LSchoenbauer/unseen-obstacles/writing/sections/communication_vr_hardware.tex

Die Kopplung des physischen Hardware-Simulators mit der virtuellen Simulationsumgebung konstituiert einen zentralen Bestandteil des Projekts. Insbesondere im Kontext von Virtual-Reality-Anwendungen ermöglicht die Integration realer Eingabegeräte mit virtuellen Systemmodellen eine realitätsnahe Interaktion sowie die Untersuchung von Systemverhalten unter kontrollierten Bedingungen \cite{Jason2015}, \cite{Bowman2004}, \cite{Perez2025}.

Eine zentrale Herausforderung bei der Implementierung solcher hybrider Systeme besteht in der zuverlässigen und latenzarmen Kommunikation zwischen der Hardwarekomponente und der VR-Anwendung. Um eine konsistente Abbildung des physischen System innerhalb der virtuellen Umgebung zu gewährleisten, ist ein kontinuierlicher Austausch von Zustands- und Steuerdaten erforderlich. Dabei spielen Aspekte wie die Datenformatierung, die Synchronisation der Systemzustände sowie die Minimierung von Übertragungs- und Verarbeitungszeiten eine entscheidende Rolle für die Gesamtperformance des Systems \cite{Coppik}, \cite{Cleland2022}, \cite{Alam2025}.

In diesem Abschnitt wird die Implementierung Kommunikationsarchitektur zwischen dem Hardware-Simulator und der VR-Simulation beschrieben. Zunächst erfolgt eine Erläuterung der grundlegenden Systemstruktur sowie der Rolle der einzelnen Komponenten. Im Anschluss erfolgt die Darstellung des verwendeten Kommunikationsmechanismus sowie des zugrunde liegenden Datenprotokolls. Abschließend werden die Implementierungsdetails der Schnittstelle sowie Maßnahmen zur Gewährleistung einer stabilen und konsistenten Datenübertragung erörtert. 

\section{Systemarchitektur des Gesamtsystems}
\setauthor{Linnea Schönbauer}
Die Architektur des entwickelten Systems besteht aus mehreren Teilsystemen, die in Wechselwirkung miteinander stehen und somit die Synchronisation zwischen virtueller Simulation und physischer Plattform ermöglichen.

Die Architektur lässt sich in drei Hauptkomponenten unterteilen:
\begin{itemize}
        \item die virtuelle Simulation innerhalb der Unity-Engine
        \item die Netzwerkkommunikation zwischen Simulation und Hardware
        \item die Steuerungseinheit des Hardware-Simulators
\end{itemize}
Im Rahmen der Simulation erfolgt eine kontinuierliche Berechnung der Bewegungsparameter des virtuellen Rollstuhls. Die vorliegenden Parameter umfassen sowohl die räumliche Position als auch die Orientierung des Objekts innerhalb der virtuellen Umgebung.

Im Anschluss werden die gewonnenen Bewegungsdaten über eine Netzwerkverbindung an den Hardware-Simulator übertragen, wo sie von einem Mikrocontroller verarbeitet werden. Der Mikrocontroller übernimmt dabei die Aufgabe, die empfangenen Simulationsdaten in konkrete Steuerbefehle für die mechanischen Aktuatoren zu übersetzen. 

Die vorliegende Architektur ermöglicht die Realisierung einer direkten Kopplung zwischen virtueller Bewegung und physischer Plattform.

\section{Systemarchitektur des VR-Projekts}
\setauthor{Linnea Schönbauer}
Die virtuelle Simulation wurde unter Verwendung der Game Engine Unity realisiert. Unity ist eine weit verbreitete Entwicklungsumgebung zur Erstellung interaktiver 3D-Anwendungen und Virtual-Reality-Systeme \cite{Jangra2023}, \cite{Unity}. Die Engine stellt eine integrierte Entwicklungsumgebung bereit, welche Werkzeuge zur Szenengestaltung, Physiksimulation, Skriptprogrammierung sowie zur Verwaltung komplexer Objektstrukturen umfasst \cite{Unity}.

Ein zentrales Merkmal der Architektur von Unity ist die objektorientierte Organisation der virtuellen Welt. In der vorliegenden Arbeit wird dargelegt, dass sämtliche Elemente einer Simulation als Objekte innerhalb einer Szene modelliert werden. Zudem wird erörtert, dass die Steuerung dieser Objekte über ein komponentenbasiertes System erfolgt \cite{Unity}, \cite{Unity2}.

Unity organisiert alle Inhalte einer Simulation in sogenannten Szenen, die jeweils eine hierarchische Baumstruktur aus GameObjects bilden. Eine Szene konstituiert eine abgeschlossene virtuelle Umgebung, welche sämtliche geometrischen Objekte, Lichtquellen, Kameras sowie Interaktionskomponenten enthält \cite{Unity}, \cite{Unity3}, \cite{Unity4}, \cite{Unity5}.

Die Struktur innerhalt einer Szene folgt einer hierarchischen Organisation, in der einzelne GameObjects in Parent-Child-Beziehungen zueinander stehen können, siehe Abbildung \ref{fig:parent-child-unity}. Diese Struktur ermöglicht eine effiziente Verwaltung komplexer Objektsysteme, da Transformationen eines übergeordneten Objekts automatisch auf seine untergeordneten Elemente übertragen werden \cite{Unity}, \cite{Unity4}, \cite{Unity6}.

\begin{figure}[htbp]
    \centering
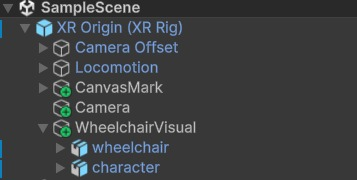
[picture p1: writing/pics/parent-child-object-unity.jpg]
    
    \caption{Parent-Child-Bezihung aus dem Unity Projekt}
    \label{fig:parent-child-unity}
\end{figure}

In dem Computerspiel-Entwicklungsprogramm Unity wird jedes Element der virtuellen Welt als sogenanntes GameObject bezeichnet. GameObjects dienen als Container für verschiedene Komponenten, welche das Verhalten und die Eigenschaften des jeweiligen Objekts definieren. Ein GameObject verfügt anfänglich über keine Funktionalität sondern diese wird erst durch die hinzugefügten Komponenten erworben \cite{Unity}, \cite{Unity7}.

Als illustrierende Beispiele für GameObjects innerhalt der Simulation seien etwa Gebäude der virtuellen Stadtumgebung, Straßenelemente, Kollisionsobjekte oder der virtuelle Rollstuhl genannt, der als zentrales Interaktionselement der Anwendung dient, siehe Kapitel \ref{chapter:vr-world}, \cite{Unity}.

\subsection{Physikalisches Bewegungsmodell}
\setauthor{Linnea Schönbauer}
Die Bewegung des virtuellen Rollstuhls innerhalb der Simulation basiert auf der Physik-Engine der Game Engine Unity. Anstatt die Positionsänderungen direkt zu manipulieren, wird ein physikalisches Bewegungsmodell verwendet, das auf der sogenannten Rigidbody-Komponente basiert \cite{Unity}, \cite{NVIDIA}, \cite{Bourg2013}, \cite{Unity8}

Diese Komponente gestattet die Simulation physikalischer Eigenschaften wie Masse, Gravitation sowie Kollisionen mit anderen Objekten der virtuellen Umgebung. Dies resultiert in einem realistischeren Bewegungsverhalten, insbesondere beim Befahren von Steigungen oder beim Kontakt mit Hindernissen innerhalb der simulierten Stadtumgebung \cite{Unity}, \cite{Unity9}, \cite{Unity8}.

Im Rahmen des vorliegenden Systems wird der virtuelle Rollstuhl daher als physikalisches Objekt modelliert, dessen Position und Orientierung über die Bewegungsfunktionen der Rigidbody-Komponente gesteuert werden, siehe Abbildung \ref{fig:rigidbody_unity}.
\begin{figure}[htbp]
    \centering
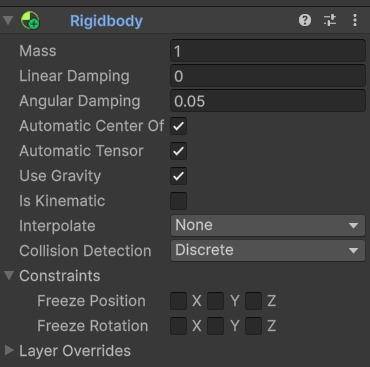
[picture p2: writing/pics/rigidbody.jpg]
    
    \caption{Rigidbody Komponente aus dem Unity Projekt}
    \label{fig:rigidbody_unity}
\end{figure}

\subsection{Positions- und Orientierungsparameter des virtuellen Rollstuhls}
\setauthor{Linnea Schönbauer}
Die Simulation des virtuellen Rollstuhls erfolgt unter Verwendung von Positions- und Orientierungsdaten zur adäquaten Beschreibung der Bewegung innerhalb der Simulation. Diese Werte beschreiben den aktuellen Zustand des Objekts im dreidimensionalen Raum und bilden gleichzeitig die Grundlage für die spätere Übertragung an den Hardware-Simulator.

\subsubsection{Positionskoordinaten}
\setauthor{Linnea Schönbauer}
Die Position eines Objekts in der Simulation wird durch ein kartesisches Koordinatensystem beschrieben. Die Position eines Objekts wird durch drei Koordinaten entlang der räumlichen Achse definiert \cite{Unity}, \cite{Foley1997}.

Die Koordinate PosX beschreibt die Position entlang der horizontalen X-Achse, während PosZ die Bewegung entlang der Tiefenachse der virtuellen Umgebung angibt. Die vertikale Position wird durch PosY beschrieben und repräsentiert die Höhe des Objekts innerhalb der Szene \cite{Unity}, \cite{Foley1997}, \cite{Vries}, \cite{Unity10}.

\subsubsection{Orientierung im Raum}\label{sec:orientation-in-3d}
\setauthor{Linnea Schönbauer}
Abgesehen von der Position ist auch die Orientierung des Rollstuhls im Raum von signifikanter Relevanz. Die vorliegende Beschreibung gibt Aufschluss über die Ausrichtung des Objekts relativ zu den drei Raumachsen \cite{Vries}, \cite{Craig2020}.

In einer Vielzahl von 3D-Systemen wird diese Orientierung durch sogenannte Euler-Angles repräsentiert, welche drei Rotationswinkel entlang der Raumachsen definieren \cite{Diebel2006}.

\begin{figure}[htbp]
    \centering
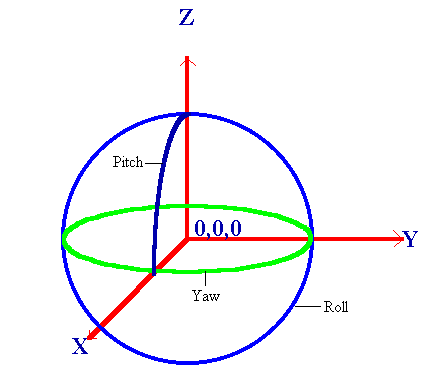
[picture p3: writing/pics/yz-and-pitch-roll-and-yaw-systems.png]
    
    \caption{Euler-Winkel-System, \\Quelle: https://www.researchgate.net/figure/yz-and-pitch-roll-and-yaw-systems\_fig4\_253569466 abgerufen 17.03.2026}
    \label{fig:yz-and-pitch-roll-and-yaw-systems}
\end{figure}

\subsubsection{Pitch, Yaw und Roll}
\setauthor{Linnea Schönbauer}
Die Orientierung wird durch drei Rotationswinkel beschrieben, die jeweils eine Drehung um eine der Raumachsen repräsentieren \cite{Diebel2006}.

Pitch beschreibt die Rotation um die seitliche Achse des Objekts und entspricht einer Vorwärts- oder Rückwärtsneigung. Das Befahren einer steilen Rampe führt beispielsweise zu einer signifikanten Änderung des Pitches \cite{Diebel2006}, \cite{Huck}.

Yaw beschreibt die Rotation um die vertikale Achse und determiniert damit die Blickrichtung des Rollstuhls innerhalb der Umgebung \cite{Diebel2006}, \cite{Huck}.

Roll beschreibt die seitliche Neigung des Objekts um die Vorwärtsachse. Ein Beispiel für eine derartige Situation wäre das Befahren eines hohen Bordsteins, wobei sich das Fahrzeug mit einem Reifen auf dem Gehweg und mit dem anderen auf der Straße befindet \cite{Diebel2006}, \cite{Huck}.

\subsubsection{Freiheitsgrade des Systems}
\setauthor{Linnea Schönbauer}
Die Bewegung des Rollstuhls lässt sich somit durch sechs Freiheitsgrade beschreiben. Drei dieser Freiheitsgrade betreffen die Position des Objekts im Raum (Translation entlang der X-, Y- und Z-Achse), während die übrigen drei Freiheitsgrade die Orientierung des Objekts beschreiben (Rotation um die drei Raumachsen).

\subsection{Verarbeitung der Usereingaben}
\setauthor{Linnea Schönbauer}
Die Steuerung des virtuellen Rollstuhls erfolgt durch Eingaben des Benutzers bzw. der Benutzerin, welche durch das Input-System von Unity erfasst werden. Diese Eingaben werden als zweidimensionaler Eingabevektor interpretiert, der sowohl Vorwärtsbewegung als auch Rotationsbewegung repräsentiert \cite{Unity11}.

Der vertikale Anteil des Eingabevektors determiniert die Vorwärts, beziehungsweise Rückwärtsbewegung des Rollstuhls innerhalb der Szene, während der horizontale Anteil zur Steuerung der Drehbewegung um die vertikale Achse verwendet wird \cite{Bowman2004}, \cite{Diebel2006}.

Die vorliegende Aufteilung ermöglicht die unabhängige Kontrolle von Translation und Rotation, wodurch eine intuitive Navigation innerhalb der virtuellen Umgebung ermöglicht wird \cite{Bowman2004}.

\subsection{Berechnung der Translation und Rotation}
\setauthor{Linnea Schönbauer}
Die Bewegung des Rollstuhls lässt sich also in zwei grundlegende Bewegungsarten unterteilen: Die translatorische Bewegung entlang der Blickrichtung sowie die Rotationsbewegung um die vertikale Achse.

Die Berechnung der Vorwärtsbewegung erfolgt entlang der lokalen Vorwärtsrichtung des Rollstuhls. Diese Richtung entspricht der aktuellen Orientierung des Rollstuhls innerhalb der Szene und wird über die Transformationsdaten des Objekts bestimmt. Die tatsächliche Verschiebung pro Simulationsschritt ergibt sich demnach aus der definierten Bewegungsgeschwindigkeit sowie der Zeitdauer des jeweiligen Physik-Updates.

Darüber hinaus besteht die Möglichkeit, den Rollstuhl um die vertikale Achse zu rotieren, wodurch Richtungsänderungen innerhalb der virtuellen Umgebung ermöglicht werden. Die Rotationsgeschwindigkeit wird über einen separaten Parameter gesteuert und ebenfalls innerhalb des Physik-Update-Zyklus der Simulation berechnet.

\section{Systemarchitektur des Hardware-Simulators}
\setauthor{Linnea Schönbauer}
Neben der mechanischen Konstruktion der Plattform, die in Kapitel \ref{chapter:hardware-prototyp} beschrieben wurde, ist für den Betrieb des Systems eine elektronische Steuerung erforderlich, welche die Bewegungen der Plattform koordiniert und ansteuert. Diese Steuerung bildet die zentrale Schnittstelle zwischen der virtuellen Simulation und den mechanischen Aktuatoren des Hardware-Simulators \cite{Bishop2006}.

Die Steuerungsarchitektur basiert auf einem Mikrocontroller des Typ ESP32, der als zentrale Recheneinheit innerhalb des Systems fungiert. Der Mikrocontroller übernimmt mehrere Aufgaben: Einerseits empfängt er Bewegungsdaten aus der Simulation über eine Netzwerkverbindung, andererseits berechnet er daraus die notwendigen Steuerbefehle für die einzelnen Schrittmotoren der Plattform \cite{ESPIDF}, \cite{Embedded}

Die eigentliche mechanische Bewegung wird durch mehrere Schrittmotoren erzeugt, welche die Wagenheber sowie die Rotationsbewegung der Plattform antreiben. Schrittmotoren eignen sich für diese Anwendung besonders gut, da sie eine präzise, schrittweise Bewegung ermöglichen und somit eine exakte Positionierung der Plattform erlauben. Die Steuerung dieser Motoren erfolgt über spezielle Motortreiber, welche die Signale des Mikrocontrollers in die erforderlichen elektrischen Impulse für die Motoren umsetzt \cite{Baral2026}.

\subsection{Verarbeitung der Simulationsdaten}
\setauthor{Linnea Schönbauer}
Die Steuerung der Plattform basiert auf Bewegungsdaten, die aus der virtuellen Simulation generiert werden. Diese Daten beschreiben die aktuelle Position und Orientierung des virtuellen Rollstuhls in der simulierten Umgebung. Insbesondere werden Rotationsparameter verwendet, die die Neigung und Ausrichtung des Rollstuhls im Raum beschreiben. Die Orientierung wird dabei über drei Rotationswinkel, sogenannte Pitch-, Roll- und Yaw-Winkel, dargestellt. Diese Parameter beschreiben die Rotation des Objekts um die drei Raumachsen und bilden somit eine vollständige Beschreibung der räumlichen Orientierung, siehe Abschnitt \ref{sec:orientation-in-3d}.
Während der Simulation werden diese Werte kontinuierlich aktualisiert und and die Steuerung des Hardware-Simulators übertragen.

\subsection{Umrechnung von Simulationsdaten in Motorbewegungen}
\setauthor{Linnea Schönbauer}
Die in der virtuellen Simulation berechneten Bewegungsdaten müssen in konkrete Bewegungsbefehle für die physische Plattform übersetzt werden. Das Ziel dieses Prozesses besteht darin, die Bewegungen des virtuellen Rollstuhls möglichst realitätsnah auf die mechanische Struktur des Hardware-Simulators zu übertragen. Hierzu werden die in der Simulation ermittelten Lage- und Positionsänderungen in entsprechende Bewegungen der einzelnen Aktoren des Systems umgerechnet \cite{Astrom2021}.

Die Simulation stellt dabei in regelmäßigen Zeitabständen die aktuellen Zustandsgrößen des virtuellen Systems bereit. Zu diesen gehören insbesondere die Rotationswinkel um die drei Raumachsen (Yaw, Pitch und Roll) sowie die Position im dreidimensionalen Raum. Für die Steuerung der Plattform werden jedoch nicht die absoluten Werte dieser Größen verwendet, sondern deren zeitliche Änderungen zwischen zwei aufeinanderfolgenden Simulationsschritten \cite{Astrom2021}.

Die Berechnung der Bewegungsbefehle erfolgt daher auf Basis der Differenzen zwischen den aktuellen und den zuvor empfangenen Simulationsdaten \cite{Astrom2021}.

\subsubsection{Differenzberechnung - Delta Werte}
\setauthor{Linnea Schönbauer}
Zur Bestimmung der erforderlichen Plattformbewegung werden zunächst die Differenzen der Orientierungswinkel zwischen zwei aufeinanderfolgenden Simulationszuständen berechnet. Diese Differenzen repräsentieren die tatsächlich während eines Simulationsintervalls erfolgte Bewegung des virtuellen Rollstuhls \cite{Astrom2021}.
\begin{lstlisting}[language=C++, caption={Differenzberechnung der Orientierungswinkel}, label={lst:delta_values}]
        int32_t deltaYaw = simData.mYaw - mLastSimData.mYaw;
        int32_t deltaPitch = simData.mPitch - mLastSimData.mPitch;
        int32_t deltaRoll = simData.mRoll - mLastSimData.mRoll;

\end{lstlisting}
Diese Differenzwerte bilden die Grundlage für die nachfolgende Berechnung der erforderlichen Hub- und Senkgröße.

\subsubsection{Berechnung der Rotationsbewegung (Yaw)}
\setauthor{Linnea Schönbauer}
Die Rotationsbewegung des Rollstuhls wird durch einen separaten Schrittmotor realisiert, der die obere Plattform relativ zur festen Basis verdreht. Das Ziel dieser Übertragung besteht darin, die in der Simulation ermittelte Drehbewegung mit möglichst hoher Präzision auf die physische Plattform zu übertragen.

Die Simulation übermittelt die Orientierung des virtuellen Objekts in Form von Euler-Winkeln, siehe Abschnitt \ref{sec:orientation-in-3d}. Für die Rotationsbewegung ist dabei insbesondere der Yaw-Winkel von Relevanz, welcher die Drehung um die vertikale Achse beschreibt. Anstatt absolute Winkelwerte direkt zu verwenden, basiert die Steuerung auf der Berechnung von Differenzwerten zwischen zwei aufeinanderfolgenden Simulationszuständen.

Die Berechnung erfolgt anhand des folgenden Ausdrucks:
\begin{lstlisting}[language=C++, caption={Differenzberechnung der Rotation}, label={lst:yaw_calculation}]
        deltaYaw = simData.mYaw - mLastSimData.mYaw
\end{lstlisting}
Die vorliegende Differenzbildung dient der Ermittlung der Anzahl der Winkelgrade, um die sich die virtuelle Plattform seit der letzten Aktualisierung gedreht hat. Dieses Verfahren gestattet eine kontinuierliche Bewegungssteuerung, bei der lediglich tatsächliche Änderungen in der Simulation zu Motorbewegungen führen \cite{Astrom2021}.

Zusätzlich wird die Zeit Differenz zwischen zwei Simulationsupdates bestimmt:
\begin{lstlisting}[language=C++, caption={Differenzberechnung der Zeit zwischen Simulationsupdates}, label={lst:time_difference_calculation}]
        deltaTimestamp = simData.mTimestampMs - mLastSimData.mTimestampMs
\end{lstlisting}
Die Erfassung dieser Zeit Information ist essenziell, um die erforderliche Geschwindigkeit der Motorbewegung zu bestimmen um somit eine zeitliche konsistente Abbildung der Simulation auf die reale Hardware zu gewährleisten \cite{Astrom2021}, \cite{Harashima1996}.

\subsubsection{Umrechnung des Rotationswinkels in eine lineare Bewegung}
\setauthor{Linnea Schönbauer}
Da die Drehbewegung der Plattform nicht direkt durch den Motor erzeugt wird, sondern über ein Antriebsrad, muss der Winkelunterschied zunächst in eine lineare Wegstrecke umgerechnet werden. Die vorliegende Strecke beschreibt die Bewegung, welche das Antriebsrad entlang des Umfangs der Plattform durchläuft, um die angestrebte Rotation zu generieren. Siehe Skizze \ref{fig:rotation-sketch}

Die Berechnung basiert auf der geometrischen Beziehung zwischen Kreisumfang und Winkelanteil. Der zurückgelegte Weg entlang eines Kreisbogens kann gemäß der folgenden Gleichung beschrieben werden: \cite{Bohme1967}
\begin{align}
        s = r \cdot \theta
\end{align}

Dabei beschreibt
\begin{itemize}
        \item $s$ die Bogenlänge
        \item $r$ den Radius
        \item $\theta$ den Winkel im Bogenmaß
\end{itemize}

\begin{figure}[htbp]
    \centering
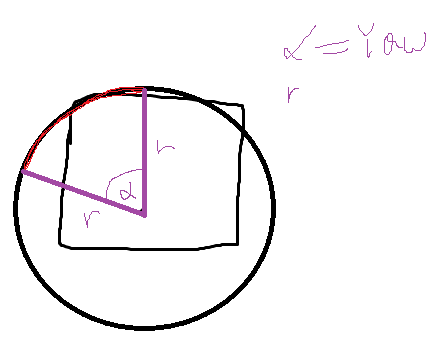
[picture p4: writing/pics/rotation-sketch.png]
    
    \caption{Rotation Berechnung - Sketch 09.01.2026}
    \label{fig:rotation-sketch}
\end{figure}

In dem vorliegenden System wird dies Beziehung genutzt, um aus dem Rotationswinkel die lineare Bewegung des Antriebsrads zu bestimmen. Die Implementierung erfolgt im Code über folgende Berechnung:
\begin{lstlisting}[language=C++, caption={Umrechnung des Rotationswinkels in eine lineare Bewegung}, label={lst:linear_rotation_calculation}]
        rotationLength = abs(pi * CIRCUMFERENCE_ROTATOR_WHEEL
                                 * deltaYaw / (180 * 100))
\end{lstlisting}
Der Faktor 100 ist das Resultat einer Skalierung der Winkelwerte im übertragenen Datenpaket, die zur Erhöhung der Genauigkeit durchgeführt wurde. Dadurch ist es möglich, selbst geringfügige Winkeländerungen als Ganzzahlen zu übertragen \cite{Goldberg1991}.

\subsubsection{Umrechnung der Wegstrecke in Motorumdrehungen}
\setauthor{Linnea Schönbauer}
Nach der Bestimmung der erforderlichen Wegstrecke erfolgt die Umrechnung in Motorumdrehungen. Der Motor treibt ein Rad mit bekanntem Umfang an, wodurch sich die Anzahl der notwendigen Umdrehungen berechnen lässt \cite{Siciliano1959}.

Die Beziehung zwischen Wegstrecke und Umdrehung lässt sich wie folgt formulieren: \cite{Bohme1967}
\begin{align}
        Umdrehungen = \frac{Weg}{Radumfang}
\end{align}

Im Code wird diese Berechnung wie folgt umgesetzt:
\begin{lstlisting}[language=C++, caption={Umrechnung der Wegstrecke in Motorumdrehungen (Rotationsbewegung)}, label={lst:motorsteps_rotation_calculation}]
        stepperTurns = rotationLength / CIRCUMFERENCE_ROTATOR_WHEEL
\end{lstlisting}
Das Ergebnis beschreibt die Anzahl der vollständigen Motorumdrehungen, die erforderlich sind, um die gewünschte Rotation des Gerüsts zu erzeugen.

\subsubsection{Berechnung der Motordrehzahl}\label{sec:calculate-mover-steps}
\setauthor{Linnea Schönbauer}
Die kontinuierliche Lieferung neuer Positionsdaten durch die Simulation bedingt die Durchführung der Bewegung innerhalb eines bestimmten Zeit Intervalls. Aus diesem Grund wird die erforderliche Drehzahl des Motors berechnet \cite{Siciliano1959}.

Die Drehzahl ist definiert als die Anzahl der Umdrehungen pro Zeiteinheit:
\begin{align}
        RPM = \frac{Umdrehungen}{Zeit}
\end{align}

Da der Zeitstempel in Millisekunden vorliegt, erfolgt die Umrechnung auf Minuten über den Faktor 60000:
\begin{lstlisting}[language=C++, caption={Umrechnung von Millisekunden auf Minuten}, label={lst:milliseconds_to_minutes_calculation}]
        rotationRpm = stepperTurns * 60000 / deltaTimestamp
\end{lstlisting}
Diese Berechnung ermöglicht eine dynamische Anpassung der Motorbewegung an die Geschwindigkeit der Simulation. Demzufolge resultieren schnelle Rotationen in höheren Drehzahlen des Motors, während langsame Bewegungen entsprechend langsamer ausgeführt werden \cite{Astrom2021}.

\subsubsection{Berechnung der Neigungsbewegung des vorderen Aktuators (Pitch)}
Neben der Rotationsbewegung ist die Neigung des Rollstuhls um die Querachse von zentraler Bedeutung für die Übertragung der Bewegung. In der Simulation wird diese Bewegung durch eine Änderung des Pitch-Winkel repräsentiert, was das Vor- bzw. Zurückkippen des virtuellen Rollstuhls beschreibt, siehe Abschnitt \ref{sec:orientation-in-3d}. Die Übertragung der Bewegung auf den physischen Hardware-Simulator erfolgt mittels eines Aktuators vorne, welcher eine Anpassung der Höhe der Plattform im Frontbereich ermöglicht.

Die Realisierung dieser Bewegung bedingt eine Konvertierung des übermittelten Rotationswinkels in eine lineare Hubbewegung des vorderen Wagenhebers. Aufgrund der Montage des Wagenhebers in einem festen Abstand zum Drehzentrum des Systems ergibt sich die notwendige Hubbewegung aus der geometrischen Beziehung zwischen Rotationswinkel und vertikaler Verschiebung eines Punktes auf einem Kreis. Siehe Skizze \ref{fig:front-mover-sketch} \cite{Bohme1967}
\begin{figure}[htbp]
    \centering
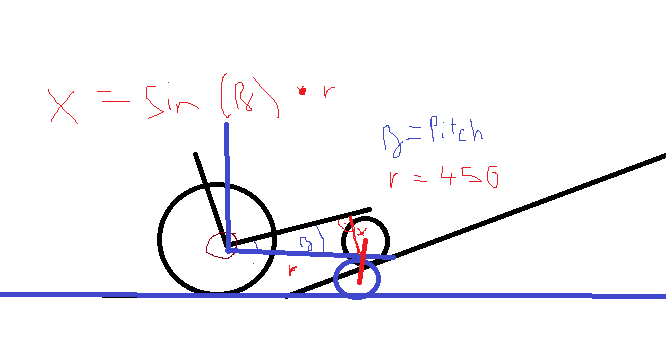
[picture p5: writing/pics/front-mover-sketch.png]
    
    \caption{Mover vorne Berechnung - Sketch 09.01.2026}
    \label{fig:front-mover-sketch}
\end{figure}

Die grundlegende Berechnung erfolgt im System über die Sinusfunktion \cite{Bohme1967}:
\begin{lstlisting}[language=C++, caption={Grundlegende Berechnung Neigung vorne}, label={lst:neigungswinkel_vorne_calculation}]
        stroke = sin(DegToRad(deltaPitch / 100.0)) * DISTANCE_FRONT
\end{lstlisting}

\emph{DISTANCE\_FRONT} beschreibt den horizontalen Abstand zwischen dem Drehzentrum der Plattform und der Position des vorderen Aktuators. Dieser Abstand entspricht dem Hebelarm, über den eine Rotationsbewegung in eine vertikale Verschiebung umgesetzt wird. Die Höhe des entsprechenden Punktes relativ zur Ausgangsposition wird durch Anwendung der Sinusfunktion bestimmt.

Die Sinusfunktion findet Anwendung in der geometrischen Betrachtung eines rechtwinkeligen Dreiecks, das durch die Plattformneigung entsteht. Es sei darauf hingewiesen, dass sich die vertikale Verschiebung eines Punktes im Abstand r zum Rotationszentrum bei einer Rotation um einen Winkel $\theta$ aus
\begin{align}
        h = r \cdot sin(\theta)
\end{align}
ergibt \cite{Bohme1967}.
Die vorliegende Beziehung gestattet die unmittelbare Transformation des übermittelten Rotationswinkels in eine physikalische Hubbewegung \cite{Bohme1967}.

Neben der reinen Rotationsbewegung wird in der Implementierung zusätzlich die translatorische Bewegung des Rollstuhls berücksichtigt. Diese ergibt sich aus der Bewegung des virtuellen Rollstuhls entlang der Fahrtrichtung und wird durch Positionsänderungen entlang der Z-Achse beschrieben.

Im vorliegenden Kontext wird zunächst die Geschwindigkeit der Bewegung ermittelt:
\begin{lstlisting}[language=C++, caption={Berechnung Geschwindigkeit}, label={lst:speed_calculation}]
        speedZ = simData.mPosZ - mLastSimData.mPosZ
\end{lstlisting}
Anschließend wird daraus die Beschleunigung bestimmt:
\begin{lstlisting}[language=C++, caption={Berechnung Beschleunigung}, label={lst:accelaration_calculation}]
        accZ = speedZ - mLastSpeedZ
\end{lstlisting}
Diese Beschleunigungskomponente wird als zusätzlicher Hubanteil interpretiert und zum berechneten Pitch-Hub addiert:
\begin{lstlisting}[language=C++, caption={Berechnung finale Neigung vorne}, label={lst:pitch_calculation_final}]
        stroke = (sin(DegToRad(deltaPitch / 100.0)) * DISTANCE_FRONT)
        + (deltaStroke / 100.0)
\end{lstlisting}
Die vorliegende Erweiterung der Plattform hat zur Folge, dass diese nicht nur auf Neigungsbewegungen, sondern auch auf dynamische Veränderungen der Bewegung reagiert. Als Beispiel für derartige Veränderungen können das Beschleunigen oder Abbremsen des virtuellen Rollstuhls angeführt werden. Dies resultiert in einer realistischeren Bewegungswahrnehmung für den/die Benutzer*in, da neben der geometrischen Ausrichtung auch dynamische Kräfte simuliert werden können \cite{Slater2016}, \cite{Steuer1992}.

\subsubsection{Umrechnung der Hubbewegung in Motorrotation}
\setauthor{Linnea Schönbauer}
Nach erfolgter Berechnung der erforderlichen Hubbewegung des Aktuators ist eine Transformation dieser in eine entsprechende Drehbewegung des Schrittmotors erforderlich. Die Funktionsweise der Wagenheber Mechanik beruht auf einer Gewindespindel, bei der eine Umdrehung des Motors eine definierte lineare Verschiebung erzeugt \cite{Siciliano1959}, \cite{Bauhaus}.

In dem vorliegenden System wird diese Verschiebung durch den Parameter \emph{STROKE\_PER\_TURN} beschrieben. Dieser gib an, wie viele Millimeter Hub pro Motorumdrehung erzeugt werden.

Die Anzahl der erforderlichen Motorumdrehungen ergibt sich demnach aus:
\begin{lstlisting}[language=C++, caption={Umrechnung der Hubbewegung in Motorumdrehungen}, label={lst:stepper_turns_calculation}]
        stepperTurns = stroke / STROKE_PER_TURN
\end{lstlisting}
Da ausschließlich die Bewegungsgröße von Relevanz ist, wird in diesem Kontext der Betrag der Verschiebung analysiert. Im Anschluss erfolgt die separate Bestimmung der Bewegungsrichtung. Außerdem wird noch die erforderliche Motordrehzahl bestimmt, siehe Abschnitt \ref{sec:calculate-mover-steps}.

\subsubsection{Berechnung der seitlichen Neigung über die hinteren Aktuatoren (Roll)}
\setauthor{Linnea Schönbauer}
Während der vordere Aktuator primär für die Simulation von Pitch-Bewegungen zuständig ist, wird die seitliche Neigung des Rollstuhls durch zwei hintere Aktuatoren realisiert. Die genannten Elemente sind neben den beiden großen Rädern des Rollstuhls unter der Querachse positioniert und können unabhängig voneinander bewegt werden. Siehe Skizze \ref{fig:back-mover-sketch}

Die seitliche Neigung der Plattform entspricht in der Simulation dem Roll-Winkel, der eine Rotation um die Längsachse des Rollstuhls beschreibt, siehe \ref{sec:orientation-in-3d}. Um diese Bewegung zu simulieren, ist eine entgegengesetzte Bewegung der beiden hinteren Aktuatoren erforderlich. In der Folge manifestiert sich die Kippbewegung der Plattform, die eine Elevation einer Seite und eine Absenkung der anderen zur Folge hat \cite{Siciliano1959}.

In Analogie zur Ermittlung der Pitch-Bewegung erfolgt zunächst die Berechnung der vertikalen Verschiebung, welche sich aus der geometrischen Relation zwischen Winkel und Hebelarm ergibt. Siehe Skizze \ref{fig:back-mover-sketch}
\begin{figure}[htbp]
    \centering
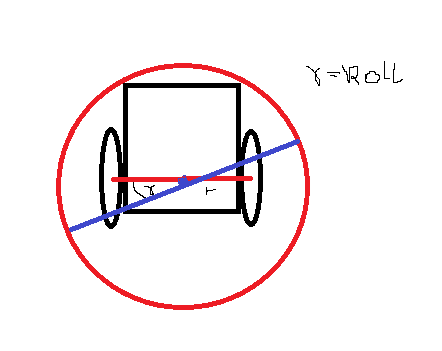
[picture p6: writing/pics/back-mover-sketch.png]
    
    \caption{Mover hinten Berechnung - Sketch 09.01.2026}
    \label{fig:back-mover-sketch}
\end{figure}

Die Berechnung erfolgt mittels der Sinusfunktion \cite{Bohme1967}:
\begin{lstlisting}[language=C++, caption={Berechnung der vertikalen Verschiebung}, label={lst:vertical_calculation}]
        stroke = sin(DegToRad(deltaRoll / 100.0)) * DISTANCE_SIDE_BACK
\end{lstlisting}
Der Parameter \emph{DISTANCE\_SIDE\_BACK} beschreibt den Abstand zwischen dem Drehzentrum der Plattform und der Position der hinteren Aktuatoren. Der vorliegende Abstand fungiert als Indikator für die Amplitude einer spezifischen Rotationsbewegung, die in eine vertikale Verschiebung der Plattform transformiert wird.

\subsubsection{Integration dynamischer Bewegungsanteile}
\setauthor{Linnea Schönbauer}
Des Weiteren findet bei der Rollbewegung auch der translatorische Bewegungsanteil Berücksichtigung. In Analogie zur Berechnung des Pitch-Wertes wird die beschleunigende Bewegung in Fahrtrichtung als zusätzlicher Hubanteil interpretiert \cite{Slater2016}, \cite{Steuer1992}

Die vollständige Berechnung der Hubbewegung ergibt sich demnach aus:
\begin{lstlisting}[language=C++, caption={Berechnung Hubbewegung hinten}, label={lst:full_calculation_side}]
        stroke = (sin(DegToRad(deltaRoll / 100.0)) * DISTANCE_SIDE_BACK)
                + (deltaStroke / 100.0)
\end{lstlisting}
Die vorliegende Erweiterung des Systems hat zur Folge, dass dieses nicht nur auf seitliche Neigung, sondern auch auf dynamische Veränderungen der Fahrzeugbewegung reagiert. Dadurch wird eine realitätsnahe Simulation des Überfahrens von Hindernissen des Rollstuhls ermöglicht \cite{Slater2016}.

\subsubsection{Gegensinnige Ansteuerung der hinteren Aktuatoren}
\setauthor{Linnea Schönbauer}
Ein wesentlicher Unterschied zur Pitch-Steuerung besteht darin, dass für die Rollbewegung zwei Aktuatoren gleichzeitig angesteuert werden. Im Zuge der Anhebung einer Seite ist eine Absenkung der gegenüberliegenden Seite erforderlich \cite{Siciliano1959}.

Die gegensinnige Bewegung wird im System durch unterschiedliche Richtungsbefehle für die beiden Motoren realisiert:
\begin{lstlisting}[language=C++, caption={Gegensinnige Ansteuerung hinten}, label={lst:gegenseitige_ansteuerung_hinten}]
        rearLeftMover->SetDirection(stroke < 0 ? BACKWARD : FORWARD);
        rearRightMover->SetDirection(stroke < 0 ? FORWARD : BACKWARD);
\end{lstlisting}
Die gegenläufige Ansteuerung resultiert in einer stabilen Kippbewegung der Plattform, ohne dass zusätzliche mechanische Komponenten erforderlich wären \cite{Siciliano1959}.

\subsubsection{Synchronisation der Motorbewegungen}
\setauthor{Linnea Schönbauer}
Da beide hinteren Aktuatoren an derselben Bewegung beteiligt sind, ist eine exakte Synchronisierung ihrer Geschwindigkeiten erforderlich. Aus diesem Grund wird für beide Motoren dieselbe Drehzahl (rotationRpm) berechnet und anschließend an beide Aktuatoren übertragen:
\begin{lstlisting}[language=C++, caption={Synchronisierte Motorbewegung hinten}, label={lst:synchronisation_motorbewegeung}]
        rearLeftMover->SetSpeedRpm(rotationRpm);
        rearRightMover->SetSpeedRpm(rotationRpm);
\end{lstlisting}

\subsection{Netzwerkarchitektur des Systems}
\setauthor{Linnea Schönbauer}
Für den Datenaustausch zwischen der virtuellen Simulation und dem Hardware-Simulator wird eine drahtlose Netzwerkverbindung verwendet. Die Netzwerkarchitektur basiert auf einem Mikrocontroller des Typs ESP32. Dieser fungiert sowohl als Steuerungseinheit der Plattform als auch als drahtloser Zugangspunkt \cite{EspressifArduino}, \cite{Wikipedia}.

Der Mikrocontroller stellt ein eigenes WLAN-Netzwerk bereit mit dem sich das System auf dem die VR-Simulation ausgeführt wird verbinden kann. Der Vorteil dieser Architektur ist, dass keine zusätzliche Netzwerkinfrastruktur erforderlich ist und die Kommunikation direkt zwischen Simulation und Hardware erfolgen kann \cite{EspressifArduino}, \cite{ESP32WifiAccessPoint}.

Der Mikrocontroller wird dabei im sogenannten Access-Point-Modus betrieben. In diesem Modus erzeugt das Gerät ein eigenständiges WLAN-Netzwerk mit einer definierten SSID und einem festgelegten Zugangspasswort. Die IP-Adresse des Zugangspunkts ist statisch konfiguriert, sodass der Kommunikationspartner innerhalb der Simulation stets eine bekannte Zieladresse verwenden kann \cite{EspressifArduino}, \cite{ESP32WifiAccessPoint}.

Im vorliegenden System wird die Adresse \emph{192.168.7.3} als feste IP-Adresse für den Mikrocontroller verwendet. Somit kann die VR-Simulation die Bewegungsdaten direkt an diese Adresse senden.

\subsection{Auswahl des Kommunikationsprotokolls} \label{sec:communication-protocol}
\setauthor{Linnea Schönbauer}
Für die Übertragung der Simulationsdaten zwischen der VR-Anwendung und dem Hardware-Simulator wurde das Netzwerkprotokoll User Datagram Protocol (UDP) ausgewählt. UDP ist ein verbindungsloses Transportprotokoll, das im Gegensatz zum Transmission Control Protocol (TCP) keine garantierte Zustellung der Datenpakete sicherstellt \cite{Postel1980}, \cite{Peterson2007}.

Die Wahl von UDP ist insbesondere bei Echtzeitanwendungen üblich, da das Protokoll eine sehr geringe Kommunikationslatenz aufweist. Während TCP zusätzliche Mechanismen zur Fehlerkorrektur, Paketbestätigung und Wiederholung verlorener Daten implementiert, verzichtet UDP auf diese Funktionen. Dadurch kann die Übertragung deutlich schneller erfolgen \cite{Postel1980}, \cite{Peterson2007}.

Für das vorliegende System ist diese Eigenschaft vorteilhaft, da die übertragenen Daten kontinuierlich aktualisiert werden. Sollte ein Datenpaket verloren gehen, kann es durch das unmittelbar folgende Paket ersetzt werden, ohne dass dies einen signifikanten Einfluss auf die Bewegungssteuerung hat.

Durch die Verwendung von UDP kann somit eine effiziente und latenzarme Kommunikation zwischen Simulation und Hardware realisiert werden \cite{Postel1980}, \cite{Peterson2007}.

\subsection{Implementierung des UDP-Senders in Unity}
\setauthor{Linnea Schönbauer}
Innerhalb der VR-Simulation realisiert eine speziell implementierte Unity-Komponente den Datentransfer. Diese ist als Skript implementiert und wird dem virtuellen Rollstuhlobjekt innerhalb der Simulation zugewiesen.

Die Implementierung basiert auf der .NET-Netzwerkbibliothek, die über die Klasse UdpClient eine einfache Möglichkeit zur Übertragung von UDP-Paketen bereitstellt \cite{Microsoft}.

Während der Initialisierung der Anwendung wird zunächst ein UDP-Client erstellt und mit der Zieladresse des Mikrocontrollers konfiguriert. IP-Adresse und Netzwerk Port können im Unity-Editor konfiguriert werden, wodurch eine flexible Anpassung an unterschiedliche Testumgebungen möglich ist.

Die eigentliche Datenübertragung erfolgt innerhalb der Update-Schleife der Unity-Engin. Dabei wird in regelmäßigen Zeitabständen die aktuelle Position und Orientierung des virtuellen Rollstuhls ausgelesen und anschließend als Netzwerkpaket an den Mikrocontroller übertragen.

Durch diese Implementierung wird sichergestellt, dass die Bewegungsdaten der Simulation kontinuierlich an den Hardware-Simulator weitergeleitet werden \cite{Microsoft}.

\subsection{Aufbau des Datenpakets}
\setauthor{Linnea Schönbauer}
Die Bewegungsdaten werden in Form eines binären Datenpakets übertragen. Dieses besteht aus mehreren Ganzzahlwerten mit einer Größe von jeweils 32 Bit \cite{Microsoft}.

\begin{center}
\begin{tabular}{ c c }
 \textbf{Feld} & \textbf{Beschreibung} \\ 
 timestamp & Zeitstempel \\  
 mode & Untergrundmodus (Gehsteig, Kopfsteinpflaster, Straße) \\
 pitch & Rotation um X-Achse \\
 yaw & Rotation um Y-Achse \\
 roll & Rotation um Z-Achse \\
 posX & Position entlang X \\
 posZ & Position entlang Z \\
 posY & Position entlang Y
\end{tabular}
\end{center}
Die Verwendung eines binären Datenformats ermöglicht eine Reduktion des Overheads gegenüber textbasierten Formaten wie JSON oder XML. Dadurch lassen sich kleinere Datenpakete und geringere Übertragungszeiten erreicht, was insbesondere für Echtzeitanwendungen vorteilhaft ist \cite{Microsoft}.

Die Rotationswerte werden zunächst aus der Quaternion-Rotation des Unity-Objekts berechnet und dann in Euler-Winkel umgewandelt. Diese werden dann mit einem Skalierungsfaktor multipliziert, um eine höhere numerische Auflösung zu erreichen. Mithilfe dieser Skalierung können Gleitkommazahlen effizient als Ganzzahlen übertragen werden, ohne dass zusätzliche Rechenoperationen auf dem Mikrocontroller erforderlich sind \cite{Unity12}, \cite{Goldberg1991}.

Die Position des Objekts wird auf ähnliche Weise codiert: Die Positionswerte werden mit dem gleichen Skalierungsfaktor multipliziert \cite{Unity12}, \cite{Goldberg1991}.

\subsection{Implementierung des UDP-Servers}
\setauthor{Linnea Schönbauer}
Die Simulationsdaten werden auf dem Mikrocontroller über einen speziell implementierten UDP-Server empfangen. Dieser wird als eigenständige Aufgabe innerhalb des Echtzeitbetriebssystems des Mikrocontroller ausgeführt.

Nach dem Start der Anwendung wird ein Server-Task erstellt. Dieser wartet dauerhaft auf eingehende Netzwerkpakete. Sobald ein neues Paket empfangen wird, wird dieses in einem internen Puffer gespeichert und anschließend an eine definierte Paketverarbeitungsfunktion übergeben:

\begin{lstlisting}[language=C++, caption={Empfang- und Übergabe-Methode des UDP-Servers}, label={lst:udp_serve_functionality}]
void UdpServer::Listen() {
    uint8_t buffer[mPacketBufferSize];

    if (StartListening(mPort)) {
        while (mServerTask != nullptr) {
            size_t dataSize = RetrieveNextPacket(buffer, mPacketBufferSize);
            if (dataSize > 0) {
                OnDataReceived(buffer, dataSize);
            } else {
                vTaskDelay(pdMS_TO_TICKS(5));
            }
        }
        vTaskDelay(pdMS_TO_TICKS(100));
        vTaskDelete(NULL);
    } else  {
        LogErrorT(LTAG_CFG, "UDP Server: Failed to start server on port %d", mPort);
    }
}

void UdpServer::OnDataReceived(const uint8_t* data, size_t dataLength) {
    if (mPacketHandler != nullptr) {
        mPacketHandler(data, dataLength);
    }
}
\end{lstlisting}

Die Implementierung basiert auf einer kontinuierlichen Empfangsschliefe, die wiederholt überprüft, ob neue Netzwerkpakete eingetroffen sind. Wenn das System ein gültiges Datenpaket erkennt, leitet es dessen Inhalt an einen registrierten Paket-Handler weiter.

Durch diese Architektur sind Netzwerkkommunikation und Bewegungssteuerung klar voneinander getrennt, da die empfangenen Daten zunächst isoliert verarbeitet werden können, bevor sie in Steuerbefehle für die Aktuatoren umgewandelt werden.

\subsection{Übertragungsfrequenz der Simulationsdaten} \label{sec:transfer-frequence}
\setauthor{Linnea Schönbauer}
Die Aktualisierung der Bewegungsdaten erfolgt mit einer festen Übertragungsfrequenz von etwa 60 Hz. Diese Frequenz entspricht der typischen Bildwiederholrate vieler VR-Anwendungen und gewährleistet eine ausreichende zeitliche Auflösung der Bewegungsinformationen \cite{LaValle2023}.

Die Datenübertragung wird durch einen Timer innerhalb der Unity-Anwendung gesteuert. In jedem Aktualisierungsintervall wird überprüft, ob die definierte Zeitspanne seit dem letzten Sendevorgang überschritten wurde. Ist dies der Fall, wird ein neues Datenpaket erzeugt und übertragen.

\section{Latenz und Echtzeitverhalten des Systems}
\setauthor{Linnea Schönbauer}
In interaktiven Simulationssystemen ist das zeitliche Verhalten der einzelnen Systemkomponenten von entscheidender Relevanz. Insbesondere im Kontext von Anwendungen im Bereich der virtuellen Realität ist eine möglichst synchrone visuelle Darstellung der Bewegung mit den physischen Bewegungen des Hardware-Simulators erforderlich \cite{Dorner2019}.

Im Falle einer zeitlichen Diskrepanz zwischen der Bewegung innerhalb der virtuellen Umgebung und der Bewegung des realen Hardware-Simulators kann es zu einer inkonsistenten Wahrnehmung kommen. In diesem Fall nimmt der Benutzer eine Bewegung visuell wahr, während die physische Bewegung des Systems zeitlich versetzt erfolgt \cite{Slater2016}, \cite{LaValle2023}.

Derlei Diskrepanzen können die Immersion der Simulation beeinträchtigen und zudem physiologische Effekte wie Desorientierung oder Motion Sickness verursachen, siehe Abschnitt \ref{sec:motionsickness}. Aus diesem Grund stellt die Minimierung der Systemlatenz ein zentrales Ziel bei der Entwicklung bewegungsbasierter VR-Simulationssysteme dar \cite{Slater2016}, \cite{LaValle2023}.

\subsection{Definition von Systemlatenz bezogen auf das Projekt}
\setauthor{Linnea Schönbauer}
Der Terminus \emph{Systemlatenz} bezeichnet die zeitliche Verzögerung zwischen dem Auftreten eines Ereignisses in der Simulation und der entsprechenden Reaktion der physischen Hardware \cite{LaValle2023}.

Im vorliegenden System beschreibt die Latenz demnach die Zeitspanne zwischen der Berechnung der Bewegung innerhalb der virtuellen Umgebung und der tatsächlichen mechanischen Bewegung der Plattform. 

Diese Zeitspanne manifestiert sich in Form mehrere Teilverzögerungen, die in diversen Systemkomponenten entstehen. Zu den relevanten Aspekten zählen insbesondere:
\begin{itemize}
        \item die Berechnungszeit innerhalb der Simulationssoftware (Unity)
        \item die Übertragungszeit der Netzwerkkommunikation
        \item die Verarbeitungszeit des Mikrocontrollers (ESP32)
        \item die mechanische Reaktionszeit der Aktuatoren
\end{itemize}

\subsection{Latenz in der Simulation}
Die initiale Verzögerung manifestiert sich bereits während des Berechnungsprozesses der Bewegungsparameter innerhalb der Simulationssoftware. Die vorliegende VR-Anwendung basiert auf der Game Engine Unity, welche eine framebasierte Aktualisierungsstruktur verwendet \cite{Unity13}.

Innerhalb dieses Systems werden sämtliche Bewegungen der virtuellen Objekte in diskreten Aktualisierungsschritten berechnet. Diese Schritte werden als Frames bezeichnet und bestimmen die Aktualisierungsfrequenz der Simulation \cite{Unity12}.

In der vorliegenden Implementierung erfolgt die Übertragung der Bewegungsdaten mit einer Frequenz von etwas 60 Hz. Dies entspricht einem Aktualisierungsintervall von etwa 16.7 Millisekunden.

Innerhalb der Simulationssoftware kann demnach eine Verzögerung von bis zu einem Frame auftreten, bevor neue Bewegungsdaten an den Hardware-Simulator übertragen werden.

\subsection{Netzwerkbedingte Latenz}
\setauthor{Linnea Schönbauer}
Nach der Berechnung der Bewegungsdaten innerhalb der Simulation erfolgt die Übertragung dieser Daten an den Hardware-Simulator über eine Netzwerkverbindung. Die für die Datenübertragung erforderliche Zeit wird als Netzwerk- oder Kommunikationslatenz bezeichnet \cite{Hou2024}.

Im vorliegenden System erfolgt die Datenübertragung über ein drahtloses Netzwerk, das vom Mikrocontroller selbst bereitgestellt wird. Die Kommunikation findet unter Einsatz des Netzwerkprotokoll User Datagram Protocol statt, siehe Abschnitt \ref{sec:communication-protocol}

Die geringe Komplexität des UDP-Protokolls bedingt eine deutlich geringere Verzögerung im Vergleich zu verbindungsorientierten Protokollen wie dem Transmission Control Protocol, siehe Abschnitt \ref{sec:communication-protocol}

Da UDP keine Paketbestätigung oder Wiederholungsmechanismen implementiert, können Datenpakete ohne zusätzliche Wartezeiten übertragen werden. Die vorliegende Untersuchung kommt zu dem Schluss, dass sich durch diese Maßnahme die Kommunikationslatenz erheblich reduziert und sie sich daher insbesondere für Echtzeitanwendungen eignet, siehe Abschnitt \ref{sec:communication-protocol}

\subsection{Verarbeitungslatenz im Mikrocontroller}
\setauthor{Linnea Schönbauer}
Nach dem Empfang eines Datenpakets erfolgt die Verarbeitung der Simulationsdaten innerhalb des Mikrocontrollers. In diesem Schritt werden die empfangenen Positions- und Rotationswerte aus dem Datenpaket extrahiert und in interne Steuerparameter umgewandelt.

Im Anschluss werden die erforderlichen Bewegungsparameter für die einzelnen Aktuatoren berechnet. Zu den relevanten Variablen zählen dabei unter anderem die erforderlichen Motorumdrehungen, die Bewegungsrichtung sowie die Drehgeschwindigkeit der Schrittmotoren.

Da die Berechnung auf einem eingebetteten System mit begrenzter Rechenleistung durchgeführt werden, ist auch hier eine gewisse Verzögerung festzustellen. Durch die effiziente Implementierung der Berechnungsalgorithmen kann dieses Verarbeitungszeit jedoch auf wenige Millisekunden reduziert werden, siehe Abschnitt \ref{sec:reduction-latency}

\subsection{Mechanische Reaktionszeit}
\setauthor{Linnea Schönbauer}
Abgesehen von den softwarebedingten Verzögerungen ist auch die mechanische Reaktionszeit der Plattform zu berücksichtigen. Mechanische Systeme sind in ihrer Positionierung eingeschränkt, da eine unmittelbare Veränderung der Position unmöglich ist. Stattdessen ist ein zeitlicher Verzug bei der Erreichung einer neuen Position zu verzeichnen \cite{Feynman2016}.

Die Bewegung der Plattform wird durch Schrittmotoren realisiert, welche wiederum die mechanischen Wagenheber antreiben. Die Geschwindigkeit dieser Bewegung ist dabei abhängig von verschiedenen Faktoren, darunter die maximale Drehzahl der Motoren, die Übersetzung des mechanischen Systems sowie die Trägheit der bewegten Masse.

Insbesondere bei größeren Bewegungen kann die mechanische Reaktionszeit einen signifikanten Anteil an der Gesamtlatenz des Systems ausmachen \cite{Feynman2016}.

\subsection{Maßnahmen zur Reduktion der Latenz} \label{sec:reduction-latency}
\setauthor{Linnea Schönbauer}
Zur Minimierung der Gesamtlatenz des Systems wurden mehrere technische Maßnahmen implementiert. 

Zunächst findet das verbindungslose UDP-Protokoll Anwendung, welches eine besonders hohe Übertragungsgeschwindigkeit der Daten ermöglicht, siehe Abschnitt \ref{sec:communication-protocol} Darüber hinaus erfolgt die Datenübertragung mit einer festen Aktualisierungsfrequenz von etwa 60 Hz, wodurch kontinuierlich neue Bewegungsdaten zur Verfügung stehen, siehe Abschnitt \ref{sec:transfer-frequence}

Zusätzlich wurde die Verarbeitung der empfangenen Daten innerhalb des Mikrocontrollers so implementiert, dass lediglich ein minimaler Rechenaufwand erforderlich ist. Die Bewegungsparameter werden unmittelbar nach Empfang des Datenpakets berechnet und direkt an die Motorsteuerung weitergeleitet. Zu diesem Zweck wird die Dual-Core-Fähigkeit des Mikrocontrollers genutzt. Die Netzwerkkommunikation (UDP-Empfang) wird auf Core 1 ausgeführt, während die zeitkritische Motorsteuerung auf Core 0 ausgeführt wird. Durch die Parallelisierung ist es möglich, Daten zu empfangen und Motorbefehle zu berechnen, ohne dass die Ausführung eines Tasks die Reaktionszeit des anderen blockiert. Ein Beispiel für eine solche Konfiguration ist die Pinning-Konfiguration des UDP-Servers:
\begin{lstlisting}[language=C++, caption={Pinning-Konfiguration des UDP-Servers}, label={lst:pinning_function_udp_server}]
void UdpServer::Start() {
    TaskMgmt::TaskConfig cfg = { 
        4242,
        "UdpServer",
        TaskMgmt::CoreId::CORE_1, 
        4096, 
        configMAX_PRIORITIES - 13 
    };    
    Start(cfg);
}
\end{lstlisting}

\section{Koordination mehrerer Aktuatoren zur Plattformbewegung}
\setauthor{Linnea Schönbauer}
Die Plattformbewegung wird nicht durch einen einzelnen Elektromotor erzeugt, sondern durch das koordinierte Zusammenspiel mehrerer mechanischer Komponenten. Die Rotationsbewegung des Systems wird durch einen einzelnen Schrittmotor realisiert, während die Neigungsbewegungen der Plattform durch drei unabhängig gesteuerte Wagenheber erzeugt werden.

In der Folge manifestiert sich ein mehrdimensionales Bewegungssystem, dessen Realisierung eine simultane Ansteuerung mehrerer Aktuatoren erfordert, um eine prädefinierte Plattformorientierung zu erreichen. \cite{Merlet2008}

Die Neigung der Plattform ergibt sich aus der Disparität der Höhen der einzelnen Wagenheber. Wird beispielsweise der links hintere Wagenheber stärker angehoben als der rechte, entsteht eine seitliche Neigung der Plattform, die einer Rollenbewegung entspricht.

In Analogie dazu besteht die Möglichkeit, eine Vorwärts- oder Rückwärtsneigung durch eine Modifikation der Höhe des vorderen Wagenhebers zu erzeugen.

\subsection{Gleichzeitige Motorsteuerung}
\setauthor{Linnea Schönbauer}
Um eine kontinuierliche Plattformbewegung zu gewährleisten, ist eine simultane Steuerung mehrere Aktuatoren erforderlich. Innerhalb des Steuerungsalgorithmus erfolgt daher eine synchrone Berechnung der Bewegungsparameter der einzelnen Motoren. \cite{Merlet2008}

\begin{lstlisting}[language=C++, caption={Gleichzeitige Motorsteuerung (hinten)}, label={lst:synchrone_application_back_mover}]
ApplyRotation(deltaTimestamp, deltaYaw);

if (simData.mMode == SimulationData::Mode::BUMPING) {
    ApplyShakeMode(deltaTimestamp, INTENSITY_SHAKING, wheelchairSpeed);
} else {
    ApplyFrontMover(deltaTimestamp, deltaPitch, accZ);
    ApplyBackMover(deltaTimestamp, deltaRoll, accZ);
}
\end{lstlisting}

Die Zielposition aller Schrittmotoren wird innerhalb eines vergleichbaren Zeit Intervalls erreicht, wodurch ungewollte Zwischenbewegungen vermieden werden.

\subsection{Bewegungsgrenzen}
\setauthor{Linnea Schönbauer}
Da die mechanischen Komponenten der Plattform nur innerhalb bestimmter Bewegungsbereiche betrieben werden können, müssen auch die berechneten Bewegungsparameter entsprechend begrenzt werden.

Die maximale Hubhöhe der Wagenheber definiert dabei den maximal erreichbaren Neigungswinkel links und rechts, beziehungsweise vor und zurück der Plattform. 
Die Realisierung erfolgte mittels mehrerer Mikroschalter, welche auf den Wagenhebern montiert sind. Siehe Abbildung  \ref{fig:microschalter}

Darüber hinaus wurden Sicherheitsmechanismen implementiert, um extreme oder unkontrollierte Bewegungen zu verhindern. Zu den relevanten Komponenten zählt ein Not-Aus-Schalter, welcher dazu dient, den Stromfluss in einem definierten Schritt abzubrechen und folglich einen sofortigen Stillstand der Stepper Motoren zu bewirken, sofern die Hubrichtung nicht den Anforderungen entspricht.
