LSchoenbauer/unseen-obstacles/writing/oath.tex

\thispagestyle{empty}
\vspace{3cm}
~ \\ \\
\IfStrEq{\thesislang}{de}
{
Ich erkläre an Eides statt, dass ich die vorliegende Diplomarbeit selbstständig und ohne fremde Hilfe verfasst, andere als die angegebenen Quellen und Hilfsmittel nicht benutzt bzw. die wörtlich oder sinngemäß entnommenen Stellen als solche kenntlich gemacht habe.

Die Arbeit wurde bisher in gleicher oder ähnlicher Weise keiner anderen Prüfungsbehörde vorgelegt und auch noch nicht veröffentlicht.

Die vorliegende Diplomarbeit ist mit dem elektronisch übermittelten Textdokument identisch.
}
{
I hereby declare that I have composed the presented paper independently and on my own, without any other resources than the ones indicated. 
All thoughts taken directly or indirectly from external sources are properly denoted as such.

This paper has neither been previously submitted to another authority nor has it been published yet.

The presented paper is identical to the electronically transmitted document.
}
\vspace{3cm}
% Hier kommt die Unterschrift drüber
\begin{tabbing}
Leonding, \IfStrEq{\thesislang}{de}{\duedatede}{\duedateen} \hspace{5cm}{\firstauthor} %, \thirdauthor \& \fourthauthor % replace & with , for all but the last author
\end{tabbing}
\vspace{3cm}
\begin{tabbing}
Leonding, \IfStrEq{\thesislang}{de}{\duedatede}{\duedateen} \hspace{5cm} {\secondauthor} %, \thirdauthor \& \fourthauthor % replace & with , for all but the last author
\end{tabbing}
\vspace{10cm}
\newpage
\setcounter{page}{1}
