LSchoenbauer/unseen-obstacles/writing/titlepage/coversheet.tex

%% erstellt von Andreas Neubauer, Juli 2009
%% aktualisiert von Markus Haslinger, Mai 2021
\documentclass[12pt,a4paper]{article}
\usepackage{graphicx,color}
\textwidth 16cm
\textheight 25cm
\topmargin 3.2cm
\oddsidemargin 0mm
\parindent 0pt
\usepackage[utf8]{inputenc}
\usepackage[a-1b]{pdfx}
\usepackage{xstring}
\pagestyle{empty}
\include{../global-const}
\begin{document}
% -------- only change entries beginning here ----------------------------
%
% enter the title of the thesis
\def\title{\thesistitle}
%
\IfStrEq{\thesislang}{de}{
    \def\type{DIPLOMARBEIT}
}
{
    \def\type{DIPLOMA THESIS}
}
\def\degree{Reife- und Diplomprüfung}
%
% enter the department
%
\IfStrEq{\thesislang}{de}{
    \def\dep{Höheren Abteilung für \department}
}
{
    \def\dep{Department of \department}
}
%
% enter the student names
%
\def\nameone{\firstauthor}
\def\nametwo{\secondauthor}
%\def\namethree{\thirdauthor}
%\def\namefour{\fourthauthor}
%
% enter the name of the supervisor 
%
\def\firstreferee{\supervisor}
%
% enter information about external partners or comment the line
%
\def\assist{\projectpartner}
%
% enter month and year
\IfStrEq{\thesislang}{de}{
    \def\date{\duedatede}
}
{
    \def\date{\duedateen}
}
%
% the vertical alignment heavily depends on the length of the title and number of students 
% below you might add additional space via (several) \medskip or \bigskip.
% do not change anything else
% -------------------------------------------------------------------------------
%
\def\ifundefined#1{\expandafter\ifx\csname#1\endcsname\relax}
%
\unitlength 1cm
\definecolor{mygray}{gray}{.85}
\sffamily
\begin{picture}(0,0)
\put(-2.6,5){\color{mygray}\rule{25cm}{2.6cm}}
\put(12.8,5.15){\small LEONDING}
\put(12.8,5.5){\small BUNDESLEHRANSTALT}
\put(12.8,5.85){\small HÖHERE}
\put(14.58,5.85){\small TECHNISCHE}
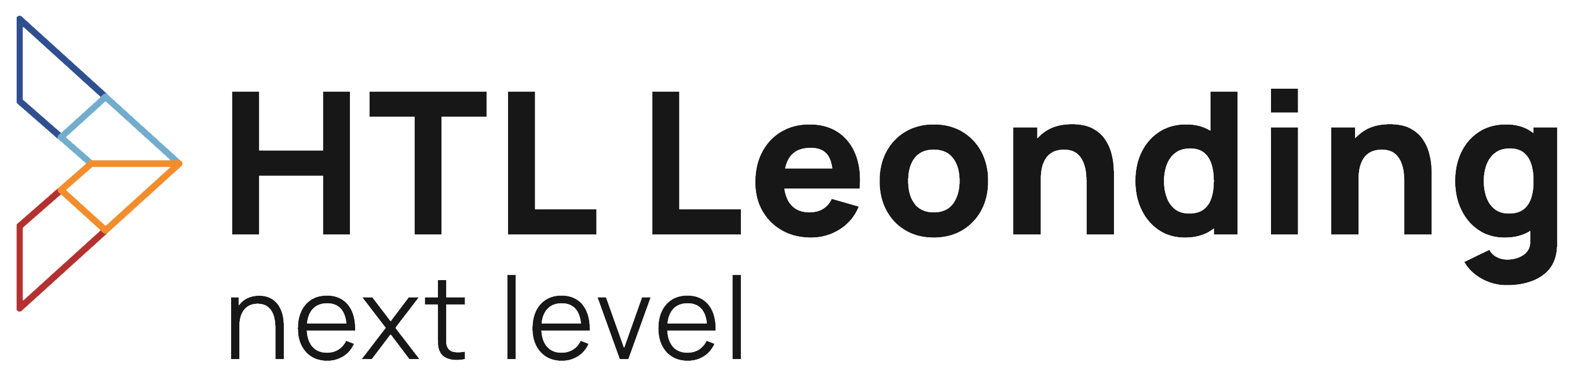
[picture p19: writing/titlepage/htlleondinglogo.png]
\put(0.35,5.25){}
\end{picture}
%
\begin{center}
    \vspace{-2cm}
{\LARGE\bfseries\title}
\bigskip\bigskip\bigskip\par
{\Large\type}
\bigskip\par
\IfStrEq{\thesislang}{de}
{
verfasst im Rahmen der
}
{
submitted for the
}
\bigskip\smallskip\par
{\Large\degree}
\bigskip\par
\IfStrEq{\thesislang}{de}
{
an der
}
{
at the
}
\bigskip\smallskip\par
{\Large\dep}
\end{center}

\vspace*{4cm}
\IfStrEq{\thesislang}{de}
{
Eingereicht von:
}
{
Submitted by:
}
\smallskip\par
{\large\nameone}\par
{\large\nametwo}
\ifundefined{namethree}\else
\par{\large\namethree}
\fi
\ifundefined{namefour}\else
\par{\large\namefour}
\fi
\medskip\bigskip\par
\IfStrEq{\thesislang}{de}
{
Betreuer:
}
{
Supervisor:
}
\smallskip\par
{\large\firstsupervisor},
{\large\secondsupervisor},
{\large\thirdsupervisor}
\ifundefined{assist}\else
\medskip\bigskip\par
\IfStrEq{\thesislang}{de}

\fi

\vspace*{4cm}
{\large Leonding, \date}
\end{document}
