LSchoenbauer/unseen-obstacles/simulator/docs/3pty/Stepper_NEMA17_60Ncm_17HE24-2104S_Torque_Curve.pdf

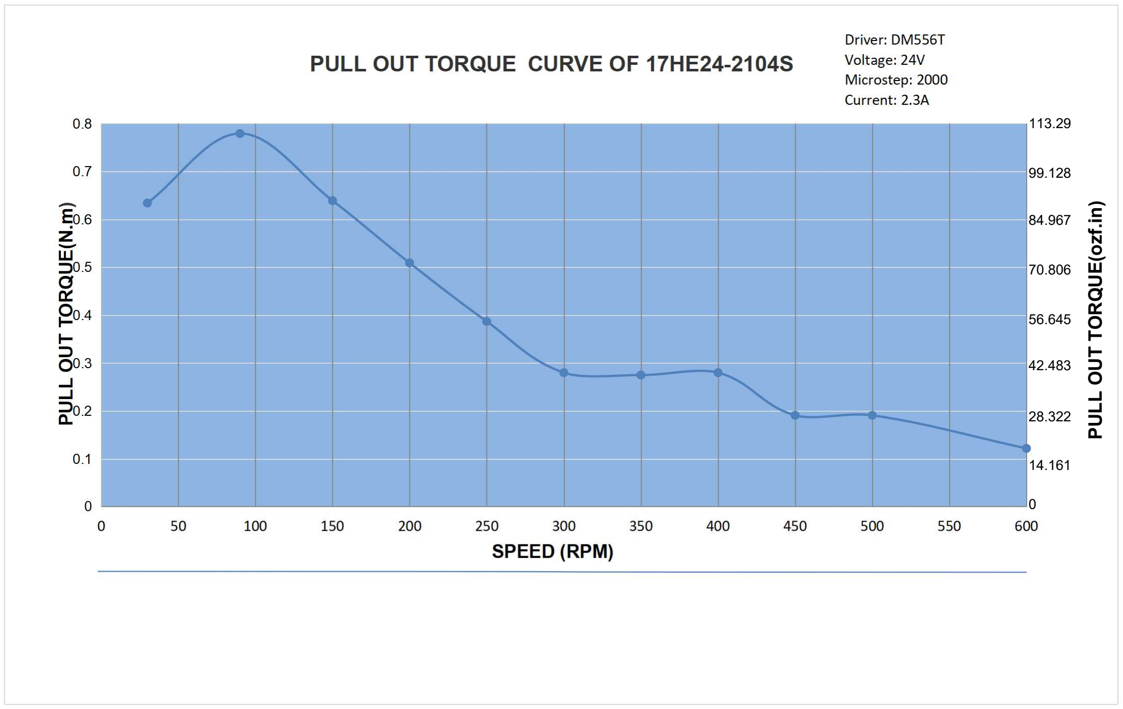
[picture p20: page 1]

113.29

99.128

84.967

70.806

56.645

42.483

28.322

14.161

# 0 PULL OUT TORQUE⁽ozf.in⁾
