LSchoenbauer/unseen-obstacles/simulator/docs/3pty/Stepper_NEMA17_55Ncm_17HE19-2004S_Torque_Curve.pdf

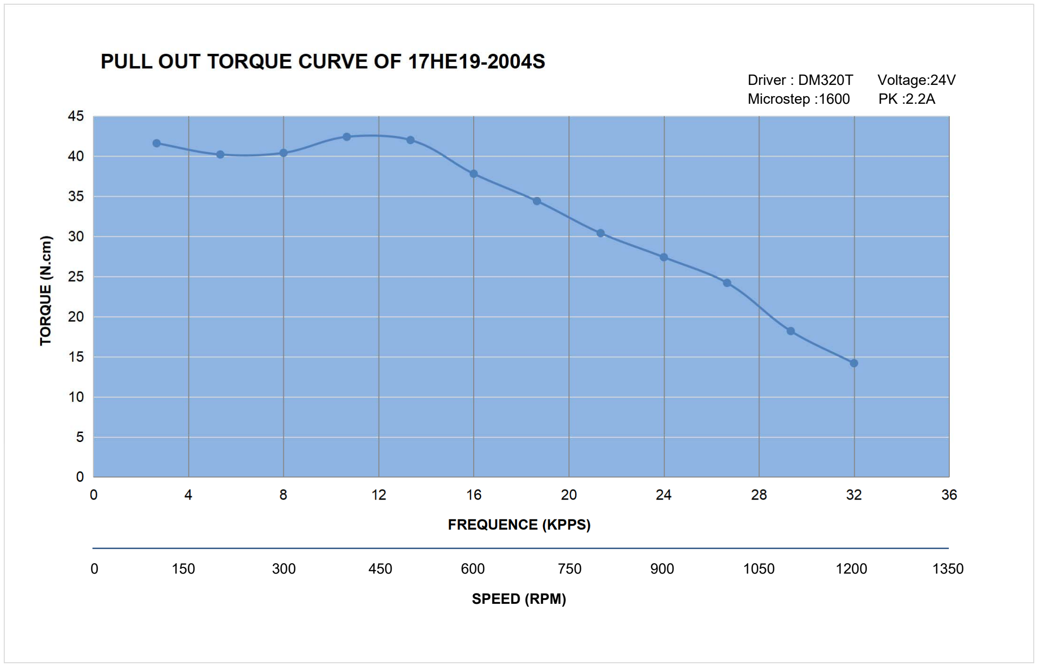
[picture p21: page 1]

Driver : DM320T | Voltage:24V
Microstep :1600 | PK :2.2A
0 | 150 | 300 | 450 | 600 | 750 | 900 | 1050 | 1200 | 1350

SPEED (RPM)
