LSchoenbauer/unseen-obstacles/simulator/docs/3pty/Stepper_NEMA23_240Ncm_23HS41-1804S_Torque_Curve.pdf

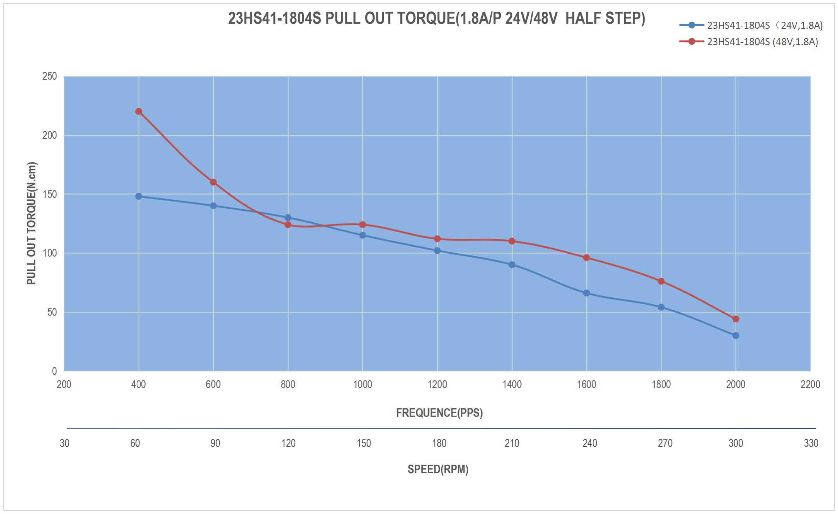
[picture p22: page 1]

23HS41-1804S PULL OUT TORQUE(1.8A/P 24V/48V HALF STEP)

30 | 60 | 90 | 120 | 150 | 180 | 210 | 240 | 270 | 300 | 330
SPEED(RPM)
