LSchoenbauer/unseen-obstacles/writing/sections/immersion.tex

Die vorliegende Simulation zielt darauf ab, die Herausforderungen, mit denen Rollstuhlnutzer*innen im urbanen Raum konfrontiert sind, so realitätsnah und nachvollziehbar wie möglich darzustellen. Neben der technischen Realisierung der Bewegungsplattform ist auch die Gestaltung der virtuellen Umgebung von entscheidender Bedeutung. Virtuelle Realitäten entfalten ihre Wirkung insbesondere dann, wenn Nutzende das Gefühl entwickeln, sich tatsächlich innerhalb der dargestellten Umgebung zu befinden. Dieses Empfinden wird in der Forschung häufig als Immersion bezeichnet \cite{Mutterlein2021}, 

Um eine solche immersive Erfahrung zu ermöglichen, müssen verschiedene gestalterische und konzeptionelle Aspekte berücksichtigt werden. Zu den relevanten Faktoren zählen demnach eine klare Nutzerführung, eine verständliche Informationsvermittlung, eine realitätsnahe audiovisuelle Gestaltung sowie eine strukturierte Präsentation der Inhalte innerhalb der Simulation. Im Rahmen des Projekts wurde daher mehrere Gestaltungselemente entwickelt, die darauf abzielen, die Orientierung der User*innen zu erleichtern und gleichzeitig ein möglichst realistisches Erlebnis der simulierten Umgebung zu ermöglichen \cite{Jason2015}, \cite{Wilbur1997}, \cite{Bowman2004}.

\section{Nutzerführung und Einführung in die Simulation}
\setauthor{Linnea Schönbauer}
Zu Beginn der Simulation erfolgt die Einführung der User*innen in die Anwendung über einen Startbildschirm. Der Startscreen ist ein elementarer Bestandteil der Simulation, dessen Funktionalität sich aus der Interaktion mit weiteren Elementen der Simulation ergibt. Einerseits dient er der kurzen inhaltlichen Einordnung des Projekts, indem er den Zweck der Simulation erläutert und den User*innen eine grundlegende Orientierung über den Ablauf vermittelt. Andererseits markiert der den Ausgangspunkt der eigentlichen Simulation \cite{Bowman2004}, \cite{Nielsen1993}.

Die Integration eines solchen Einstiegsbildschirms ist insbesondere in interaktiven Anwendungen von Relevanz, da User*innen ohne vorausgegangene Erklärung häufig Schwierigkeiten haben können, den Kontext der Simulation oder ihre eigene Roll innerhalb der virtuellen Umgebung zu verstehen. Die kurze textliche Einführung zu Beginn der Simulation dient dazu, den User*innen bereits vor dem Beginn der Anwendung einen Überblick über die zu erwartenden Erfahrungen zu verschaffen \cite{Bowman2004}.

\section{Visuelle Zusammenfassung der Hindernisse}
\setauthor{Linnea Schönbauer}
Nach Abschluss der eigentlichen Simulation erfolgt der Übergang in einen separaten virtuellen Raum, in dem die zuvor erlebten Hindernisse nochmals zusammengefasst dargestellt werden. In diesem Raum werden die einzelnen Hindernisse durch Bilder sowie kurze erläuternde Texte präsentiert.

Dieses Gestaltungselement erfüllt eine Vielzahl von Funktionen. Einerseits dient es der Reflexion der zuvor gemachten Erfahrung. Während der Simulation fokussieren sich die User*innen primär auf die Fortbewegung innerhalb der Umgebung, sodass einzelne Aspekte möglicherweise nicht bewusst wahrgenommen werden. Die anschließende visuelle Zusammenfassung erlaubt es den User*innen, die verschiedenen Hindernisse noch einmal gezielt zu betrachten \cite{Kolb2015}.

Die vorliegende Darstellung trägt zur Erleichterung des Verständnisses der divergierenden Herausforderungen bei, indem die einzelnen Hindernisse explizit benannt und erläutert werden. Die zuvor erlebte Simulation wird demnach in einen verständlichen Kontext eingebettet \cite{Kolb2015}, \cite{Dede2009}.

\section{Akustische Gestaltung der Simulation}
\setauthor{Linnea Schönbauer}
Neben der visuellen Darstellung spielt auch die akustische Gestaltung eine signifikante Rolle für die Immersion innerhalb virtueller Umgebungen. Geräusche sind ein wesentlicher Faktor für die Glaubwürdigkeit und Lebendigkeit, mit der User*innen eine virtuelle Umgebung wahrnehmen \cite{Begault2000},
\cite{Kleiner2007}.

Aus diesem Grund wurde innerhalb der Simulation verschiedene Umgebungsgeräusche integriert, die typische akustische Eindrücke einer urbanen Umgebung widerspiegeln. Zu den relevanten Faktoren zählen insbesondere Hintergrundgeräusche, wie etwa Vogelstimmen, Windgeräusche sowie allgemeine Straßengeräusche \cite{Frieder}.

Diese kontinuierlichen Umgebungsgeräusche erzeugen eine akustische Atmosphäre, die die Wahrnehmung der virtuellen Umgebung unterstütz und verhindert, dass die Simulation als statisch oder künstlich empfunden wird \cite{Begault2000},
\cite{Kleiner2007}.

\section{Situationsabhängige Soundeffekte}
\setauthor{Linnea Schönbauer}
Zusätzlich zu den allgemeinen Umgebungsgeräuschen wurden auch situationsabhängige Soundeffekte implementiert. Diese verändern sich in Abhängigkeit von der Oberfläche, über die sich der virtuelle Rollstuhl bewegt. Rollt der/die User*in beispielsweise von einem Gehsteig auf ein Kopfsteinpflaster, wird nicht nur das Rütteln des Hardware-Simulators als physisches Feedback wahrgenommen, sondern auch eine akustische Veränderung, da sich die Fahrgeräusche von Gehsteig auf Kopfsteinpflaster ändern.
