LSchoenbauer/unseen-obstacles/writing/sections/cyber_sickness.tex

Der Begriff \emph{Virtual Reality}, im Folgenden als VR bezeichnet, beschreibt die Darstellung und simultane Wahrnehmung einer echt erscheinenden Realität und ihren physikalischen Eigenschaften in einer in Echtzeit computergenerierten, interaktiven virtuellen Umgebung \cite{ParkS.-Y.;Koo2025}.

Die Beliebtheit von VR-Technologie hat in jüngerer Vergangenheit einen deutlichen Aufschwung erlebt, der insbesondere auf die Markteinführung einer Reihe kostengünstiger VR-Headsets zurückzuführen ist. Hierzu zählen Oculus, HTC Vive, PlayStation VR und Google Cardboard. Das bereits seit geraumer Zeit bestehende Problem der Cyberkrankheit konnte bislang nicht vollständig gelöst werden und wird aller Voraussicht nach ein signifikantes Hindernis für die flächendeckende Einführung von VR darstellen \cite{ParkS.-Y.;Koo2025}.

\section{Definition Motion Sickness, Cybersickness, VRISE}\label{sec:motionsickness}
\setauthor{Linnea Schönbauer}
Bei zahlreichen Menschen, sind bei der Nutzung eines Fahrzeugs der Stärke nach
variierende Krankheitssymptome zu beobachten. Zu den möglichen Nebenwirkungen zählen, beispielsweise, Übelkeit, Kopfschmerzen, Schwindel und weitere Beschwerden, die umgangssprachlich als Reise- oder Bewegungskrankheit bzw. vor allem im internationalen Raum als Motion Sickness bezeichnet werden \cite{Gavgani2018}.

Cybersickness, auch Virtual Reality Induced Sickness Effects (VRISE), genannt, weist laut Studien \cite{Gavgani2018} starke Ähnlichkeiten zu Motion Sickness auf. Obwohl die Situationen, die sie verursachen, leicht differieren, können die zugrunde liegenden Mechanismen auf die gleiche Weise erklärt werden. Cybersickness ist ein Phänomen, das mit physischen und psychischen Beeinträchtigungen einhergeht. Es manifestiert sich nach dem Experimentieren mit VR-Anwendungen und kann stundenlang anhalten. Die Diskrepanzen zwischen den wahrgenommenen Bewegungen in der realen und der virtuellen Welt sind dabei von zentraler Bedeutung \cite{Gavgani2018}.

\section{Biologische Ursachen von Cybersickness}
\setauthor{Linnea Schönbauer}
Im vorherigen Abschnitt wird bereits geklärt, dass die Symptome der Cybersickness das Befinden der Nutzer*innen einer VR-Software immens beeinflussen. Deshalb muss ein Weg gefunden werden, um diese Beschwerden möglichst zu reduzieren.

Um die Faktoren zu bestimmen, die das Auftreten von Symptomen der VR-Krankheit bedingen, ist zunächst eine klare Definition des Konzepts der Eigenbewegung und dessen zwei Hauptkomponenten erforderlich.

\subsection{Das Gleichgewichtssystem}\label{sec:vestibular_system}
\begin{figure}[htbp]
    \centering
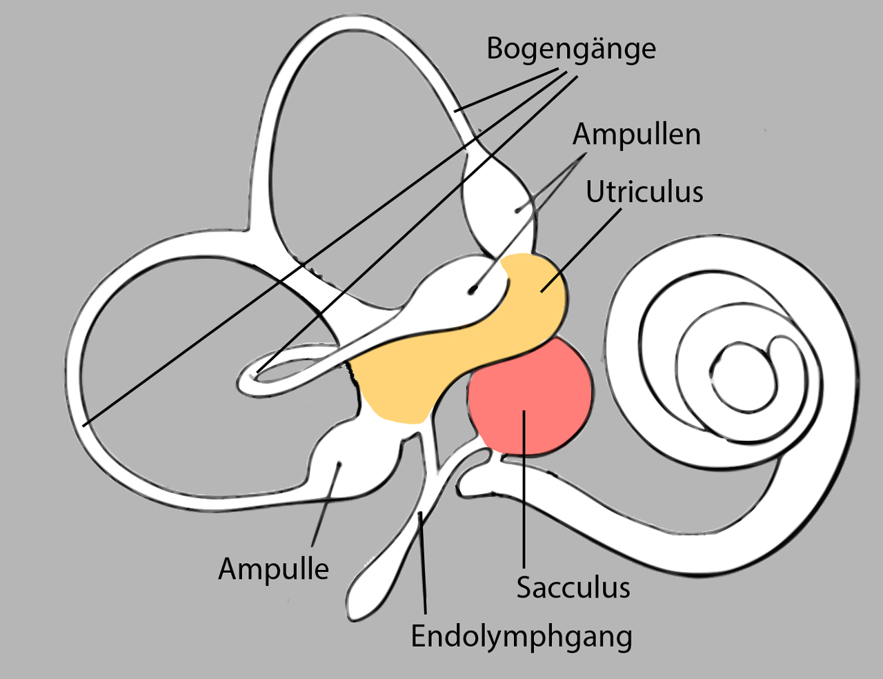
[picture p23: writing/pics/vestibular-system.jpg]
    
    \caption{Vestibuläres System, \\Quelle: \mbox{https://u-helmich.de/bio/neu/2/21/Gleichgewichtssinn.html}}
    \label{fig:cybersickness:vestibular-system}
\end{figure}

Das Gleichgewichtssystem, auch vestibuläres System genannte, befindet sich im Innenohr und ist für die Wahrnehmung von Bewegung  und Orientierung im Raum verantwortlich. Es besteht aus drei Bogengängen, die Drehbewegungen des Kopfes erfassen, sowie dem Utriculus und dem Sacculus, die lineare Beschleunigungen und die Lage zur Schwerkraft registrieren. Gemeinsam liefern sie dem Gehirn Informationen darüber, wie sich der Kopf, und damit der Körper, im Raum bewegt \cite{Casale2023}, siehe Abbildung \ref{fig:cybersickness:vestibular-system}.

\subsection{Das Visuelle System}
Dieses eben erwähnte Gleichgewichtssystem arbeitet eng mit dem visuellen System zusammen. Während die Augen visuelle Eindrücke von Bewegungen liefern, sorgt das vestibuläre System dafür dass die tatsächlichen Bewegungen des Kopfes erkannt und ausgeglichen werden. Dies geschieht unter anderem durch den sogenannten vestibulo-okulären Reflex, der die Augen stabilisiert, wenn sich der Kopf bewegt \cite{Josephj.LaViolaJr.2000}.

Stimmen die Signale von Auge und Gleichgewichtssystem jedoch nicht überein, kann eine Sinnestäuschung entstehen. So kann man sich beispielsweise auch ohne tatsächliche Bewegung bewegt fühlen, wenn sich das Sichtfeld verändert. Dieser Effekt wird als Vektion bezeichnet. Solche Wahrnehmungskonflikte zwischen Augen und Gleichgewichtssinn sind eine zentrale Ursache für Cybersickness, also die Übelkeit oder Desorientierung, die in virtuellen Umgebungen auftreten kann \cite{Keshavarz2015}.

\section{Ursachen für Cybersickness in der virtuellen Realität}
Nachdem geklärt wurde, auf welche zwei wichtigen biologischen Faktoren die Motionsickness in der echten Welt zurückzuführen ist, muss nun untersucht werden, warum die Symptome beim Verwenden einer VR-Software auftreten.
Die Ursachen für Cybersickness werden unter anderem durch die \emph{Sensory Conflict Theory} (Theorie des sensorischen Konflikts), die \emph{Poison Theory} (Vergiftungshypothese) und die \emph{Postural Instability Theory} (Theorie der posturalen Instabilität) beschrieben \cite{Josephj.LaViolaJr.2000}.

\subsection{Sensory Conflict Theory}\label{sec:sensory_conflict_theory}
Die Sensory-Conflict-Theorie gilt als die älteste und am weitesten akzeptierte Erklärung für Cybersickness \cite{Josephj.LaViolaJr.2000}, \cite{Gavgani2018}. Demnach wird Cybersickness durch Diskrepanzen zwischen den für die Wahrnehmung von Bewegung und Orientierung zuständigen Sinnen ausgelöst. Besonders relevant ist dabei der Konflikt zwischen dem visuellen und dem vestibulären System, siehe Abschnitt \ref{sec:vestibular_system}. Tritt eine Situation auf, in der das visuelle System signalisiert, das vestibuläre System jedoch keine entsprechende physische Bewegung registriert, entsteht ein wahrnehmungsbasierter Konflikt, den der Körper nicht korrekt verarbeiten kann.

Ein typisches Beispiel hierfür ist ein virtueller Fahrsimulator: Während ein/eine Nutzer*in visuell die Bewegung auf der Straße und das Vorbeiziehen von Gebäuden wahrnimmt, bleibt der Körper statisch. Da das vestibuläre System keine Informationen über Beschleunigung oder Drehungen liefert, entsteht ein Missverhältnis der Sinneseindrücke, das Cybersickness hervorrufen kann. Diese Theorie wird durch zahlreiche Studien unterstützt \cite{L.A.Warwick-Evans*N.Symons1999}, \cite{ParkS.-Y.;Koo2025}. Sie betont die zentrale Rolle des visuell-vestibulären Konflikts, weist jedoch auch Einschränkungen auf: So kann sie beispielsweise nicht zuverlässig vorhersagen, wer unter Cybersickness leidet oder wie stark die Symptome ausfallen. Auch erklärt sie nicht vollständig, warum manche Personen empfindlicher reagieren als andere. 

\subsection{Poison Theory} \label{sec:poison_theory}
Die Poison-Theorie versucht, die Entstehung von Cybersickness aus evolutionärer Sicht zu erklären \cite{Treisman}. Demnach dienen Übelkeit und Erbrechen ursprünglich als Schutzmechanismus, um den Körper vor aufgenommenen Giften zu warnen und diese aus dem Magen zu entfernen. Bei Cybersickness kann die inadäquate Stimulation der visuellen und vestibulären Systeme dazu führen, dass der Körper die Sinneseindrücke falsch interpretiert und glaubt, eine giftige Substanz aufgenommen zu haben. Dadurch treten Symptome wie Übelkeit auf \cite{Josephj.LaViolaJr.2000}, \cite{Gavgani2018}.

Einige Studien \cite{Crampton2000}, \cite{Oman2012} unterstützen diese Hypothese und zeigen, dass die Symptome in sehr spezifischen Situationen reduziert werden können. Dennoch ist die Theorie umstritten, da sie kaum Vorhersagekraft hat und nicht erklärt, warum manche Personen bei identischen Reizen in virtuellen Umgebungen Cybersickness entwickeln, andere jedoch nicht. Zudem erscheint der zeitliche Ablauf evolutionär problematisch, da Toxine zu lange brauchen würden, um die vestibulären Mechanismen auszulösen, sodass Erbrechen nicht effektiv wäre. Daher ist die Validität der Theorie bislang schwer nachzuweise. Sie wird eher als interessante Hypothese betrachtet, die bei der Gestaltung von VR-Erfahrungen vorsichtig berücksichtigt werden sollte.

\subsection{Postural Instability Theory}
Die von Ricco und Stoffregen \cite{Riccio1991} entwickelte Postural-Instability-Theorie besagt, dass Cybersickness durch anhaltende Haltungsinstabilität entstehen. Der Mensch strebt danach, seine posturale Stabilität aufrechtzuerhalten, das heißt, einen Zustand zu erreichen, in dem unkontrollierte Bewegungen des Wahrnehmungs- und Handlungssystems minimiert sind. Verändern sich die Umweltbedingungen abrupt oder fehlen geeignete Strategien zur Haltungsanpassung, kann die Kontrolle über die Körperhaltung vorübergehend verloren gehen \cite{Josephj.LaViolaJr.2000}, \cite{Riccio1991}, \cite{Gavgani2018}.

Laut dieser Theorie tritt Cybersickness auf, wenn über längere Zeiträume posturale Instabilität besteht. Die Schwere der Symptome hängt dabei direkt von der Dauer dieser Instabilität ab. In virtuellen Umgebungen entsteht diese Instabilität häufig, weil die visuell dargestellten Bewegungen oder Beschleunigungen nicht mit den tatsächlichen körperlichen Bewegungen übereinstimmen. Dadurch werden herkömmliche Strategien zur Stabilisierung der Körperhaltung unwirksam \cite{Riccio1991}.

Ricco und Stoffregen ordnen Cybersickness der Kategorie \emph{altered specificity} zu, also Situationen, in denen optische Reize nicht mehr eindeutig mit realen Umweltbedingungen verknüpft sind. Die Theorie wurde als Alternative zur Sensory-Conflict-Theorie entwickelt. Sie argumentiert, dass nicht sensorische Konflikte, sondern der Verlust posturaler Kontrolle die eigentliche Ursache von Cybersickness sei \cite{Josephj.LaViolaJr.2000}, \cite{Riccio1991}.

\subsection{Festlegung der Theorie zur Reduzierung der Cybersickness für die Hardware-Komponente}

Es wurden diverse Studien \cite{Riccio1991} zur Glaubhaftigkeit dieser Theorie durchgeführt. Die Ergebnisse dieser Studien deuten darauf hin, dass nur ein schwacher Zusammenhang zwischen Haltungsinstabilität und Cybersickness festgestellt werden konnte.

Da Cybersickness durch diese drei Theorien definiert wird, von denen zwei, die Poison-Theorie und die Postural-Instability-Theorie, teilweise widerlegt beziehungsweise durch Experimente angezweifelt wurden \cite{Riccio1991}, siehe Abschnitt \ref{sec:poison_theory}, wurde im Rahmen dieses Projekts der Fokus bei der Hardware-Komponente der Simulation, deren wichtige Aufgabe es unter anderem ist, die Cybersickness zu reduzieren, auf die Sensory-Conflict-Theorie gelegt.

\section{Einordnung und Zielsetzung der Steuerung im virtuellen Raum}
\setauthor{Linnea Schönbauer}
Die Art der Steuerung nimmt eine zentrale Stellung für das Nutzer*innen Erlebnis in Virtual-Reality-Anwendungen ein. Insbesondere im Kontext von barrierefreien Simulationen kann eine ungeeignete Steuerung nicht nur die Immersion beeinträchtigen, sondern auch zu einer erhöhten kognitiven Belastung und verstärkter Cybersickness führen. Das Ziel der im Projekt entwickelten Steuerung bestand daher darin, eine möglichst intuitive, leicht erlernbare und barrierearme Interkation während der Simulation zu ermöglichen \cite{Chen2024}.

\subsection{Intuitivität in VR}
\setauthor{Linnea Schönbauer}
In Virtual-Reality-Anwendungen kommt der Intuitivität der Interaktion eine besondere Bedeutung zu, da Nutzer*innen geleichzeitig einer Vielzahl visueller und sensorischer Reize ausgesetzt sind. Eine nicht intuitiv gestaltete Steuerung kann die kognitive Belastung erhöhen und die immersive Erfahrung beeinträchtigen \cite{Jason2015}.
Eine geringe Lernkurve gilt als zentrales Merkmal intuitiver Interaktionen. Systeme mit einer flachen Lernkurve ermöglichen es den Nutzer*innen, grundlegende Funktionen zeitnah zu erfassen, ohne sich intensiv mit der Bedienlogik auseinandersetzen zu müssen \cite{Jason2015}, \cite{Weibelzahl2025}.
Nutzer*innen interagieren mit digitalen Systemen auf Grundlage bestehender mentaler Modelle, die durch Erfahrungen aus der realen Welt geprägt sind. Intuitive Systeme berücksichtigen diese Modelle, indem sie bekannte Interaktionsmuster aufgreifen und in den digitalen Kontext übertragen \cite{Jason2015}, \cite{Norman2002}.

\subsection{Barrierefreiheit im Interaktionsdesign}
\setauthor{Linnea Schönbauer}
Gemäß \cite{Clarkson2003} bezeichnet Barrierefreiheit im Interaktionsdesign die Gestaltung von Systemen und Steuerung, die von allen Nutzer*innen unabhängig von körperlichen Einschränkungen problemlos bedient werden können. In VR-Anwendungen spielt Barrierefreiheit eine besondere Rolle, da die Steuerung in immersive Erlebnisse eingebunden ist und Nutzer*innen gleichzeitig mehreren sensorischen Reizen ausgesetzt sind \cite{Jason2015}.

Ein zentrales Prinzip barrierefreier Interaktionsgestaltung ist die Berücksichtigung motorischer Einschränkungen. Einige Nutzer*innen weisen eingeschränkte Beweglichkeit oder reduzierte Feinmotorik auf, was präzise oder schnelle Eingaben erschwert \cite{Clarkson2003}, \cite{ISO2025}. Steuerungselemente sollten daher robust gestaltet sein, sodass bereits grobe Bewegungen ausreichen, um die gewünschte Funktion auszulösen. Dies führt zu einer Reduktion der kognitiven und motorischen Belastung und ermöglicht eine gleichberechtigte Nutzung der Anwendung \cite{Clarkson2003}, \cite{ISO2025}.

Ein weiterer Aspekt barrierefreier Gestaltung ist die Möglichkeit, sämtliche Grundfunktionen einhändig bedienen zu können \cite{Clarkson2003}, \cite{Molly1998}. In Bezug auf VR-Anwendungen ist es essenziell, dass die Steuerung so konzipiert ist, dass auch Nutzer*innen mit eingeschränkter Hand- oder Armfunktion alle notwendigen Aktionen ausführen können. Diese Maßnahme trägt zur Steigerung der Inklusivität bei und gewährleistet, dass kein*e Nutzer*in aufgrund physischer Einschränkungen von der Interaktion ausgeschlossen wird.

Die Reduktion der erforderlichen Eingaben konstituiert ein weiteres Gestaltungsprinzip barrierefreier Interaktion \cite{Jason2015}, \cite{Clarkson2003}. Eine geringe Anzahl von Steuerungselementen erleichtert den Zugang für Personen mit eingeschränkter Motorik und sorgt gleichzeitig dafür, dass die Interaktion für alle Nutzer*innen leichter erlernbar ist. Konsistente und einfache Eingabemuster fördern demnach eine inklusivere Nutzung.

Dieses Prinzip, der vereinfachten und barrierearmen Bedienung, lässt sich in den breiteren Kontext des Universal Design einordnen: Das Ziel besteht darin, Produkte und Interfaces von vornherein so zu gestalten, dass sie für einen möglichst großen Nutzkreis nutzbar sind \cite{Molly1998}. Inclusive Design erweitert diesen Ansatz, indem gezielt auf unterschiedliche Nutzerbedürfnisse eingegangen wird, um Barrieren aktiv zu reduzieren \cite{Clarkson2003}.
Im Bereich von Virtual- und Augmented-Reality-Anwendungen wird der Begriff Accessibility in XR verwendet, der Richtlinien für Eingabegeräte, Bewegungsabläufe und die Erreichbarkeit von Interaktionsmöglichkeiten umfasst \cite{Jason2015}, \cite{ISO2025}. Diese Prinzipien bilden die Grundlage für die Gestaltung von Steuerungen, die auch von Personen mit eingeschränkter Mobilität oder beschränkt möglichem Kraftaufwand genutzt werden können, ohne dass die immersive Erfahrung beeinträchtigt wird.

\subsection{Zusammenhang zwischen Steuerung und Cybersickness}
\setauthor{Linnea Schönbauer}
Die Steuerung in Virtual-Reality-Anwendungen hat einen direkten Einfluss auf das Auftreten von Cybersickness. Gemäß der Sensory-Conflict-Theorie wird die Entstehung von Übelkeit durch das Zusammenwirken visueller und vestibulärer Wahrnehmungen begründet \cite{Reason1975}, \cite{LaViola2000}, siehe Abschnitt \ref{sec:sensory_conflict_theory}. Steuerungselemente nehmen hierbei eine zentrale Rolle ein, da sie die Bewegung der virtuellen Umgebung direkt beeinflussen.

Eine unvorhersehbare Steuerung kann den durch die Sensory-Conflict-Theorie beschriebenen Konflikt verstärken, da unerwartete Bewegungen der virtuellen Umgebung nicht mit der vestibulären und propriozeptiven Wahrnehmung der Nutzer*innen übereinstimmten \cite{Reason1975}, \cite{LaViola2000}. Die Reduzierung dieses Konflikts kann durch konsistente und vorhersagbare Steuerungsmechanismen erreicht werden.

Abrupte Bewegungen innerhalb der virtuellen Umgebung können das subjektive Gefühl von Übelkeit verstärken, da die Diskrepanz zwischen visueller Wahrnehmung und körperlichem Empfinden zunimmt. Eine sorgfältige Steuerung, die Bewegungen glättet und Beschleunigungswerte begrenzt, kann diesen Effekt deutlich reduzieren \cite{Dennison2016}, \cite{Wisti2016}, \cite{Keshavarz2011}.

Kontrollverlust während der Interaktion mit einer VR-Anwendung erhöht nicht nur die subjektive Belastung, sondern wirkt sich auch direkt auf das Auftreten von Cybersickness aus. Nutzer*innen, die das Gefühl haben, ihre Bewegungen nicht steuern zu können, zeigen häufiger Stressreaktionen und Übelkeit \cite{LaViola2000}.

Die Gestaltung der Steuerung in VR-Anwendungen ist somit ein entscheidender Faktor für die Reduktion von Cybersickness. Intuitive, konsistente und vorhersehbare Eingabemöglichkeiten, die abruptes Verhalten vermeiden und den Nutzer*innen Kontrolle ermöglichen, tragen signifikant zur Minimierung sensorischer Konflikte bei \cite{Keshavarz2011}, \cite{LaViola2000}, \cite{Reason1975}.

\section{Analyse möglicher Steuerungskonzepte}
\setauthor{Linnea Schönbauer}

\subsection{Controller-basierte Steuerung}
\setauthor{Linnea Schönbauer}
Die controllerbasierte Steuerung stellt eine der am weitesten verbreiteten Interaktionsformen in Virtual-Reality-Anwendungen dar. Die Mehrheit der gegenwärtig verfügbaren VR-Systeme wird standardmäßig mit Handcontrollern ausgeliefert die mit analogen Joysticks, Triggern und Tasten ausgestattet sind und eine genaue Eingabe ermöglichen \cite{Bowman2012}, \cite{Jason2015}. Aufgrund ihrer weiten Verbreitung gelten controllerbasierte Eingabemethoden als etablierter Standard in der VR-Interaktion.

Ein wesentlicher Vorteil controller-basierter Steuerung liegt in der hohen Präzision der Eingabe. Analoge Joysticks und Tasten ermöglichen eine exakte Steuerung von Bewegungen und Interaktionen innerhalb virtueller Umgebungen \cite{Bowman2012}. Insbesondere bei Navigationsaufgaben erlaubt diese Genauigkeit eine gezielte Steuerung von Geschwindigkeit und Richtung was in vielen VR-Anwendungen vorteilhaft ist \cite{Bowman2012}.

Ein weiterer Vorteil controller-basierter Steuerung ist ihre breite Etablierung. Da nahezu alle gängigen VR-Headsets mit Controllern ausgeliefert werden, sind Nutzer*innen häufig bereits mit deren grundlegender Bedienung vertraut. Dies führt zu einer Reduktion der Einstiegshürde in zahlreiche VR-Anwendungen, da keine zusätzlichen Eingabegeräte benötigt werden \cite{Jason2015}.

Obwohl aber controllerbasierte Steuerungskonzepte durch ihre Genauigkeiten gekennzeichnet sind, setzen sie in vielen Fällen eine adäquate Feinmotorik voraus. Das gleichzeitige Bedienen mehrerer Tasten, Trigger oder Joysticks kann für Personen mit motorischen Einschränkungen oder reduzierter Handkraft problematisch sein. Dies kann zu Barrieren führen, die eine inklusive Nutzung erschweren \cite{Clarkson2003}, \cite{ISO2025}.

Zudem kann der Umgang mit mehreren Eingabeelementen einen erhöhten Lernaufwand bedingen. Insbesondere komplexe Steuerungsschemata mit unterschiedlichen Tastenbelegungen können zu einer erhöhten kognitiven Belastung führen, was sich negativ auf die intuitive Nutzung und das immersive Erleben auswirkt \cite{Jason2015}, \cite{Norman2002}.

\subsection{Bewegungsbasierte Steuerung (Head-/Body-Tracking)}
\setauthor{Linnea Schönbauer}
Bewegungsbasierte Steuerungskonzepte nutzen die natürliche Bewegung des Körpers oder des Kopfes, um Interaktionen innerhalb virtueller Umgebungen zu steuern. Zu den relevanten Aspekten zählen in diesem Zusammenhang unter anderem Head-Tracking zur Fortbewegung, Leaning (Körperneigung) oder körperbasierte Gesten \cite{Jason2015}. Diese Interaktionsformen werden häufig als besonders immersiv wahrgenommen, da sie eine direkte Kopplung zwischen realer Bewegung und virtueller Reaktion herstellen \cite{Bowman2012}.

Ein zentraler Vorteil der bewegungsbasierten Steuerung liegt in der hohen wahrgenommenen Immersion. Die Nutzung von Kopf- oder Körperbewegungen zur Navigation entspricht den intuitiven Erwartungen an physische Fortbewegung und kann die Präsenz in der virtuellen Umgebung erhöhen \cite{Wilbur1997}, \cite{Bowman2012}.

Die Realisierung einer Bewegungssteuerung erfordert in vielen Fällen keine oder nur eine geringe Anzahl zusätzlicher Eingabegeräte, da die vorhandenen Tracking-Systeme des VR-Headsets genutzt werden können. Dies kann zu einer Reduktion der technischen Komplexität und einer Erleichterung des Einstiegs in die Anwendung führen \cite{Jason2015}.

Obwohl die bewegungsbasierte Steuerung aber eine intuitive Wirkung aufweist, besteht die Möglichkeit, dass sie das Auftreten von Cybersickness verstärkt. Insbesondere Head-Tracking-basierte Navigation führt häufig zu sensorischen Konflikten, da visuelle Bewegungen ausgelöst werden, ohne dass entsprechende vestibuläre Reize vorhanden sind \cite{Keshavarz2011}, \cite{LaViola2000}. Bewegungsbasierte Steuerung kann auch zu körperlicher Ermüdung führen, insbesondere bei längerer Nutzung oder bei Nutzer*innen mit eingeschränkter Mobilität. Dauerhafte Kopf- oder Körperbewegungen können die physische Belastung erhöhen und das Nutzungserlebnis negativ beeinflussen \cite{Jason2015}, \cite{Stanney2020}.

Ein wesentlicher Nachteil der bewegungsbasierten Steuerung liegt außerdem in ihrer eingeschränkten Barrierefreiheit. Personen mit motorischen Einschränkungen, eingeschränkter Körperkontrolle oder Nutzung von Hilfsmitteln wie Rollstühlen können diese Interaktionsform häufig nicht oder nur eingeschränkt nutzen \cite{Clarkson2003}. Dies resultiert in Exklusionseffekten, die den Grundsätzen von Universal und Inclusive Design zuwiderlaufen.

Im Rahmen einer VR-Simulation, die eine realitätsnahe Rollstuhlfahrt darstellt und gleichzeitig die Reduktion von Cybersickness anstrebt, manifestieren sich Schwierigkeiten bei der Verwendung einer bewegungsbasierten Steuerung. Die Notwendigkeit körperlicher Aktivitäten sowie das erhöhte Risiko sensorischer Konflikte stehe in einem Widerspruch zu den Zielen von Barrierefreiheit und Übelkeitsreduktion.

\subsection{Sitzbasierte-Steuerung}
\setauthor{Linnea Schönbauer}
Sitzbasierte und mechanische Steuerungskonzepte stellen eine alternative Form der Interaktion in Virtual-Reality-Anwendungen dar. Im Unterschied zu virtuellen Steuerungskonzepten werden bei diesen Konzepten Bewegungen nicht ausschließlich virtuell, sondern durch physische Rückmeldung unterstützt. Gemäß \cite{Jason2015} werden bei diesem Prozess reale Bewegungen des Sitzes oder mechanische Komponenten genutzt, um virtuelle Bewegungen zu begleiten oder zu simulieren. Der Einsatz solcher Konzepte erfolgt insbesondere in Simulatoren, wie etwa Fahr-, Flug- oder Trainingssimulationen \cite{Jason2015}.

Ein zentraler Vorteil der sitzbasierten Steuerung liegt in der Reduktion des sensorischen Konflikts, wie er in der Sensory-Conflict-Theory beschrieben wird \cite{Reason1975}. Die physische Bewegung des Sitzes erzeugt vestibuläre und propriozeptive Reize, die in besserer Korrelation mit den visuellen Bewegungen der VR-Simulation stehen \cite{LaViola2000}, \cite{Stanney2020}.

Mechanische Steuerungssysteme zeichnen sich in der Regel durch eine klare und vorhersehbare Bewegungslogik aus. Die physische Rückmeldung des Sitzes ermöglicht es den Nutzer*innen, unmittelbares Feedback über Beschleunigung, Richtungswechsel oder Stillstand zu erhalten \cite{Jason2015}. Diese Rückmeldung trägt zur Wahrnehmung von Kontrolle bei, was nachweislich zur Reduktion von Stress und Cybersickness beiträgt \cite{Jason2015}.

Sitzbasierte Steuerungskonzepte sind insbesondere für Nutzer*innen mit eingeschränkter Mobilität geeignet, da sie keine komplexen Ganzkörperbewegungen erfordern. Die Interaktion erfolgt in einer stabilen, sitzenden Position, wodurch physische Belastung reduziert und Barrierefreiheit gefördert wird \cite{Clarkson2003}.

Ein Nachteil mechanischer Steuerungssysteme liegt in der erhöhten technischen Komplexität. Der Einsatz von Aktuatoren, Sensoren und mechanischen Bauteilen bedingt einen erhöhten Entwicklungs- und Wartungsaufwand. Dies kann den prototypischen Entwicklungsprozess verlängern und höhere Kosten verursachen \cite{Jason2015}. Im Vergleich zu rein softwarebasierten Steuerungskonzepten weisen sitzbasierte Systeme auch eine geringere Skalierbarkeit auf, da sie an physische Hardware gebunden sind. Dies erschwert eine breite Verbreitung oder den Einsatz außerhalb speziell ausgestatteter Umgebung \cite{Stanney2020}.

Obwohl sitzbasierte und mechanische Steuerungskonzepte gewisse Nachteile aufweisen, bieten sie im Rahmen dieser Arbeit entscheidende Vorteile. Das Ziel der Simulation besteht in der Reduktion von Cybersickness bei gleichzeitiger realistischen Fortbewegung. Aus diesem Grund erscheint die Kombination aus visueller Bewegung und physischer Rückmeldung als besonders geeignet. Die mechanische Bewegung des Sitzes adressiert und reduziert den durch die Sensory-Conflict-Theorie beschriebenen Konflikt \cite{Reason1975}, \cite{LaViola2000}.

\section{Gewähltes Steuerungskonzept}
\setauthor{Linnea Schönbauer}
Auf Grundlage der zuvor präsentierten Analyse wurde ein sitzbasiertes Steuerungskonzept implementiert, das eine Kopplung mit einer Controllersteuerung aufweist. Dieses Konzept unterstützt die realistische Simulation der Rollstuhlfahrt, in der virtuellen Umgebung, durch physische Sitzbewegungen und wird über eine einhändige Eingabe gesteuert. Für die Entscheidung waren zwei Faktoren ausschlaggebend: die enge Orientierung an realen Nutzungssituationen eines Rollstuhls und die daraus resultierende Reduktion von Wahrnehmungsdiskrepanzen während der VR-Nutzung.

Die Steuerung folgt einem bekannten und klar verständlichen Nutzungsmuster: Die Fortbewegung erfolgt über eine einzelne, gerichtete Eingabe, während sich der*die Nutzer*in in einer stabilen, sitzenden Position befindet. Dies resultiert in einer hohen Vorhersehbarkeit der Bewegung, was wiederum die Kontrolle über die virtuelle Fortbewegung erhöht und unerwartete Bewegungen vermeidet. Dieses Maß an Kontrolle ist insbesondere im Hinblick auf das Nutzungserlebnis und die Vermeidung von Unwohlsein von zentraler Bedeutung \cite{Jason2015}.

Ein weiterer entscheidender Faktor für die Wahl dieses Konzepts ist die Barrierefreiheit. Die Steuerung wurde bewusst auf eine einhändige Nutzung mit einer geringen Anzahl an Eingaben ausgelegt. In der Folge wird die Interaktion auch für Personen mit eingeschränkter Mobilität oder reduzierter Feinmotorik ermöglicht. Die sitzbasierte Nutzung hat den Vorteil, dass sie die körperliche Belastung reduziert und zusätzliche Ganzkörperbewegungen überflüssig macht.

Darüber hinaus begünstigt das gewählte Steuerungskonzept eine intuitive Bedienbarkeit, da es an bestehende Alltagserfahrungen anknüpft. Die Nutzer*innen müssen kein neues oder abstraktes Steuerungsmodell erlernen, sondern können ihre bestehenden Erwartungen an die Fortbewegung im Rollstuhl auf die virtuelle Umgebung übertragen. Dies resultiert in einer geringen Lernkurve und erleichtert den Einstieg in die Simulation \cite{Jason2015}, \cite{Weibelzahl2025}.

Zusammenfassend wurde das sitzbasierte Steuerungskonzept gewählt, da es eine kontrollierbare, barrierefreie und intuitive Navigation innerhalb der VR-Simulation ermöglicht und gleichzeitig die Anforderungen an ein angenehmes und stabiles Nutzungserlebnis erfüllt.

\section{Umsetzung innerhalb der Simulation}
\setauthor{Linnea Schönbauer}
Nach der konzeptionellen Festlegung des Steuerungskonzepts erfolgte dessen praktische Umsetzung innerhalb der VR-Simulation. Das Ziel der Implementierung bestand darin, die zuvor definierten Anforderungen an Intuitivität, Barrierefreiheit und ein stabiles Nutzungserlebnis konsequent in der Interaktion abzubilden. Der Fokus der Untersuchung lag auf der kontrollierten Fortbewegung, der Vermeidung plötzlicher Bewegungen sowie einer eindeutigen Kopplung zwischen Eingabe, visueller Bewegung und Sitzbewegung.

\subsection{Mapping von Eingabe zu Bewegung}
\setauthor{Linnea Schönbauer}
Die Steuerung der Fortbewegung erfolgt über einen Joystick auf dem Handheld VR-Controller, siehe Abbildung \ref{fig:cybersickness:metaquest-controller}, der direkt die Vorwärtsbewegung, Rückwärtsbewegung sowie seitliche Rotation innerhalb der Simulation abbildet.
\begin{figure}[htbp] 
    \centering
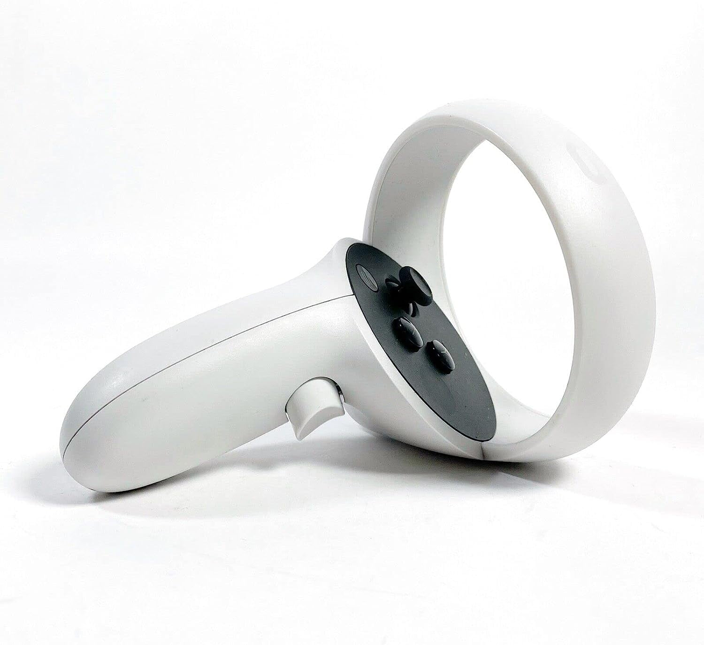
[picture p24: writing/pics/metaquest-controller-placeholder.jpeg]
    
    \caption{Meta Quest 2 Controller, \\Quelle: https://www.meta.com/de/quest/accessories/quest-2-controllers-refurbished/}
    \label{fig:cybersickness:metaquest-controller}
\end{figure}

\subsection{Verknüpfung von Steuerung, Sitzbewegung und visueller Bewegung}
\setauthor{Linnea Schönbauer}
Ein zentrales Element der Umsetzung ist die enge Kopplung zwischen der Steuerung, der visuellen Bewegung innerhalb der Simulation und der physischen Bewegung des Sitzes. Jede durch eine Eingabe ausgelöste Bewegung in der virtuellen Umgebung wird durch eine entsprechende Sitzbewegung begleitet.

Befährt die Person beispielsweise eine steile Rampe in der Simulation, neigt sich der tatsächliche Sitz in entsprechender Weise nach hinten. Gleiches passiert, wenn die Person einen hohen Bordstein befahren möchte. 

Diese Verknüpfung gewährleistet, dass visuelle Veränderungen nicht isoliert auftreten, sondern durch eine physische Rückmeldung unterstützt werden. Demnach werden Bewegungen nicht nur visuell erfasst, sondern auch physisch wahrgenommen. Diese Vorgehensweise trägt zur Konsistenz zwischen Handlung und Reaktion innerhalb der Simulation bei.

\subsection{Sicherheitsmechanismen und Bewegungsbegrenzungen}
\setauthor{Linnea Schönbauer}
Zusätzlich wurden Sicherheitsmechanismen implementiert, um extreme oder unkontrollierte Bewegungen zu verhindern. Dazu zählen unter anderem Begrenzungen der maximalen Neig-Höhe durch Mikrocontroller, siehe Abschnitt \ref{sec:microschalter}. Dies stellt sicher, dass die Simulation auch bei längerer Nutzung stabil und angenehm wahrgenommen wird. Darüber hinaus wurde ein Not-Aus-Taster installiert, welcher es ermöglicht, den Stromfluss zum Simulator unmittelbar zu unterbrechen, um unerwünschte Bewegungen zu verhindern, siehe Abbildung \ref{fig:not_aus_taster}.
\begin{figure}[htbp] 
    \centering
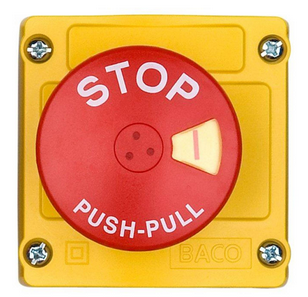
[picture p25: writing/pics/not-aus-taster.png]
    
    \caption{Not-Aus-Taster, \\Quelle: https://www.conrad.de/de/p/baco-lbx130113-not-aus-taster-im-gehaeuse-240-v-ac-2-5-a-3-oeffner-ip66-1-st-409538.html}
    \label{fig:not_aus_taster}
\end{figure}
