LSchoenbauer/unseen-obstacles/writing/sections/handbuch.tex

Dieses Handbuch beschreibt die Installation, den Aufbau sowie die Bedienung der im Rahmen der Diplomarbeit 
entwickelten VR-Simulation. Die Anwendung wurde mit Unity entwickelt und ermöglicht die 
Perspektive von Rollstuhlfahrenden in einer virtuellen Stadtumgebung einzunehmen.

\section{VR-Welt}
\setauthor{Elisa Kaltenberger}
Zuerst wird Unity installiert und das Projekt heruntergeladen. Anschließend wird die entsprechende Szene geöffnet. Falls gewünscht, kann eine VR-Brille angeschlossen und die Szene gestartet werden. Weitere Einstellungen müssen nicht vorgenommen werden.

\subsection{Voraussetzungen}
\setauthor{Elisa Kaltenberger}
Für die Nutzung der Simulation werden folgende Komponenten benötigt:
\begin{itemize}
    \item Laptop oder PC mit installierter Unity-Version (6000.0.53f1)
    \item VR-Headset (z. B. Meta Quest 2 oder vergleichbares Gerät)
    \item Installierte Meta Quest bei Verwendung einer Meta-Brille 
    (https://www.meta.com/de-de/help/quest/1517439565442928/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)
    \item USB-C-Kabel zur Verbindung zwischen Headset und Computer
\end{itemize}

\subsection{Installation}
\setauthor{Elisa Kaltenberger}
\begin{itemize}
    \item Unity installieren (falls noch nicht vorhanden)
    \item Projektdatei herunterladen
    \item Projekt über den Unity Hub öffnen
    \item Die Hauptszene im Projektordner auswählen und öffnen
    \item VR-Brille anschließen
    \item Auf „Play-Button“ klicken => die Simulation startet
\end{itemize}

\subsection{Mit VR-Brille}
\setauthor{Elisa Kaltenberger}
Für das vollständige immersive Erlebnis wird die Nutzung mit VR-Headset empfohlen.

\begin{itemize}
    \item Meta Quest Link starten
    \item VR-Brille per Kabel mit dem Laptop verbinden
    \item Warten, bis das Headset vom System erkannt wurde (dies kann einige Minuten dauern)
    \item Szene in Unity starten
\end{itemize}

Steuerung in VR:
\begin{itemize}
    \item Bewegung durch Neigen und Ausrichten der Controller in die gewünschte Richtung
    \item Kopfbewegungen steuern die Blickrichtung
\end{itemize}

\section{Hardware Simulator}
\setauthor{Linnea Schönbauer}
Zum Betrieb des Hardware-Simulators, muss er an das Stromnetz angeschlossen werden. Vor dem Einstecken müssen aber folgende Dinge beachtet werden:

\begin{itemize}
    \item Vor dem Einstecken ist der Not-Aus-Taster zu drücken, um unbeabsichtigte Bewegungen zu verhindern.
    \item Dann muss der Controller mit dem VR-Headset bzw. der VR-Simulation verbunden werden.
    \item Erst danach darf der Not-Aus-Taster gelöst werden.
\end{itemize}

Während des Betriebs kann der Hardware-Simulator jederzeit über den Not-Aus-Taster gestoppt werden.

\subsection{Weitere Schritte}
Um den Simulator vor dem Start der Simulation zu kalibrieren, muss die zugehörige Website aufgerufen werden, mit der der Hardware-Simulator manuell gesteuert werden kann. Hierfür muss sich mit dem privatem Netzwerk verbunden werden:
\begin{itemize}
    \item Mit Netzwerk verbinden \\(\emph{SSID: "`Unseen-Obstacles"', Passwort: "`unseenobstaclesEKLS"'})
    \item Webbrowser öffnen
    \item Die Website \emph{192.168.7.1} aufgerufen
    \item Auf der Website die Kalibrierungsfahrt durchführen
    \item Über Button-Klick die Kontrolle von der WebApp an die VR-Welt übergeben.
\end{itemize}

\subsection{Montage / Demontage}
Um den Hardware-Simulator einfach transportieren zu können, gibt es die Möglichkeit den Rollstuhl zu entfernen um die Plattform separat zu transportieren.

\emph{Vor der Montage:}
\begin{itemize}
    \item Die zwei losen Microschalter gedrückt halten
    \item System in Montageposition anheben
\end{itemize}

\emph{Montage:}
\begin{itemize}
    \item Rollstuhl aufsetzen
    \item Muttern an VOrder-und Hinterachse befestigen
    \item Sitz der Microschalter  kontrollieren
\end{itemize}

\emph{Demontage:}
\begin{itemize}
    \item Muttern an Vorder- und Hinterachse lösen
    \item Rollstuhl abnehmen
    \item Anschließend über die WebApp die Heber vollständig einfahren
\end{itemize}
