LSchoenbauer/unseen-obstacles/writing/sections/introduction.tex

\setauthor{Elisa Kaltenberger}

Ein großer Teil der Bevölkerung nimmt alltägliche körperliche Aktivitäten als selbstverständlich wahr. Diese Selbstverständlichkeit erweist sich für einen geringen Anteil der Einwohner als nicht oder nur bedingt realisierbar. Menschen mit körperlichen Einschränkungen sehen sich im Alltag mit signifikanten Herausforderungen konfrontiert. Barrieren, die für andere kaum auffallen, können sich als unüberwindbare Hindernisse erweisen. Eine eingeschränkte Zugänglichkeit zu Infrastruktur und Dienstleistungen, wie beispielsweise ein nicht erreichbarer Geldautomat aufgrund eines zu hohen Sichtschutzes oder das Fehlen eines Aufzugs oder einer Rampe, kann die Mobilität enrom einschränken und den Alltag erheblich erschweren. Der Fokus liegt dabei nicht ausschließlich auf Mobilität, sondern auch auf der gleichberechtigten Teilhabe am gesellschaftlichen Leben.

\section{Statistik}
\setauthor{Elisa Kaltenberger}
In Österreich leben rund 1.9 Millionen Menschen im Alter zwischen 15 und 89 Jahren mit gesundheitlichen oder altersbedingten Einschränkungen. Dies entspricht etwa einem Viertel der Bevölkerung in dieser Altersgruppe. Die vorliegende Untersuchung - zu sehen Abb. \ref{fig:statistik-1} -, befasst sich mit der Frage, inwiefern die genannte Personengruppe im Alltag von den Auswirkungen betroffen ist. Etwa 7,6 \% der Interviewten gaben an, dass sie sich bei typischen Aktivitäten wie Ankleiden, Einkaufen oder Haushaltsarbeiten durch starke gesundheitliche Beeinträchtigungen erheblich eingeschränkt fühlen. Rund 17,5 \% der Befragten berichteten zumindest eine leichte Einschränkung.
\cite{SchullerVictoriaMlinareviNikolinaKlimont2024}, \cite{IUFEAT-Wien2023}, \cite{KletzmayrKerstin2022}, \cite{IsabellaSkiba2020}, \cite{JuliaSofieWieder2025}

Dies veranschaulicht, dass Einschränkungen im Alltag ein breites Spektrum umfassen - von leichten Beeinträchtigungen bis hin zu Situationen, in denen selbst grundlegende Tätigkeiten ohne Hilfe kaum möglich sind. Eine Analyse der Gruppenzusammensetzung macht diese Tatsache besonders deutlich. Etwa 30,3 \% der österreichischen Bevölkerung mit Behinderungen können ihren Alltag nicht ohne Hürden bewältigen.
\cite{SchullerVictoriaMlinareviNikolinaKlimont2024}, \cite{IUFEAT-Wien2023}, \cite{KletzmayrKerstin2022}, \cite{IsabellaSkiba2020}, \cite{JuliaSofieWieder2025}

Die präsentierten Zahlen verdeutlichen, dass Barrierefreiheit und Unterstützungsangebote nicht als Randthema betrachtet werden können, sondern für einen signifikanten Anteil der Einwohnerschaft von großer Bedeutung sind. Dabei geht es nicht nur um Mobilität oder medizinische Versorgung, sondern um die Möglichkeit, das eigene Leben selbstbestimmt zu gestalten und gleichberechtigt an der Gesellschaft teilzuhaben. In Anbetracht des demografischen Wandels wird die Relevanz barrierefreier Strukturen und inklusiver Maßnahmen in den kommenden Jahren deutlich ansteigen. Die Lebensqualität von Menschen mit Behinderungen sind niedrieger - siehen an der Grafik Abb. \ref{fig:lebensqualiteat} - als die von Menschen ohne Behinderungen, was sich in verschiedenen Lebensbereichen manifestiert, darunter Gesundheit, soziale Teilhabe und psychisches Wohlbefinden.
\cite{SchullerVictoriaMlinareviNikolinaKlimont2024}

\begin{figure}
    \centering
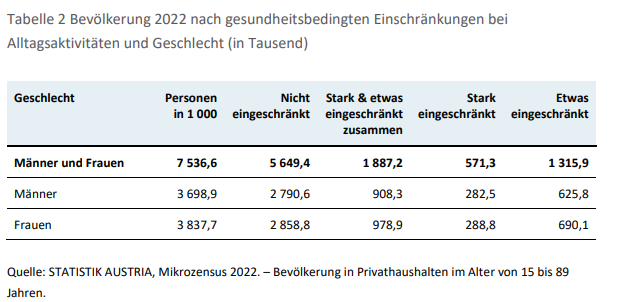
[picture p26: writing/pics/Statistik-Einschraekungen.png]
    
    \caption{Statistik Einschraekungen}
    \label{fig:statistik-1}
\end{figure}

\begin{figure}
    \centering
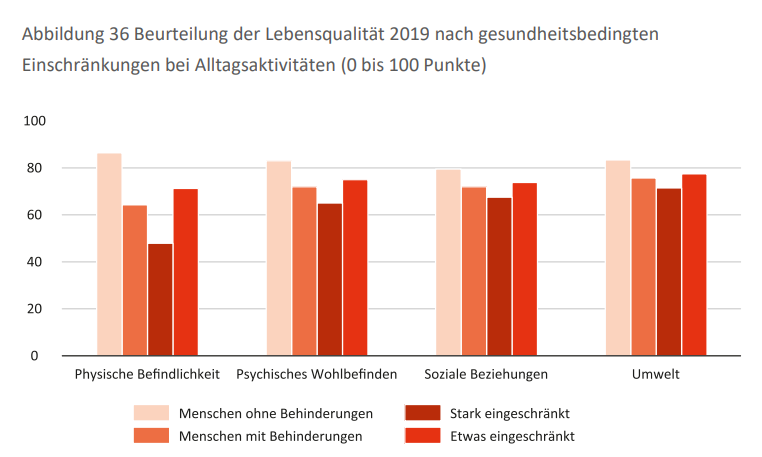
[picture p27: writing/pics/lebensqualiteat.png]
    
    \caption{Lebensqualität}
    \label{fig:lebensqualiteat}
\end{figure}

Die folgende Tabelle Abb. \ref{fig:statistik-2} präsentiert zur Veranschaulichung die Verteilung gesundheitlicher Einschränkungen bei Alltagsaktivitäten in Österreich im Jahr 2022, differenziert nach der Hauptaktivität. Insgesamt geben rund 75 \% der Menschen zwischen 15 und 89 Jahren an, keine Beeinträchtigungen zu haben, während etwa ein Viertel zumindest leichte oder starke Einschränkungen erlebt. Diese Korrelation verdeutlicht, dass physische Herausforderungen für einen signifikanten Anteil der Bevölkerung von Relevanz sind.
\cite{SchullerVictoriaMlinareviNikolinaKlimont2024}

Bei den Erwerbstätigen und Lehrlingen, die mit rund 55 \% die größte Gruppe bilden, sind ungefähr 63 \% ohne Einschränkung. Etwa 31 \% der Teilnehmenden geben an, von leichten oder stärkeren Beeinträchtigungen betroffen zu sein, wobei circa 13 \% von ihnen starke Beeinträchtigungen verspüren. Dies veranschaulicht, dass trotz körperlicher Herausforderungen ein signifikanter Prozentsatz der Gesellschaft einer Erwerbstätigkeit nachgeht.
\cite{SchullerVictoriaMlinareviNikolinaKlimont2024}

Arbeitssuchende und Arbeitslose repräsentieren rund 4,4 \% der Gesamtbevölkerung in Österreich. Der Anteil der Befragten mit starken Einschränkungen liegt hier bei knapp 6 \%. Eine ähnliche Entwicklung ist bei dauerhaft arbeitsunfähigen Individuen zu beobachten, von denen etwa 16,5 \% starke Einschränkungen angeben.
\cite{SchullerVictoriaMlinareviNikolinaKlimont2024}

Die Gruppe der Pensionisten, die beinahe ein Viertel der Allgemeinheit ausmacht, weist mit ungefähr 95 \% die höchste Anzahl an Personen mit starken Einschränkungen auf. Zusätzlich gaben rund 45 \% der Befragten in Österreich leichte Einschränkungen an, während nur knapp 18 \% keine medizinischen Beeinträchtigungen erlebten. Diese Werte demonstrieren signifikat den Einfluss des Alters auf die Gesundheit.
\cite{SchullerVictoriaMlinareviNikolinaKlimont2024}

Die Gruppe der Auszubildenden umfasst etwa 11 \% der untersuchten Population. In dieser Gruppe ist der Anteil derjenigen, die keine Einschränkungen melden, vergleichsweise hoch, während nur wenige starke Beeinträchtigungen angeben.
\cite{SchullerVictoriaMlinareviNikolinaKlimont2024}

Auch in der Gruppe der Haushaltsführenden zeigt sich ein ähnliches Bild: Hier berichten ebenfalls viele Personen von keinen oder nur geringen Einschränkungen, während starke Beeinträchtigungen nur selten genannt werden. Dieser Befund deutet darauf hin, dass jüngere und aktive Bevölkerungsgruppen tendenziell eine höhere Lebensqualität aufweisen.
\cite{SchullerVictoriaMlinareviNikolinaKlimont2024}, \cite{IUFEAT-Wien2023}, \cite{KletzmayrKerstin2022}, \cite{IsabellaSkiba2020}, \cite{JuliaSofieWieder2025}

Die vorliegenden Zahlen belegen, dass gesundheitliche Einschränkungen in sämtlichen Hauptaktivitätsgruppe auftreten, wobei sie insbesondere bei älteren und dauerhaften Betroffenen zu beobachten sind.
\cite{SchullerVictoriaMlinareviNikolinaKlimont2024}, \cite{IUFEAT-Wien2023}, \cite{KletzmayrKerstin2022}, \cite{IsabellaSkiba2020}, \cite{JuliaSofieWieder2025}

\begin{figure}
    \centering
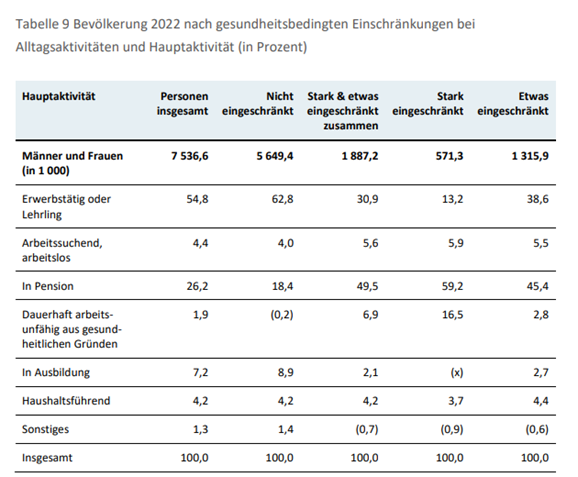
[picture p28: writing/pics/Statistik-Hauptaktivitaet.png]
    
    \caption{Statistik Hauptaktivitaet}
    \label{fig:statistik-2}
\end{figure}

\subsection{Barrierefreiheit im Berufsleben}
\setauthor{Elisa Kaltenberger}
Barrierefreiheit im Berufsleben spielt eine entscheidende Rolle für die soziale Inklusion und die Lebensqualität von Menschen mit gesundheitlichen Einschränkungen. Die vorliegenden Daten aus Österreich zeigen deutlich, siehe Abb. \ref{fig:statistik-3}, dass ein Mangel an barrierefreien Strukturen direkte Auswirkungen auf die Teilhabe am Arbeitsmarkt hat.
\cite{SchullerVictoriaMlinareviNikolinaKlimont2024}

Im Jahr 2022 lag die Erwerbstätigenquote von Menschen mit gesundheitlichen Einschränkungen im Alter von 15 bis 64 Jahren bei 55,6 \%, während sie bei Menschen ohne Behinderungen 78,3 \% betrug. Besonders deutlich wird die Problematik bei Personen mit starken Einschränkungen: Hier waren lediglich 27,9 \% erwerbstätig, wohingegen Personen mit leichten Einschränkungen eine deutlich höhere Quote von 65,1 \% aufwiesen. Diese Unterschiede verdeutlichen, dass der Grad der Einschränkung und damit auch die Notwendigkeit von Barrierefreiheit einen erheblichen Einfluss auf die Beschäftigungschancen hat.
\cite{SchullerVictoriaMlinareviNikolinaKlimont2024}

Auch bei der Arbeitslosigkeit zeigen sich klare Unterschiede. Die Arbeitslosenquote von Menschen mit Behinderungen lag 2022 bei 8,2 \%, während sie bei Menschen ohne Behinderungen lediglich 4,2 \% betrug. Besonders betroffen sind wiederum Personen mit starken Einschränkungen, bei denen die Arbeitslosenquote mit 16,0 \% mehr als doppelt so hoch ist wie bei Personen mit leichten Einschränkungen (7,6 \%). Zudem benötigen arbeitssuchende Personen mit gesundheitlichen Einschränkungen im Durchschnitt 21,4 Monate, um eine neue Beschäftigung zu finden. Dies weist auf strukturelle Barrieren im Zugang zum Arbeitsmarkt hin.
\cite{SchullerVictoriaMlinareviNikolinaKlimont2024}

\begin{figure}
    \centering
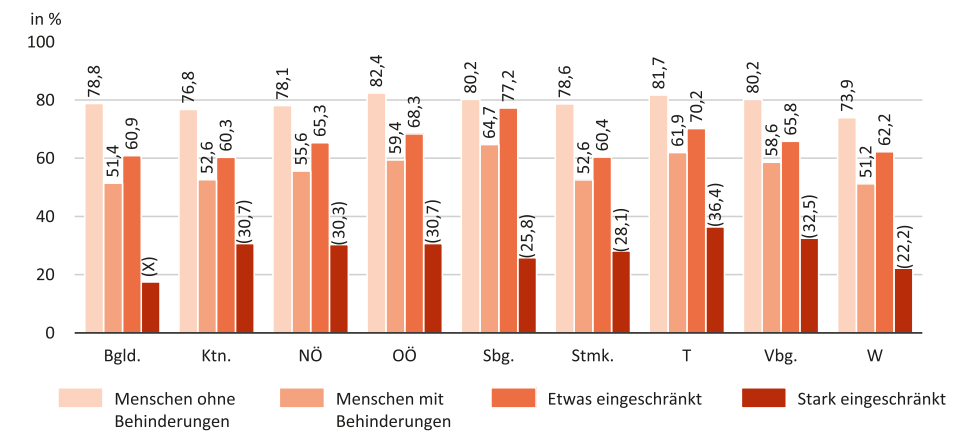
[picture p29: writing/pics/Statistik-Berufsleben.png]
    
    \caption{Statistik Berufsleben}
    \label{fig:statistik-3}
\end{figure}

\subsection{Assistenzsysteme und Alltagshürden von Rollstuhlfahrenden}
\setauthor{Elisa Kaltenberger}
Persönliche Assistenzsysteme und technologische Hilfsmittel spielen eine zentrale Rolle bei der Bewältigung alltäglicher Barrieren von Rollstuhlfahrenden. Sie ermöglichen zunächst die grundlegende Mobilität, indem elektrische Rollstühle die fehlende körperliche Kraft ersetzen und selbstständige Fortbewegung sowohl im Innen- als auch im Außenbereich erlauben. Laut der HAW Hamburg Arbeit \cite{JuntangDarboe2022} sind technische Eigenschaften wie Fahrstabilität, Schwerpunktlage, Sicherheitsmechanismen und individuelle Anpassbarkeit entscheidend dafür, dass Rollstühle zuverlässig und sicher genutzt werden können. Diese technische Ausgestaltung ist die Grundlage dafür, dass Nutzer*innen alltägliche Barrieren wie Treppen, unebene Wege oder enge Räume überhaupt überwinden können.

Darüber hinaus fördern Assistenzsysteme die Selbstständigkeit und Autonomie der Betroffenen. Elektrische Rollstühle und ergänzende Assistenztechnologien ermöglichen es den Nutzer*innen, alltägliche Aufgaben wie Haushaltstätigkeiten, Mobilität innerhalb der Wohnung oder das Aufsuchen öffentlicher Orte ohne fremde Hilfe zu bewältigen. Dies reduziert die Abhängigkeit von Pflegepersonen und stärkt das Gefühl der Kontrolle über das eigene Leben.
\cite{StephanieSackl2021}

Durch die gewonnene Mobilität können Rollstuhlfahrende aktiv am gesellschaftlichen Leben teilnehmen, soziale Kontakte pflegen und Freizeitaktivitäten nachgehen. Technische Assistenzsysteme wirken damit nicht nur funktional, sondern auch psychosozial, indem sie Isolation verhindern und die Lebensqualität deutlich erhöhen.
\cite{StephanieSackl2021}, \cite{JuntangDarboe2022}

\section{Interviews}
\setauthor{Elisa Kaltenberger}
Es wurde auf Menschen im Rollstuhl zugegangen, sie wurden kennengelernt und zu ihren Erfahrungen befragt. Die Interviews zeigen, dass die zu bewältigende physische Herausforderung von emotionaler Stärke, dem Umgang mit der Umwelt sowie einem persönlichen Lebenswillen begleitet wurde, die sich auf unterschiedliche Weise äußerten. Die Gründe für die Pflegebedürftigkeit der Testpersonen waren heterogen. So waren die Betroffenen entweder dauerhaft oder vorübergehend auf einen Rollstuhl angewiesen. Ihre Geschichten demonstrieren die Diversität des Lebens mit einer Mobilitätseinschränkung und die Implikationen, die sich aus der Notwendigkeit ergeben, plötzlich oder von Geburt an auf Hilfe oder Hilfsmittel angewiesen zu sein.

\subsection{Zusammenfassung Interview 1}
\setauthor{Elisa Kaltenberger}
Anna, 18 Jahre alt, erlitt vor vier Jahren einen schweren Unfall, in dessen Folge sie eine 
körperliche Beeinträchtigung erlitt, die für eine kurze Phase der Pflegebedürftigkeit in einem Rollstuhl erforderlich machte. Diese Wandelung vollzog sich in einem zeitlichen begrenzten, abrupten Ausmaß.

Nach dem Unfall wurde sie für die Dauer von einer Woche in ein Krankhaus gebracht. Sie sah sich 
mit der Herausforderung konfrontiert, sämtliche Alltagsaktivitäten neu zu erlenen. Hierzu zählten 
die eigenständige An- und Auskleidung sowie die Nutzung von Hilfsmitteln zur Körperpflege und die 
selbstständige Bedienung des Rollstuhls. Zunächst überwog eine ausgeprägte Verzweiflung. Allmählich manifestierte sich eine Veränderung. Es gelang ihr, sowohl eine physische als auch eine psychische Regeneration zu erfahren. Dennoch gestaltete sich der Übergang zurück in den 
Alltag als eine Abfolge kleiner, unerwarteter Schwierigkeiten. 

Nach dem Bruch ihrer Hüfte war Anna für die Dauer einer Woche auf einen Rollstuhl angewiesen für
eine kurze Zeit, jedoch stellte sie für sie eine völlig neue Erfahrung dar. Es wurde eine 
deutliche Verschlechterung der täglichen Routinen beobachtet, die sich in einfachen Verrichtungen wie dem Aufstehen am Morgen, dem Anziehen oder dem Duschen äußerte. Es oblag ihr, eine Vielzahl alltäglicher Abläufe neu zu erlernen oder dieses unter Zuhilfenahme von Hilfsmitteln zu bewältigen.

Der Schulbesuch stellte eine besondere Herausforderung dar. Das Gebäude entsprach nicht den Anforderungen der Barrierefreiheit, da es über keinen Aufzug verfügte, obwohl sich zahlreiche 
Unterrichtsräume in den oberen Stockwerken befanden. Die Bewältigung von Treppen stellt ein
Hindernis dar, die durch die physische und mentale Barriere der Überwindung charakterisiert ist. In viele Fällen war Improvisation unumgänglich. Die Schülerin wurde in andere Räumlichkeiten umgeleitet oder mit der Bearbeitung der Aufgaben zu Hause beauftragt. In der Folge verspürte sie eine Abkehr von der Klassengemeinschaft.

Die Zeit nach dem Unfall stellte sich zudem als eine physisch sowie psychisch belastenden Zeit 
heraus. Die plötzliche Notwendigkeit, auf die Unterstützung anderer angewiesen zu sein, 
beispielsweise beim Tragen der Schultasche, beim Öffnen von Türen oder beim Fortbewegen, wurde 
als ungewohnt und schmerzhaft empfunden. Die zuvor als selbstständig beschriebene Person sah sich plötzlich gezwungen, fortwährend um Hilfe zu ersuchen.

Besonders schwer wog dabei das Gefühl der Hilflosigkeit. Es ging einher mit der Angst, nie wieder vollständig zu genesen, und der Sorge, von anderen nur noch über die Verletzung definiert zu werden.

Obwohl sie den Rollstuhl nur temporär benötigte, führte diese Phase zu einer signifikanten 
Veränderung ihrer Perspektive auf zahlreiche Aspekte. Sie erlangte die Einsicht, dass sich das 
Leben mitunter rapide wandeln kann und dass es von großer Wichtigkeit ist, Geduld mit sich 
selbst zu bewahren.

Aus Annas Geschichte konnten einige Hindernisse, wie zum Beispiel hohe Bordsteine oder Pflastersteine, in unser Projekt inkludiert werden.

\cite{ElisaKaltenberger12026}

\subsection{Zusammenfassung Interview 2}
\setauthor{Elisa Kaltenberger}
Lukas, Alter 15, ist seit Mitte des Jahres 2024 auf einen Rollstuhl angewiesen, nachdem er 
infolge eines Unfalls für mehrere Monate immobil war. Die vorliegende Untersuchung widmet sich der
Thematik der Anpassung an eine neue körperliche Realität sowie den damit einhergehenden Veränderungen im alltäglichen Leben. Die Transition vom selbstständigen Gehen zur Nutzung eines Rollstuhls stellte eine einschneidende Erfahrung dar, die mit physischen und psychischen Herausforderungen einherging.

Der initiale Zustand des Alltags war durch eine signifikant ausgeprägte Fremdheit gekennzeichnet. 
Tätigkeiten, die zuvor als selbstverständlich erachtet wurden, wie das Überwinden von Stufen oder das selbstständige Bewegen über unebene Flächen, erforderten plötzlich fremde Hilfe. Die Abhängigkeit von anderen Personen wurde insbesondere in Bezug auf das Überwinden von Barrieren oder das Erreichen höhergelegener Orte als belastend empfunden. Im Zeitverlauf manifestierte sich eine zunehmende Routine. Lukas beschreibt, dass er sich in kurzer Zeit mit der Funktionsweise des Rollstuhls vertraut machte und die anfängliche Unsicherheit allmählich einer gewissen Selbstverständlichkeit wich.

Die Mobilität stellt die größte Herausforderung dar. Er betont, dass Situationen ohne helfende Personen oft mit Anstrengung und Frustration verbunden waren. Wurde er von jemand anderem geschoben, so empfand er dies als ungewohnt und teilweise beunruhigend, da sich der Rollstuhl indiesen Momenten instabiler und schneller anfühlte. Das Empfinden der Fremdbestimmung konstituierte eine mentale Hürde, die über die rein körperliche Einschränkung hinausging.

Besonders problematisch gestaltete sich die Situation im öffentlichen Verkehr. Obwohl Lukas in der Regel von einer Begleitperson unterstützt wurde, wiesen alltägliche Wege, etwa das Einsteigen in Bus oder Zug, ein potenzielles Gefahrenpotential auf. Bereits geringfügige Unebenheiten, wie der Übergang von der Straße auf den Gehsteig, können als problematisch erachtet werden. Glücklicherweise blieb er von Stürzen verschont, war sich jedoch der ständigen Möglichkeit bewusst, dass solche Situationen leicht außer Kontrolle geraten können. Es liegen keine Erfahrungen mit elektrischen oder 
sportlichen Spezialrollstühlen vor. 

Die schulische Umgebung wurde von Lukas als barrierefrei beschrieben. Im Vergleich zu seiner früheren Schule, in der große Teile des Gebäudes nicht zugänglich waren, konnte er in seiner aktuellen Einrichtung fast alle Räume erreichen. Lediglich in Einzelfällen wurden Hindernisse festgestellt, die den Zugang erschwerten.

Seit Anfang 2025 ist Lukas wieder in der Lage, ohne Rollstuhl zu gehen. Die Phase der eingeschränktenMobilität hinterließ dennoch einen nachhaltigen Eindruck. Dies resultierte in einer vertieften Auseinandersetzung mit Themen wie Selbstständigkeit, Barrierefreiheit und gesellschaftlicher Inklusion. Obwohl er bislang keine Reisen ins Ausland unternommen hat, gab er an, dass er einen Aufenthalt in Wien absolviert hat. Dort habe er kaum Unterschiede zur Barrierefreiheit in Linz wahrgenommen.

Er äußert sich kritisch über den öffentlichen Verkehr. Insbesondere für Menschen, die vollständig auf den Rollstuhl angewiesen sind, ist der Einstieg in Züge oder Busse ohne fremde Hilfe nahezu unmöglich. In diesem Bereich wird ein erheblicher Bedarf an Verbesserungen identifiziert. Taxis und private Autos werden hingegen als die verlässlichsten und komfortabelsten Fortbewegungsmittel bezeichnet.

Zusammenfassend lässt sich festhalten, dass Lukas Erfahrung im Rollstuhl eine signifikante Veränderung seines Blicks auf den Alltag bewirkt hat. Es wurde ersichtlich, dass die physischen Grenzen urbaner Mobilität nicht die einzigen Faktoren sind, die in Bezug auf städtische Mobilität zu berücksichtigen sind. Darüber hinaus wurden auch die emotionalen Aspekte von Abhängigkeit, Unsicherheit und Anpassung 
evident. Trotz der temporären Natur dieser Einschränkung bleibt diese Zeit für ihn prägend, als Phase der Erkenntnis, wie fragil Selbstständigkeit sein kann und wie wesentlich Empathie und Barrierefreiheit im gesellschaftlichen Zusammenleben sind.

\cite{ElisaKaltenberger22026}

\subsection{Zusammenfassung Interview 3}
\setauthor{Elisa Kaltenberger}
Tom, 32 Jahre alt, ist seitdem er geboren ist infolge einer körperlichen Beeinträchtigung, die eine dauerhafte Rollstuhlabhängigkeit bedingt, behindert. Sein Alltag ist geprägt von einer Kombination aus Routine, Anpassung und der permanenten Auseinandersetzung mit einer Umwelt, die nicht immer barrierefrei gestaltet ist. Die vorliegende Darstellung befasst sich mit den physischen und psychischen Herausforderungen, die das Leben im Rollstuhl mit sich bringt, sowie mit den gesellschaftlichen und infrastrukturellen Bedingungen, die seinen Alltag maßgeblich beeinflussen.

Das Fortbewegen auf unebenem Untergrund, etwa auf Kopfsteinpflaster oder auf schmalen, holprigen Wegen, 
stellt für Tom eine erhebliche Herausforderung dar. Das Befahren solcher Flächen erfordert ein hohes Maß an Konzentration und Kraft. Er beschreibt das subjektive Empfinden als mühsam und unangenehm, da jede Bewegung abgebremst und erschüttert wird. In vielen Fällen ist eine nur sehr langsame Progredienz zu beobachten. Zudem besteht eine konstante Angst, das Gleichgewicht zu verlieren oder in einer Vertiefung des Geländes stecken zu bleiben. In solchen Momenten ist er gezwungen, seine Aufmerksamkeit vollständig auf die Bewegung zu richten, wodurch der eigentliche Spaziergang oder Ausflug an Leichtigkeit einbüßt.

Stufen, Bordsteinkanten und größere Höhenunterschiede stellen dabei die größten Herausforderungen dar. Während geringe Schwellen mit einer gewissen Dynamik überwunden werden können, stellen Treppen oder Bodenlücken eine unüberwindbare Barriere dar. In solchen Fällen ist Tom auf Unterstützung angewiesen, die zumeist durch Familienmitglieder oder Freunde erfolgt, die ihn begleiten. Die Analyse der vorliegenden 
Daten ergibt, dass Alleinreisen nur selten praktiziert werden können. Tom lebt mit seiner Familie, die ihn in den meisten Situationen unterstützt. Dennoch empfindet er es als belastend, nicht immer autonome Handlungsfähigkeit zu haben. Das Ersuchen um Unterstützung wird von ihm mit einem Gefühl der Abhängigkeit assoziiert, welches er nur schwer akzeptieren kann.

Tom misst der Gestaltung öffentlicher Räume eine besondere Bedeutung bei. Er betont, dass Rampen, 
barrierefreie Übergänge und glatte Wege die Lebensqualität von Rollstuhlnutzern erheblich steigern können. Als besonders positiv hebt er seine Erfahrungen an einem Strand hervor, an dem spezielle Wege bis hin zum Meer angelegt waren. Diese Fähigkeit ermöglichte es den Menschen, sich selbständig fortzubewegen und das Meer aus eigener Kraft zu erreichen. Dies vermittelte ihnen ein Gefühl von Freiheit und Selbstbestimmung.

Darüber hinaus verweist Tom auf die mangelnde Infrastruktur für Rollstuhlfahrer, etwa fehlende 
Parkplätze, zu enge Wege oder unzureichend angepasste Hotelzimmer. Insbesondere das Reisen stellt für ihn und seine Familie eine finanzielle und organisatorische Herausforderung dar. Hotels, die über rollstuhlgerechte Badezimmer und barrierefreie Zugänge verfügen, sind häufig mit höheren Kosten verbunden und in vielen Regionen nur begrenzt verfügbar.

Tom beobachtet zudem kulturelle Unterschiede im Umgang mit Menschen mit Behinderung. In einigen 
Kulturkreisen werden freundliche und hilfsbereite Absichten zwar positiv bewertet, jedoch zeigt Tom 
eine gewisse Skepsis gegenüber dieser, als übertrieben empfundenen Verhaltensweisen, die er mit Mitleid verbindet. Er bevorzugt einen natürlichen und respektvollen Umgang, der seine Beeinträchtigung nicht als ausschließlich bestimmenden Faktor betrachtet.

Mit zunehmendem Alter bemerkt auch seine Mutter, die ihn oft schiebt, dass die körperliche Belastung zunimmt. Das gemeinsame Unterwegssein wird zunehmend als belastend empfunden, sowohl von der Frau als auch von Tom empfunden. Dies veranschaulicht, dass Barrierefreiheit nicht nur den Betroffenen selbst, sondern auch deren Angehörigen zugutekommt.

Des Weiteren beschreibt Tom das unangenehme Gefühl, welches sich einstellt, wenn er, etwa während des Umsteigens aus dem Rollstuhl, von anderen beobachtet wird. In diesen Momenten verspürt er ein Gefühl der Exposition, Verletzlichkeit und Bewertung. Die Familie des Betroffenen zeigt eine hohe Aufmerksamkeit 
für die Wahl von Orten, die über Rampen verfügen, um das Eintreten solcher Situationen zu vermeiden.

Es lässt sich festhalten, dass der Alltag des Probanden von einem stetigen Wechsel zwischen 
Selbstständigkeit und Abhängigkeit geprägt ist. Seine Erfahrungen zeigen, dass die Gestaltung 
öffentlicher Räume, Straßen und Gebäude einen entscheidenden Einfluss darauf hat, in welchem Maß 
Menschen mit Mobilitätseinschränkungen am gesellschaftlichen Leben teilhaben können. Trotz zahlreicher Herausforderungen zeigt Tom eine bemerkenswerte Gelassenheit. Er erkennt in jeder barrierefreien Rampe, in jedem angepassten Raum einen Aspekt des gesellschaftlichen Fortschritts und ein Indiz dafür, dass Inklusion nicht nur ein theoretisches Ideal, sondern eine alltägliche Notwendigkeit ist.
\cite{ElisaKaltenberger32026}

\subsection{Schlussfolgerung}
Insgesamt zeigt sich, dass persönliche Assistenzsysteme und technologische Hilfsmittel eine entscheidende Rolle bei der Überwindung alltäglicher Barrieren für Rollstuhlfahrende spielen. Sie ermöglichen nicht nur Mobilität und Autonomie, sondern tragen auch wesentlich zur sozialen Teilhabe und Lebensqualität bei. Gleichzeitig verdeutlichen die Analysen der statistischen Daten und Interviews, dass die Perspektiven und Bedürfnisse von Rollstuhlfahrenden in der kommunalen Stadtplanung bislang nur unzureichend berücksichtigt werden. Trotz vereinzelter barrierefreier Maßnahmen wie Rampen oder angepasster Wege treten weiterhin zahlreiche Hindernisse auf, etwa unebene Böden oder unzugängliche öffentliche Verkehrsmittel. Dies führt dazu, dass Betroffene häufig auf externe Unterstützung angewiesen sind, obwohl Assistenztechnologien viele dieser Einschränkungen reduzieren könnten.

Daraus folgt, dass technologische Hilfsmittel allein nicht ausreichen, um eine gleichberechtigte Teilhabe sicherzustellen. Ihre Wirksamkeit hängt stark von einer inklusiven und barrierearmen Umgebung ab. Um die Vorteile persönlicher Assistenzsysteme wirklich nutzen zu können, müssen sie zusammen mit barrierefreien Straßen, Gebäuden und einer Stadtplanung, die die Bedürfnisse von Rollstuhlfahrenden berücksichtigt, eingesetzt werden. Nur so kann gewährleistet werden, dass Rollstuhlfahrende tatsächlich selbstständig und gleichberechtigt am gesellschaftlichen Leben teilnehmen können.
\cite{StephanieSackl2021}, \cite{JuntangDarboe2022}, \cite{KletzmayrKerstin2022},
