LSchoenbauer/unseen-obstacles/writing/sections/vr-world.tex

\setauthor{Elisa Kaltenberger}

In diesem Kapitel wird die Auswahl der Entwicklungsplattform für die vorliegende 3D-VR-Simulation erläutert. Dabei werden die zentralen Kriterien betrachtet, die Unity gegenüber der \textit{Unreal Engine} als geeignete Lösung erscheinen ließen. Zunächst wird auf die VR-spezifischen Werkzeuge und Frameworks eingegangen, die eine effiziente Umsetzung von Interaktionen und Bewegungen ermöglichen. Anschließend wird die Bedeutung der Leistungsfähigkeit und Optimierbarkeit der Engine für eine stabile und ruckelfreie VR-Erfahrung diskutiert. Abschließend wird die Zugänglichkeit der Entwicklungsumgebung sowie die praktische Anwendbarkeit im schulischen Kontext hervorgehoben, um die Entscheidung für Unity inhaltlich zu untermauern.

\section{Programmierumgebung finden}
\setauthor{Elisa Kaltenberger}

Für die vorliegende Diplomarbeit wurde die \textit{Unity Engine} gegenüber der \textit{Unreal Engine} aus mehreren, auf das Projekt zugeschnittenen Gründen ausgewählt. Die Entwicklung einer 3D-VR-Simulation erforderte 
eine sorgfältige Abwägung, wobei Unity insgesamt die bessere Eignung aufwies.
\cite{NimrodKramer2024}, \cite{YuriPitomcev2025}

Der entscheidende Faktor für die Wahl von Unity lag in den umfangreichen VR-spezifischen Werkzeugen und der effizienten Entwicklungsumgebung. Unity bietet eine breite Palette an fertigen Komponenten und Schnittstellen für VR-Interaktion und Bewegung. Dadurch konnte von Beginn an der Fokus auf die inhaltlichen Herausforderungen der VR-Programmierung gelegt werden, ohne dass zusätzliche komplexe Anpassungen oder Eigenentwicklungen nötig gewesen wären. \textit{Unreal Engine} hätte aufgrund des komplexeren Blueprint-Systems und der stärker auf C++ ausgerichteten Programmierung einen höheren Entwicklungsaufwand verursacht, was die zeitliche Umsetzung der Simulation deutlich verlängert hätte.
\cite{NimrodKramer2024}, \cite{XRBootcamp2022}

Zusätzlich ist Unity im Bereich VR/XR gut aufgestellt und zugänglich. Über das XR Interaction Toolkit 
und die OpenXR-Unterstützung werden von Unity standardisierte und gut dokumentierte Frameworks speziell für die VR-Entwicklung angeboten. Diese Tools abstrahieren plattformspezifische Schwierigkeiten und ermöglichen einen effizienten Einstieg in die Entwicklung von Interaktionen für VR-Controller. 
\cite{NimrodKramer2024}, \cite{YuriPitomcev2025}, \cite{XRBootcamp2022}

Für eine stabile VR-Simulation ist eine hohe und konstante Framerate (FPS) von entscheidender Bedeutung, um das Auftreten von Motion Sickness zu vermeiden. Unity-Projekte werden als vergleichsweise ressourcenschonend und gut optimier- sowie kontrollierbar angesehen, was für den überschaubaren Umfang einer schulischen Simulation vorteilhaft war. Obwohl die \textit{Unreal Engine} häufig eine beeindruckendere Grafik erzeugt, weist sie in zahlreichen Szenarien einen höheren Basis-Overhead auf und erfordert eine leistungsstärkere Hardware. Im Rahmen eines exemplarischen Simulationsprojekts, das sich durch eine starke Fokussierung auf die inhaltliche Interaktion auszeichnete, wurde Unity als die Lösung identifiziert, die ein optimales Verhältnis zwischen visueller Qualität und garantierter Leistung der verfügbaren Hardware aufwies. Dies steht im Gegensatz zu fotorealistischen Visualisierungen, die bei diesem Projekt nicht im Vordergrund standen.
\cite{NimrodKramer2024}, \cite{YuriPitomcev2025}

\section{Welt einrichten}
\setauthor{Elisa Kaltenberger}
In diesem Kapitel wird die Entwicklung der VR-Simulation aus der Perspektive von Rollstuhlfahrenden beschrieben. Zunächst werden die zentralen Hindernisse im Alltag, wie Bankautomaten, Bordsteinkanten und unebene Pflastersteine, analysiert und ihre Herausforderungen für die Mobilität aufgezeigt. Aufbauend auf diesen Erkenntnissen wird die Umsetzung in der VR-Umgebung erläutert: von der physikalischen Interaktion und Wahrnehmung der Hindernisse, bis hin zur Gestaltung der finalen, realistischen VR-Welt mit detaillierten Assets und städtischer Umgebung. Das Kapitel vermittelt damit sowohl die konzeptionellen Überlegungen als auch die technischen Schritte, die zur Erstellung einer praxisnahen und immersiven VR-Erfahrung führten.

\subsection{Überlegung der Hindernisse}
\setauthor{Elisa Kaltenberger}
Zunächst wurden die signifikanten Hindernisse für Rollstuhlfahrende im Rahmen von Interviews identifiziert und analysiert. Auf dieser Grundlage wurde anschließend die VR-Welt gestaltet, um ein möglichst realistisches und zugleich bestmögliches Ergebnis zu erzielen.

Aus den Interviews wurde deutlich, dass die Nutzung eines Bankautomaten für Menschen mit Mobilitätseinschränkungen eine Herausforderung darstellt, siehe Abb. \ref{fig:vr-world:bankomat}. In einer signifikanten Anzahl von Fällen sind die Automaten zu hoch angebracht, was dazu führt, dass sowohl der Bildschirm als auch das Tastenfeld nur mit einem hohen Aufwand erreicht werden können. In vielen Fällen ist die zur Verfügung stehende Bewegungsfläche vor dem Automaten unzureichend. Ein zusätzliches Problem stellt der Sichtschutz dar, da die seitlichen Schutzblenden oder Abdeckungen in der Regel für stehende Personen konzipiert sind.

\begin{figure}
    \centering
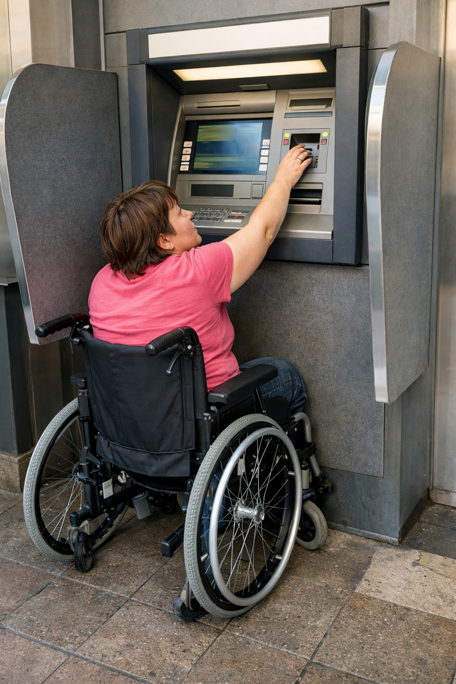
[picture p30: writing/pics/bankautomat-ki-generiert.png]
    
    \caption{Bankautomat, der für Rollstuhlfahrende schwer zugänglich ist (KI-Generiert)}
    \label{fig:vr-world:bankomat}
\end{figure}

Eine Bordsteinkante stellt für Rollstuhlfahrer*innen im Alltag eine signifikante Barriere dar. Die Höhe der Bordsteine hat einen signifikanten Einfluss auf die Fähigkeit der Verkehrsteilnehmer*innen, die Straße selbstständig zu überqueren. Selbst geringfügige Höhenunterschiede können eine Gefahr darstellen, da die Räder am Rollstuhl hängen bleiben oder das Gefährt umkippen kann. Abgesenkte Bordsteine werden häufig als unzureichend gestaltet wahrgenommen oder deren Nutzung wird durch parkende Autos, Fahrräder oder Baustellen erschwert. Bei Niederschlag kommt es zu einer Wasseransammlung, was das Überfahren zusätzlich erschwert.

Des Weiteren ist festzustellen, dass Pflastersteine problematisch sind. Die unebene Oberfläche des Produkts führt zu einer signifikanten Erschütterung, die sich negativ auf die körperliche Verfassung auswirken kann. Es wurde durch die Interviews festgestellt, dass insbesondere die kleinen Vorderräder des untersuchten Objekts in Fugen oder abgesackten Steinen hängen bleiben können. Bei Nässe oder Glätte können Pflastersteine eine erhöhte Rutschgefahr aufweisen, was das Unfallrisiko signifikant erhöhen kann. Zudem ist ein deutlich höherer Kraftaufwand erforderlich, um auf diesen Wegen zu reisen, was die Autonomie der Fortbewegung erheblich einschränkt.

\subsection{Erster Prototyp}
\setauthor{Elisa Kaltenberger}
Der erste Prototyp der VR-Welt wurde in Unity erstellt, siehe Abb. \ref{fig:vr-world:prototyp}, um die zuvor identifizierten Hindernisse für Rollstuhlfahrende zu simulieren. 

In der ersten konkreten Umsetzungsphase des Projekts wurde ein strategischer Fokus auf Funktionalität und Nutzerperspektive gelegt. Hierzu wurde bewusst auf den Import komplexer, fertiger 3D-Assets verzichtet. Unter „Assets“ versteht man in diesem Kontext vollständig texturierte Modelle wie Gebäude, Autos oder detaillierte Oberflächenmaterialien, die üblicherweise für die visuelle Vollendung einer virtuellen Umgebung genutzt werden.

Stattdessen wurde eine minimalistische, abstrakte Testumgebung erstellt. Die vorliegende Struktur besteht ausschließlich aus einfachen geometrischen Grundkörpern, die direkt innerhalb der \textit{Unity Engine} erzeugt und arrangiert wurden. 
Die gesamte Szene wurde folglich in einer reduzierten, häufig einfarbigen oder grob gerasterten 
Darstellung präsentiert.

Das primäre und ausschließliche Ziel dieser Phase war die funktionale Validierung der zentralen Hindernisse ausschließlich aus der spezifischen Perspektive eines Rollstuhlfahrers. Es ging nicht um realistische Darstellung, sondern um die Beantwortung essenzieller technischer und konzeptioneller Fragen: Werden die Hindernisse aus der festgelegten Sitzhöhe korrekt und eindeutig wahrgenommen? Funktioniert die physikalische Kollisionserkennung an Bordsteinen und Kanten wie intendiert? Löst die Platzierung eines simulierten Bankautomaten das gewünschte Interaktionsproblem (Unerreichbarkeit, eingeschränkte Sicht) aus? Wie fühlt sich die Bewegung über ein Feld unebener Pflastersteine in der reinen Gameplay-Logik an?

Die Bewegungen, wie zum Beispiel das rütteln über unebene Pflastersteine, wurde implemiert und getestet. Es wurde festgestellt, dass die Bewegungsmechanik in der VR-Umgebung korrekt auf die Kollisionen mit den Pflastersteinen reagiert und die Wahrnehmung der Hindernisse aus der Perspektive einer rollstuhlfahrenden Person realistisch simuliert wird.

\begin{figure}
    \centering
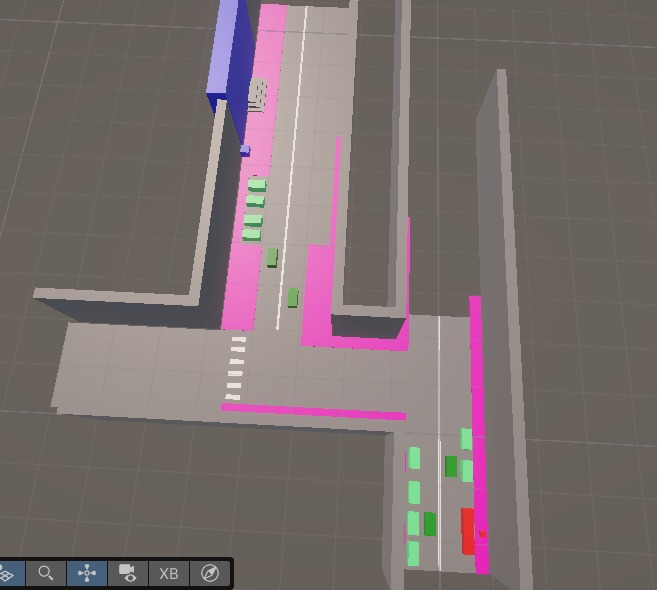
[picture p31: writing/pics/prototyp-welt.jpg]
    
    \caption{Prototyp der VR-Welt mit Hindernissen für Rollstuhlfahrende}
    \label{fig:vr-world:prototyp}
\end{figure}

\subsection{Welt gestalten}
\setauthor{Elisa Kaltenberger}
Nach erfolgreicher Einrichtung der Testumgebung wurde ein umfangreiches Asset-Paket einer realen Stadt 
ausgewählt und heruntergeladen, nach dem Kriterieum, dass die Welt realisitisch aussieht Abb. \ref{fig:vr-world:umgesetzte-welt}. 
Im Anschluss daran wurden die einzelnen Gebäude manuell aus dem Paket extrahiert und in die virtuelle Realität integriert. Um die Szenerie lebendiger und authentischer wirken zu lassen, wurden zusätzliche Elemente wie detailreiche Gehsteige, verschiedene Fahrzeugmodelle sowie ein vollständiges Straßennetz systematisch hinzugefügt.

Die Modellierung, Texturierung und Integration der weiteren ästhetischen Komponenten, welche nicht durch das Asset-Paket abgedeckt waren, erfolgte individuell. Im Anschluss wurden diese in die virtuelle 
Umgebung integriert. Der kreative und technische Prozess, der zur Schaffung einer immersiven, 
kohärenten und visuell ansprechenden VR-Landschaft führte, war erfolgreich.

\begin{figure}
    \centering
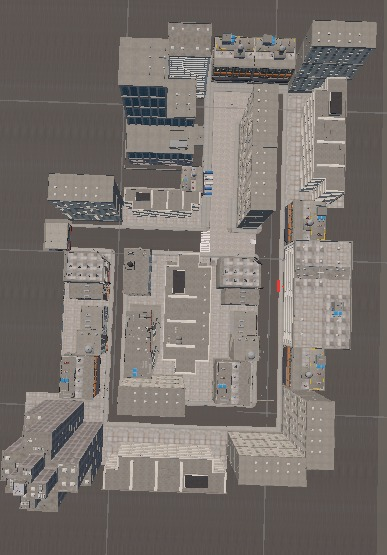
[picture p32: writing/pics/umgesetzte-welt.jpg]
    
    \caption{Umgesetzte VR-Welt mit Hindernissen für Rollstuhlfahrende}
    \label{fig:vr-world:umgesetzte-welt}
\end{figure}

\section{Interaktion in VR}
\setauthor{Elisa Kaltenberger}

In diesem Kapitel wird die technische Grundlage der VR-Entwicklung mit Unity erläutert. Zunächst wird 
das Konzept der Virtual Reality vorgestellt, wobei die immersive Darstellung dreidimensionaler Umgebungen und die Echtzeit-Interaktion im Fokus stehen. Anschließend wird die Rolle der Unity Engine als Entwicklungsplattform beschrieben, einschließlich der Kompatibilität mit VR-Headsets und der 
Bereitstellung von Tools für die Erstellung virtueller Szenen und Interaktionen. Darauf aufbauend werden die Benutzeroberflächen in Unity behandelt: Es wird erklärt, wie Canvas-Objekte als Container für UI-Elemente fungieren, welche Render-Modi für VR relevant sind und wie das EventSystem die 
Interaktivität der UI sicherstellt. Das Kapitel vermittelt damit sowohl die grundlegenden Konzepte der VR-Umgebung als auch die spezifischen Mechanismen zur Umsetzung funktionaler und immersiver Benutzeroberflächen.

Um die technischen Grundlagen und den Kontext dieser Umsetzung besser zu verstehen, wird im Folgenden zunächst der Begriff der Virtual Reality näher erläutert.

Virtual Reality (VR), auch Game Engine genannt, bezeichnet computergenerierte, dreidimensionale Umgebungen, die mittels Head-Mounted Displays (VR-Brillen) vollständig immersiv erlebt werden können. Die Reaktionen der Welt auf Kopf- und Handbewegungen erfolgen in Echtzeit und erzeugen ein Gefühl von Präsenz und Immersion. 

Die Kompatibilität erstreckt sich auf die Mehrzahl aktueller VR-Headsets und umfasst Tools für die Erstellung virtueller Räume, die Darstellung von Objekten sowie die Interaktion mit diesen.
\cite{Unity2026}, \cite{LysanderGawenda2024}

\subsection{Benutzeroberflächen (UI) in Unity}
\setauthor{Elisa Kaltenberger}

Unity stellt ein eigenes UI-System bereit, das auf sogenannten Canvas-Objekten basiert. Buttons sind standardisierte UI-Elemente, die über ein OnClick-Event verfügen. Das vorliegende Event gestattet die Ausführung einer definierten Funktion nach Aktivierung eines Buttons. Als Beispiel kann das Öffnen eines Pop-ups oder das Auslösen einer Aktion genannt werden.

Für VR-Anwendungen werden diese UI-Elemente nicht als klassische Bildschirm-Overlays genutzt, sondern als integraler Bestandteil der dreidimensionalen Szene integriert. Zu diesem Zweck wird der Canvas-Modus auf World Space gesetzt, wodurch Buttons wie reale Objekte im virtuellen Raum positioniert und skaliert werden können.

\cite{AshleyGodbold2017}, \cite{Unity2021}, \cite{FrancescoSapio2015}

\subsection{Canvas-Objekte}
\setauthor{Elisa Kaltenberger}
In dem vorliegenden Kontext bezeichnet ein Canvas-Objekt in Unity ein spezielles GameObject, das als grundlegender Container für alle Benutzeroberflächen-Elemente dient. Sämtliche UI-Elemente (User Interface) wie Buttons, Texte, Bilder oder Panels müssen einem Canvas untergeordnet sein, damit sie von Unity korrekt gerendert und dargestellt werden können. Ohne ein Canvas sind UI-Elemente nicht sichtbar, da sie außerhalb der UI-Rendering-Struktur liegen.
\cite{AshleyGodbold2017}, \cite{KennyMcLachlan2024}, \cite{JonathanLinowes2018}, \cite{JonathanLinowes2020}

Der Canvas definiert die Art und Weise sowie die Position der Benutzeroberflächen im Projekt. Die Aufgabe des Objekts besteht in der Verwaltung des Zeichenbereichs der UI sowie in der Festlegung der Reihenfolge, in der die UI-Elemente gerendert werden. Die Position der Elemente innerhalb der Hierarchie beeinflusst dabei die Überlagerung, sodass höher angeordnete Elemente über darunterliegende angezeigt werden.
\cite{AshleyGodbold2017}, \cite{KennyMcLachlan2024}, \cite{JonathanLinowes2018}, \cite{JonathanLinowes2020}

Ein zentrales Merkmal des Canvas-Objekts ist der sogenannte Render Mode. Dieser definiert die Art der Darstellung der Benutzeroberfläche. Im Modus Screen Space, Overlay wird die UI direkt über der gesamten Szene dargestellt, wobei sie unabhängig von der Kamera ist. Der Modus Screen Space, Camera erzeugt die Benutzeroberfläche (UI) unter Zuhilfenahme einer spezifischen Kamera und gestattet die Anwendung perspektivischer Effekte. Für Virtual-Reality-Anwendungen ist insbesondere der Modus World Space von Relevanz, da sich die Benutzeroberfläche in diesem Modus wie ein normales dreidimensionales Objekt in der Szene verhält. Dies ermöglicht die Platzierung von Buttons und Pop-ups im virtuellen Raum sowie die Betrachtung aus verschiedenen Blickwinkeln.
\cite{AshleyGodbold2017}, \cite{KennyMcLachlan2024}, \cite{JonathanLinowes2018}, \cite{JonathanLinowes2020}

Darüber hinaus besteht eine enge Kooperation zwischen dem Canvas und dem EventSystem von Unity, welches für die Verarbeitung von Benutzereingaben zuständig ist. In der vorliegenden Arbeit wird dargelegt, dass diese Kombination in VR-Anwendungen die korrekte Weiterleitung von Eingaben von Controllern, etwa über Raycasting, an UI-Elemente wie Buttons ermöglicht. Der Canvas bildet folglich die technische Grundlage dafür, dass Benutzeroberflächen sowohl sichtbar als auch interaktiv sind.
\cite{AshleyGodbold2017}, \cite{KennyMcLachlan2024}, \cite{JonathanLinowes2018}, \cite{JonathanLinowes2020}

In dem Projekt wurden mehrere Pop-ups Abb. \ref{fig:vr-world:pop-ups}  erstellt, die als Canvas-Objekte in der VR-Welt positioniert wurden. 
Diese Pop-ups erscheinen, wenn der Nutzer sich über eine bestimmte Stelle in der Szene bewegt. 
Sie enthalten Informationen zu den Hindernissen, die in der Simulation dargestellt werden, und ermöglich somit 
ein besseres Verständnis der Herausforderungen, mit denen Rollstuhlfahrende im Alltag konfrontiert sind. Die 
Pop-ups sind so gestaltet, dass sie leicht lesbar und visuell ansprechend sind, um die Aufmerksamkeit der 
Nutzer zu gewinnen und die Informationen effektiv zu vermitteln. 

\begin{figure}
    \centering
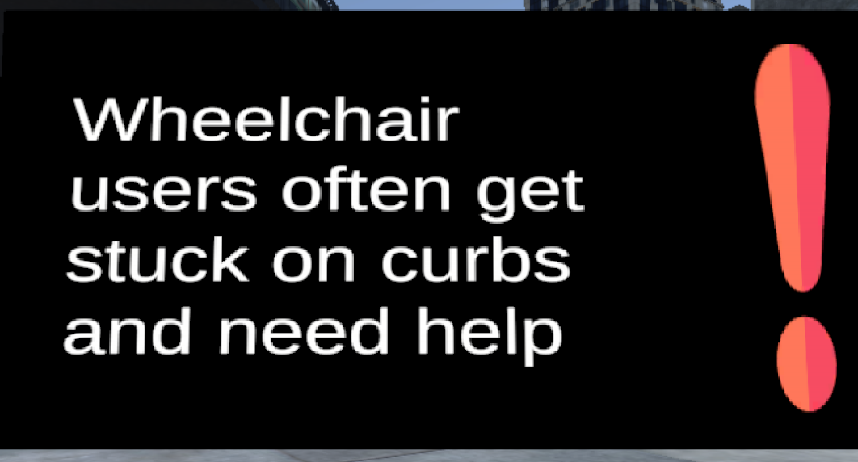
[picture p33: writing/pics/pop-up.png]
    
    \caption{Pop-ups in der VR-Welt, die Informationen zu den Hindernissen vermitteln}
    \label{fig:vr-world:pop-ups}
\end{figure}
