LSchoenbauer/unseen-obstacles/simulator/docs/3pty/AZ-Delivery_ESP32_D1 Mini-pinout.pdf

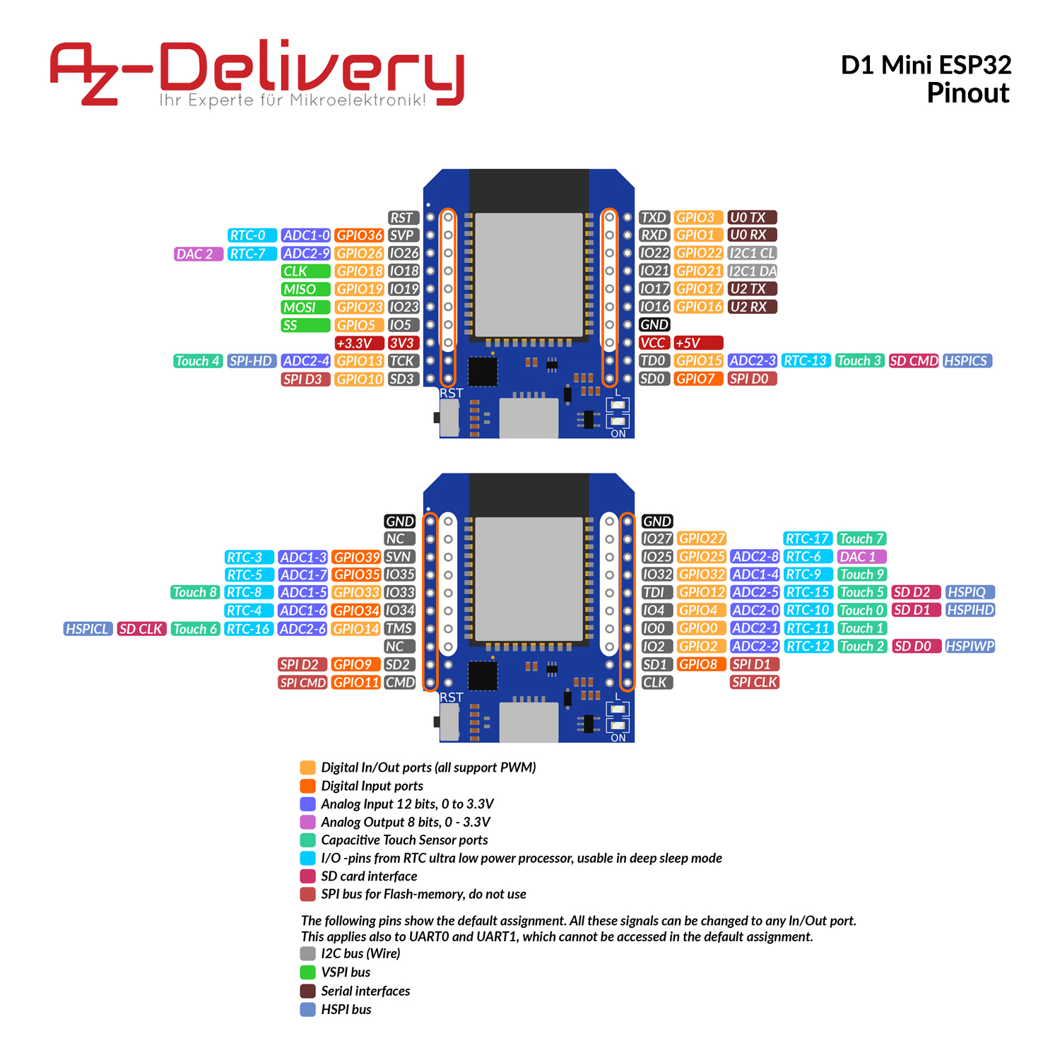
[picture p41: page 1]
