LSchoenbauer/unseen-obstacles/simulator/docs/3pty/AZ-Delivery_ESP32_D1 Mini-pinout_numbered_pins.pdf

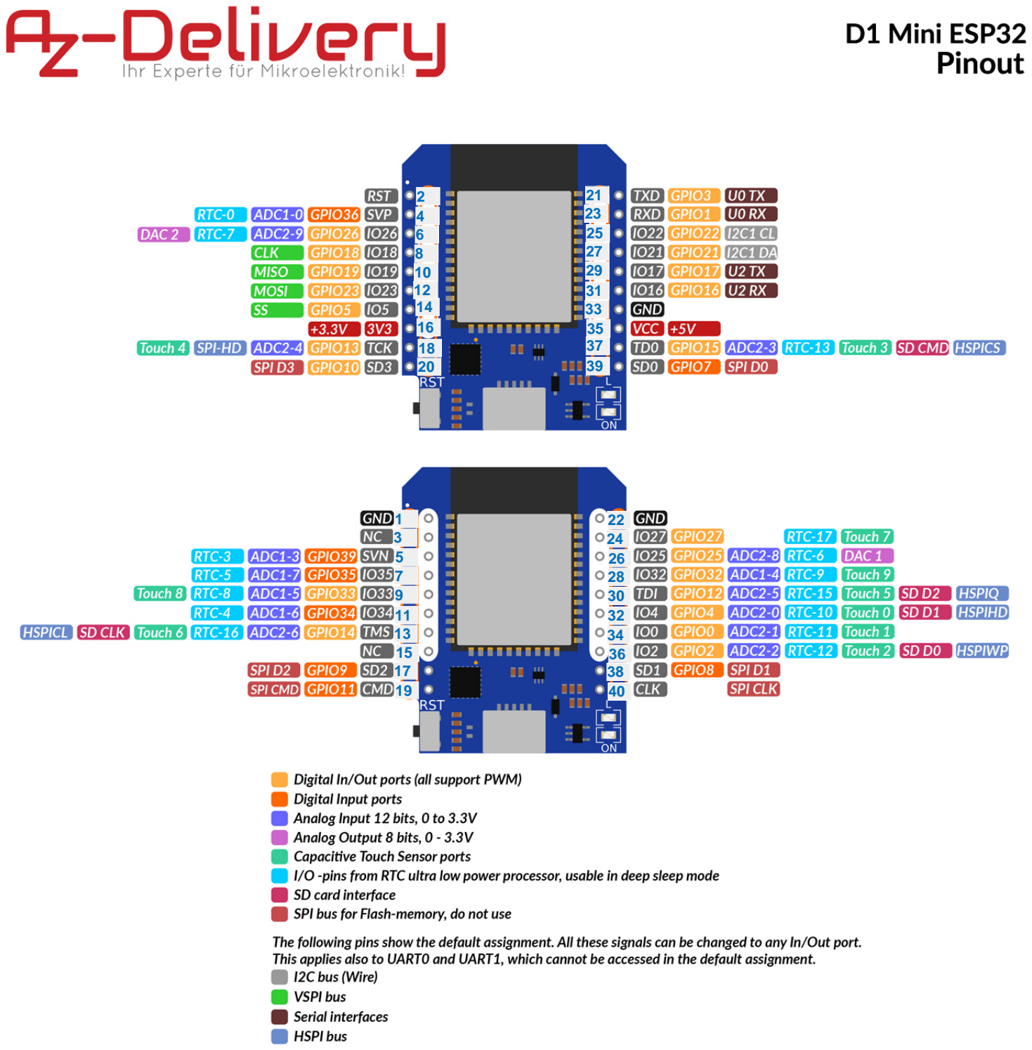
[picture p42: page 1]
