LSchoenbauer/unseen-obstacles/simulator/docs/3pty/Stepper_NEMA23_300Ncm_23HS45-3504S_Torque_Curve.pdf

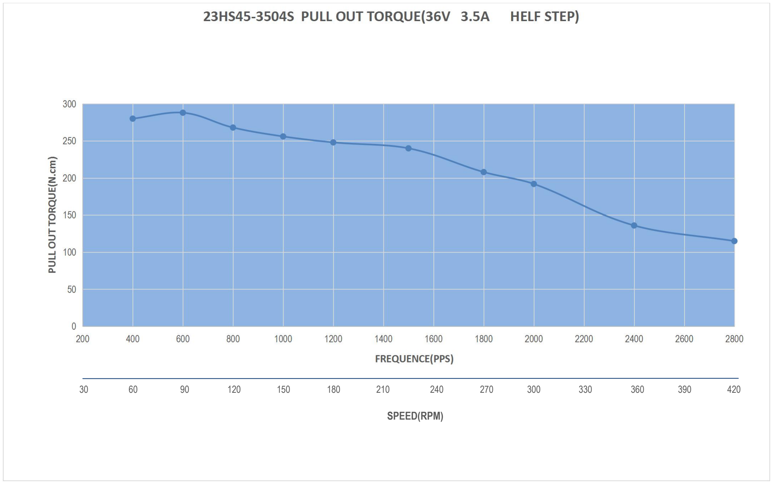
[picture p43: page 1]

30 | 60 | 90 | 120 | 150 | 180 | 210 | 240 | 270 | 300 | 330 | 360 | 390 | 420 SPEED(RPM)
