LSchoenbauer/unseen-obstacles/simulator/electronic/ead/UnseenObstacles_SimulatorController_PCB_rendered_back.jpg

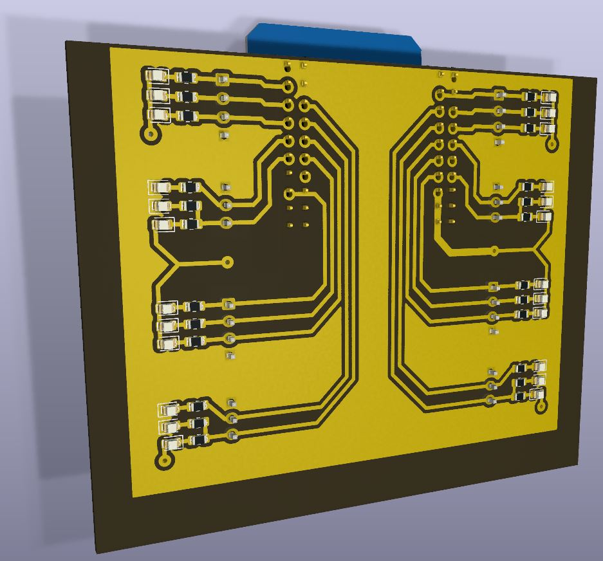
simulator/electronic/ead/UnseenObstacles_SimulatorController_PCB_rendered_back.jpg
