LSchoenbauer/unseen-obstacles/simulator/electronic/ead/UnseenObstacles_SimulatorController_PCB_rendered_front.jpg

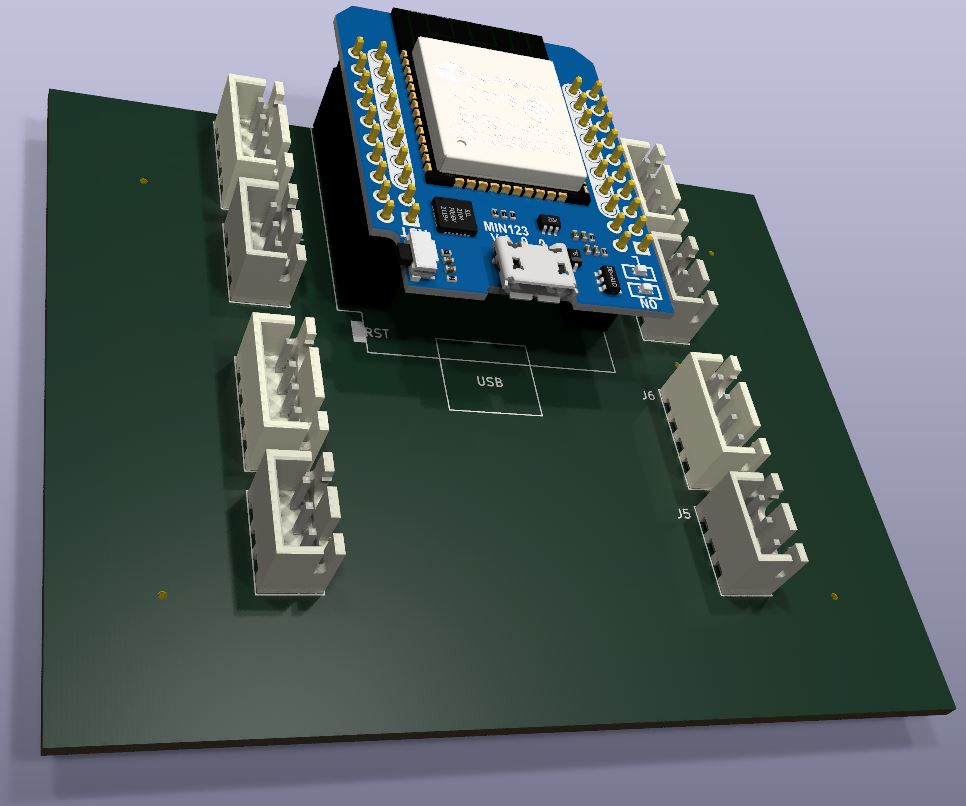
simulator/electronic/ead/UnseenObstacles_SimulatorController_PCB_rendered_front.jpg
