LSchoenbauer/unseen-obstacles/simulator/electronic/kicad/3d_models/jst-xh-2-50mm-genuine-connector-set/Assortment.JPG

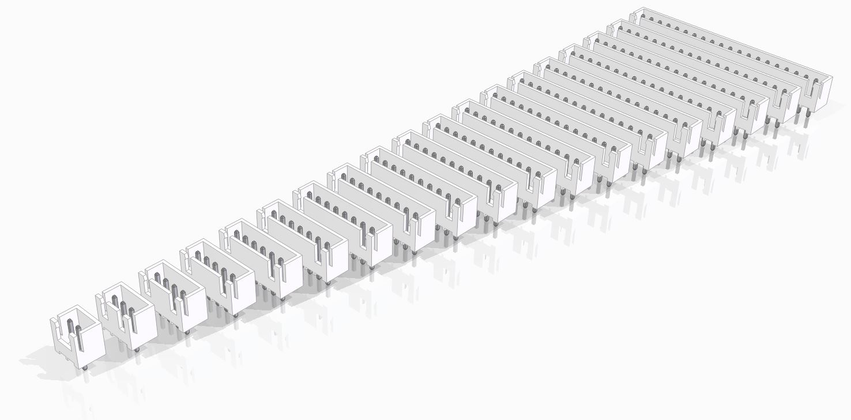
simulator/electronic/kicad/3d_models/jst-xh-2-50mm-genuine-connector-set/Assortment.JPG
