LSchoenbauer/unseen-obstacles/simulator/mechanics/models/3pty/wheelchair/wheelchair.PNG

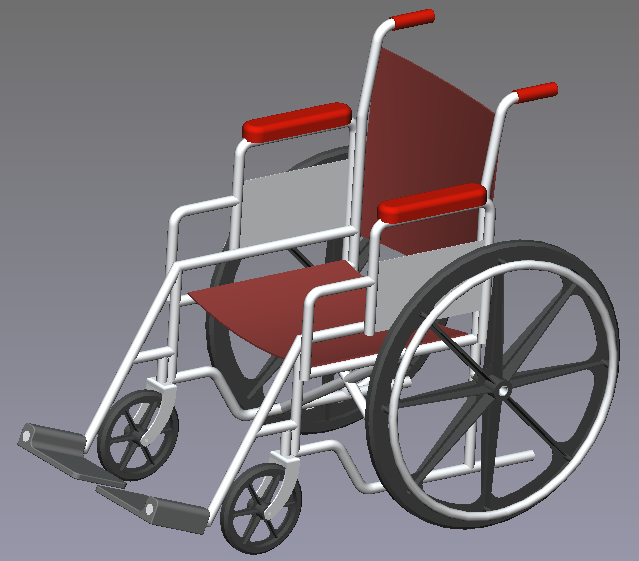
simulator/mechanics/models/3pty/wheelchair/wheelchair.PNG
