LSchoenbauer/unseen-obstacles/writing/pics/wagenheber-angeschraubt.jpg

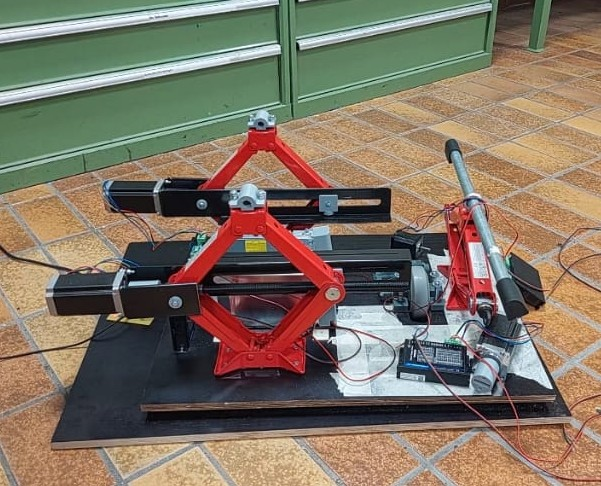
writing/pics/wagenheber-angeschraubt.jpg
