LSchoenbauer/unseen-obstacles/simulator/mechanics/parts/LiftingDevices/Liftbar_Front.jpg

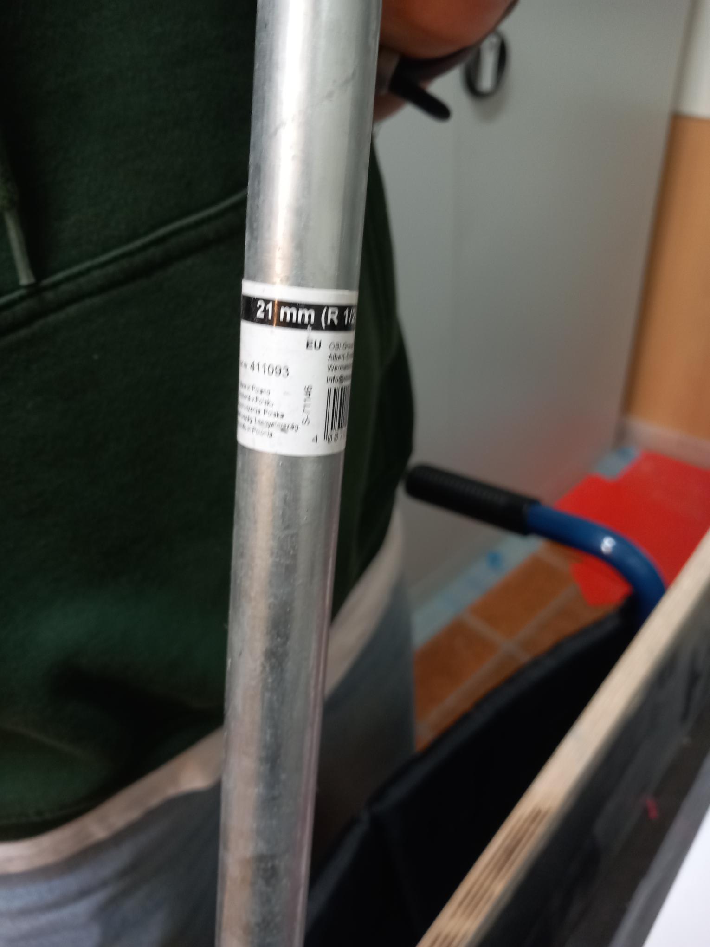
simulator/mechanics/parts/LiftingDevices/Liftbar_Front.jpg
