LSchoenbauer/unseen-obstacles/simulator/mechanics/parts/LiftingDevices/Microswitch_front.jpg

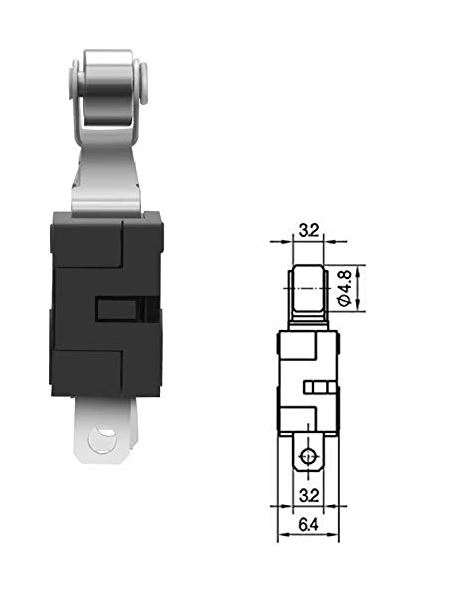
simulator/mechanics/parts/LiftingDevices/Microswitch_front.jpg
