LSchoenbauer/unseen-obstacles/simulator/mechanics/parts/LiftingDevices/Microswitch_side.jpg

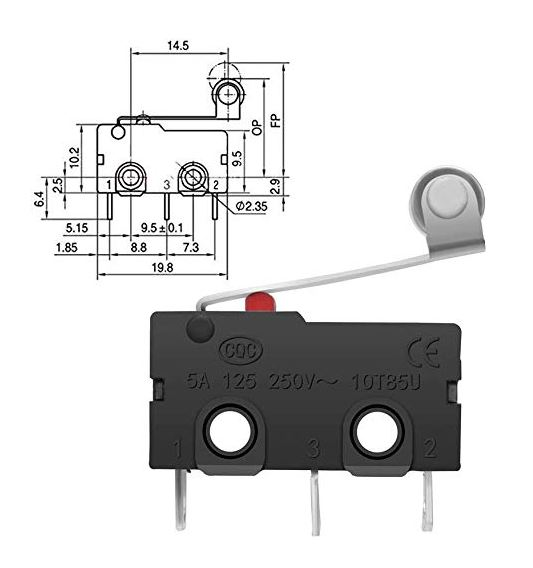
simulator/mechanics/parts/LiftingDevices/Microswitch_side.jpg
