LSchoenbauer/unseen-obstacles/simulator/mechanics/parts/LiftingDevices/ScissorJack_M01_width.jpg

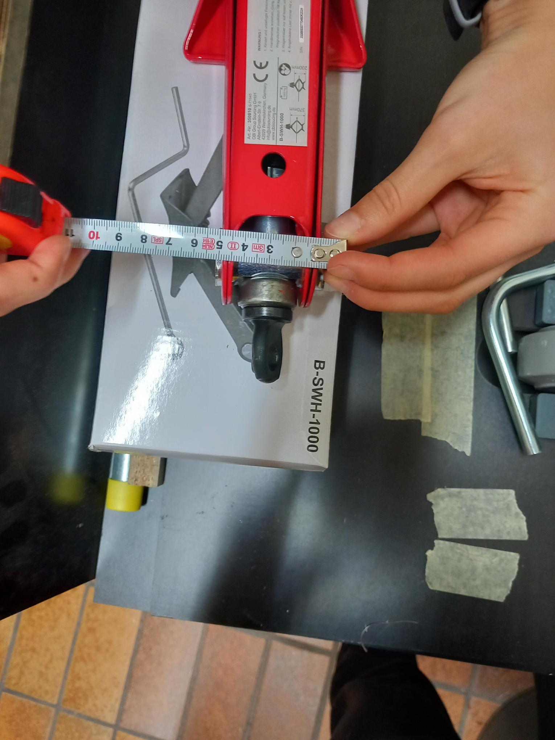
simulator/mechanics/parts/LiftingDevices/ScissorJack_M01_width.jpg
