LSchoenbauer/unseen-obstacles/simulator/mechanics/parts/LiftingDevices/ScissorJack_M02_length.jpg

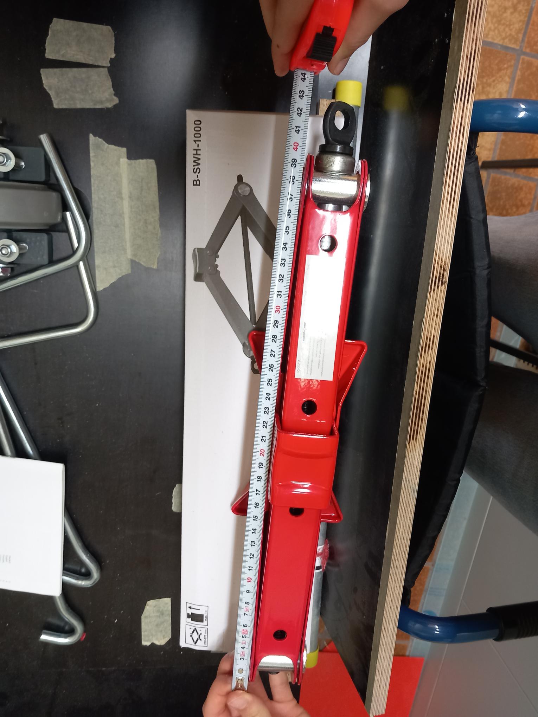
simulator/mechanics/parts/LiftingDevices/ScissorJack_M02_length.jpg
