LSchoenbauer/unseen-obstacles/simulator/mechanics/parts/LiftingDevices/ScissorJack_M03_top_length.jpg

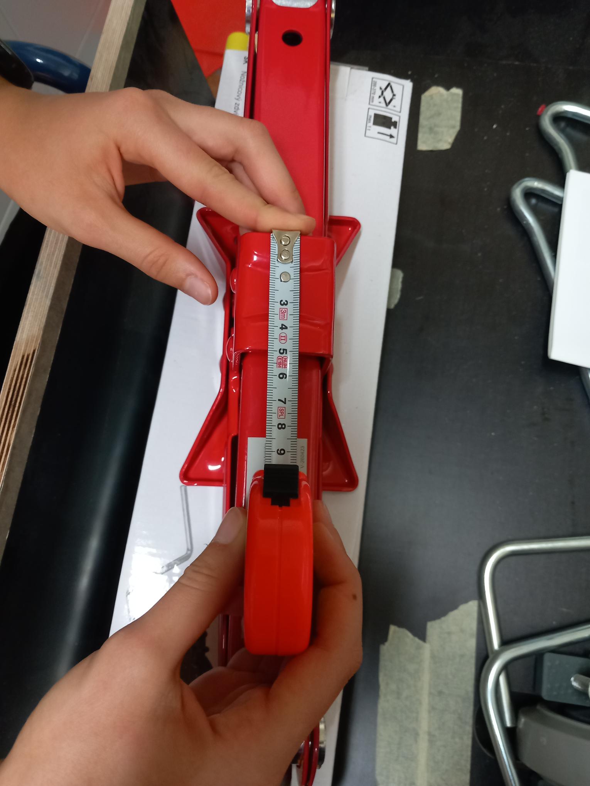
simulator/mechanics/parts/LiftingDevices/ScissorJack_M03_top_length.jpg
