LSchoenbauer/unseen-obstacles/simulator/mechanics/parts/LiftingDevices/ScissorJack_M04_top_width.jpg

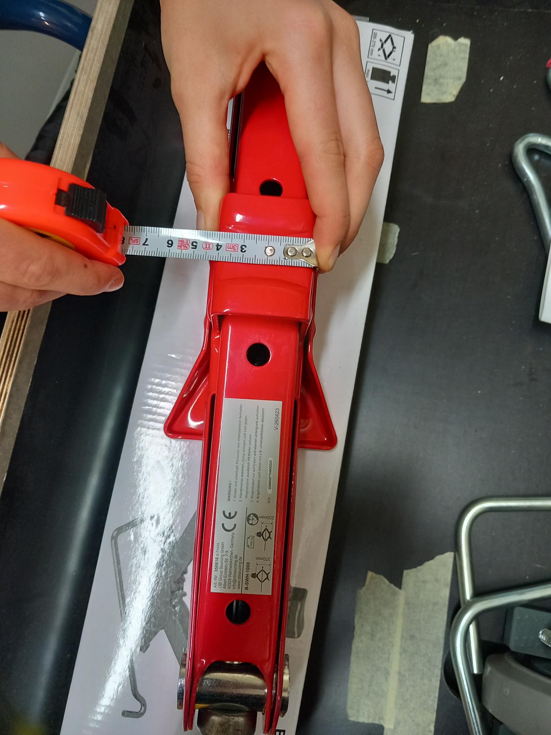
simulator/mechanics/parts/LiftingDevices/ScissorJack_M04_top_width.jpg
