LSchoenbauer/unseen-obstacles/simulator/mechanics/parts/LiftingDevices/ScissorJack_M05_bottom_length.jpg

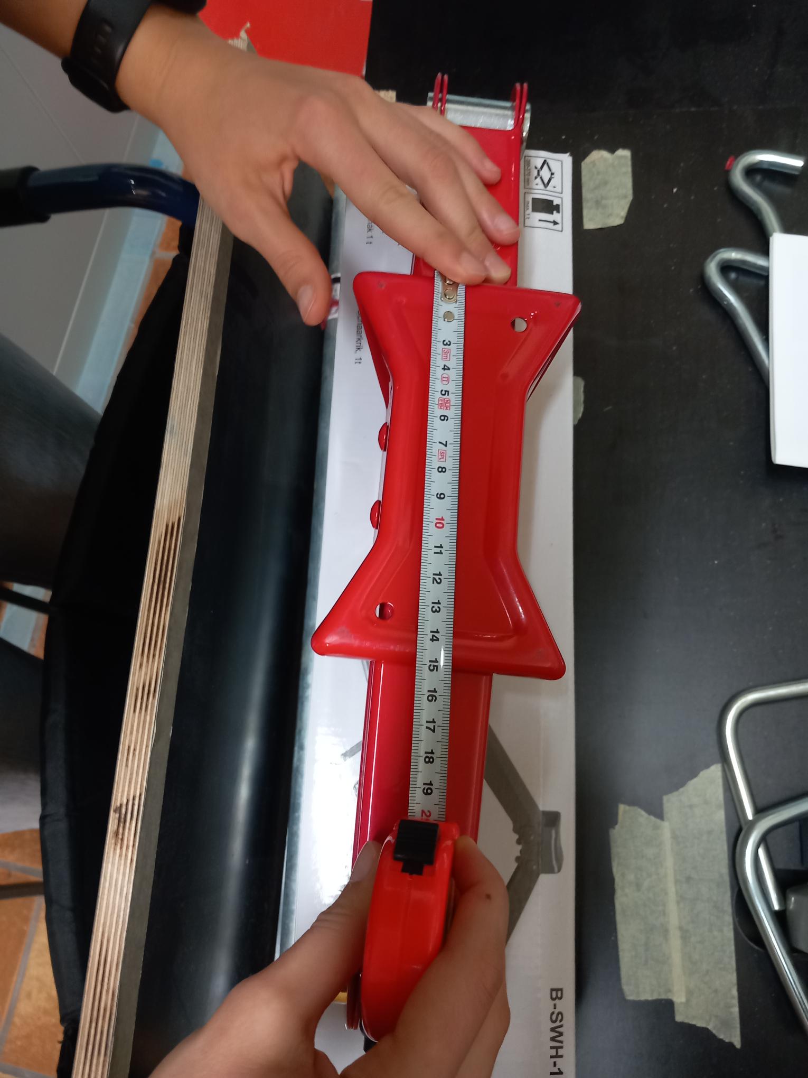
simulator/mechanics/parts/LiftingDevices/ScissorJack_M05_bottom_length.jpg
