LSchoenbauer/unseen-obstacles/simulator/mechanics/parts/LiftingDevices/ScissorJack_M10_details.jpg

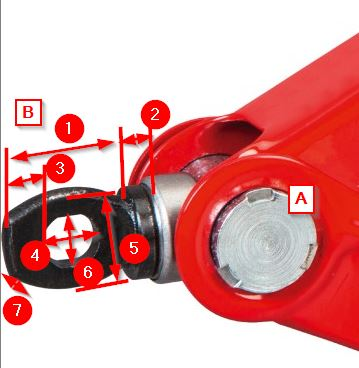
simulator/mechanics/parts/LiftingDevices/ScissorJack_M10_details.jpg
