LSchoenbauer/unseen-obstacles/simulator/mechanics/models/3pty/wheelchair/Assembly.FCStd

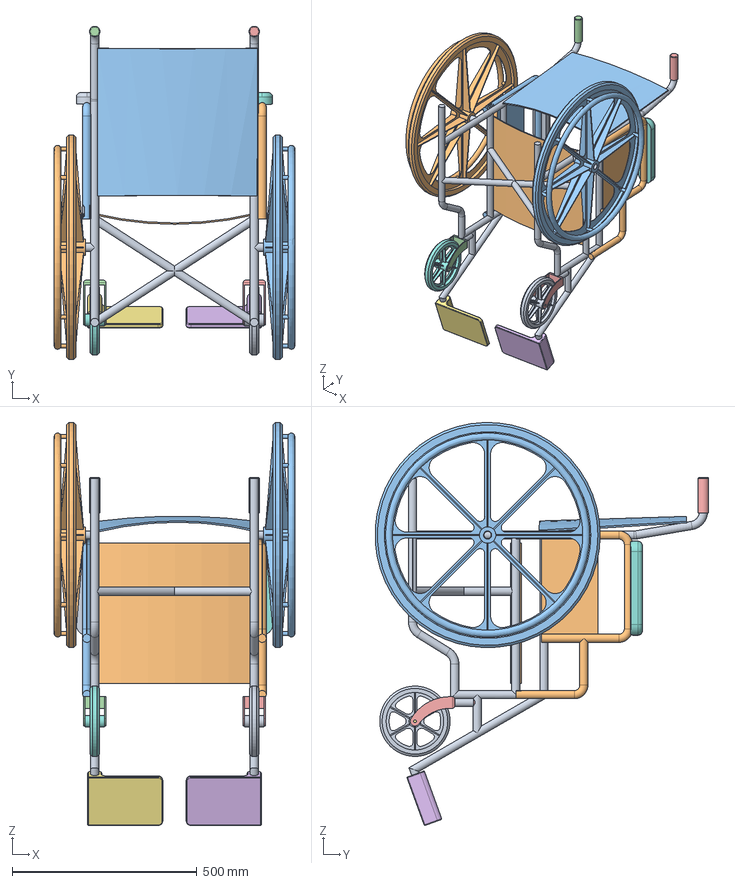
[picture p59: CAD file, 2025-07-04]
simulator/mechanics/models/3pty/wheelchair/Assembly.FCStd
652.0 x 902.7 x 1090.9 mm
Frame_001
Side panel_001
Side panel_002
Caster fork_001
Caster fork_002
Pin_001
Pin_002
Caster wheel_001
Caster wheel_002
Rear wheel_001
Rear wheel_002
Push handle_001
Push handle_002
Footplate_001
Footplate_002
Armrest_001
Armrest_002
Seat_001
Backrest_001
