LSchoenbauer/unseen-obstacles/simulator/electronic/kicad/3d_models/ESP32-NodeMCU-DevKit-C/ESP32-WROOM-DEVKIT-NODEMCU-V4_wide_low_detail.step

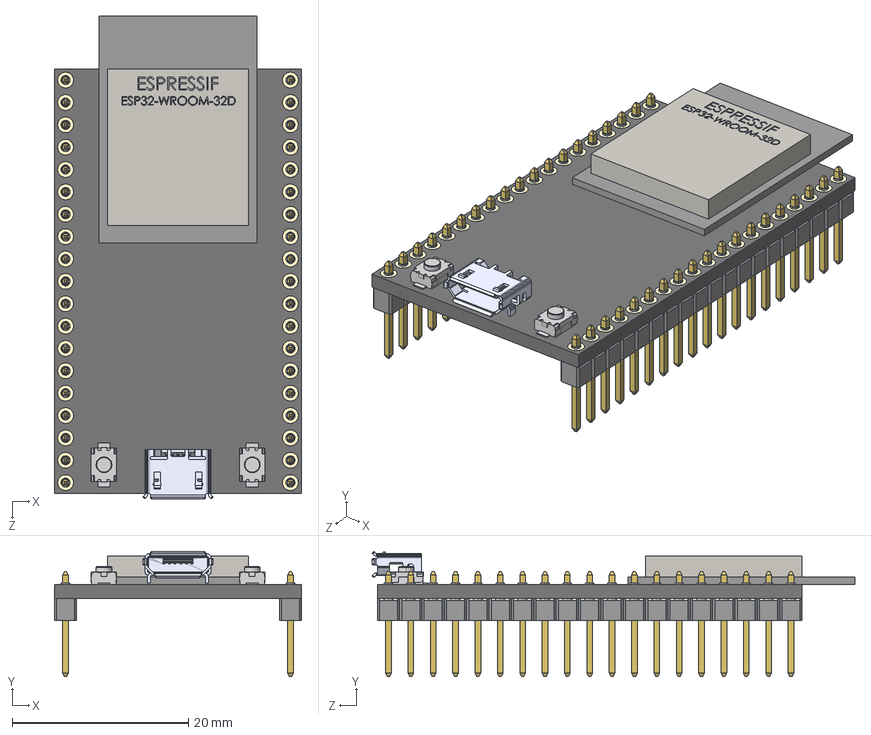
[picture p60: CAD file, 2025-07-21]
simulator/electronic/kicad/3d_models/ESP32-NodeMCU-DevKit-C/ESP32-WROOM-DEVKIT-NODEMCU-V4_wide_low_detail.step
28.1 x 14.2 x 54.9 mm
Main-PCB
zl201-19_p2-54_l48-3_w2-54_h8-9 x 2
Soldering-Contacts
ab2_usb_micro_smd.wrl
ESP32-chip
3x4x2mm_tact_button x 2
