LSchoenbauer/unseen-obstacles/simulator/electronic/kicad/3d_models/SMD_LEDs/LED_SMD_RGB_1616_RGB_EAST1616RGBA0.step

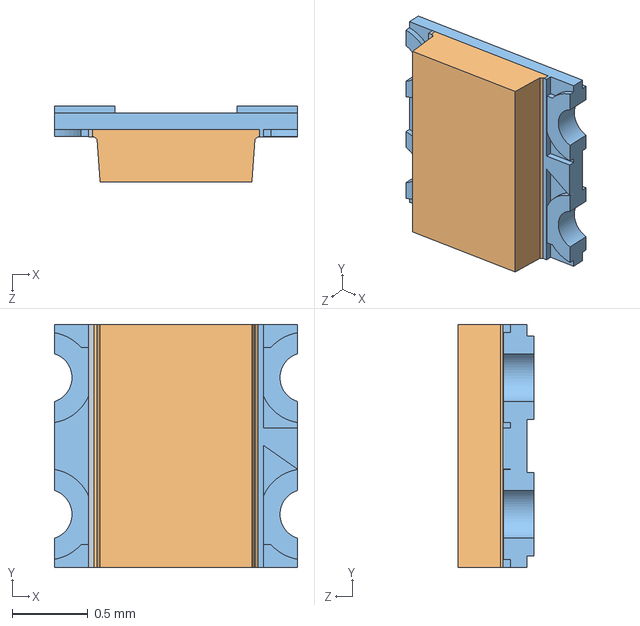
[picture p62: CAD file, 2025-10-06]
simulator/electronic/kicad/3d_models/SMD_LEDs/LED_SMD_RGB_1616_RGB_EAST1616RGBA0.step
1.60 x 1.60 x 0.5 mm
