LSchoenbauer/unseen-obstacles/simulator/mechanics/cad/Stirnradantrieb.FCStd

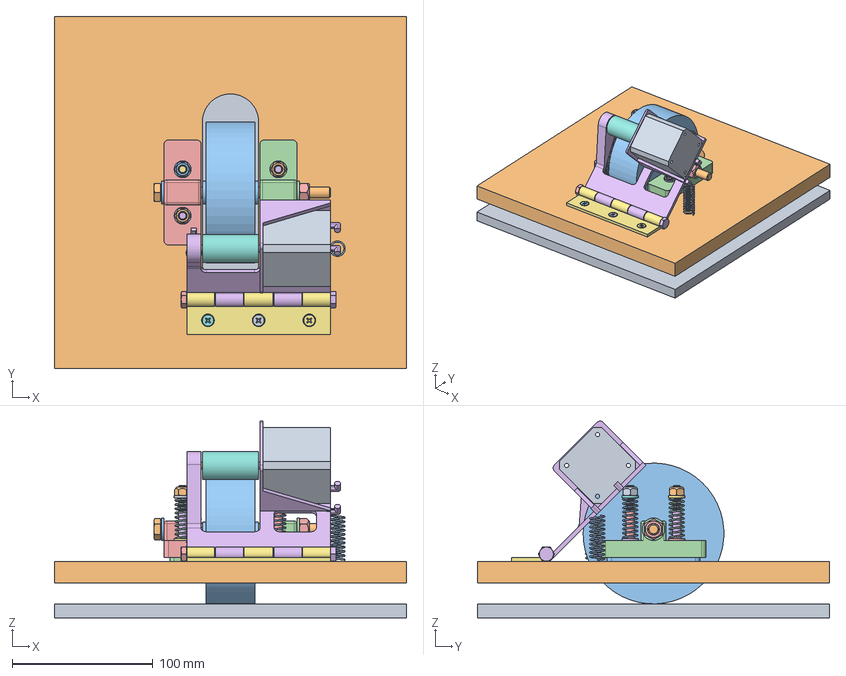
[picture p63: CAD file, 2026-02-02]
simulator/mechanics/cad/Stirnradantrieb.FCStd
250.0 x 250.0 x 139.9 mm
S-Dummy Grundplatte
S-Dummy Rotationsplatte
S-Dummy Rad D100
S-Radlagerbasis links
S-Radlagerfederung links
M6x50-Schraube 1 links
M6x50-Schraube 2 links
M6-Scheibe 1 links
M6-Scheibe 2 links
M6-Mutter 1 links
M6-Mutter 2 links
S-Feder 9x35 1 links
S-Feder 9x35 2 links
M6-Scheibe
M6-Scheibe001
#8x20-Schraube
#8x20-Schraube005
#8x20-Schraube006
S-Radlagerbasis rechts
S-Radlagerfederung rechts
M6x50-Schraube 1 rechts
M6x50-Schraube 2 rechts
M6-Scheibe 1 rechts
M6-Scheibe 2 rechts
M6-Mutter 1 rechts
M6-Mutter 2 rechts
S-Feder 9x35 1 rechts
S-Feder 9x35 2 rechts
M6-Scheibe 3 rechts
M6-Scheibe 4 rechts
#8x20-Schraube010
#8x20-Schraube011
#8x20-Schraube012
M8x120-Schraube
M8-Scheibe
M8-Scheibe001
M8-Mutter
S-Stepperwippe
S-Stepperwippenscharnier
S-Antriebswalze-NEMA17
S-Dummy Stepper NEMA17
M5x10-Schraube
P-Feder 9x35 10
P-Feder 9x35 11
M6x50-Schraube links
M6x50-Schraube rechts
#8x16-Schraube
#8x16-Schraube005
#8x16-Schraube006
