LSchoenbauer/unseen-obstacles/simulator/mechanics/models/3pty/lifting_jack.step

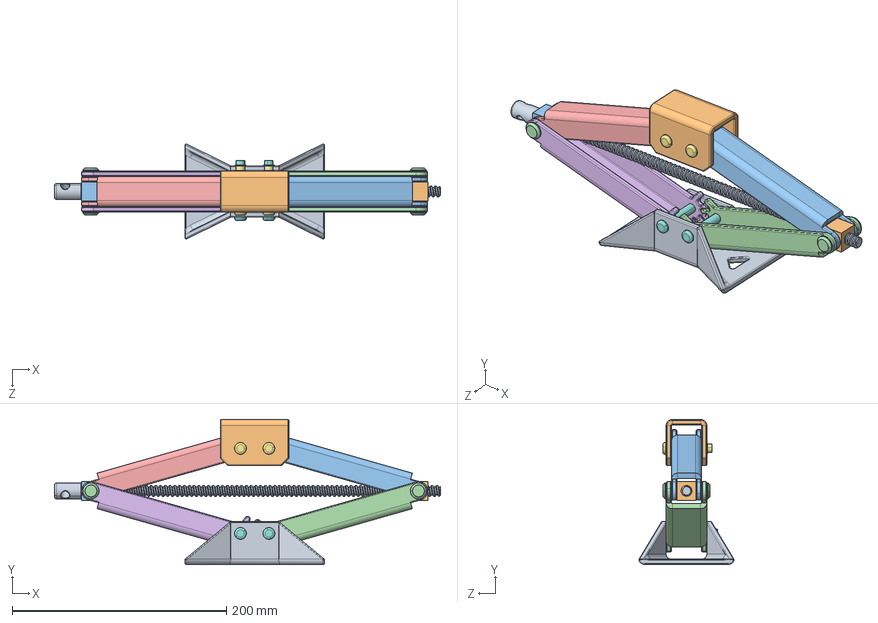
[picture p64: CAD file, 2025-10-27]
simulator/mechanics/models/3pty/lifting_jack.step
360.0 x 135.3 x 88.8 mm
base plate
carrier plate
upper lifting arm
top lifting arm
upper left lifting arm
top left lifting arm
top pins x 2
bottom pins x 2
drive screw
drive trunnion
stationary trunnion
turunnion pins x 4
snap ring x 4
