LSchoenbauer/unseen-obstacles/simulator/mechanics/models/3pty/stepper/47 MICRO SS-5GL2.SLDPRT

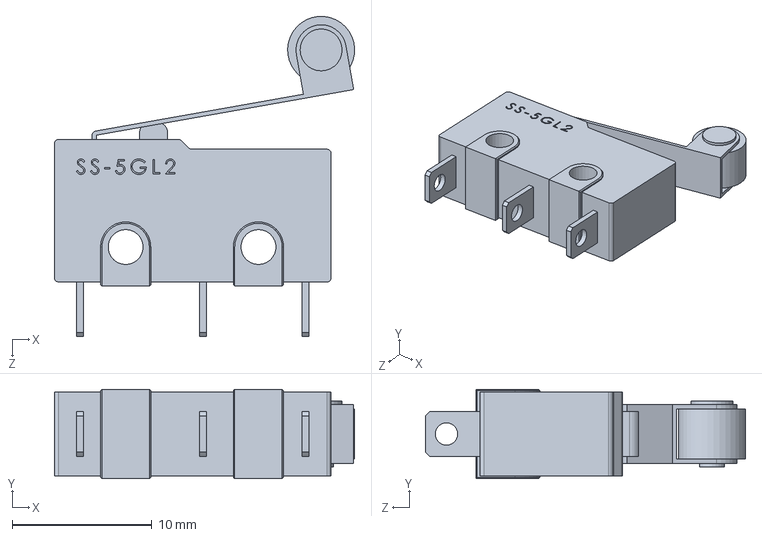
[picture p65: CAD file, 2025-10-19]
simulator/mechanics/models/3pty/stepper/47 MICRO SS-5GL2.SLDPRT
21.5 x 6.40 x 22.9 mm
