LSchoenbauer/unseen-obstacles/simulator/mechanics/models/3pty/wheelchair/Push handle.FCStd

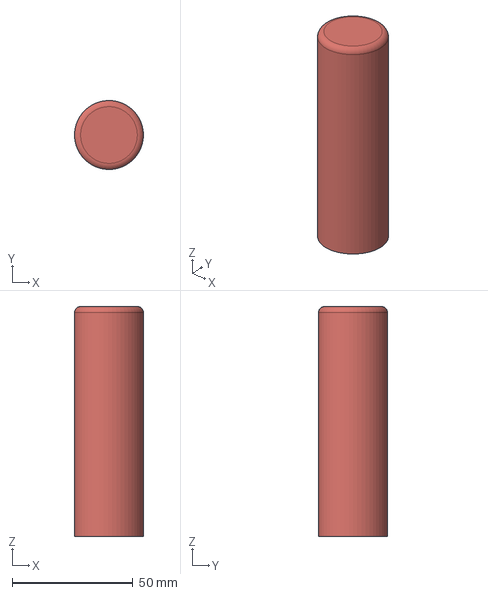
[picture p66: CAD file, 2025-07-04]
simulator/mechanics/models/3pty/wheelchair/Push handle.FCStd
28.5 x 28.6 x 95.2 mm
