LSchoenbauer/unseen-obstacles/simulator/mechanics/models/UM3E_Antriebswalze_PLAe1_TPU95Ae2.3mf

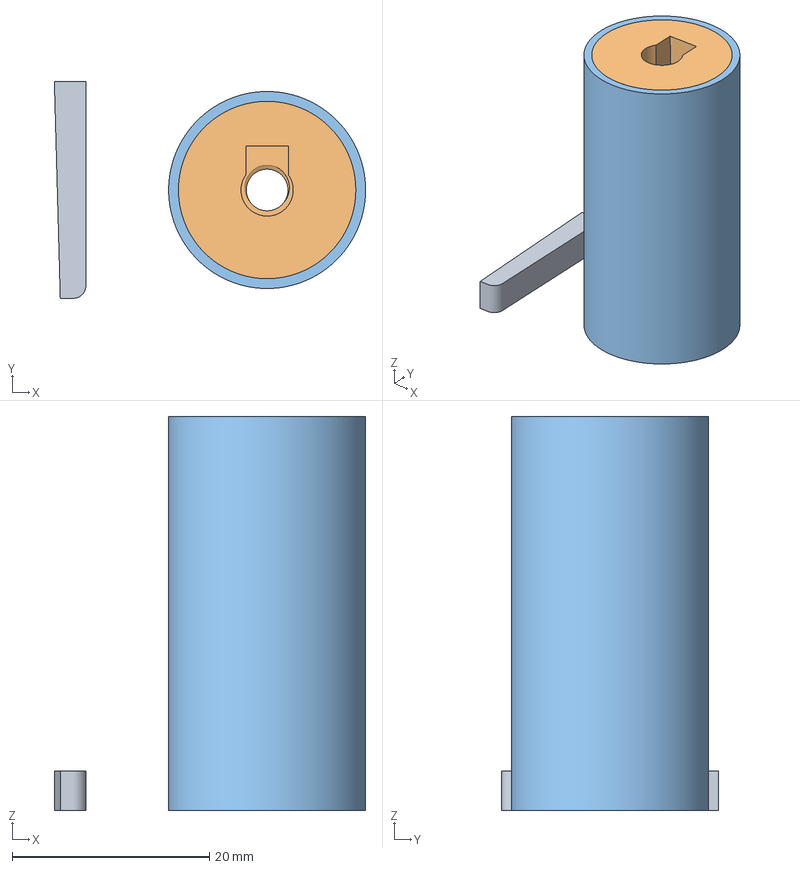
[picture p67: CAD file, 2026-02-02]
simulator/mechanics/models/UM3E_Antriebswalze_PLAe1_TPU95Ae2.3mf
31.6 x 22.0 x 40.0 mm
Stirnrad_Antriebswalzenfeder-NEMA17_18.0.stl
Stirnrad_Antriebswalze-NEMA17_18.0_Nut.stl
Stirnrad_Antriebswalzenhülle_18.0-20.0.stl
