LSchoenbauer/unseen-obstacles/simulator/electronic/kicad/3d_models/ESP32-NodeMCU-DevKit-C/ESP32-WROOM-DEVKIT-NODEMCU-V3_wide.step

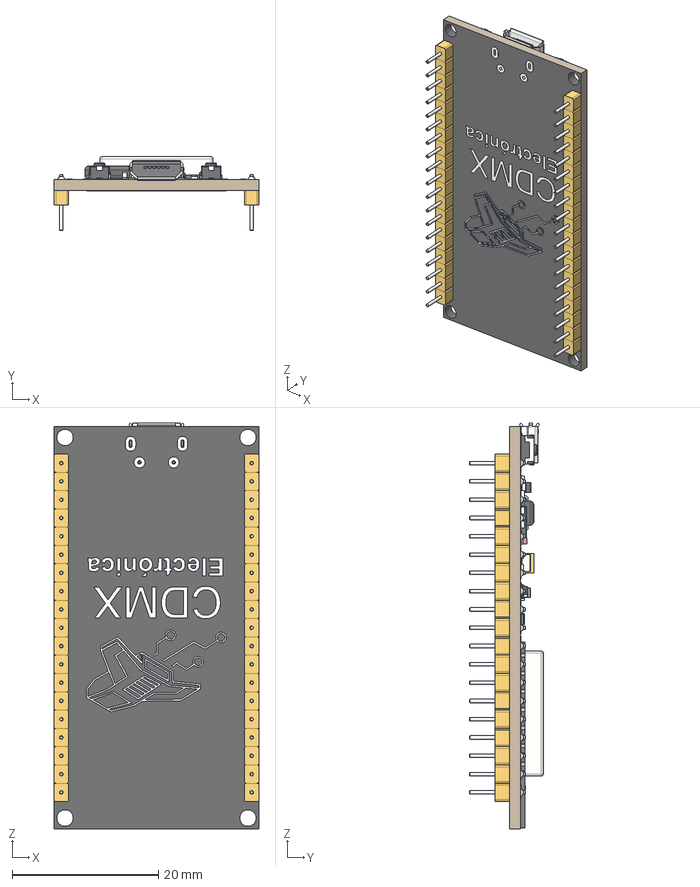
[picture p68: CAD file, 2025-07-21]
simulator/electronic/kicad/3d_models/ESP32-NodeMCU-DevKit-C/ESP32-WROOM-DEVKIT-NODEMCU-V3_wide.step
28.0 x 10.1 x 55.5 mm
MicroUSB
esp32
AMS1173.3V
cp2102
Push_Bottom x 2
Diodo_K24
Cap_Tam_106
Cap_Tam_106C
Transistor_smd x 2
Led_red_0603
Cap_0603 x 7
Res_102
Res_123 x 3
Res_471 x 4
Res_512 x 2
