LSchoenbauer/unseen-obstacles/simulator/mechanics/cad/Mounts.FCStd

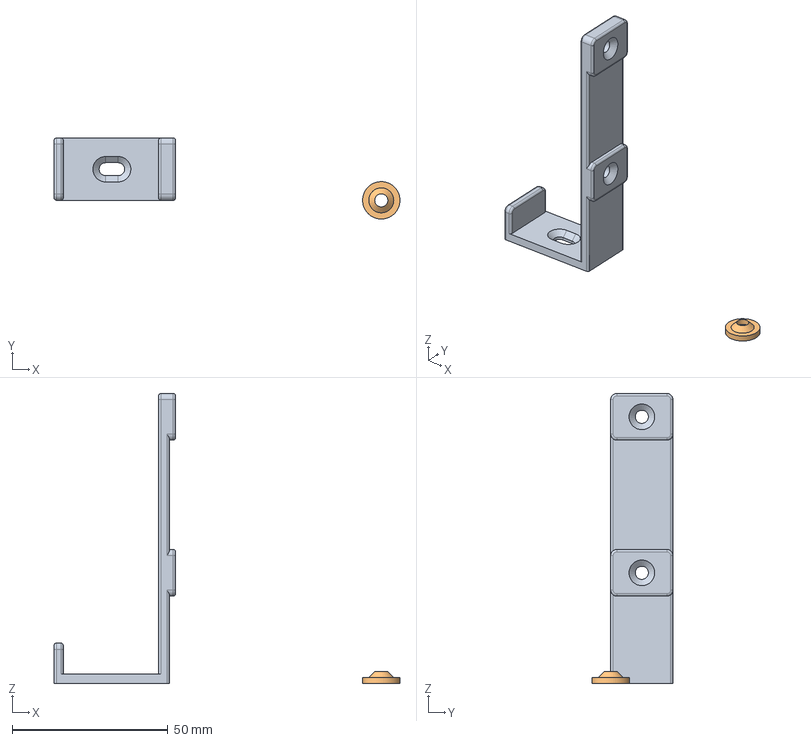
[picture p70: CAD file, 2025-11-19]
simulator/mechanics/cad/Mounts.FCStd
110.9 x 26.0 x 93.0 mm
B-Power Supply Mounting Brace - High
B-Screwextender_M4_2mm
