LSchoenbauer/unseen-obstacles/simulator/mechanics/models/3pty/stepper/Microswitch_20mm.stp

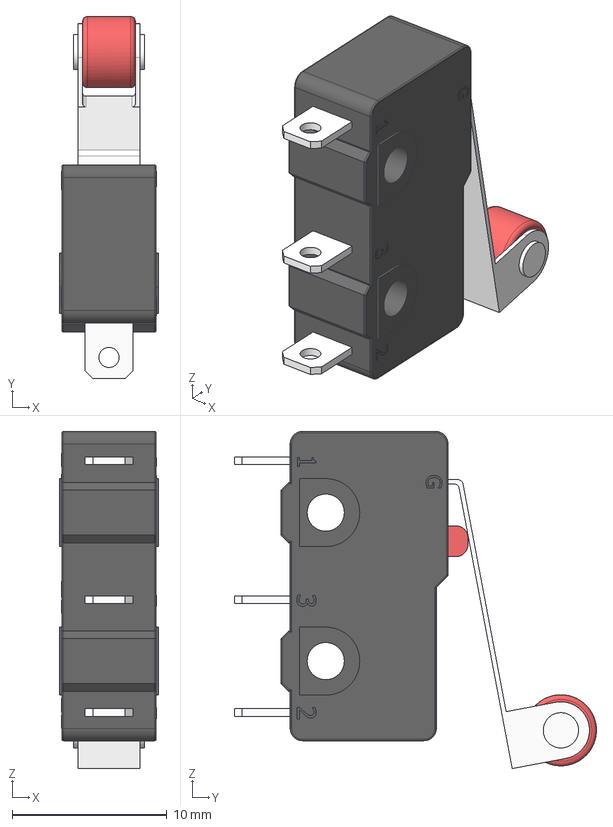
[picture p71: CAD file, 2025-10-17]
simulator/mechanics/models/3pty/stepper/Microswitch_20mm.stp
6.40 x 23.4 x 21.8 mm
