LSchoenbauer/unseen-obstacles/simulator/mechanics/models/3pty/wheelchair/Backrest.FCStd

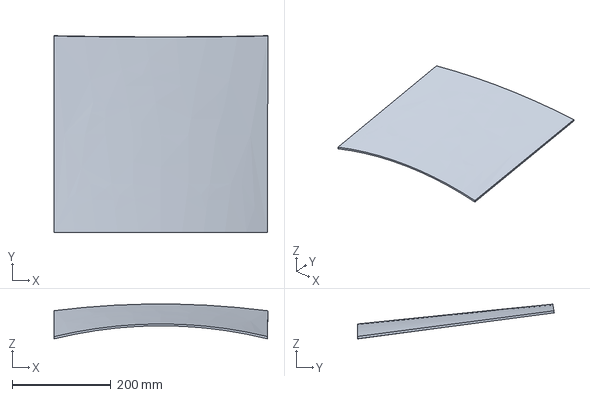
[picture p72: CAD file, 2025-07-04]
simulator/mechanics/models/3pty/wheelchair/Backrest.FCStd
433.3 x 398.2 x 70.5 mm
