LSchoenbauer/unseen-obstacles/simulator/mechanics/models/Stirnrad_Antriebswalzenhülle_18.0-20.0.stl

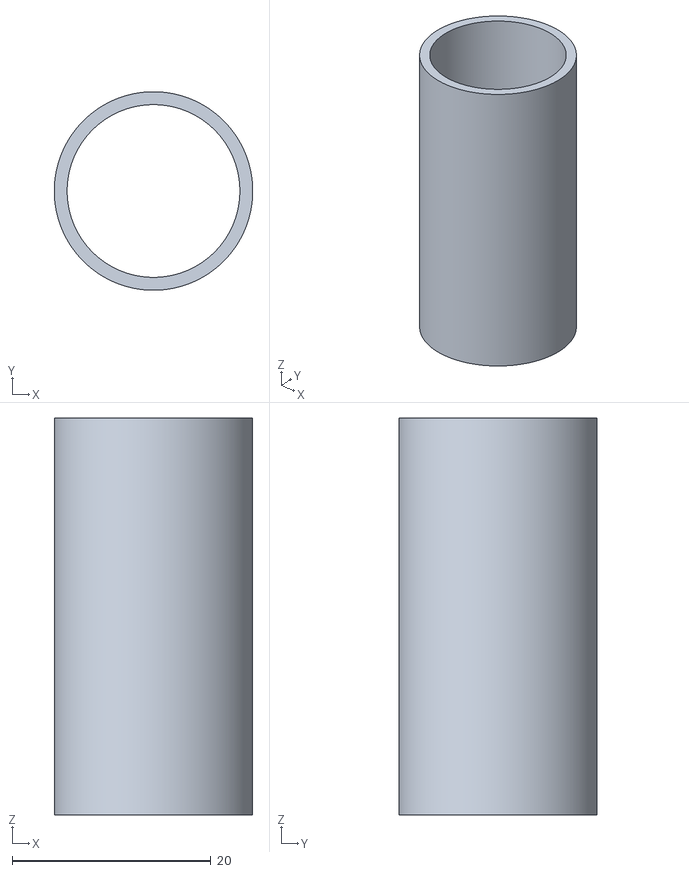
[picture p73: CAD file, 2026-02-02]
simulator/mechanics/models/Stirnrad_Antriebswalzenhülle_18.0-20.0.stl
20.0 x 20.0 x 40.0
