LSchoenbauer/unseen-obstacles/simulator/electronic/kicad/3d_models/ESP32-NodeMCU-DevKit-C/ESP32-WROOM-DEVKIT-NODEMCU-V3_narrow.step

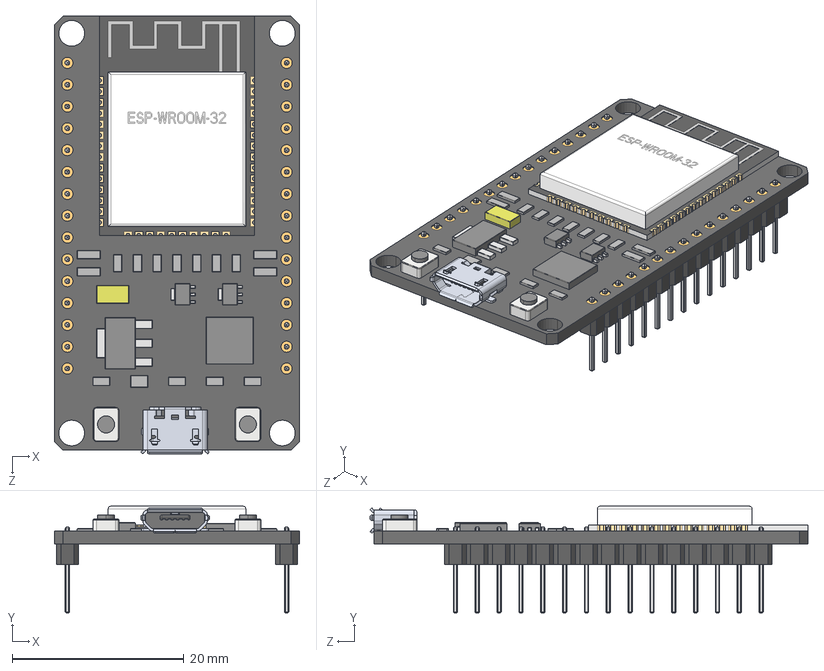
[picture p74: CAD file, 2025-07-21]
simulator/electronic/kicad/3d_models/ESP32-NodeMCU-DevKit-C/ESP32-WROOM-DEVKIT-NODEMCU-V3_narrow.step
28.5 x 12.4 x 50.9 mm
micro_usb_47346-0001
ESP-WROOM-32
6.ESP-32_Predeterminado
