LSchoenbauer/unseen-obstacles/simulator/mechanics/cad/Scherenheberwellenkupplungsadapter.FCStd

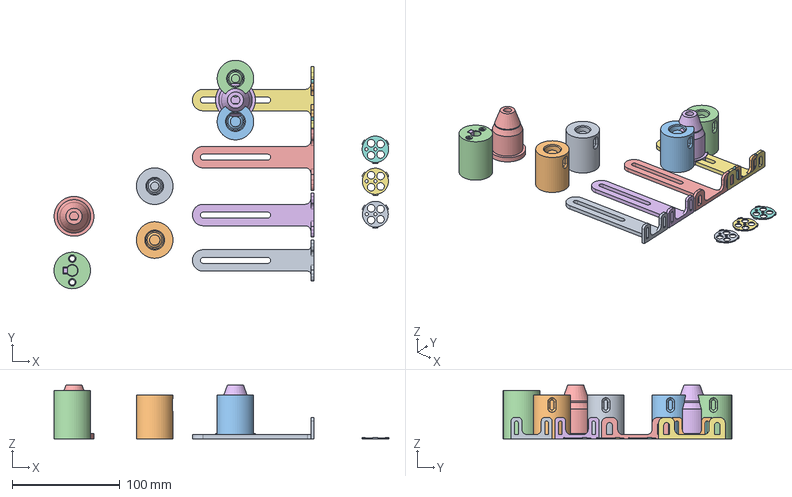
[picture p76: CAD file, 2025-11-12]
simulator/mechanics/cad/Scherenheberwellenkupplungsadapter.FCStd
311.2 x 212.3 x 50.0 mm
B-Scherenheberkupplungsadpter-8x14mm
B-Scherenheberkupplungsadpter-10x16mm
S-Scherenheberkupplungsadpter-10x16mm
S-Scherenheberkupplungsadpter-8x14mm
B-Montagewinkel NEMA23
B-Montagewinkel NEMA17
S-Montagewinkel NEMA23
S-Montagewinkel NEMA17
B-Montagewinkel NEMA17-Getriebe
S-Montagewinkel NEMA17-Getriebe
B-Scherenhebergelenksbolzen-Anreislehre_24.0
S-Scherenhebergelenksbolzen-Anreislehre
B-Scherenheberwellenmuffe-8x7.0mm
S-Scherenheberwellenmuffe-8x7.0mm
B-Scherenhebergelenksbolzen-Anreislehre_24.3
B-Scherenhebergelenksbolzen-Anreislehre_24.6
P-Scherenhebergelenksbolzen-Anreislehre_24.0
P-Scherenhebergelenksbolzen-Anreislehre_24.3
P-Scherenhebergelenksbolzen-Anreislehre_24.6
B-Scherenheberwellenkupplung-10x20mm
B-Scherenheberwellenkupplungskeil-5x4x20mm
P-Scherenheberwellenkupplungskeil-5x4x20mm
P-Scherenheberwellenkupplung-10x20mm
