LSchoenbauer/unseen-obstacles/simulator/mechanics/models/3pty/stepper/Stepper_NEMA23_300Ncm_23HS45-4204S.STEP

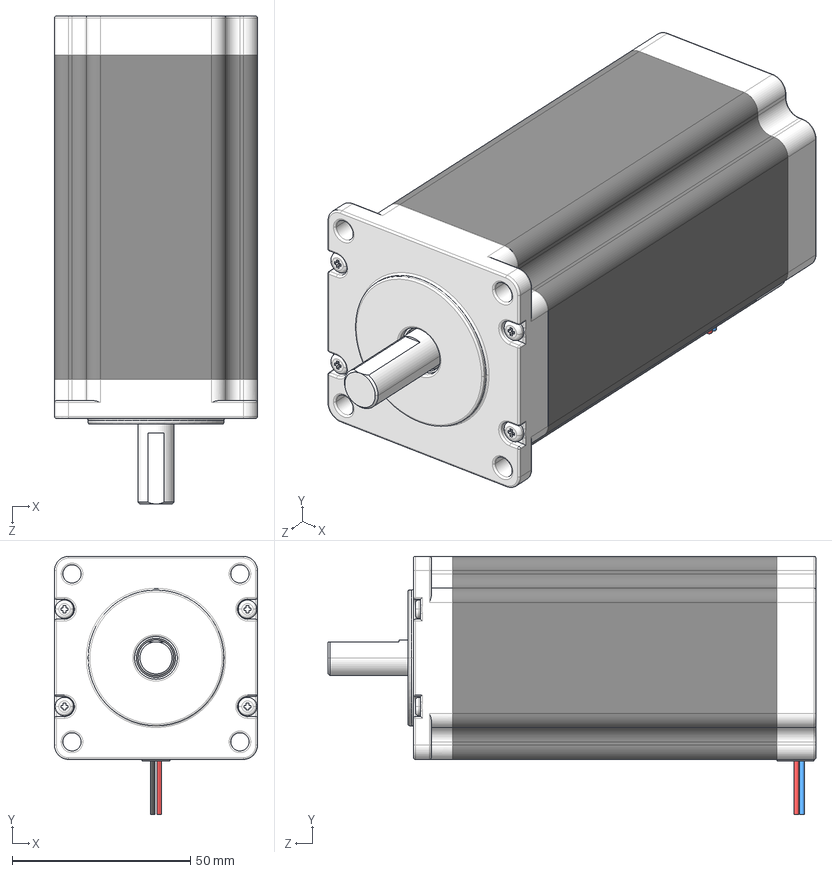
[picture p77: CAD file, 2025-10-17]
simulator/mechanics/models/3pty/stepper/Stepper_NEMA23_300Ncm_23HS45-4204S.STEP
57.0 x 72.5 x 137.0 mm
