LSchoenbauer/unseen-obstacles/simulator/mechanics/models/3pty/wheelchair/Footplate.FCStd

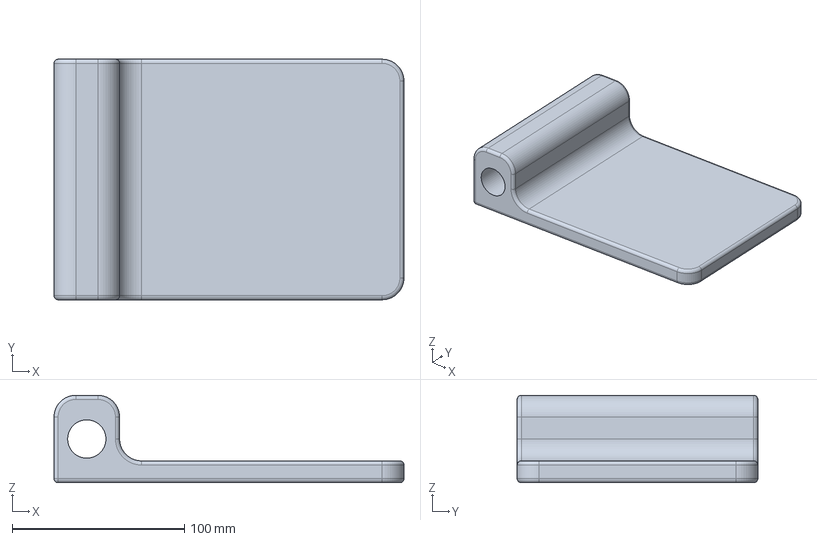
[picture p78: CAD file, 2025-07-04]
simulator/mechanics/models/3pty/wheelchair/Footplate.FCStd
203.2 x 139.7 x 50.8 mm
