LSchoenbauer/unseen-obstacles/simulator/mechanics/models/Stirnrad_Antriebswalzenfeder-NEMA17_18.0.stl

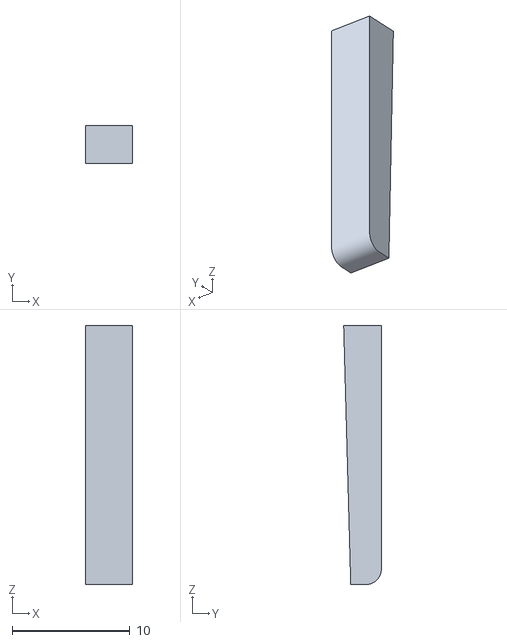
[picture p79: CAD file, 2026-02-02]
simulator/mechanics/models/Stirnrad_Antriebswalzenfeder-NEMA17_18.0.stl
4.00 x 3.20 x 22.0
