LSchoenbauer/unseen-obstacles/simulator/mechanics/cad/Heberteile.FCStd

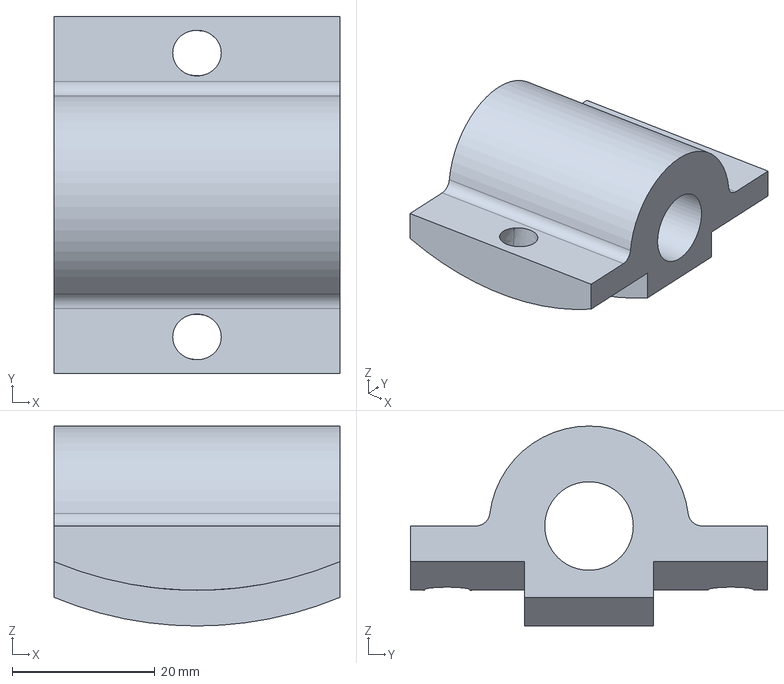
[picture p81: CAD file, 2025-11-12]
simulator/mechanics/cad/Heberteile.FCStd
40.0 x 50.0 x 28.0 mm
