LSchoenbauer/unseen-obstacles/simulator/mechanics/models/3pty/stepper/Stepper_NEMA17_5to1-Planetary-Gearbox_17HS15-1584S-MG5.STEP

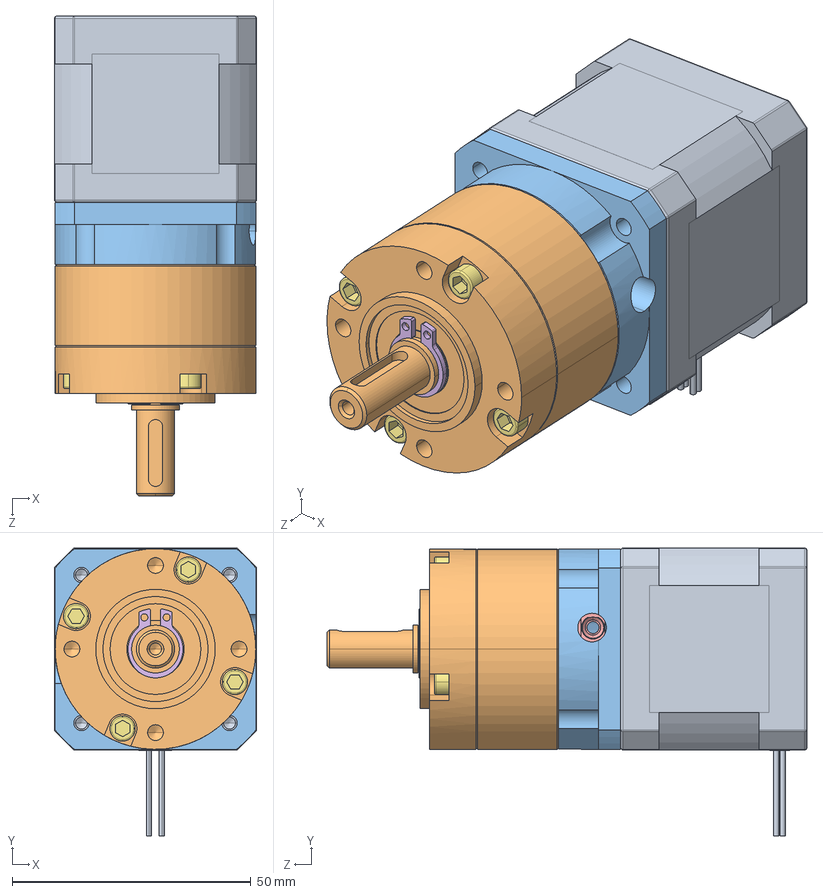
[picture p82: CAD file, 2025-07-04]
simulator/mechanics/models/3pty/stepper/Stepper_NEMA17_5to1-Planetary-Gearbox_17HS15-1584S-MG5.STEP
42.3 x 60.3 x 100.5 mm
17HS15-1584S
MG17 output
42GN Input flange
Input shaft
Φ10Circlip
M3 hexagon socket screw head x 8
