LSchoenbauer/unseen-obstacles/simulator/mechanics/models/3pty/wheelchair/Rear wheel.FCStd

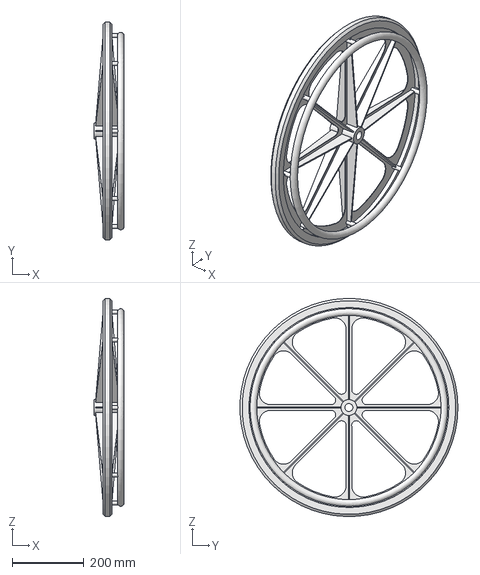
[picture p83: CAD file, 2025-07-04]
simulator/mechanics/models/3pty/wheelchair/Rear wheel.FCStd
84.7 x 609.2 x 609.4 mm
