LSchoenbauer/unseen-obstacles/simulator/mechanics/cad/Mover-Stepper-Mounts_r1.1.dxf

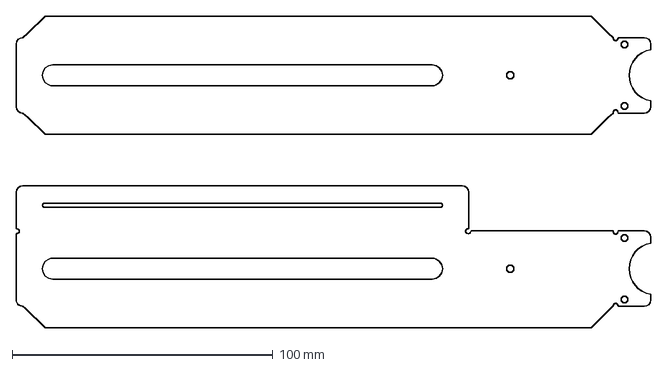
[picture p85: CAD file, 2025-10-27]
simulator/mechanics/cad/Mover-Stepper-Mounts_r1.1.dxf
243.3 x 119.6 mm
