LSchoenbauer/unseen-obstacles/simulator/mechanics/models/3pty/stepper/Stepper_NEMA23_240Ncm_23HS41-1804S.STEP

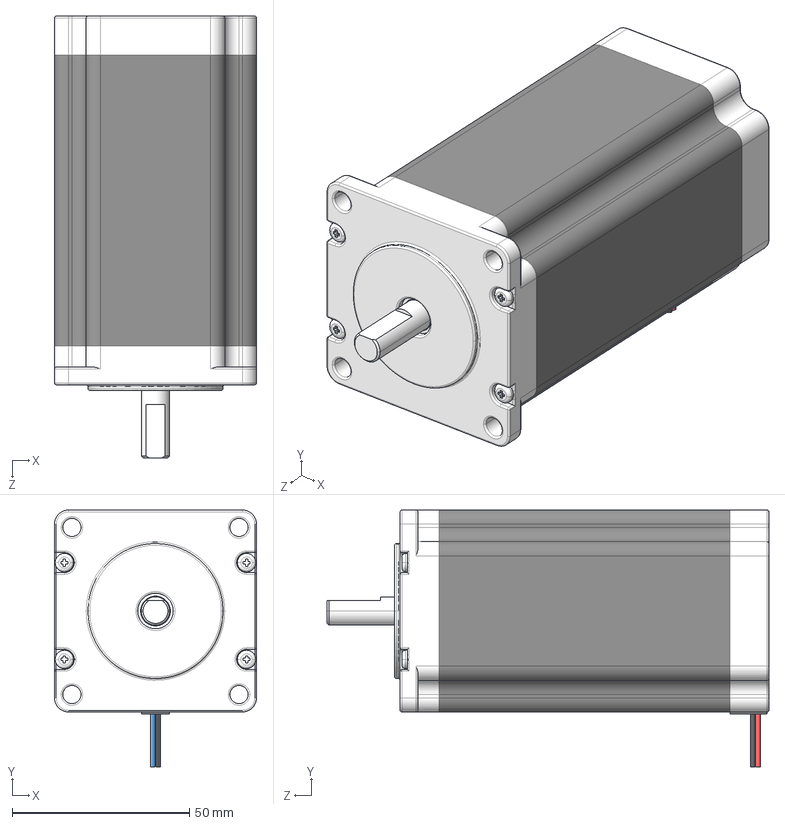
[picture p86: CAD file, 2025-07-04]
simulator/mechanics/models/3pty/stepper/Stepper_NEMA23_240Ncm_23HS41-1804S.STEP
57.0 x 72.5 x 124.6 mm
