LSchoenbauer/unseen-obstacles/simulator/mechanics/cad/Mover.FCStd

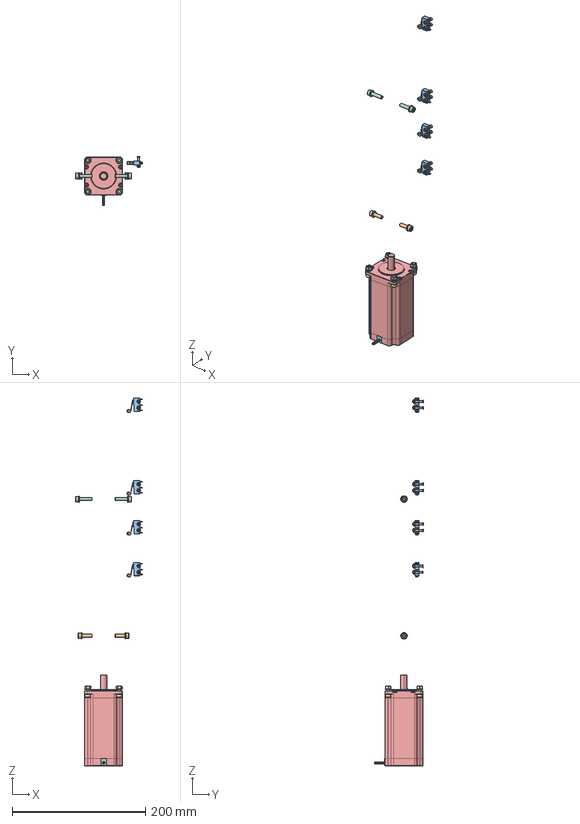
[picture p88: CAD file, 2025-10-27]
simulator/mechanics/cad/Mover.FCStd
100.8 x 73.0 x 553.1 mm
23HS45-4204S
23HS45-4204S001
23HS45-4204S002
23HS45-4204S003
23HS45-4204S004
23HS45-4204S005
M5x12-Schraube x 4
M5-Scheibe x 8
M5-Mutter x 4
M5x16-Schraube x 2
Microswitch 20mm x 4
Microswitch 20mm001 x 4
Microswitch 20mm002 x 4
Microswitch 20mm003 x 4
Microswitch 20mm004 x 4
Microswitch 20mm005 x 4
Microswitch 20mm006 x 4
M2.5x16-Schraube x 8
M2.5-Mutter x 8
M5x20-Schraube x 2
