LSchoenbauer/unseen-obstacles/simulator/mechanics/models/3pty/stepper/Stepper_NEMA17_55Ncm_17HE19-2004S.STEP

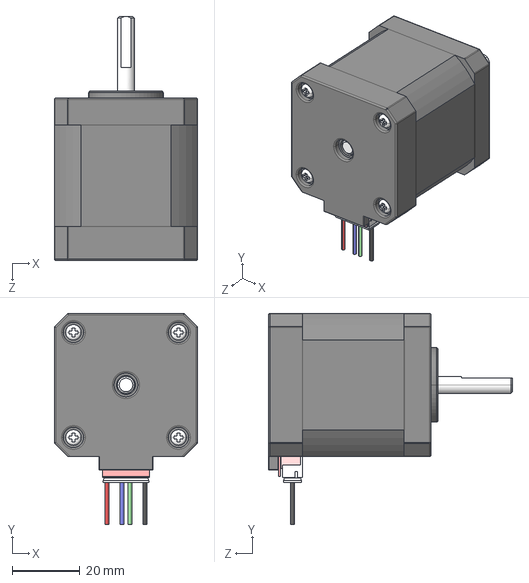
[picture p89: CAD file, 2025-07-04]
simulator/mechanics/models/3pty/stepper/Stepper_NEMA17_55Ncm_17HE19-2004S.STEP
42.3 x 62.4 x 72.0 mm
