LSchoenbauer/unseen-obstacles/simulator/mechanics/models/3pty/wheelchair/Side panel.FCStd

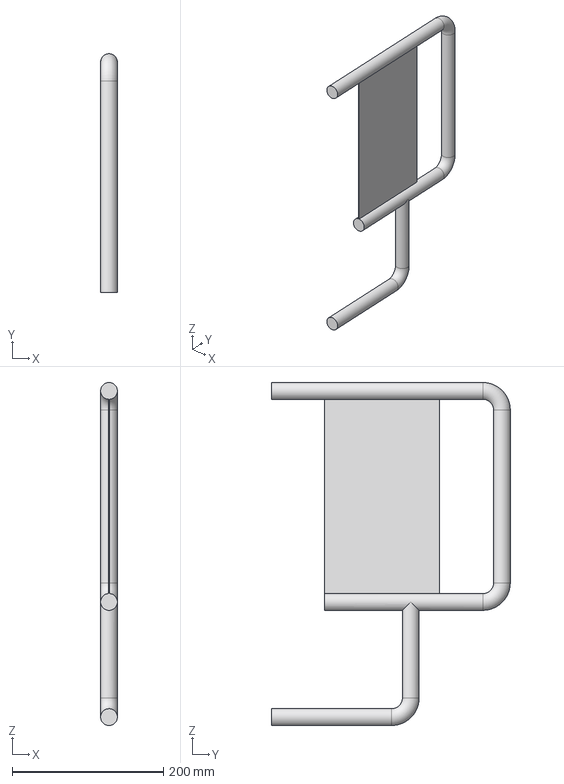
[picture p90: CAD file, 2025-07-04]
simulator/mechanics/models/3pty/wheelchair/Side panel.FCStd
22.2 x 315.9 x 454.0 mm
