LSchoenbauer/unseen-obstacles/simulator/mechanics/models/PowerSupply_Bracket-High_LED-Bottom.stl

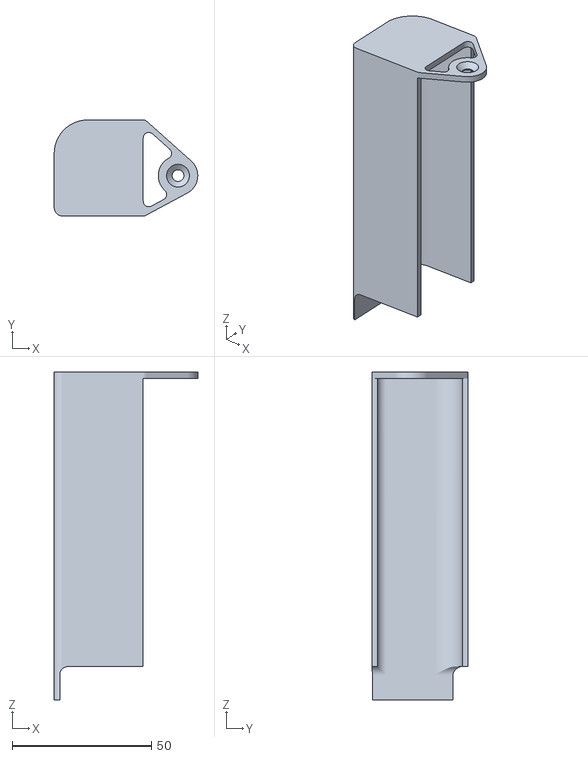
[picture p91: CAD file, 2025-11-19]
simulator/mechanics/models/PowerSupply_Bracket-High_LED-Bottom.stl
51.6 x 34.5 x 117.9
