LSchoenbauer/unseen-obstacles/simulator/mechanics/models/3pty/stepper/Stepper_Driver_DM332T.STEP

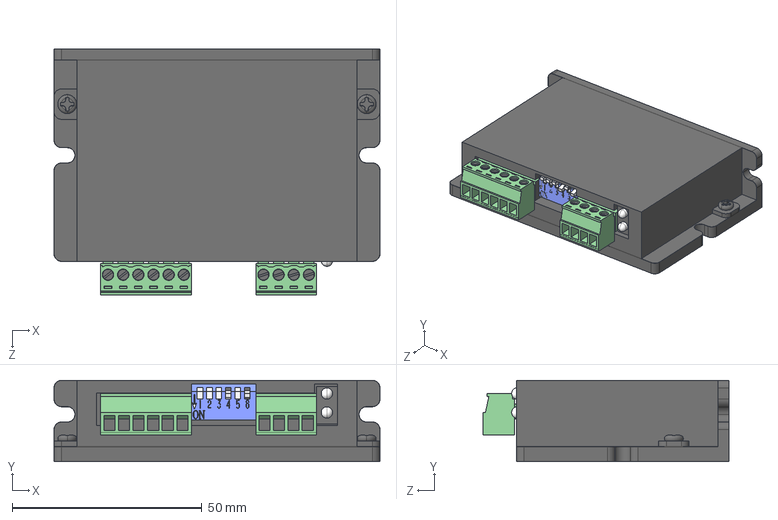
[picture p93: CAD file, 2025-07-04]
simulator/mechanics/models/3pty/stepper/Stepper_Driver_DM332T.STEP
86.0 x 21.5 x 64.8 mm
