LSchoenbauer/unseen-obstacles/simulator/mechanics/models/3pty/wheelchair/Frame.FCStd

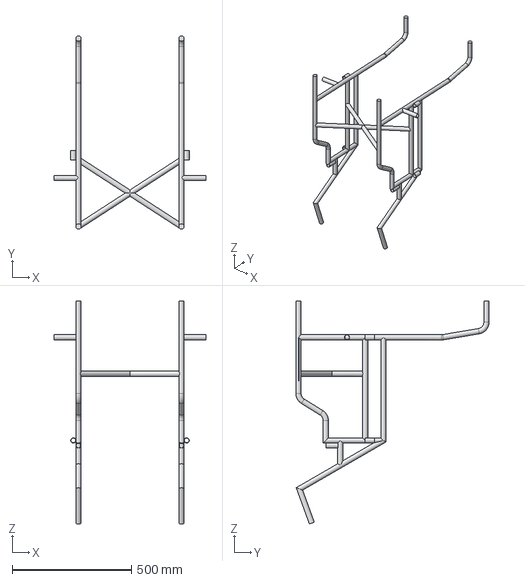
[picture p94: CAD file, 2025-07-04]
simulator/mechanics/models/3pty/wheelchair/Frame.FCStd
635.0 x 809.6 x 934.4 mm
