LSchoenbauer/unseen-obstacles/simulator/mechanics/models/PowerSupply_MountingBrace-High.stl

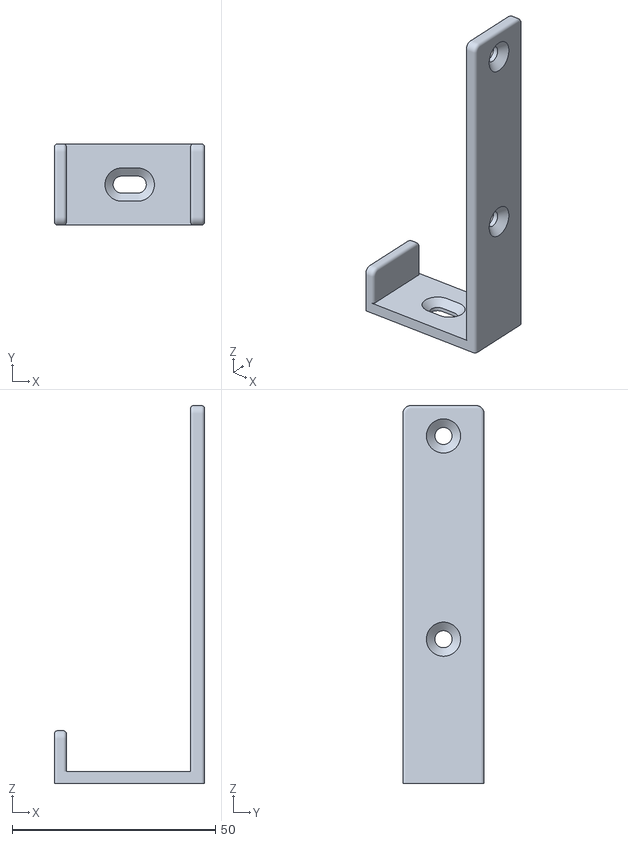
[picture p95: CAD file, 2025-11-19]
simulator/mechanics/models/PowerSupply_MountingBrace-High.stl
37.0 x 20.0 x 93.0
