LSchoenbauer/unseen-obstacles/simulator/mechanics/models/3pty/stepper/Stepper_Driver_DM542T_V4.0.STEP

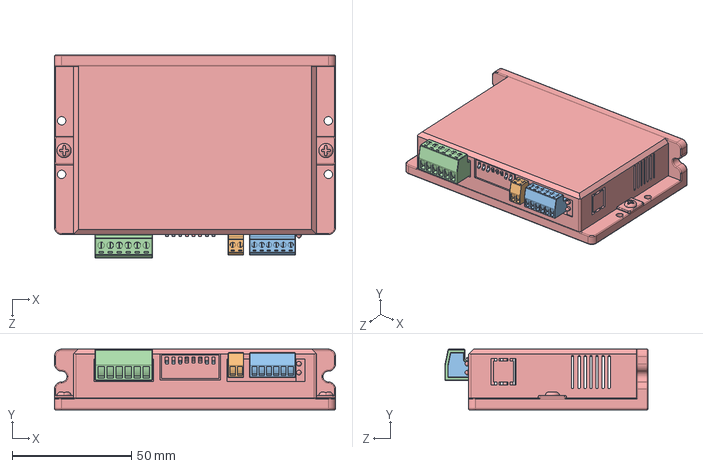
[picture p97: CAD file, 2025-07-04]
simulator/mechanics/models/3pty/stepper/Stepper_Driver_DM542T_V4.0.STEP
118.0 x 25.5 x 85.4 mm
