LSchoenbauer/unseen-obstacles/simulator/mechanics/models/3pty/wheelchair/Caster fork.FCStd

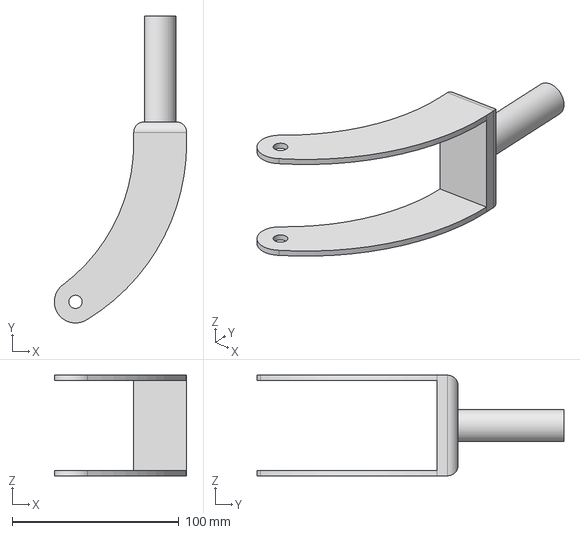
[picture p98: CAD file, 2025-07-04]
simulator/mechanics/models/3pty/wheelchair/Caster fork.FCStd
79.4 x 184.1 x 60.3 mm
