LSchoenbauer/unseen-obstacles/simulator/mechanics/models/3pty/wheelchair/Pin.FCStd

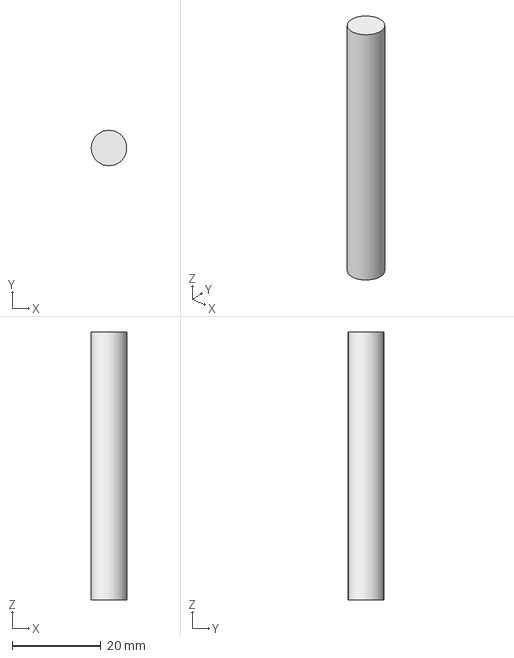
[picture p100: CAD file, 2025-07-04]
simulator/mechanics/models/3pty/wheelchair/Pin.FCStd
7.99 x 8.00 x 60.3 mm
