LSchoenbauer/unseen-obstacles/simulator/mechanics/models/PowerSupply_Mounting_Angle.stl

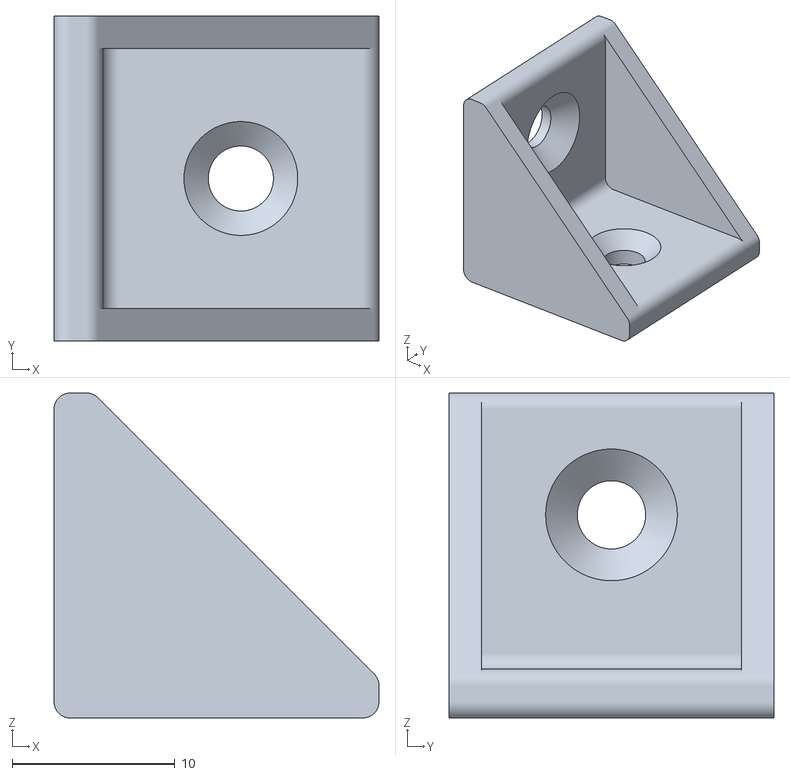
[picture p101: CAD file, 2025-11-18]
simulator/mechanics/models/PowerSupply_Mounting_Angle.stl
20.0 x 20.0 x 20.0
