LSchoenbauer/unseen-obstacles/simulator/mechanics/models/3pty/wheelchair/Seat.FCStd

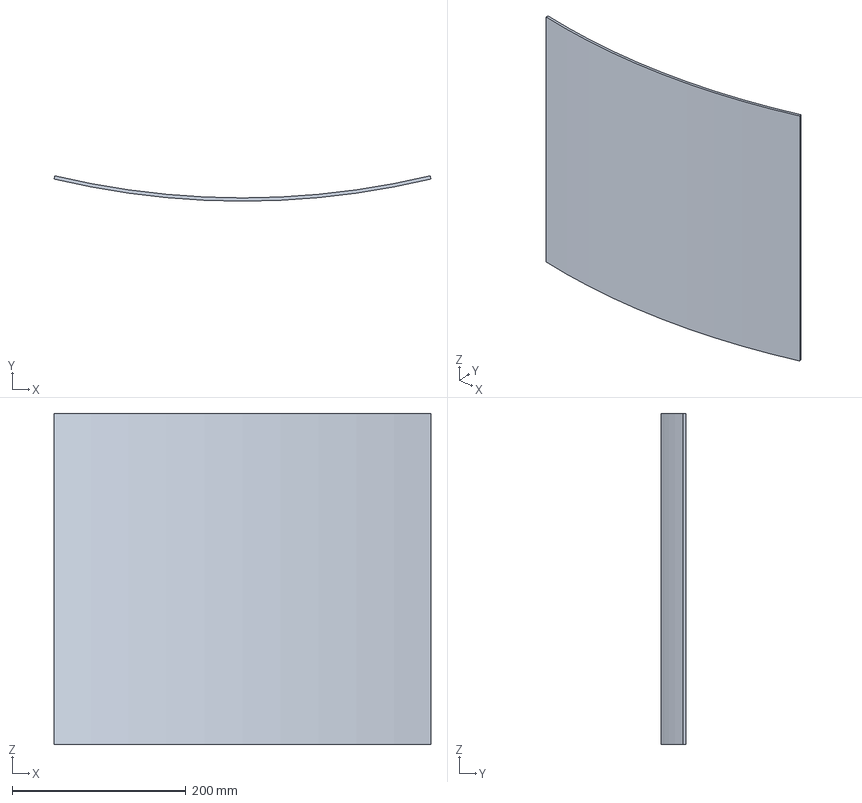
[picture p103: CAD file, 2025-07-04]
simulator/mechanics/models/3pty/wheelchair/Seat.FCStd
433.6 x 29.2 x 381.0 mm
