LSchoenbauer/unseen-obstacles/simulator/mechanics/models/PowerSupply_Mounting_Angle_for_Bracket.stl

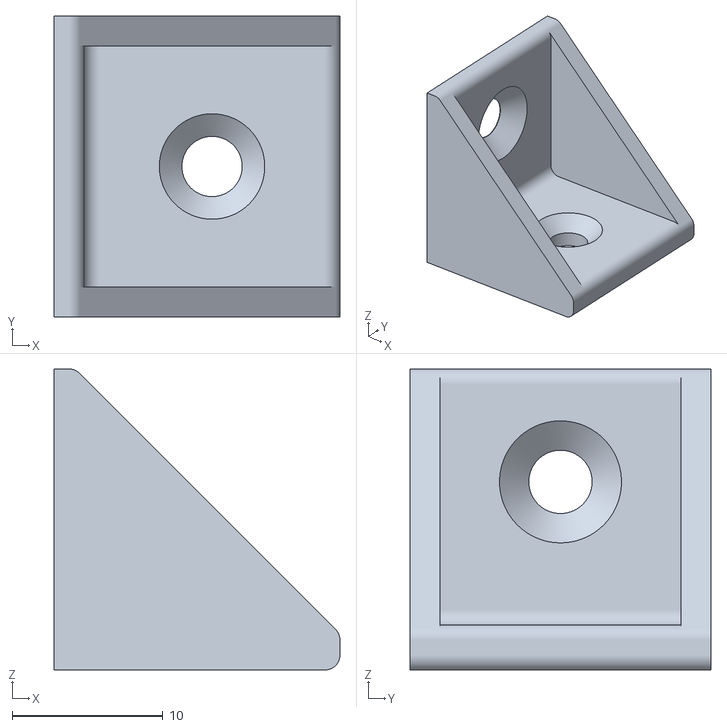
[picture p104: CAD file, 2025-11-18]
simulator/mechanics/models/PowerSupply_Mounting_Angle_for_Bracket.stl
19.0 x 20.0 x 20.0
