LSchoenbauer/unseen-obstacles/simulator/mechanics/models/3pty/wheelchair/Caster wheel.FCStd

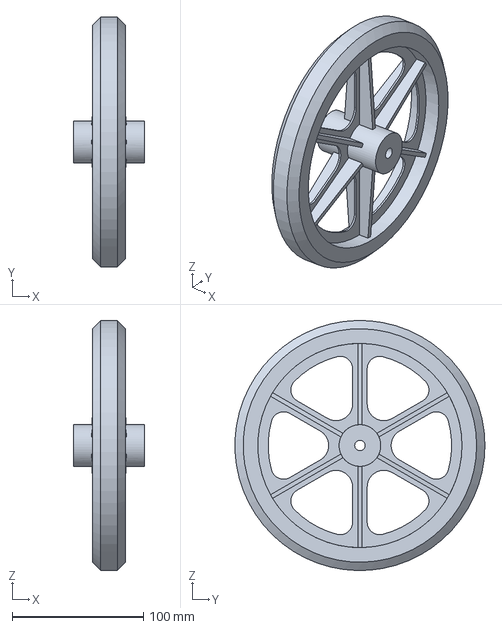
[picture p106: CAD file, 2025-07-04]
simulator/mechanics/models/3pty/wheelchair/Caster wheel.FCStd
54.0 x 190.4 x 190.4 mm
