LSchoenbauer/unseen-obstacles/simulator/mechanics/models/PowerSupply_Bracket.stl

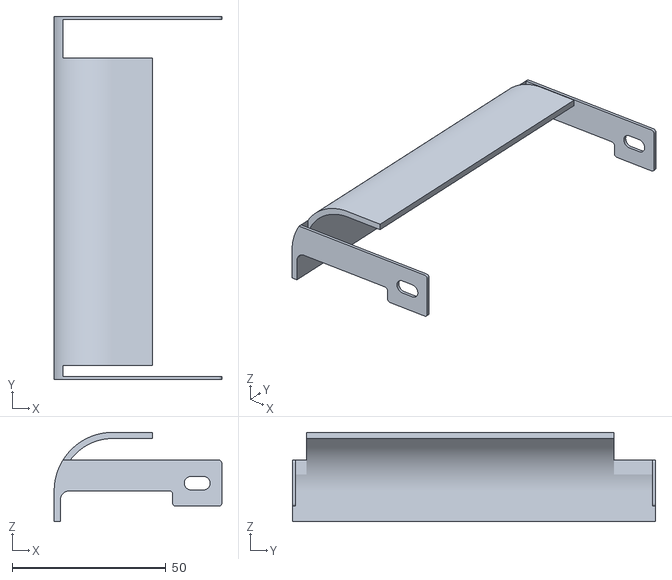
[picture p107: CAD file, 2025-11-18]
simulator/mechanics/models/PowerSupply_Bracket.stl
54.5 x 118.0 x 29.0
