LSchoenbauer/unseen-obstacles/simulator/electronic/kicad/3d_models/jst-xh-2-50mm-genuine-connector-set/JST - XH - Thru - 04Pin - 2.5mm (Genuine).stp

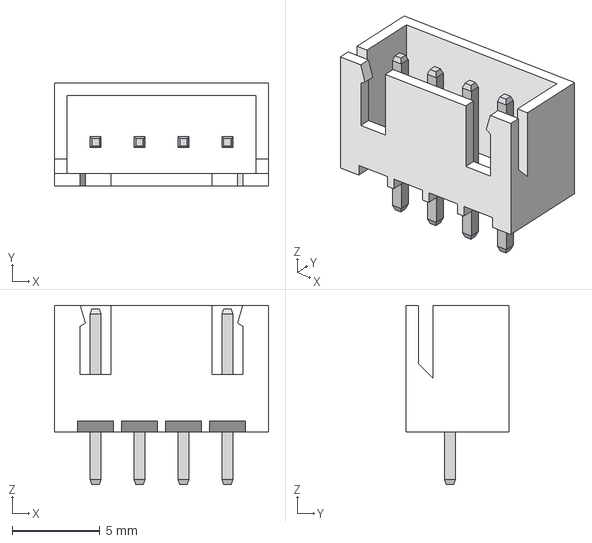
[picture p108: CAD file, 2025-07-21]
simulator/electronic/kicad/3d_models/jst-xh-2-50mm-genuine-connector-set/JST - XH - Thru - 04Pin - 2.5mm (Genuine).stp
12.2 x 5.84 x 10.2 mm
