LSchoenbauer/unseen-obstacles/simulator/mechanics/models/3pty/wheelchair/Armrest.FCStd

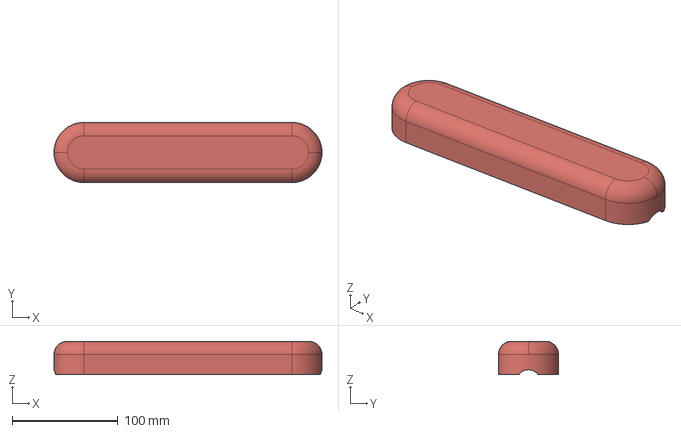
[picture p109: CAD file, 2025-07-04]
simulator/mechanics/models/3pty/wheelchair/Armrest.FCStd
254.0 x 57.2 x 31.8 mm
