LSchoenbauer/unseen-obstacles/simulator/mechanics/models/Scherenhebergelenksbolzen-Anreislehre_24.0.stl

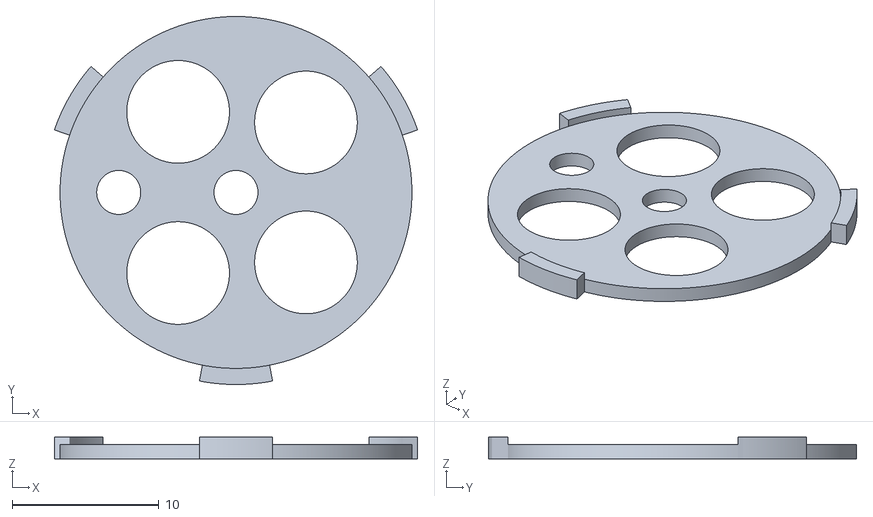
[picture p111: CAD file, 2025-11-10]
simulator/mechanics/models/Scherenhebergelenksbolzen-Anreislehre_24.0.stl
24.8 x 25.1 x 1.50
