LSchoenbauer/unseen-obstacles/simulator/mechanics/models/Scherenhebergelenksbolzen-Anreislehre_24.3.stl

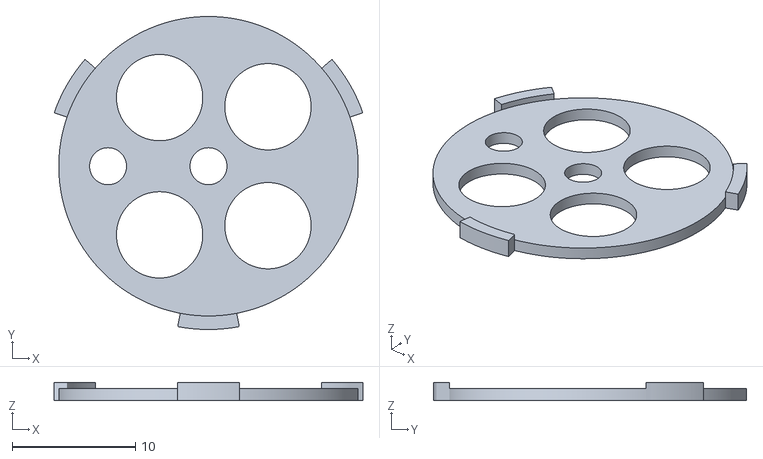
[picture p113: CAD file, 2025-11-10]
simulator/mechanics/models/Scherenhebergelenksbolzen-Anreislehre_24.3.stl
25.0 x 25.4 x 1.50
