LSchoenbauer/unseen-obstacles/simulator/mechanics/models/Scherenhebergelenksbolzen-Anreislehre_24.6.stl

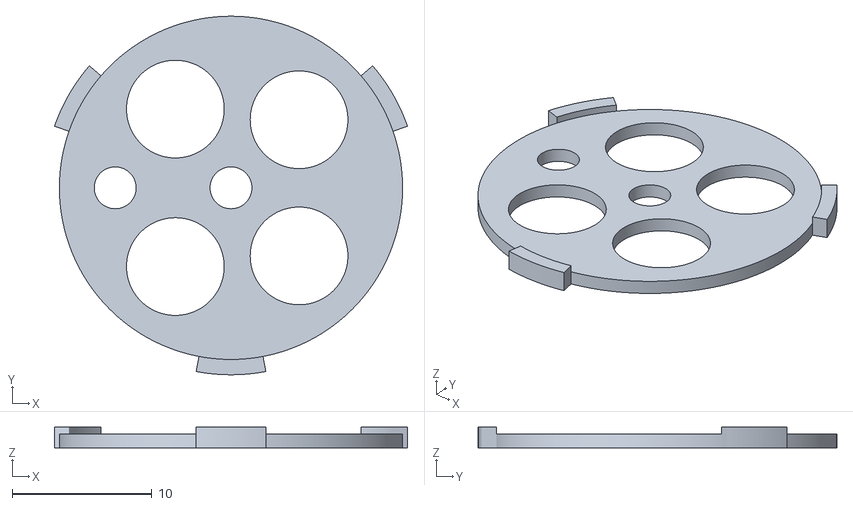
[picture p115: CAD file, 2025-11-10]
simulator/mechanics/models/Scherenhebergelenksbolzen-Anreislehre_24.6.stl
25.3 x 25.7 x 1.50
