LSchoenbauer/unseen-obstacles/simulator/electronic/kicad/3d_models/jst-xh-2-50mm-genuine-connector-set/JST - XH - Thru - 19Pin - 2.5mm (Genuine).stp

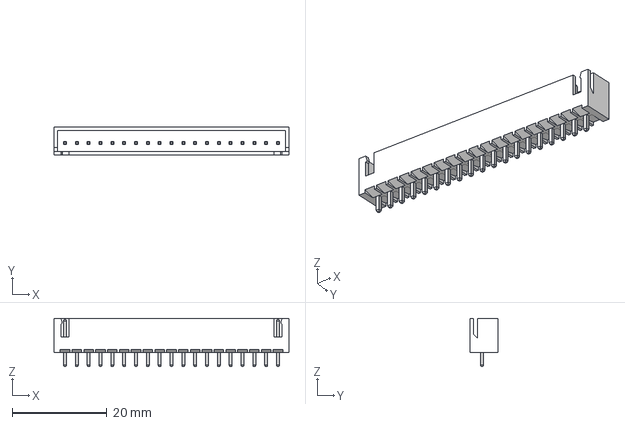
[picture p116: CAD file, 2025-07-21]
simulator/electronic/kicad/3d_models/jst-xh-2-50mm-genuine-connector-set/JST - XH - Thru - 19Pin - 2.5mm (Genuine).stp
49.7 x 5.84 x 10.2 mm
