LSchoenbauer/unseen-obstacles/simulator/mechanics/models/Scherenheberwellenkupplungskeil-5x4x20mm.stl

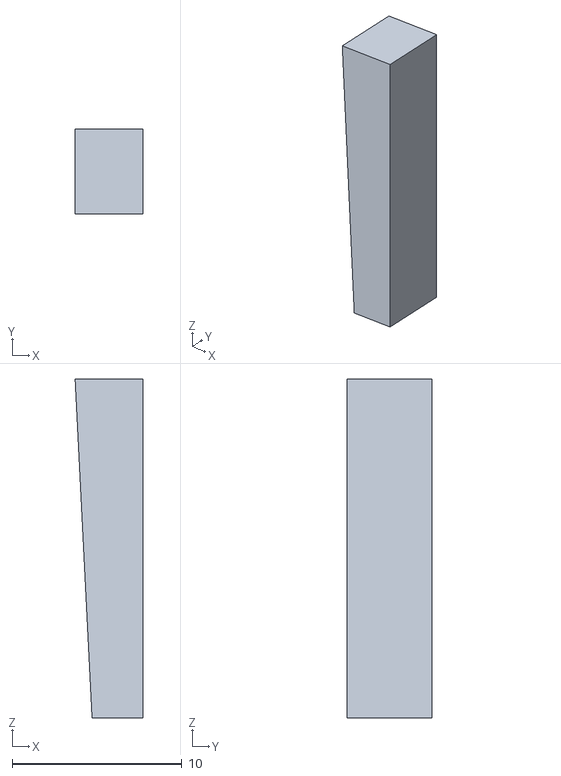
[picture p117: CAD file, 2025-11-10]
simulator/mechanics/models/Scherenheberwellenkupplungskeil-5x4x20mm.stl
4.00 x 5.00 x 20.0
