LSchoenbauer/unseen-obstacles/simulator/mechanics/models/Mover-Stepper-Slide_Bearing.stl

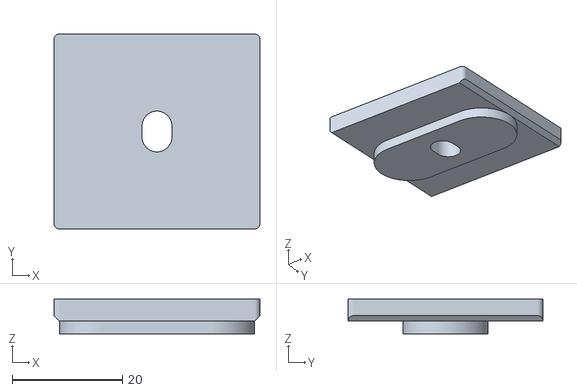
[picture p121: CAD file, 2025-10-27]
simulator/mechanics/models/Mover-Stepper-Slide_Bearing.stl
37.4 x 35.4 x 6.30
