LSchoenbauer/unseen-obstacles/simulator/mechanics/models/Mover-Stepper-Slide_Bearing_w_Indicator.stl

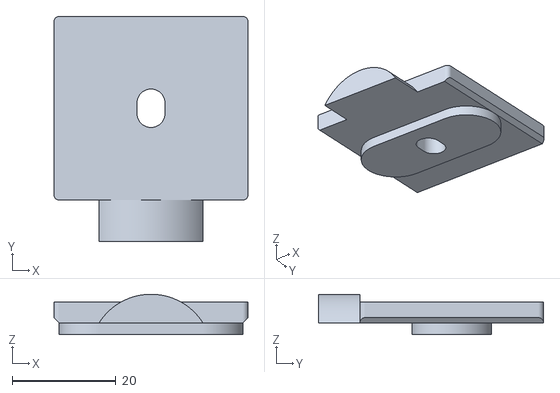
[picture p122: CAD file, 2025-10-27]
simulator/mechanics/models/Mover-Stepper-Slide_Bearing_w_Indicator.stl
37.4 x 43.4 x 7.80
