LSchoenbauer/unseen-obstacles/simulator/mechanics/models/Mover-Stepper-Switch_Bracket.stl

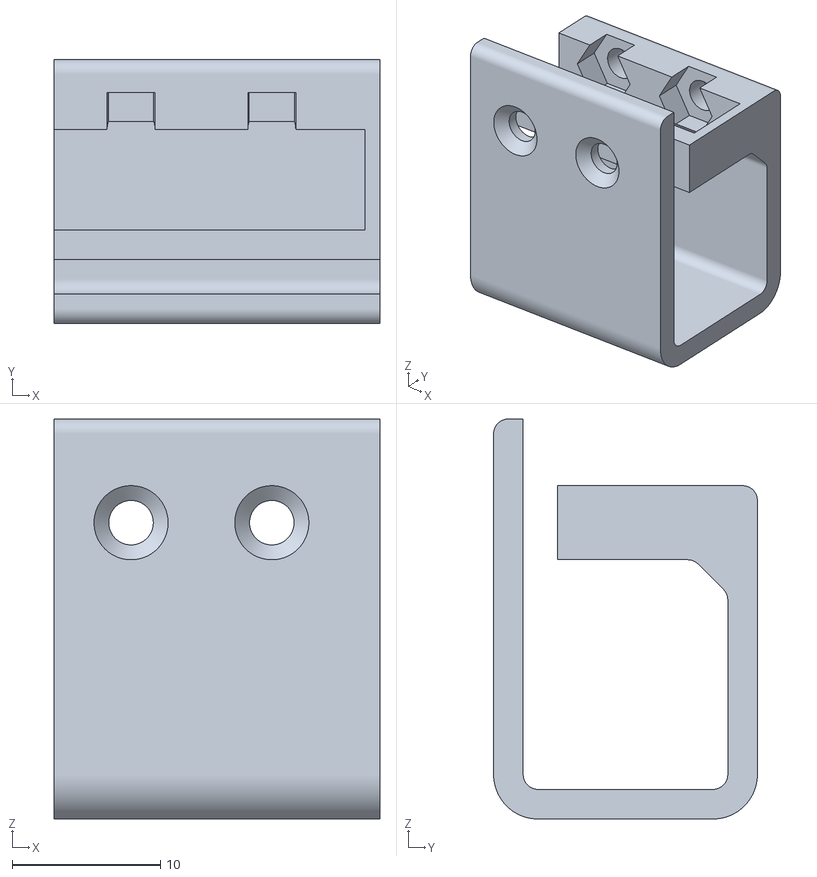
[picture p123: CAD file, 2025-10-27]
simulator/mechanics/models/Mover-Stepper-Switch_Bracket.stl
22.0 x 17.8 x 27.0
