LSchoenbauer/unseen-obstacles/simulator/mechanics/models/Stepperwippe.stl

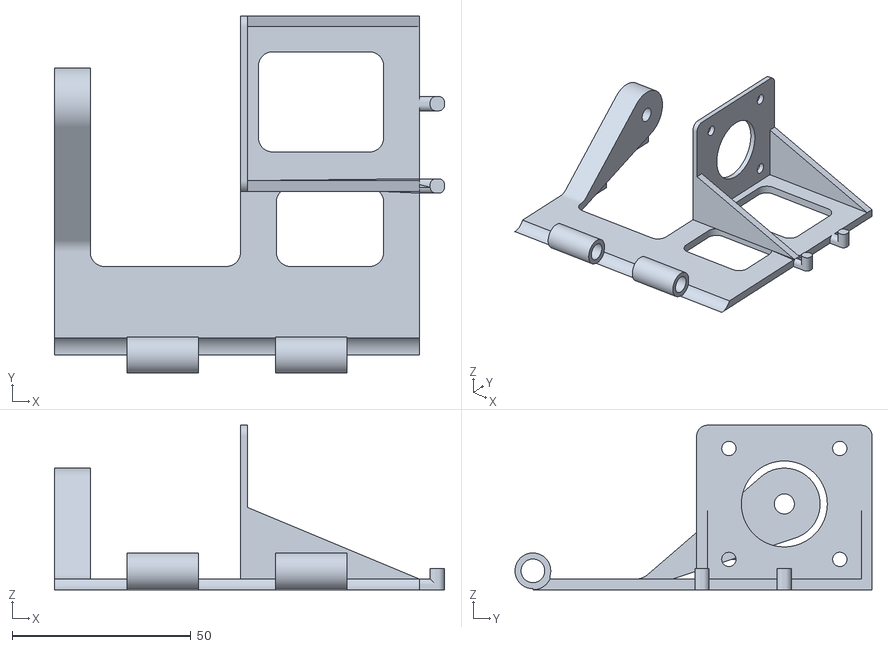
[picture p124: CAD file, 2025-07-04]
simulator/mechanics/models/Stepperwippe.stl
109.0 x 99.8 x 46.0
