LSchoenbauer/unseen-obstacles/simulator/mechanics/models/Stirnrad_Antriebswalze-NEMA17.stl

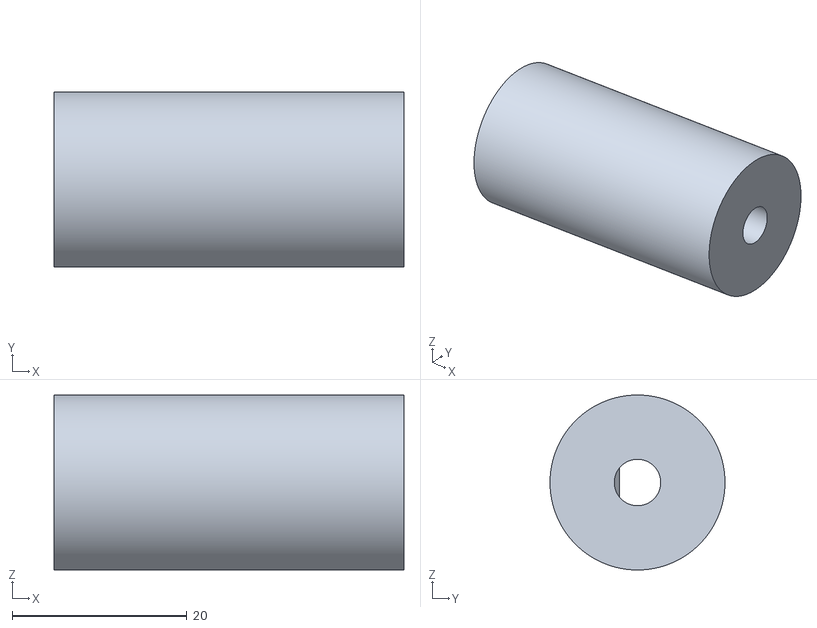
[picture p125: CAD file, 2025-07-04]
simulator/mechanics/models/Stirnrad_Antriebswalze-NEMA17.stl
40.0 x 20.0 x 20.0
