LSchoenbauer/unseen-obstacles/simulator/mechanics/models/Radlagerbasis.stl

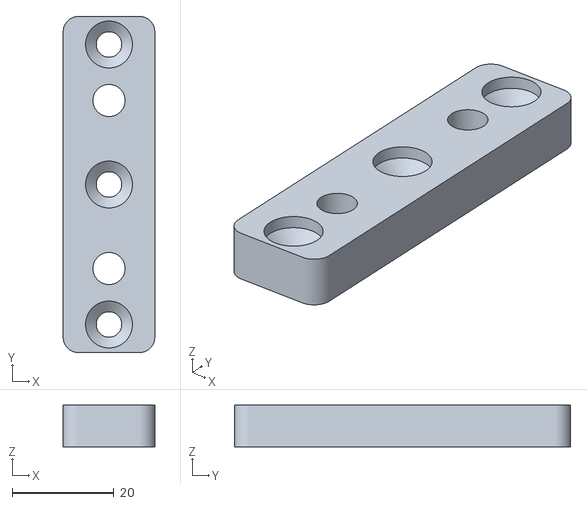
[picture p126: CAD file, 2025-07-04]
simulator/mechanics/models/Radlagerbasis.stl
18.0 x 66.0 x 8.20
