LSchoenbauer/unseen-obstacles/(list of files, cad)

Other CAD files:
simulator/electronic/kicad/footprints/SMD_LED_Everlight/LED_SMD_RGB_1616_RGB_EAST1616RGBA0.igs
simulator/mechanics/models/PowerSupply_Bracket-High_LED-Top.stl
simulator/mechanics/models/3pty/stepper/Stepper_NEMA23_300Ncm_23HS45-3504S.STEP
simulator/mechanics/models/Mover-Stepper-ChairBearing_rear.stl
simulator/mechanics/models/Mover-Stepper-Mount_Washer.stl
simulator/mechanics/models/Mover-Stepper-Slide_Bearing_Washer.stl
simulator/mechanics/models/Screwextender_M4_2mm.stl
simulator/mechanics/models/Stirnrad_Antriebswalze-NEMA17_18.0_Nut.stl
