LSchoenbauer/unseen-obstacles/simulator/mechanics/cad/Mover-Stepper-Mounts_r1.1_Construction.pdf

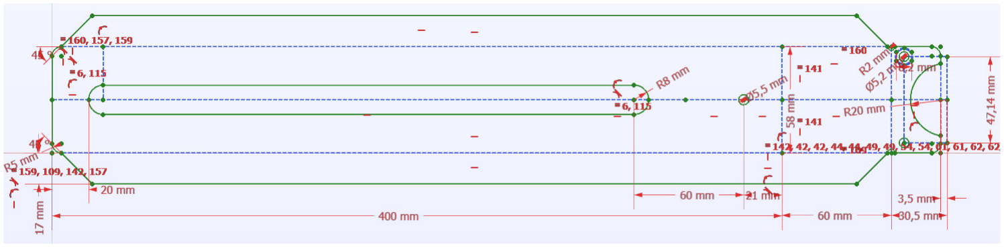
[picture p127: figure]

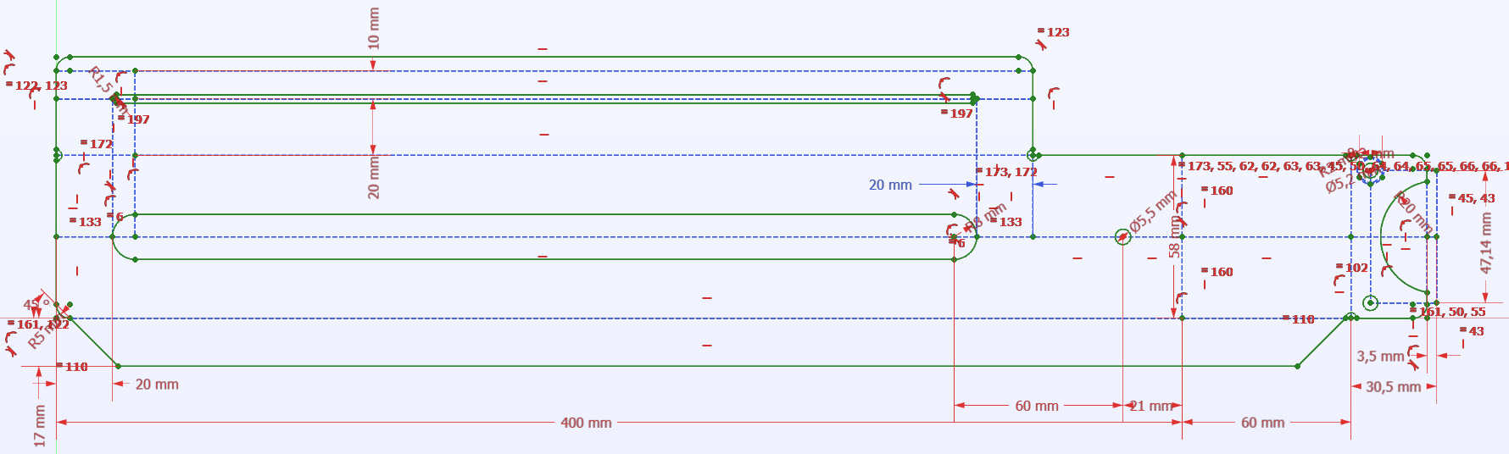
[picture p128: figure]
