LSchoenbauer/unseen-obstacles/simulator/mechanics/cad/Mover_Engine_Assembly.png

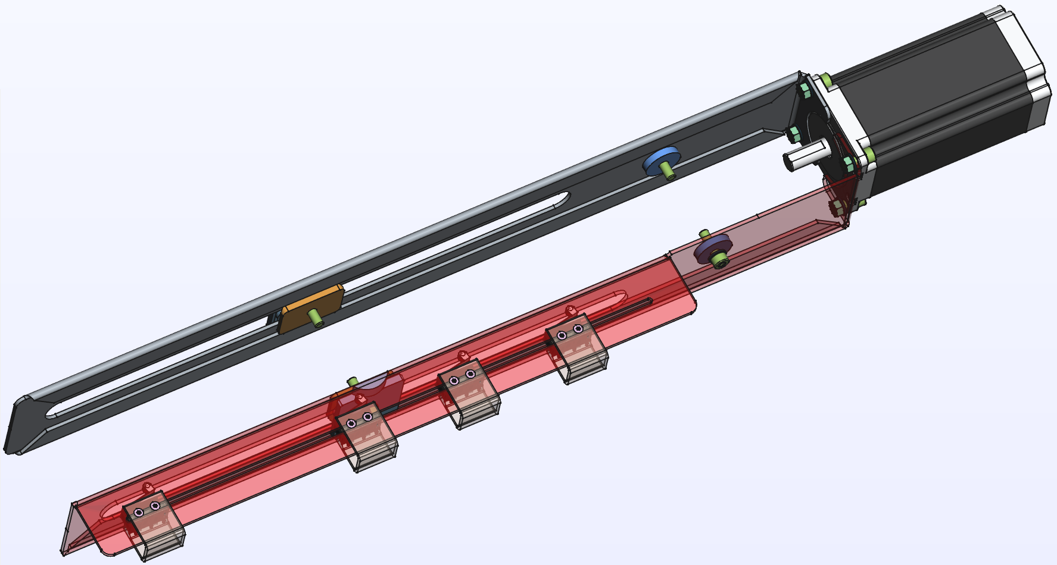
simulator/mechanics/cad/Mover_Engine_Assembly.png
