LSchoenbauer/unseen-obstacles/simulator/electronic/measurements/01_V-Pulse_Direction-Transistion__SampleDriver_BB_100nF-PinCo.png

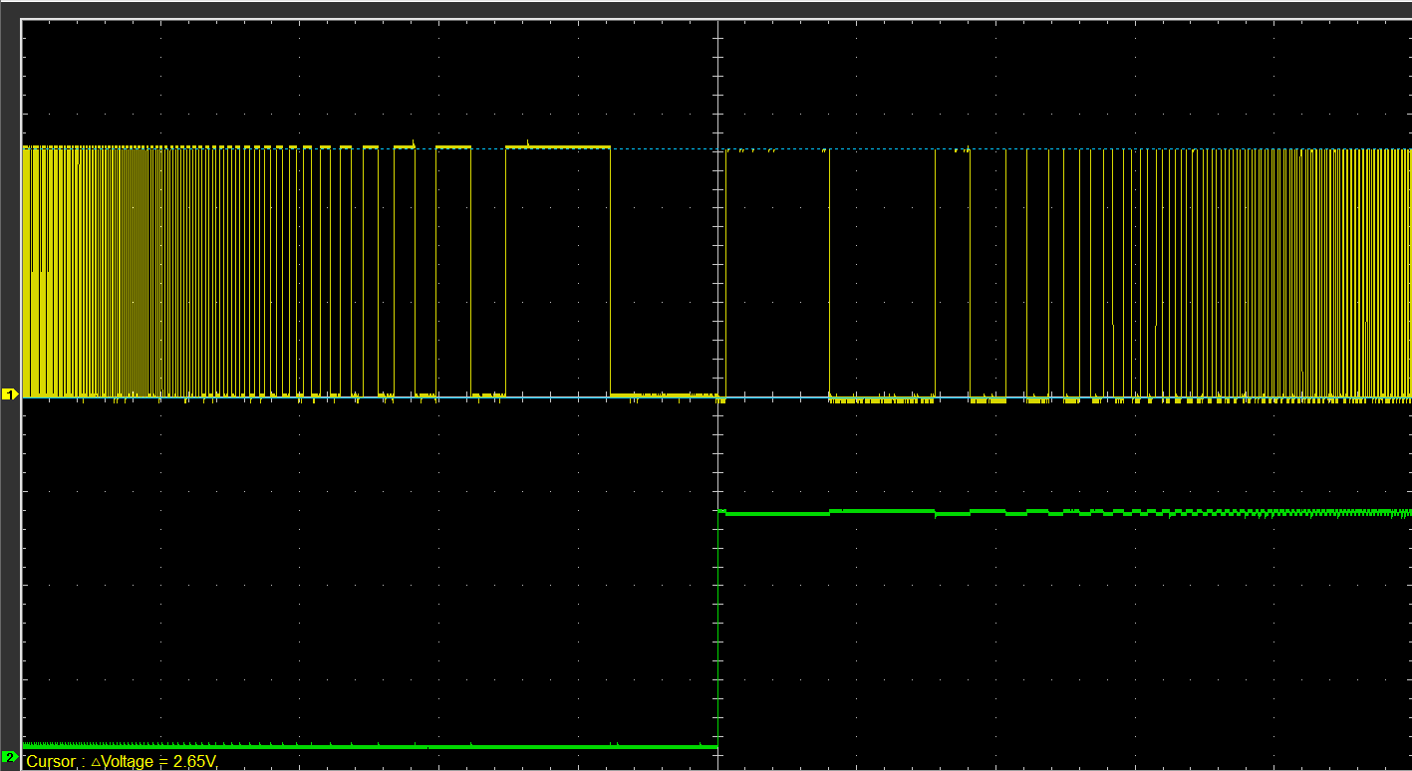
simulator/electronic/measurements/01_V-Pulse_Direction-Transistion__SampleDriver_BB_100nF-PinCo.png
