LSchoenbauer/unseen-obstacles/simulator/electronic/measurements/03_Delay_Direction-Pulse__SampleDriver_BB_100nF-PinCo.png

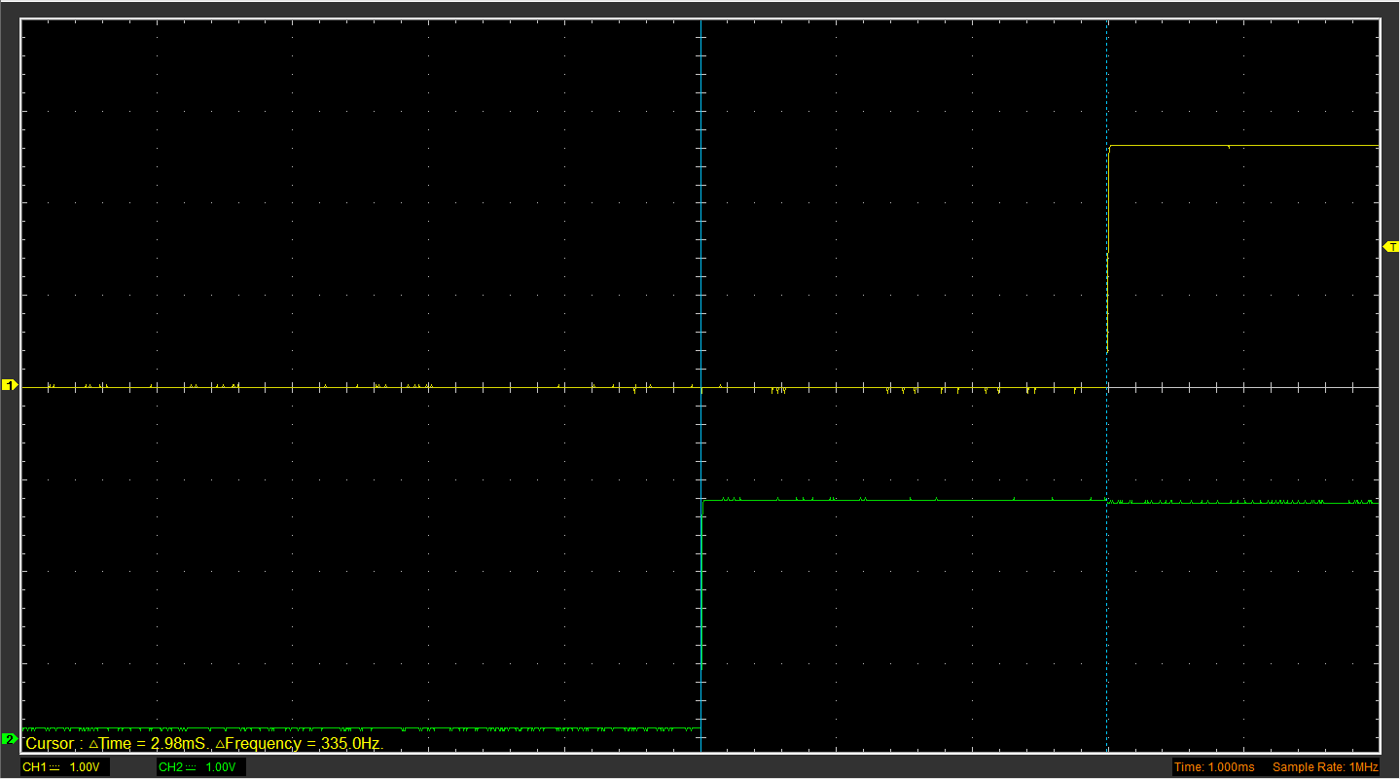
simulator/electronic/measurements/03_Delay_Direction-Pulse__SampleDriver_BB_100nF-PinCo.png
