LSchoenbauer/unseen-obstacles/simulator/electronic/measurements/04_F-Pulse-at-195rpm_2604Hz_384us__SampleDriver_BB_100nF-PinCo.png

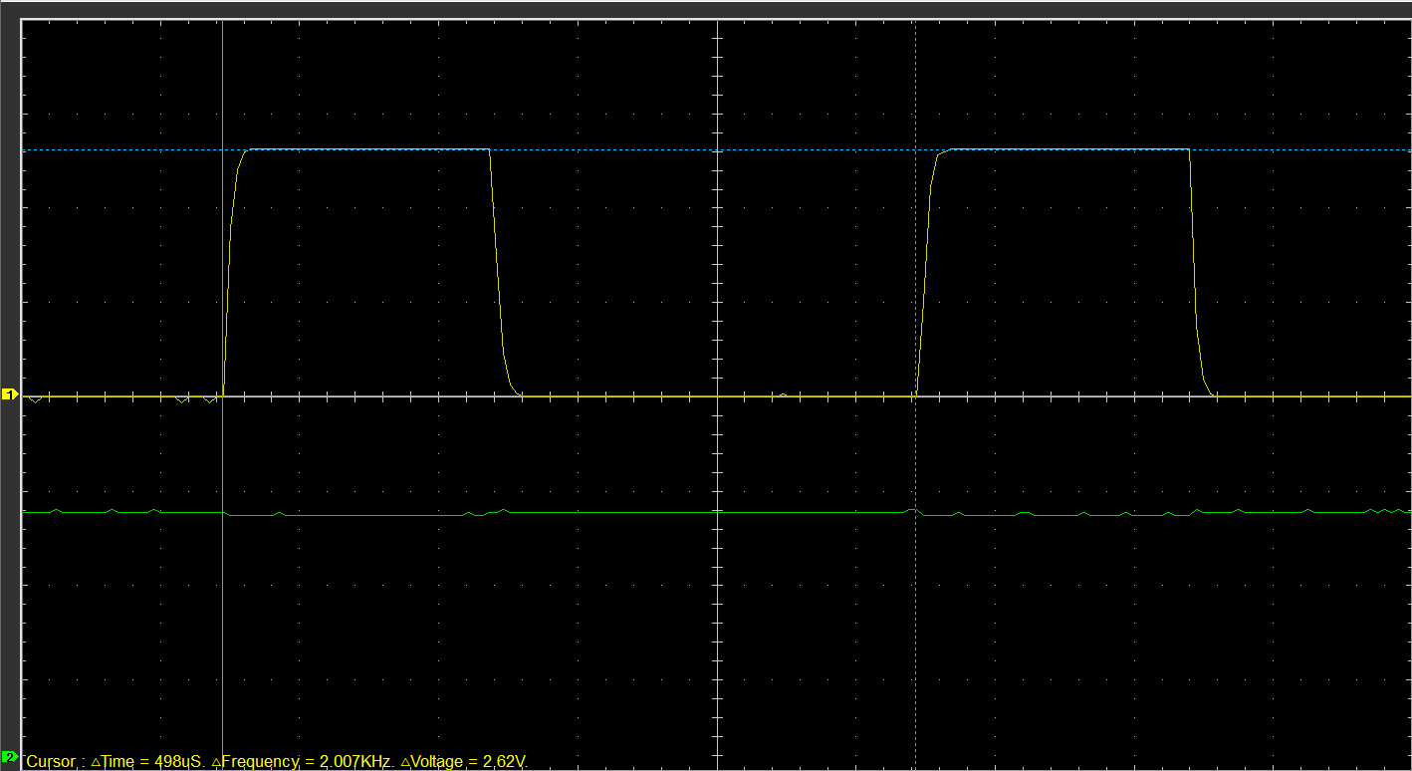
simulator/electronic/measurements/04_F-Pulse-at-195rpm_2604Hz_384us__SampleDriver_BB_100nF-PinCo.png
