LSchoenbauer/unseen-obstacles/simulator/electronic/measurements/09_Pulse-Width-low-at-195rpm_2604Hz_384us__SampleDriver_BB_NO-PinCo.png

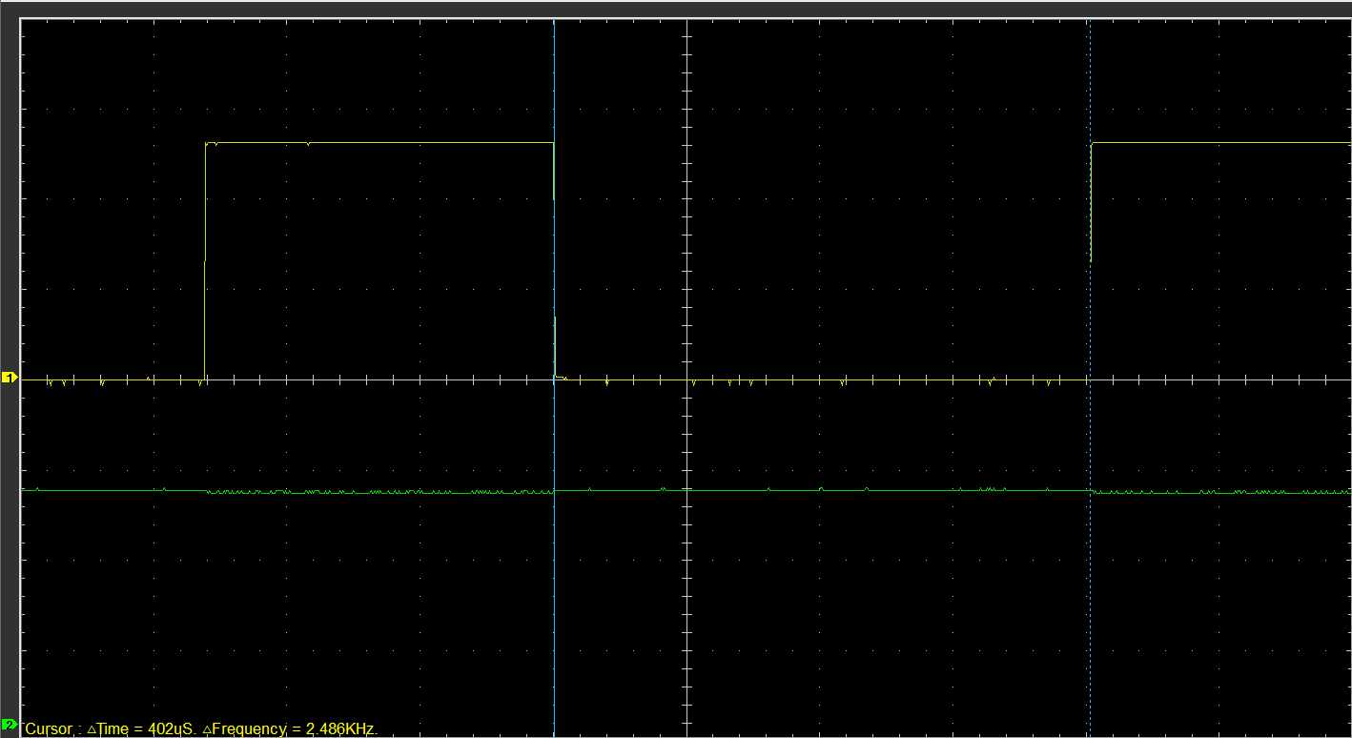
simulator/electronic/measurements/09_Pulse-Width-low-at-195rpm_2604Hz_384us__SampleDriver_BB_NO-PinCo.png
