LSchoenbauer/unseen-obstacles/simulator/docs/3pty/Stepper_NEMA23_300Ncm_23HE45-4204S_Torque_Curve.pdf

## 14HS08-0404S

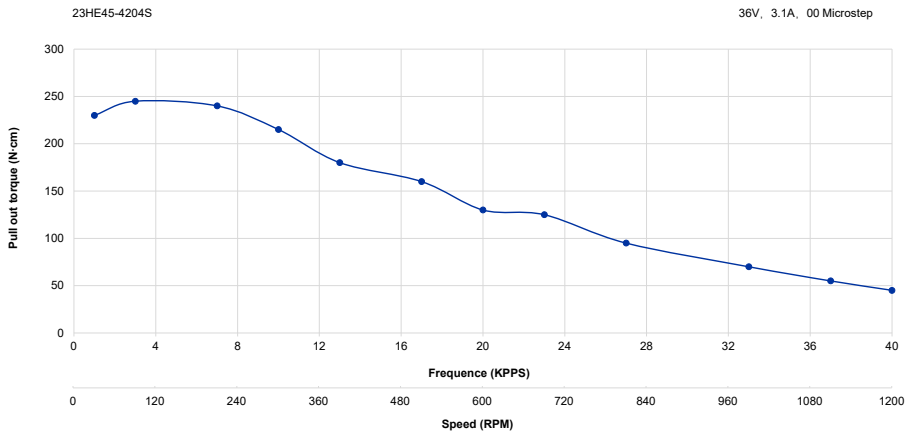
[picture p137: page 1]
1200 PULL OUT TORQUE⁽N.M⁾; Speed (RPM); 40 Pull out torque ⁽N·cm⁾; Frequence (KPPS); 36V，3.1A，00 Microstep
