LSchoenbauer/unseen-obstacles/simulator/mechanics/cad/Mover-Stepper-Mounts_r1.1.pdf

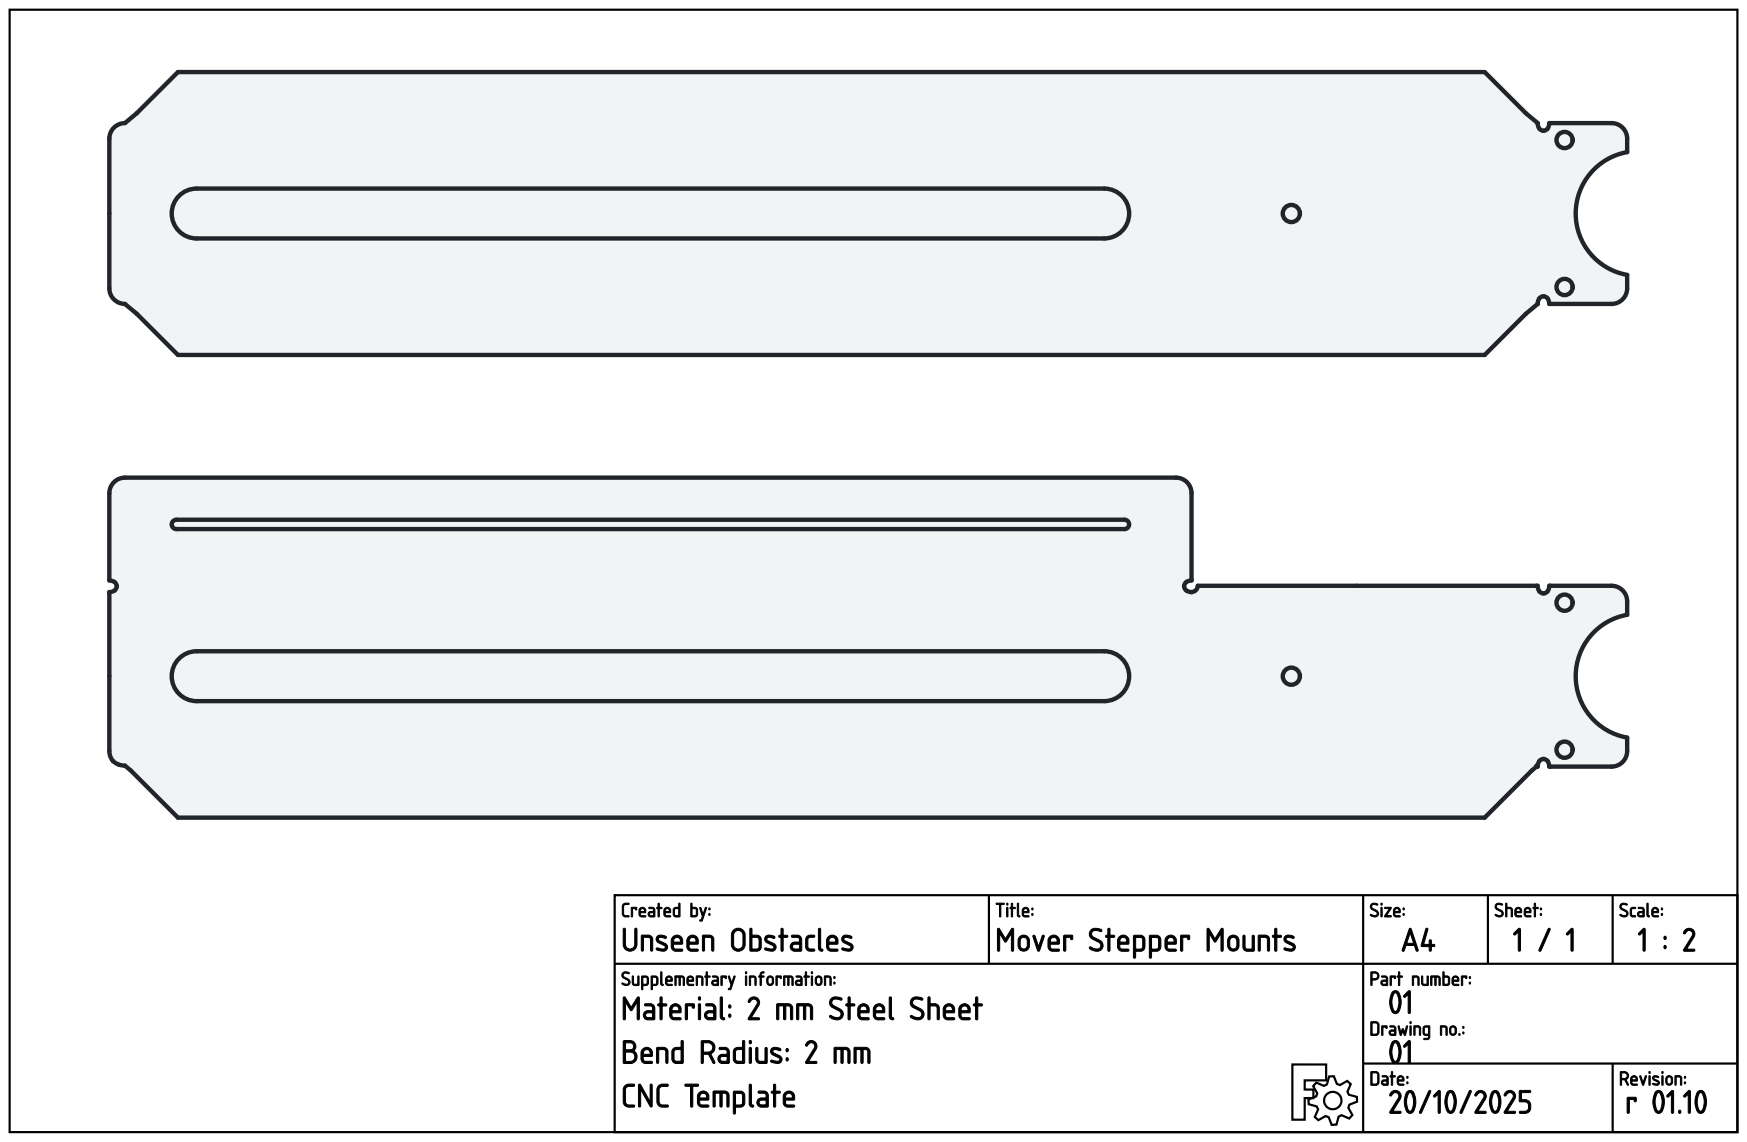
[picture p138: page 1]

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

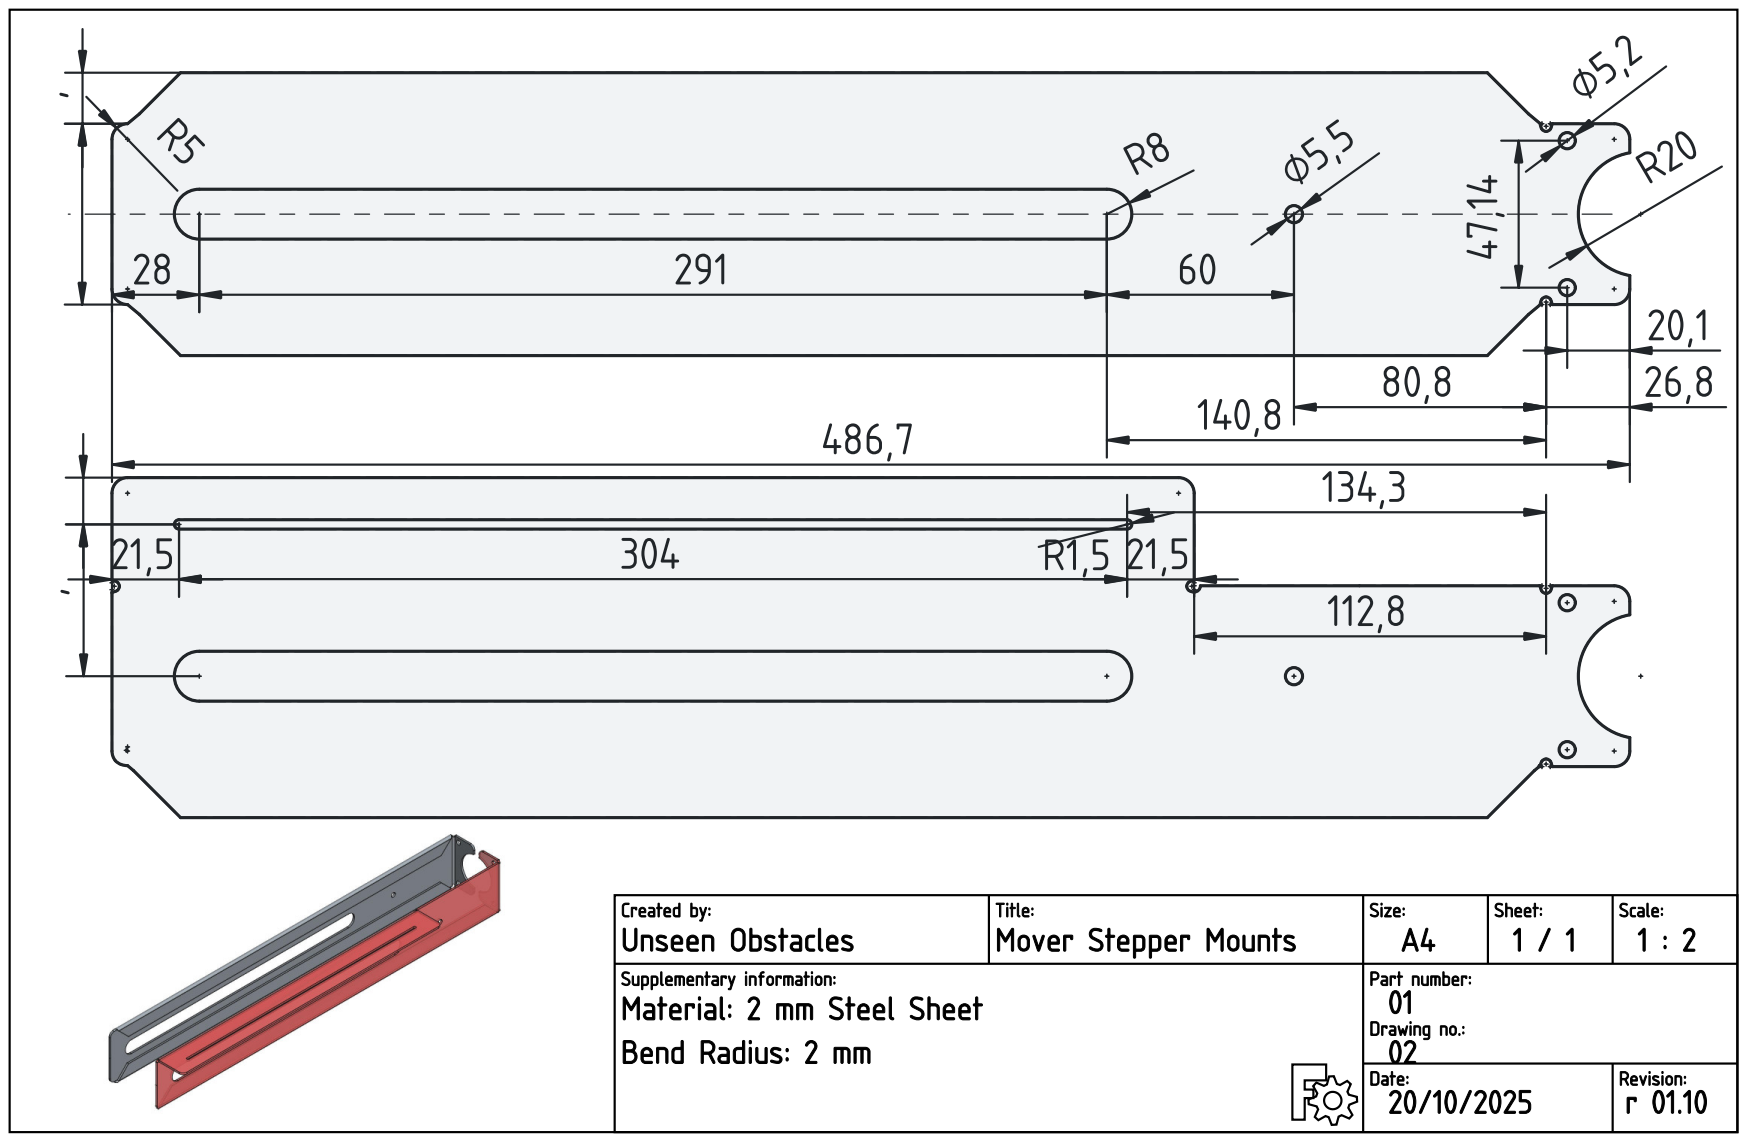
[picture p139: page 2]
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
