LSchoenbauer/unseen-obstacles/simulator/electronic/ead/UnseenObstacles_SimulatorController_PCB.pdf

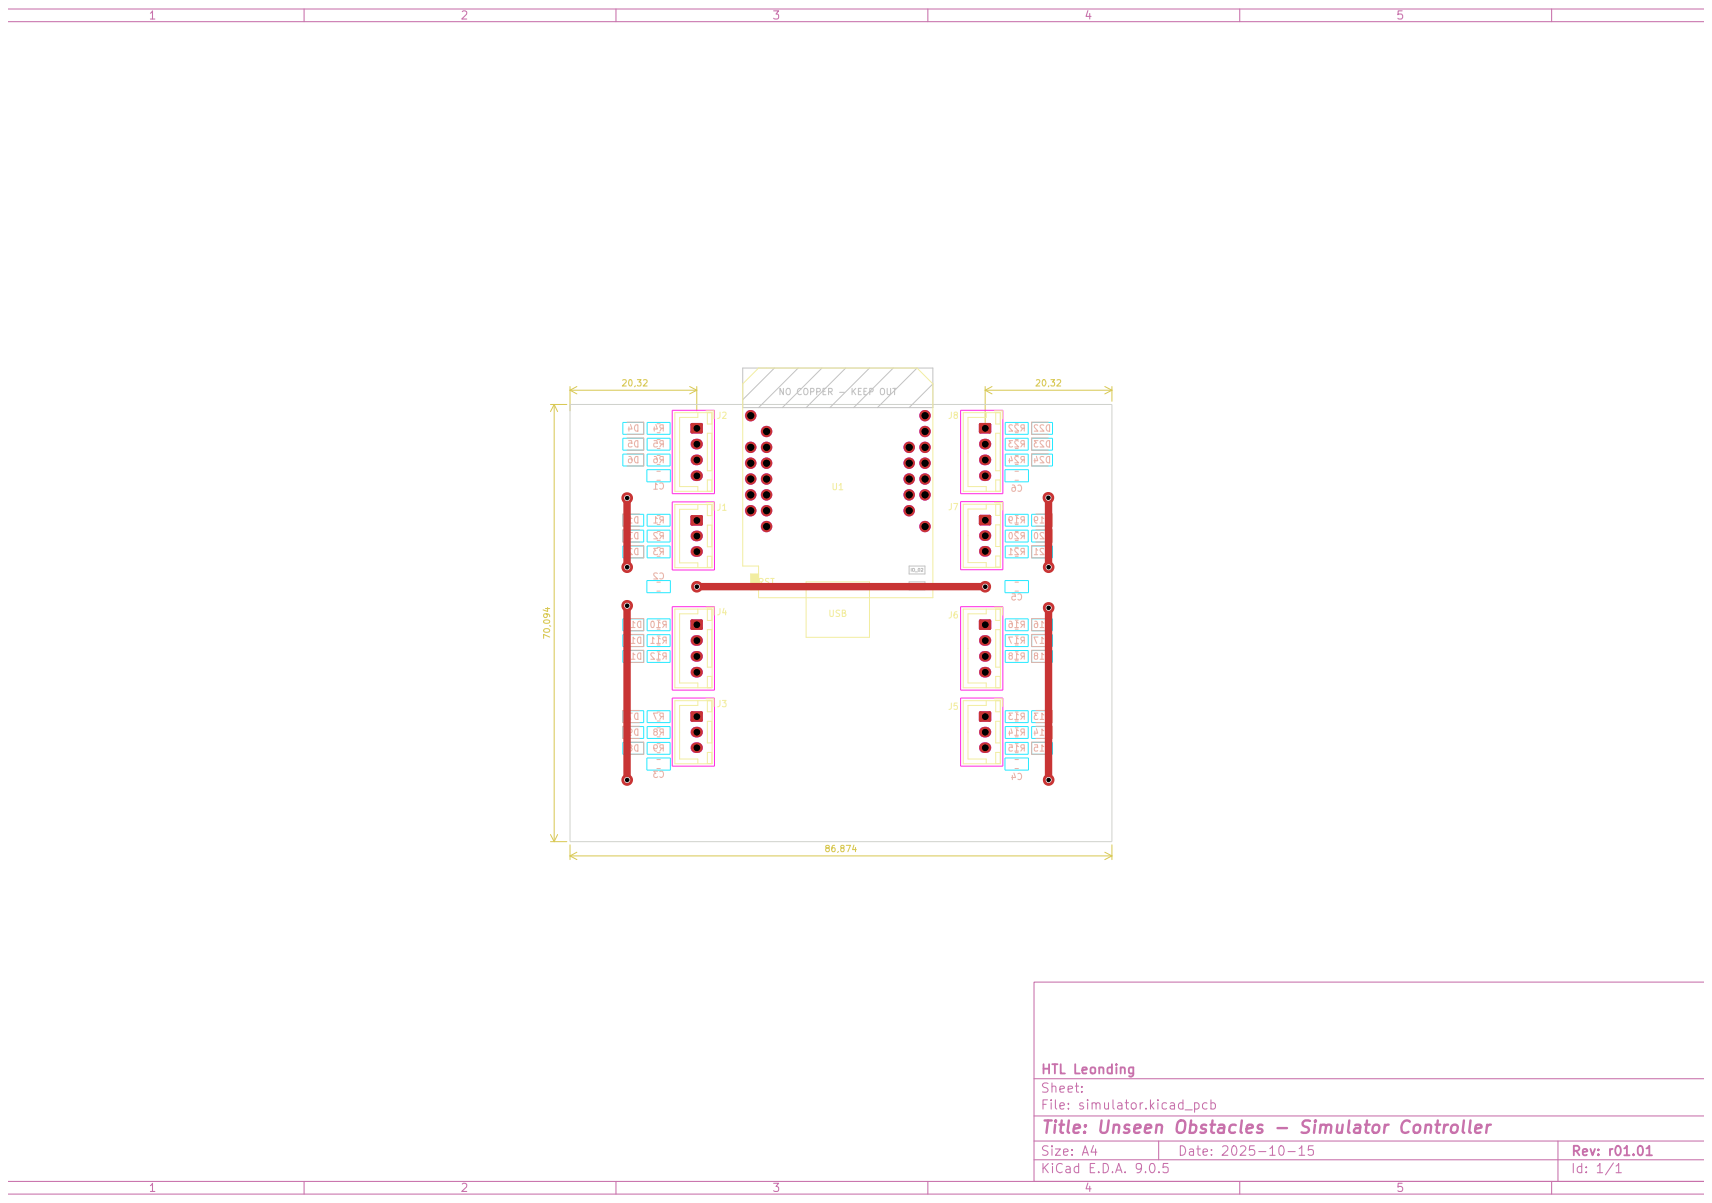
[picture p140: page 1]

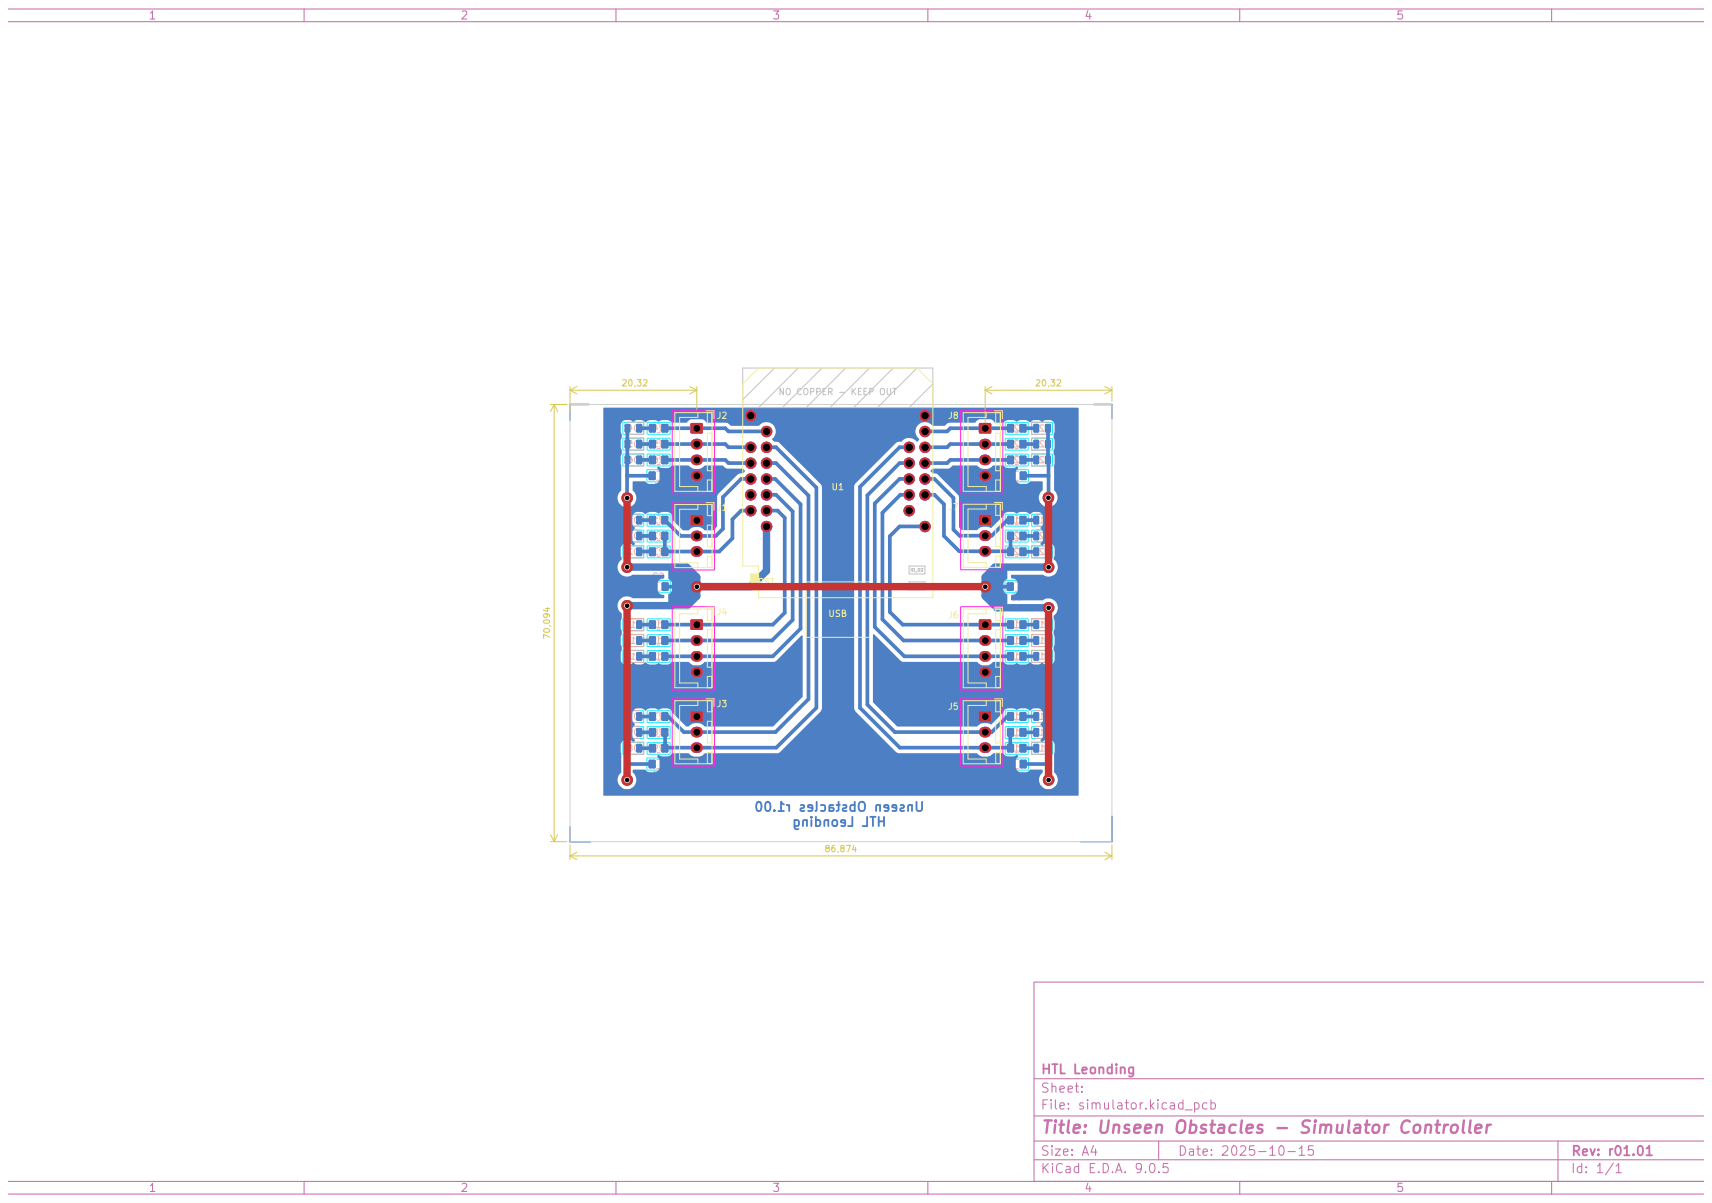
[picture p141: page 2]

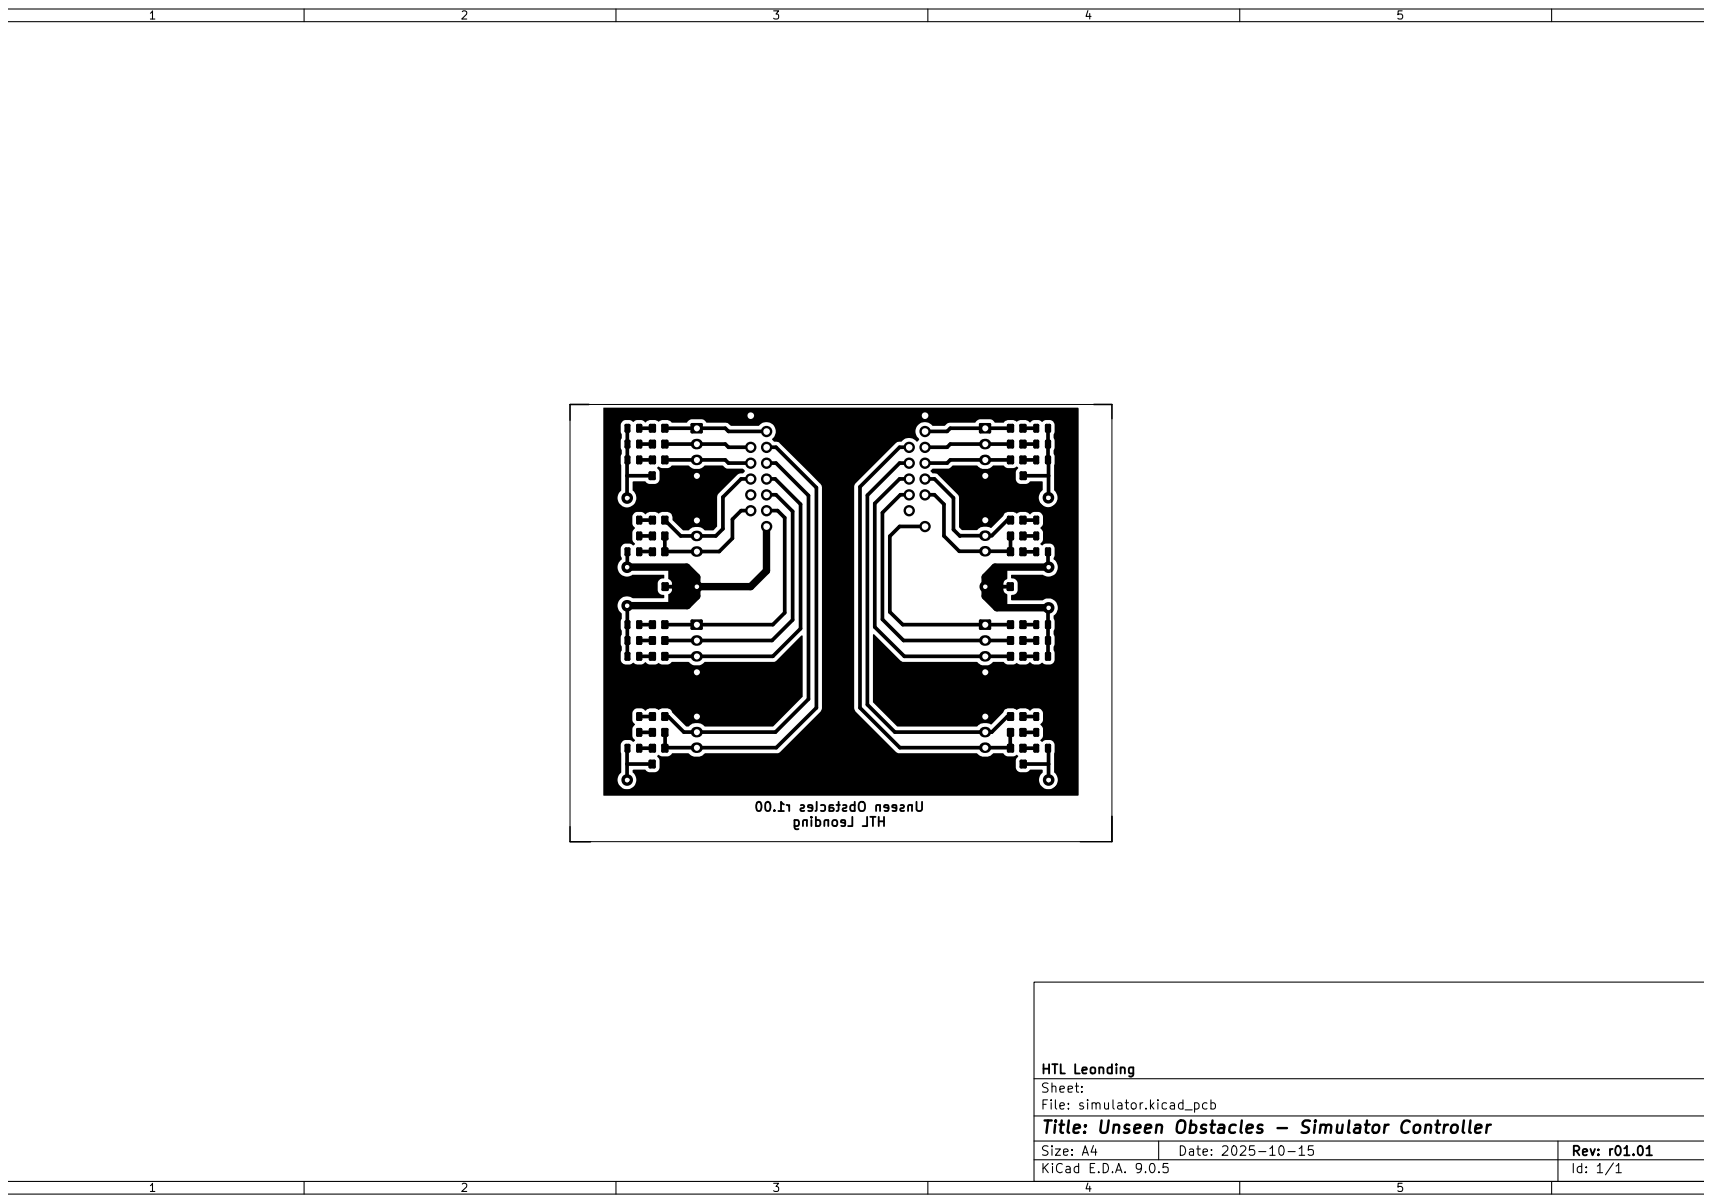
[picture p142: page 3]

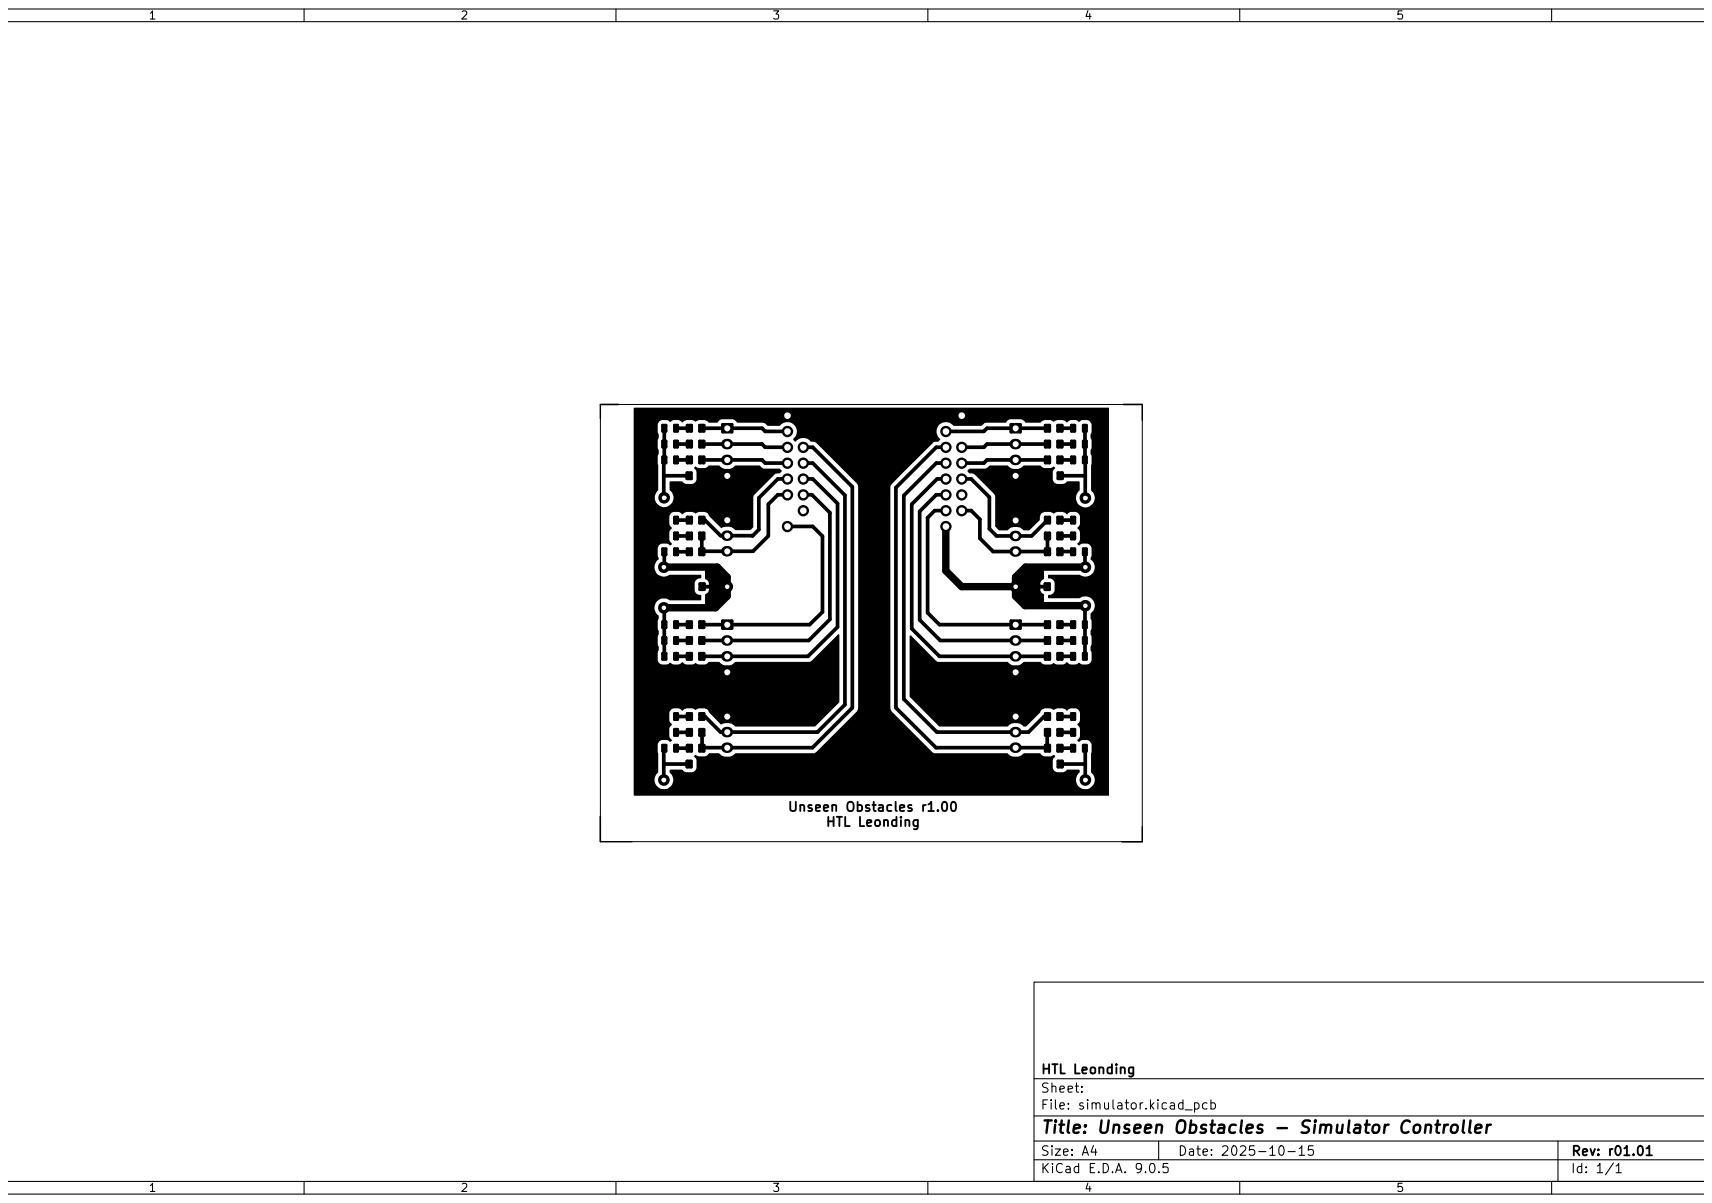
[picture p143: page 4]
