LSchoenbauer/unseen-obstacles/simulator/electronic/ead/UnseenObstacles_SimulatorController_Schematic.pdf

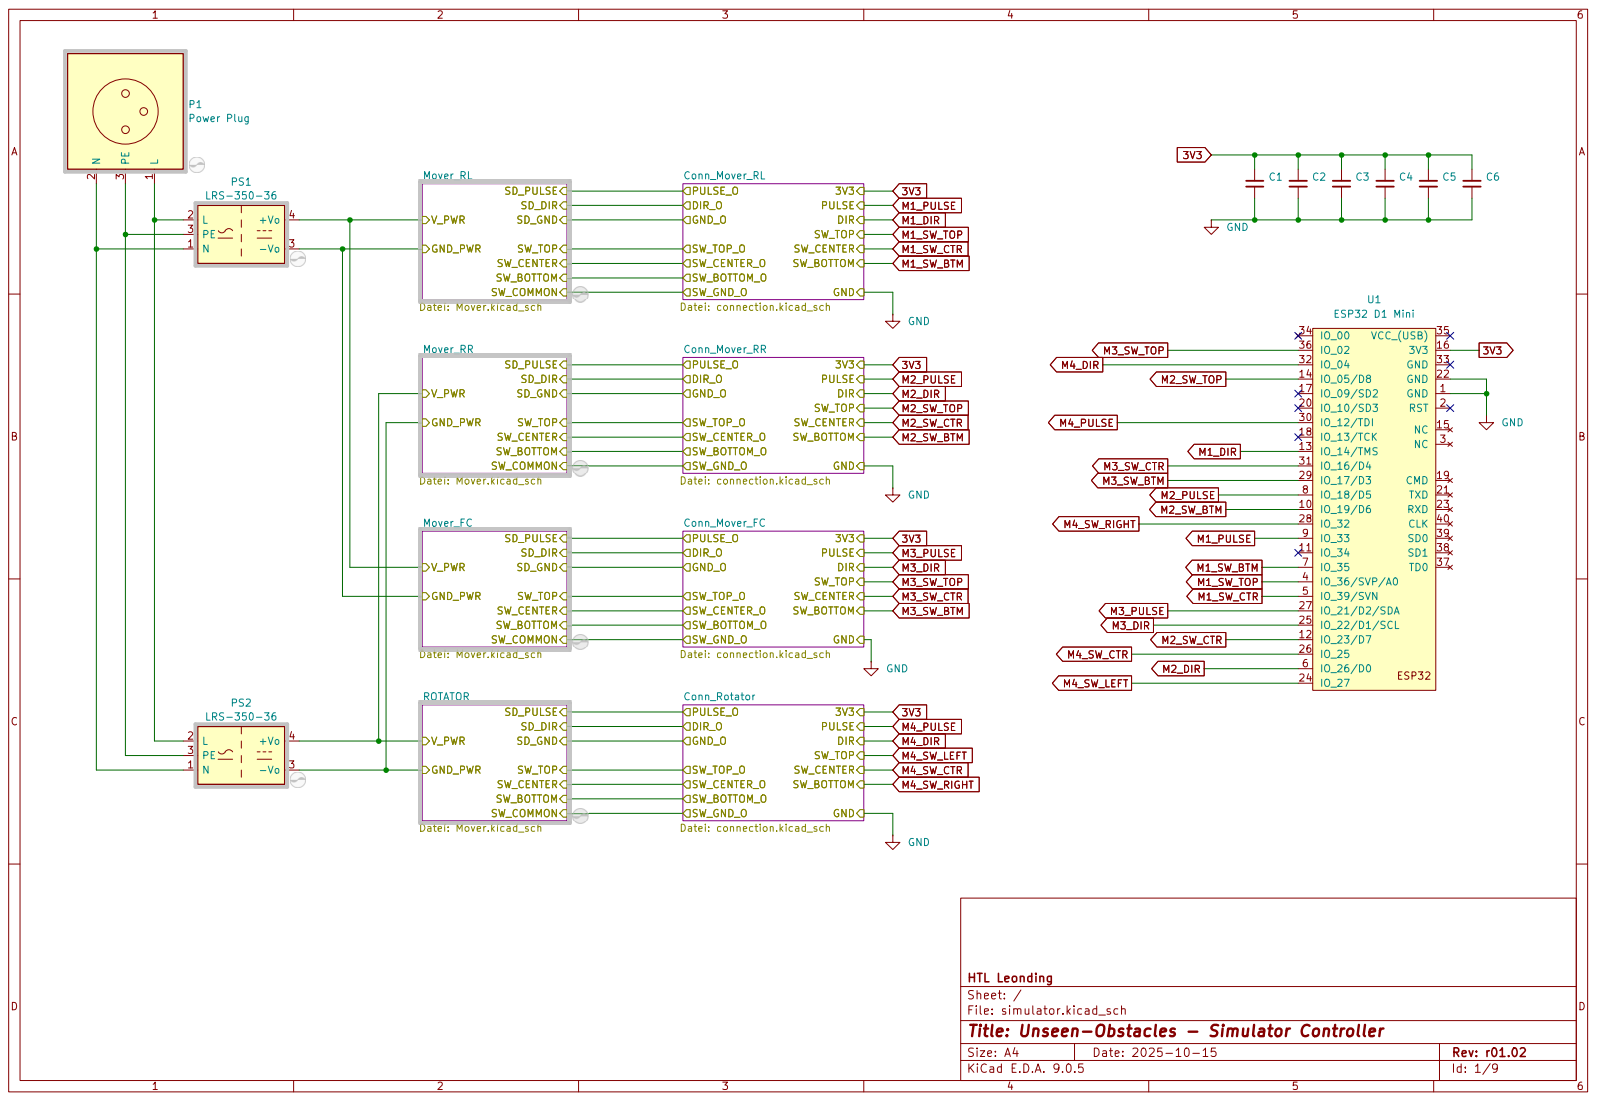
[picture p144: page 1]

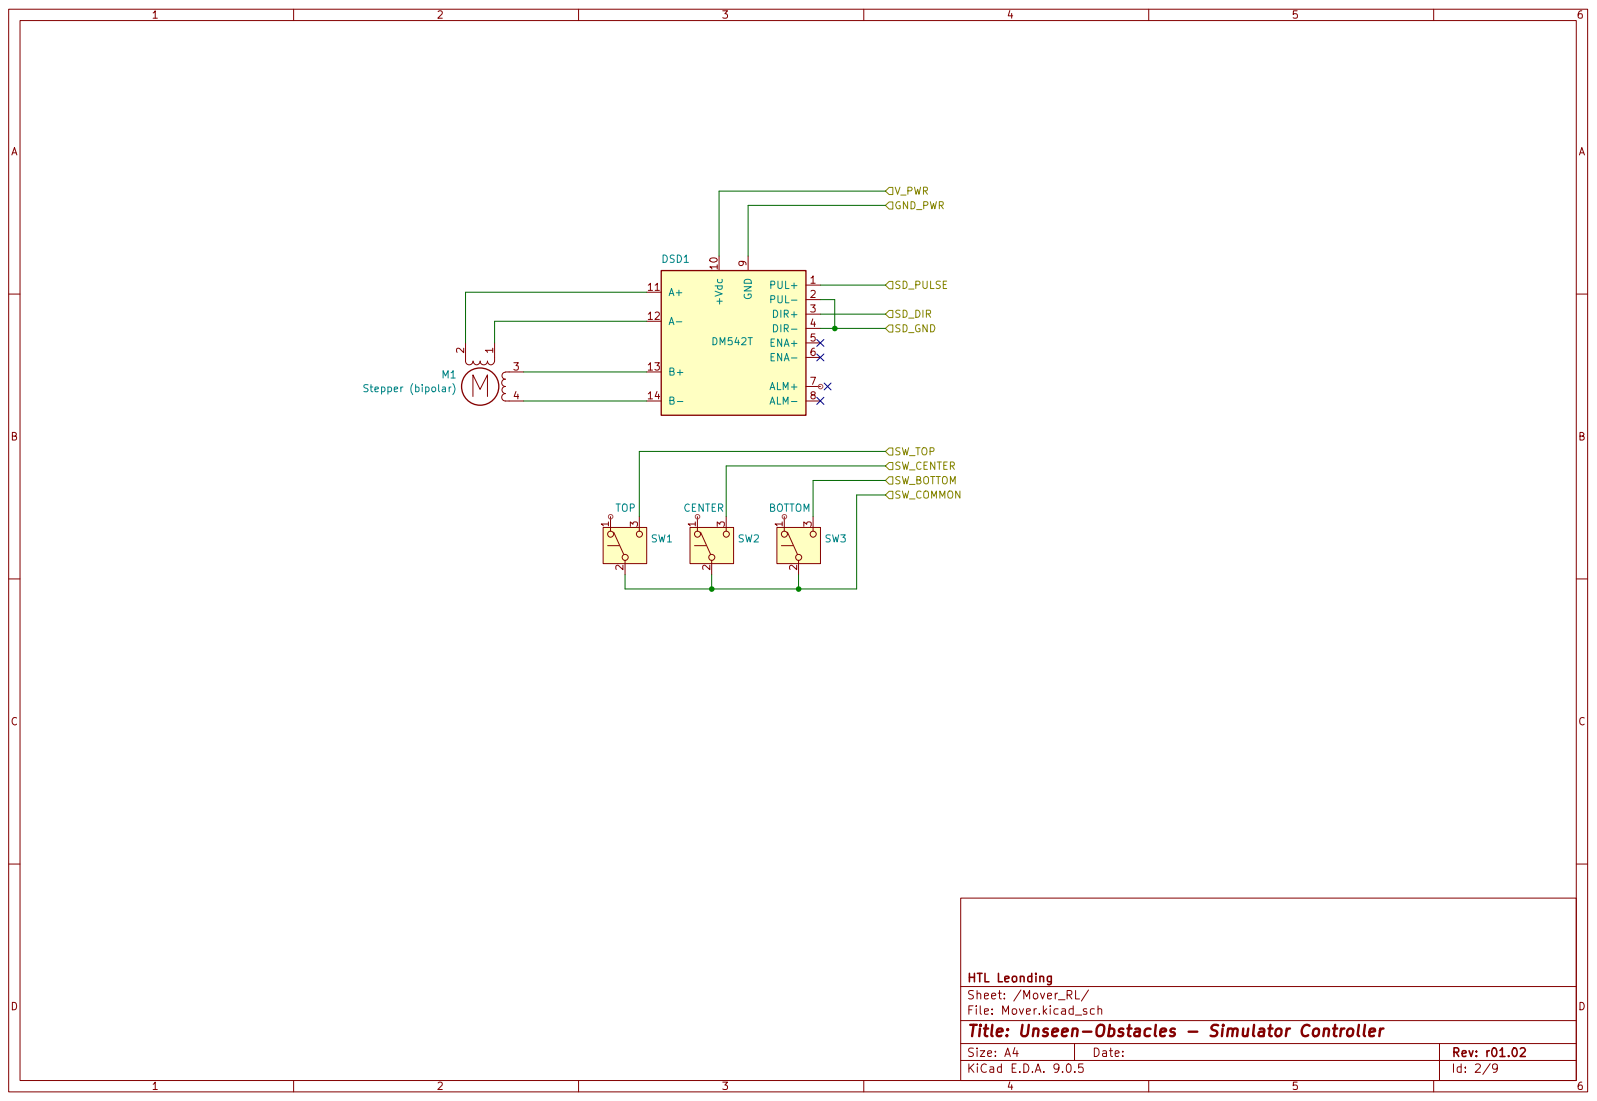
[picture p145: page 2]

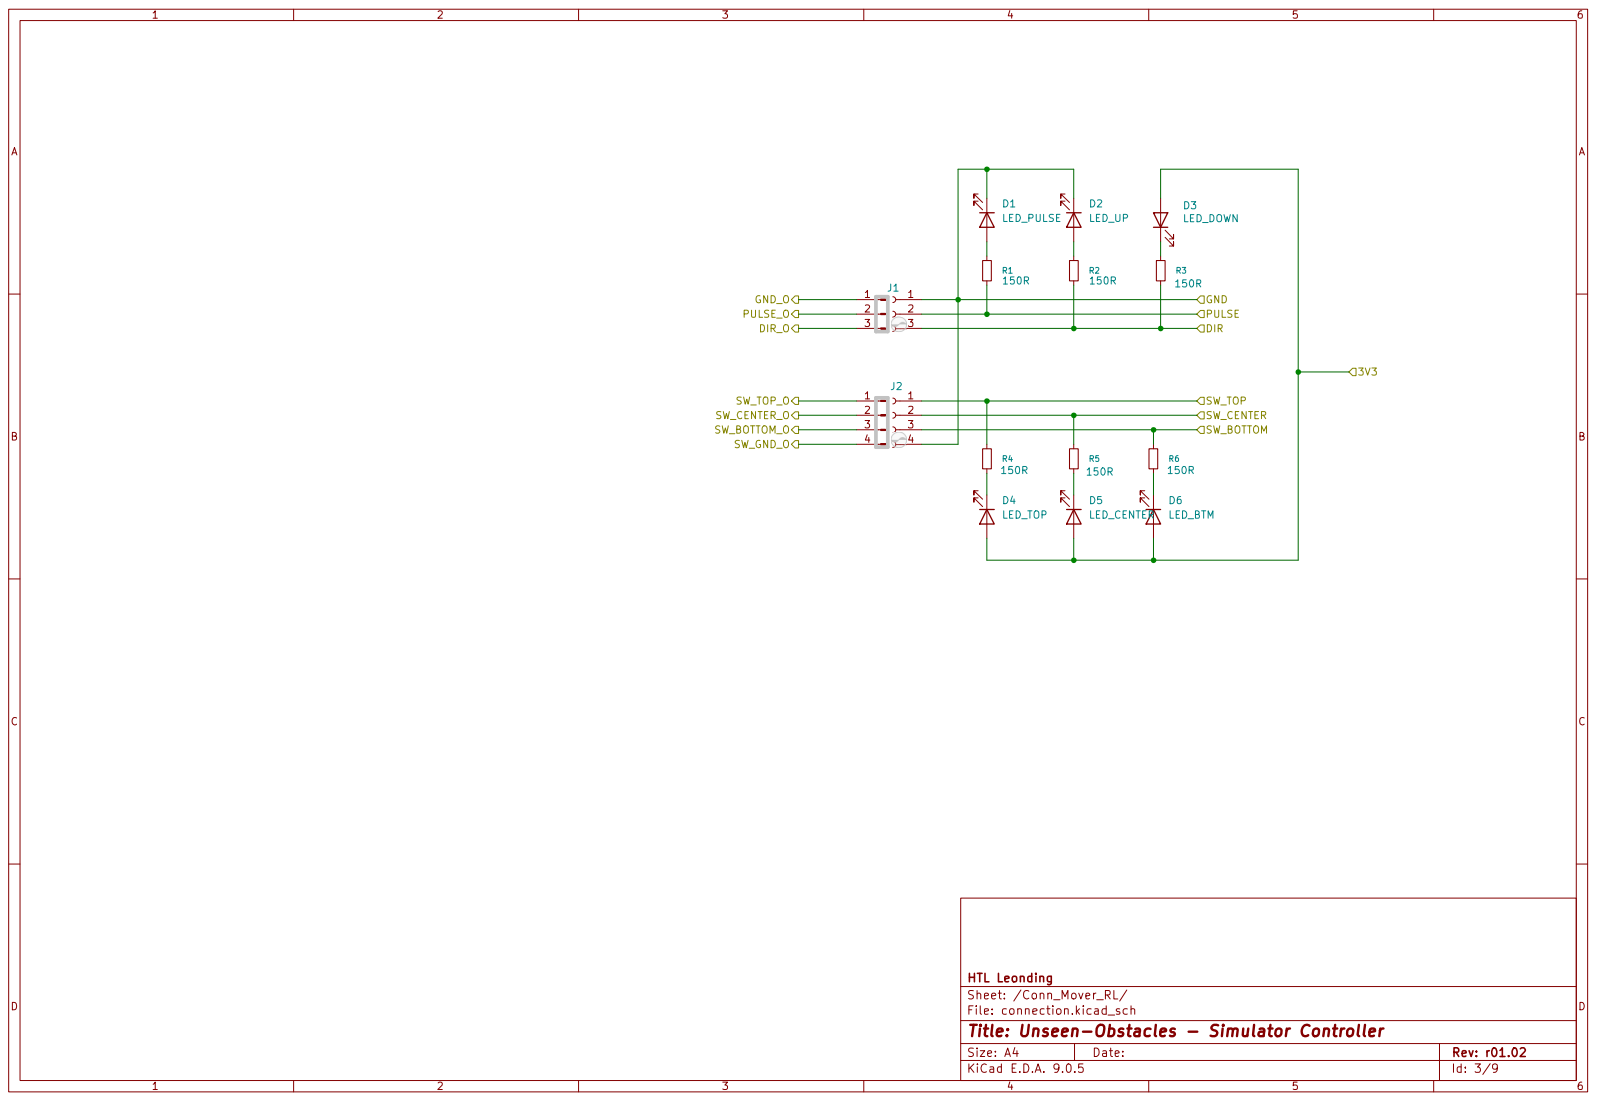
[picture p146: page 3]

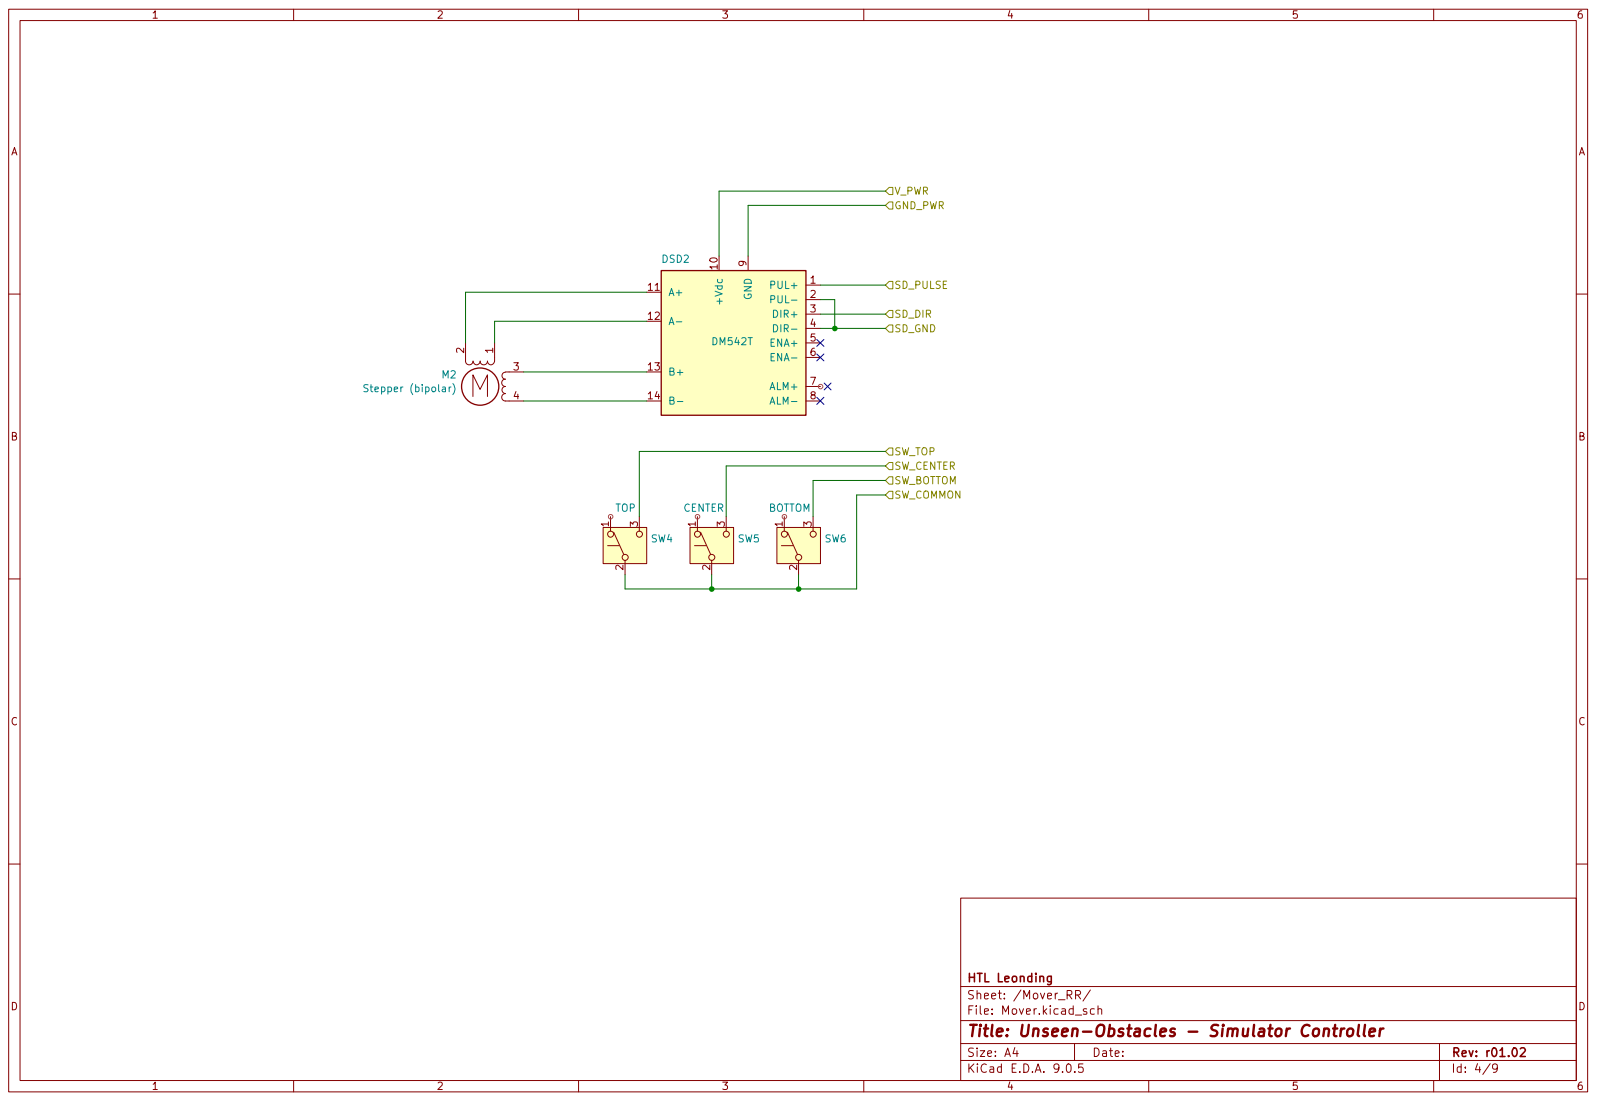
[picture p147: page 4]

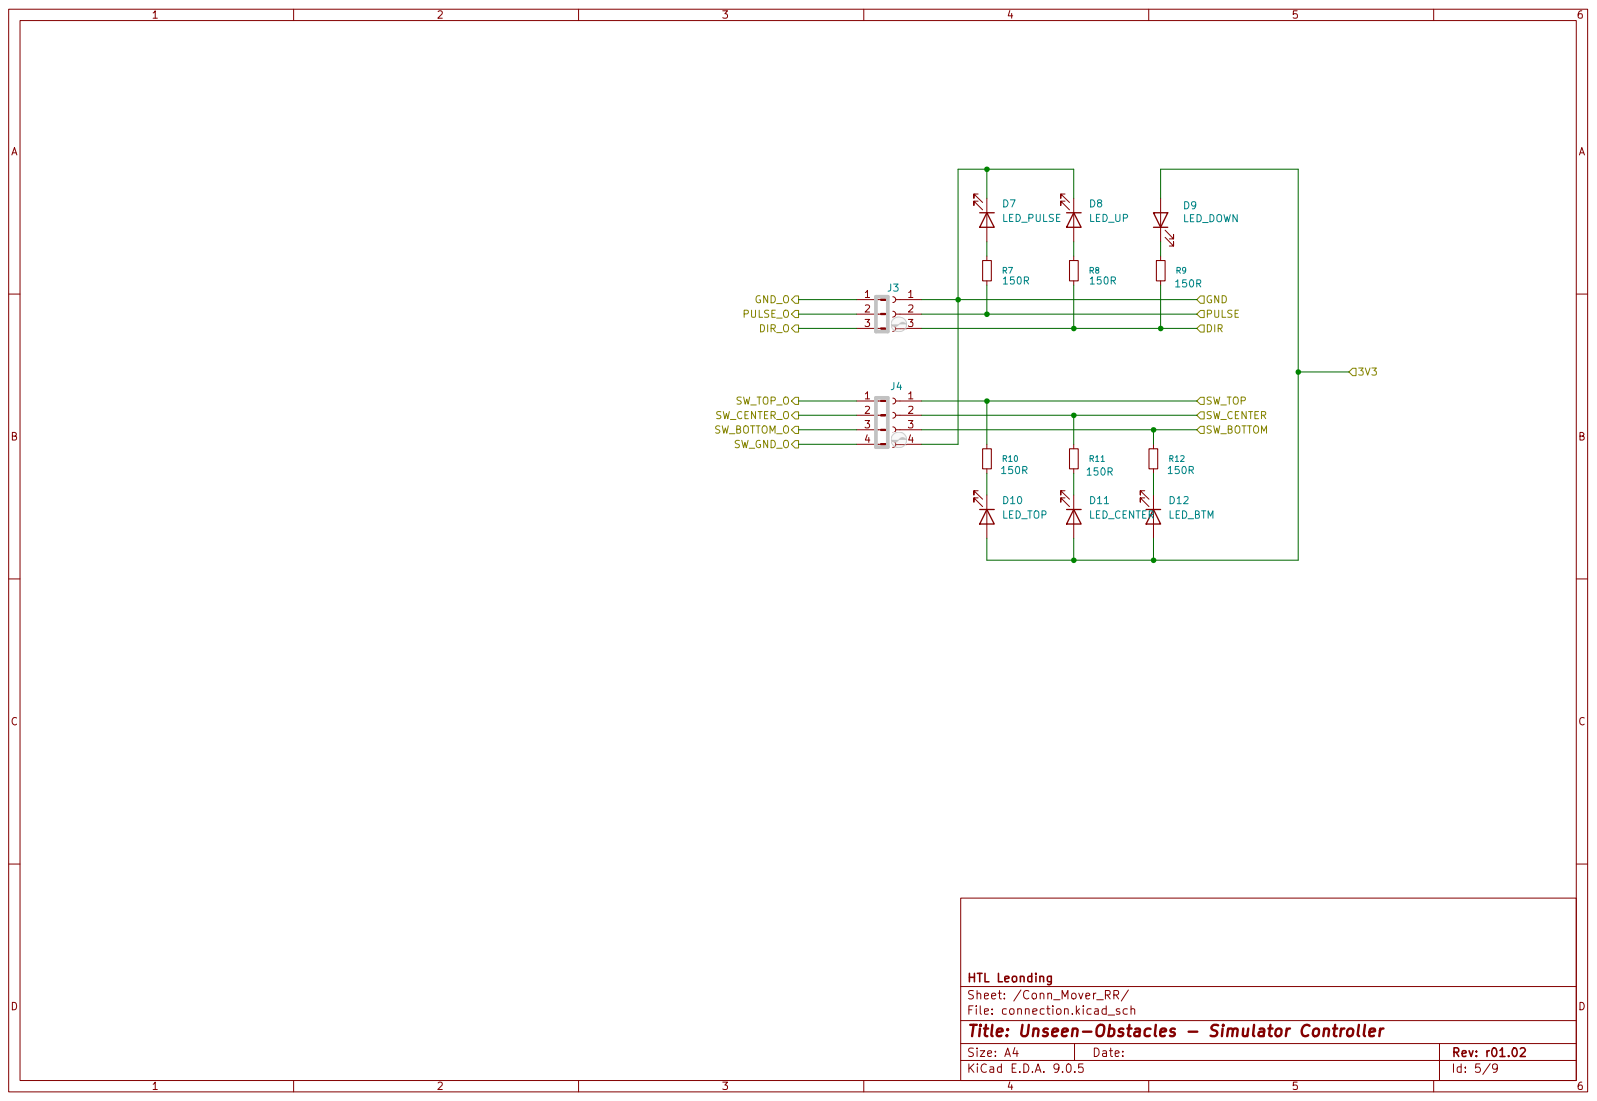
[picture p148: page 5]

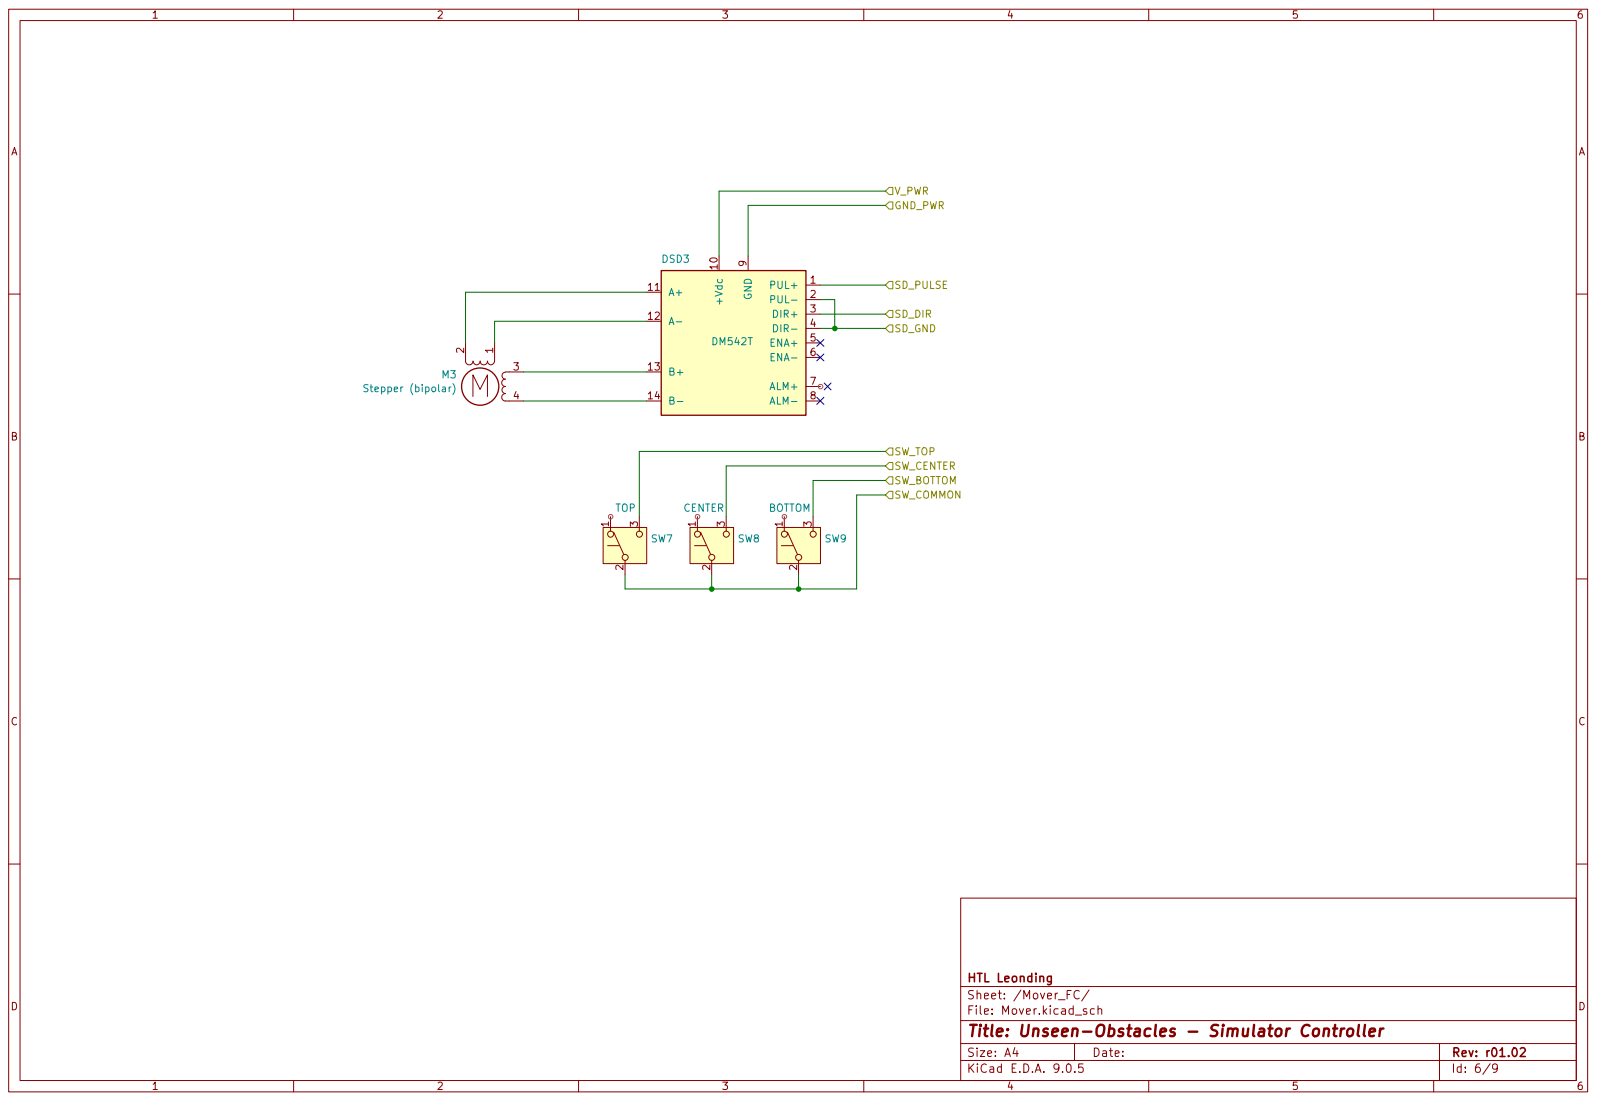
[picture p149: page 6]

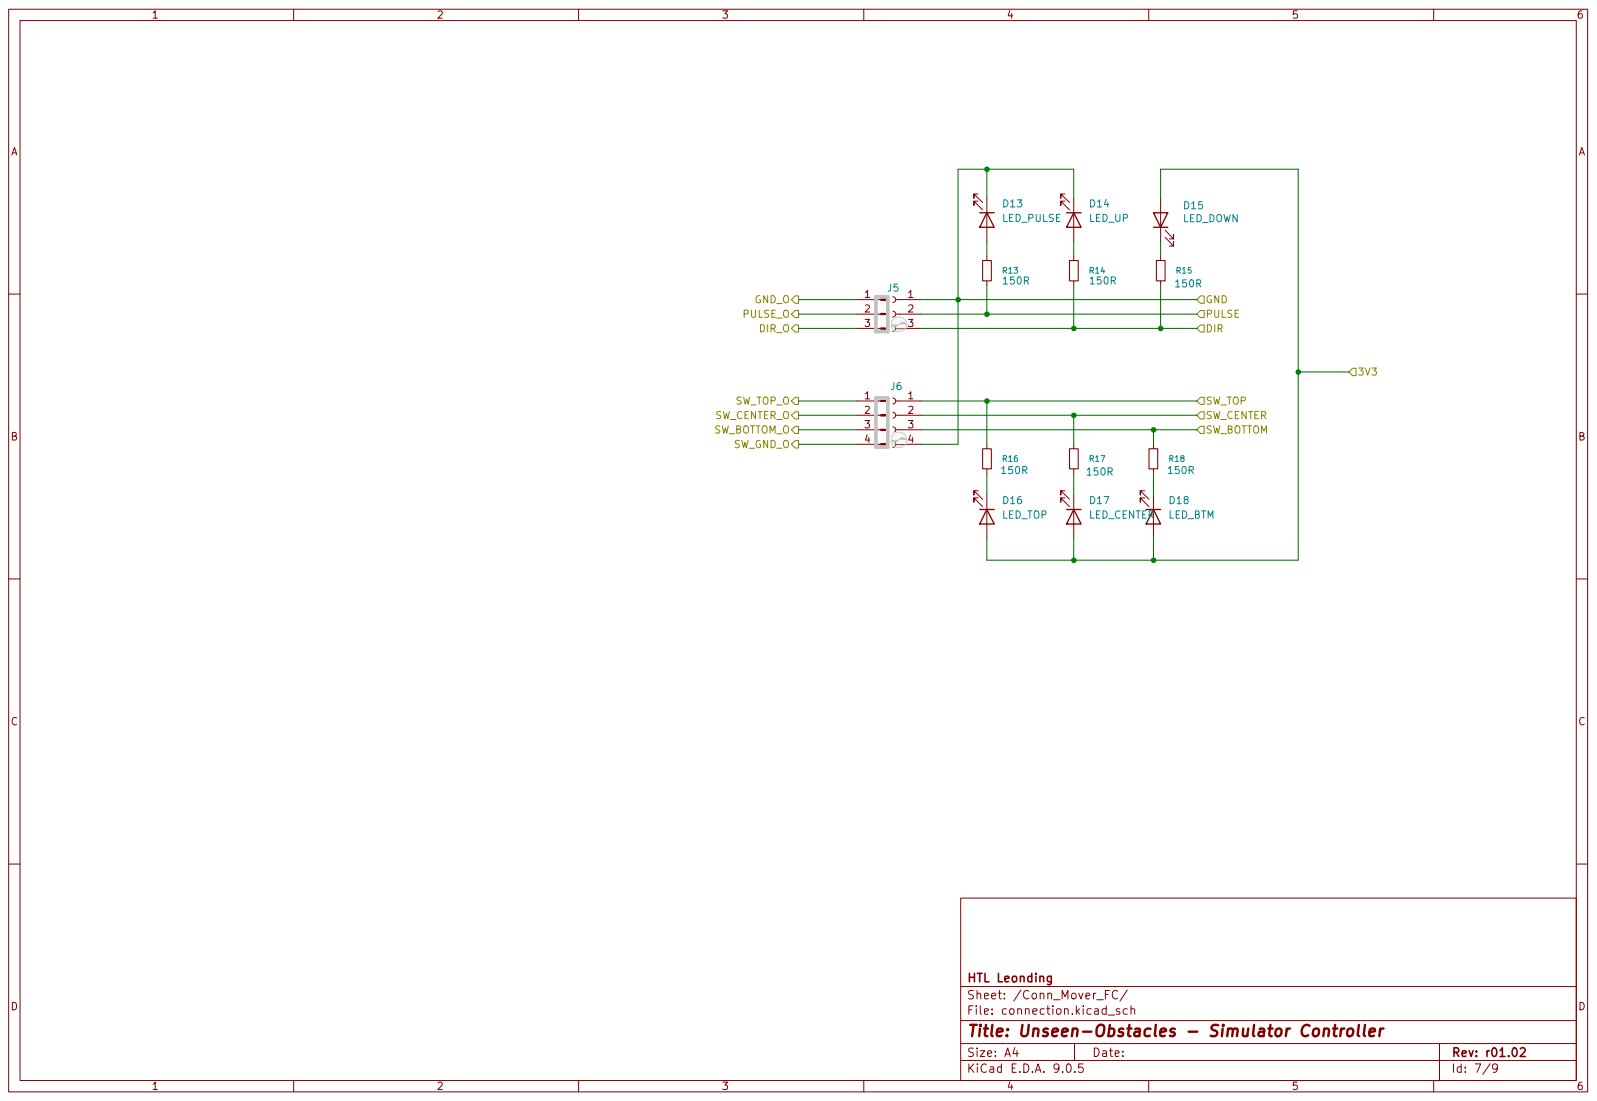
[picture p150: page 7]

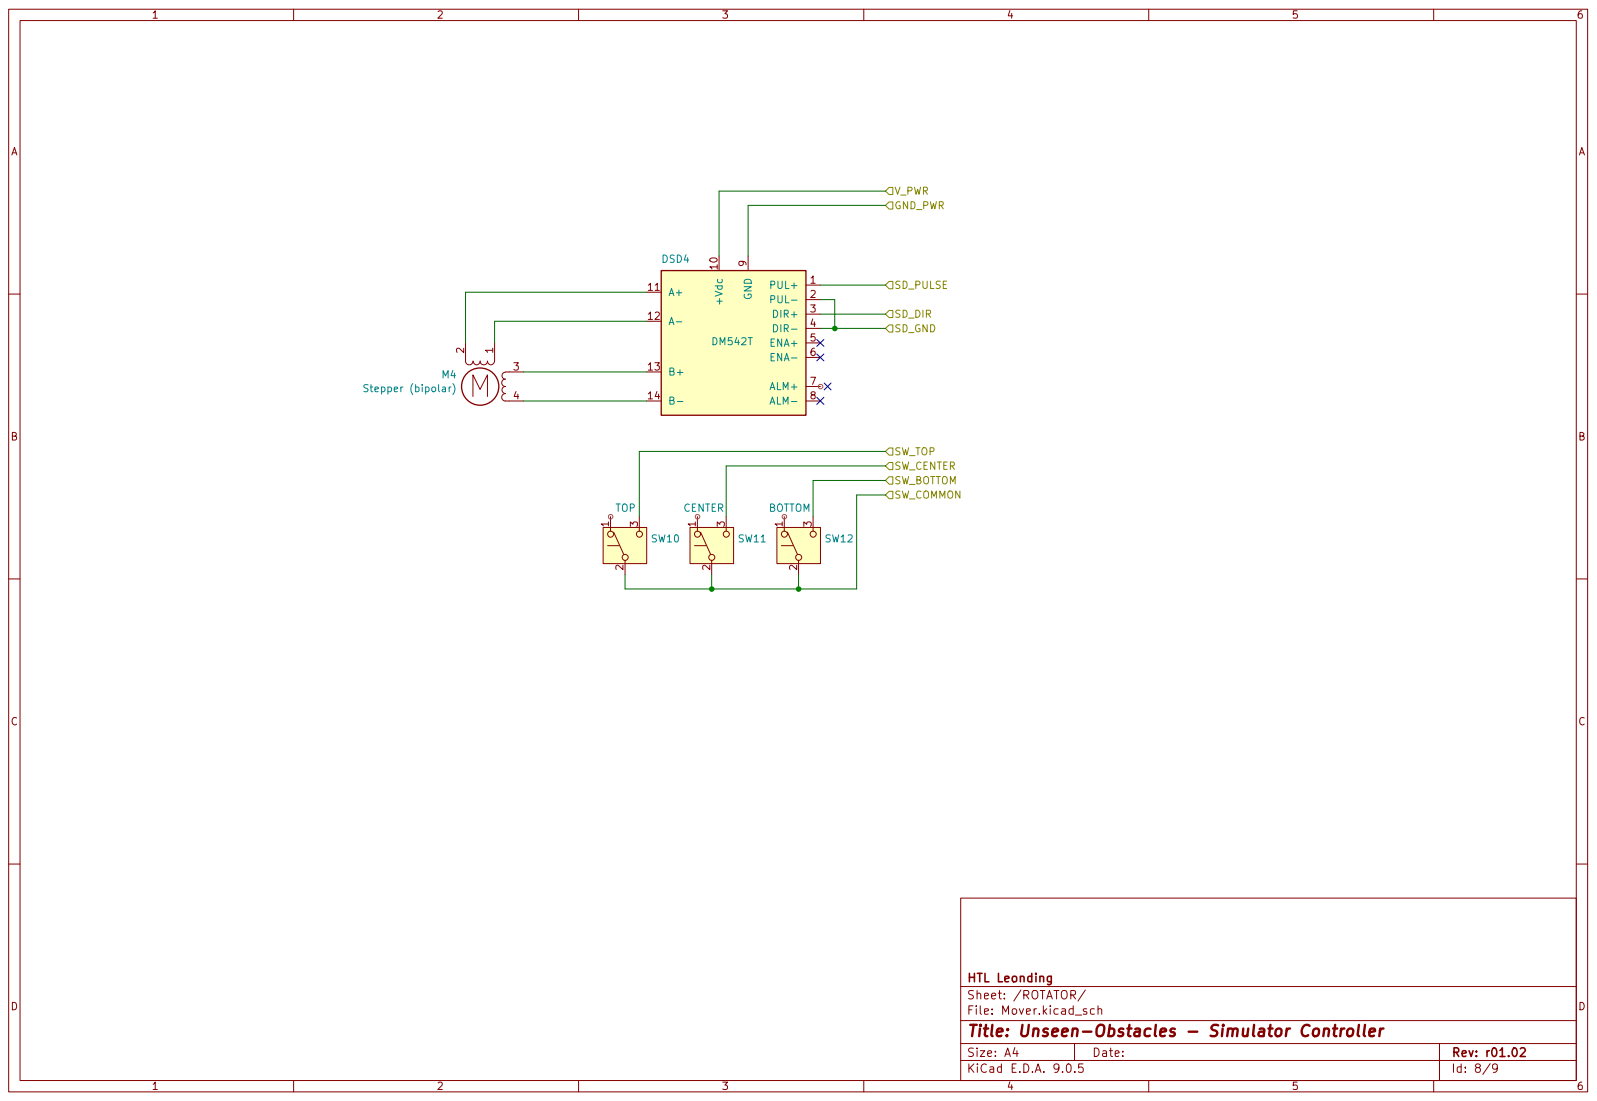
[picture p151: page 8]

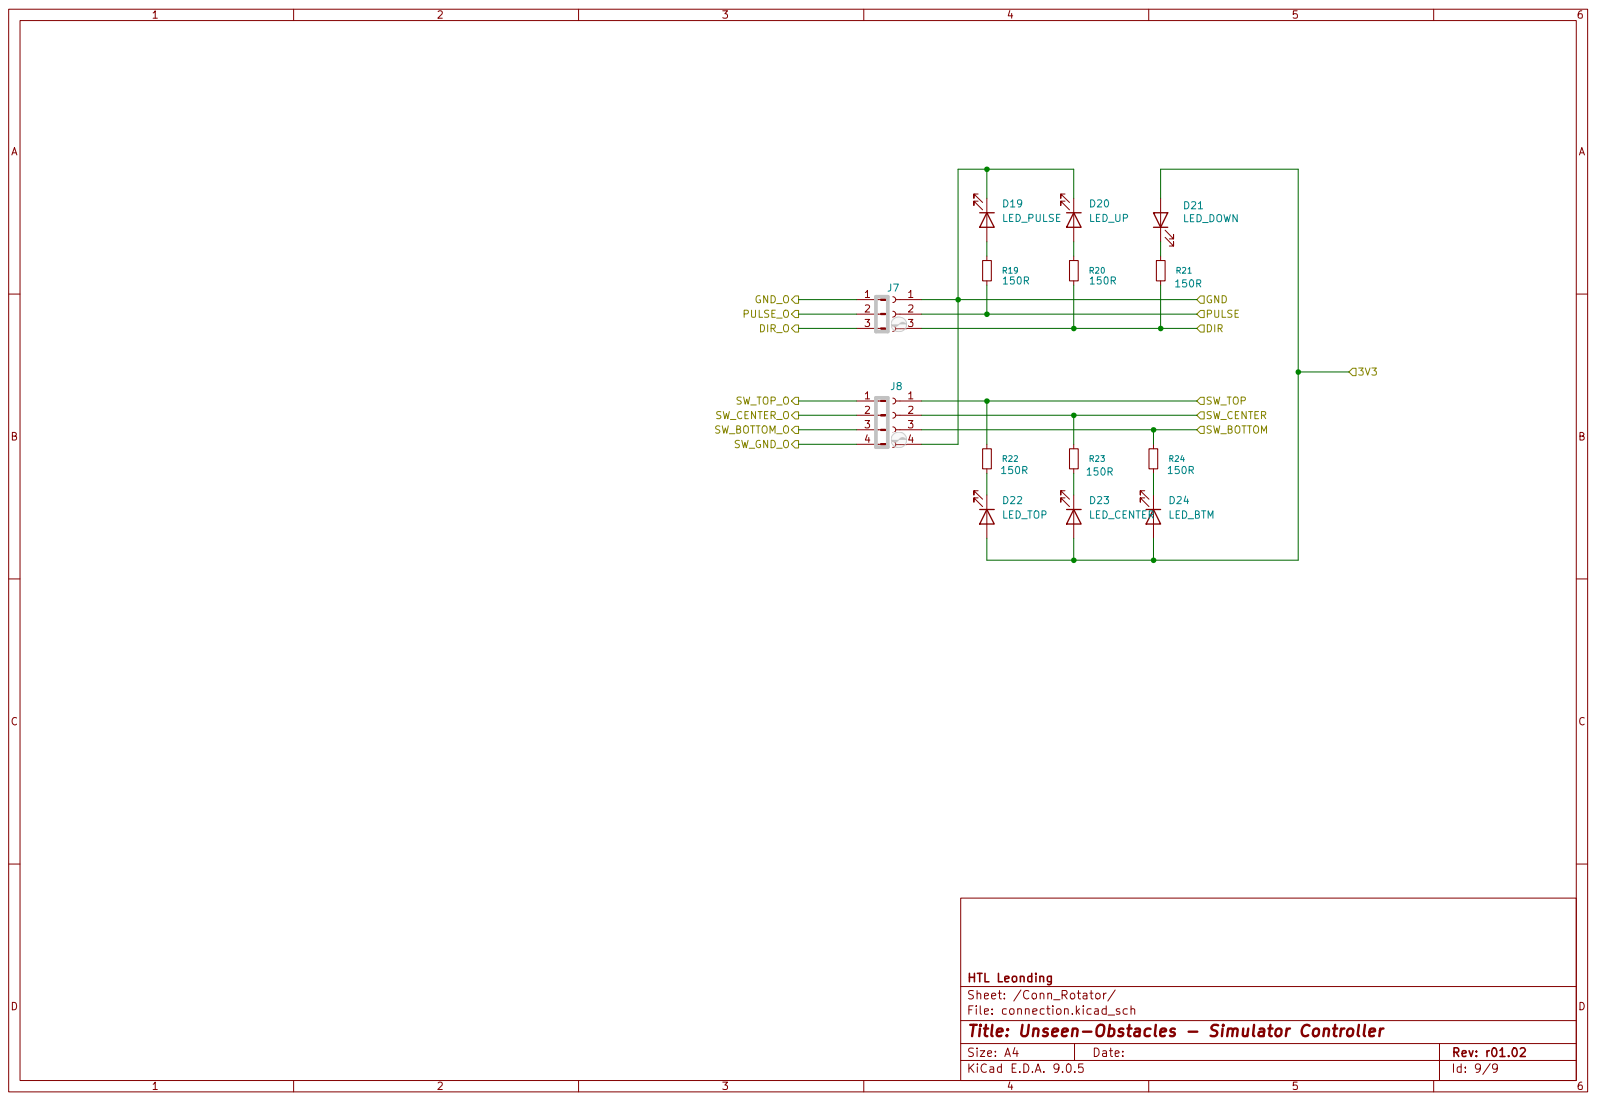
[picture p152: page 9]
