LSchoenbauer/unseen-obstacles/simulator/electronic/controller/simulator/simulator.kicad_pcb

## KiCad design simulator/electronic/controller/simulator/simulator.kicad_pcb (2025-10-19)

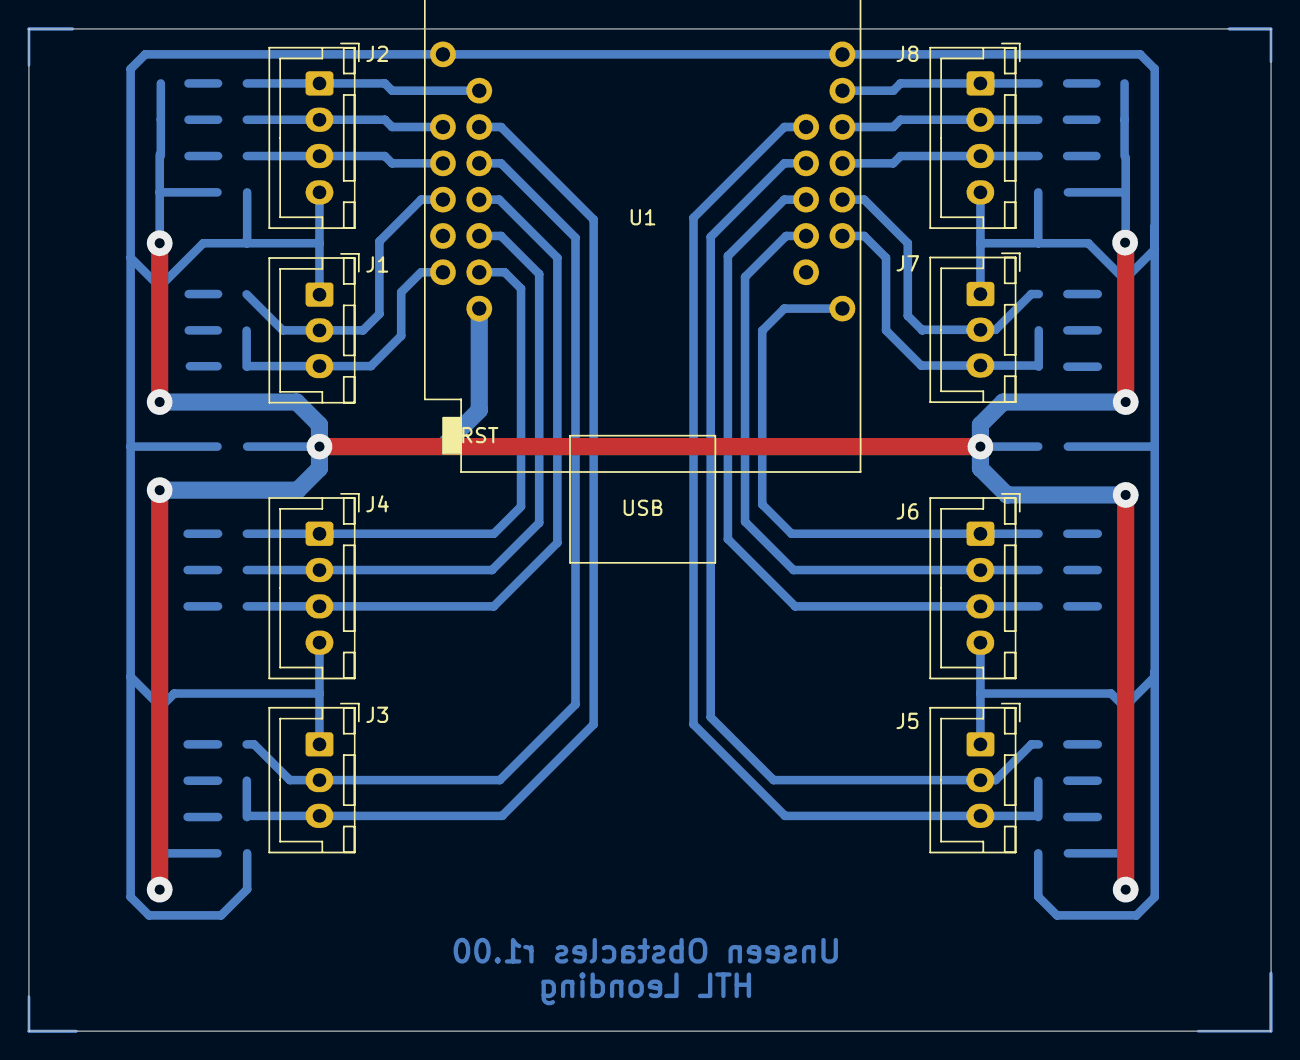
[picture p153: board simulator.kicad_pcb from above]

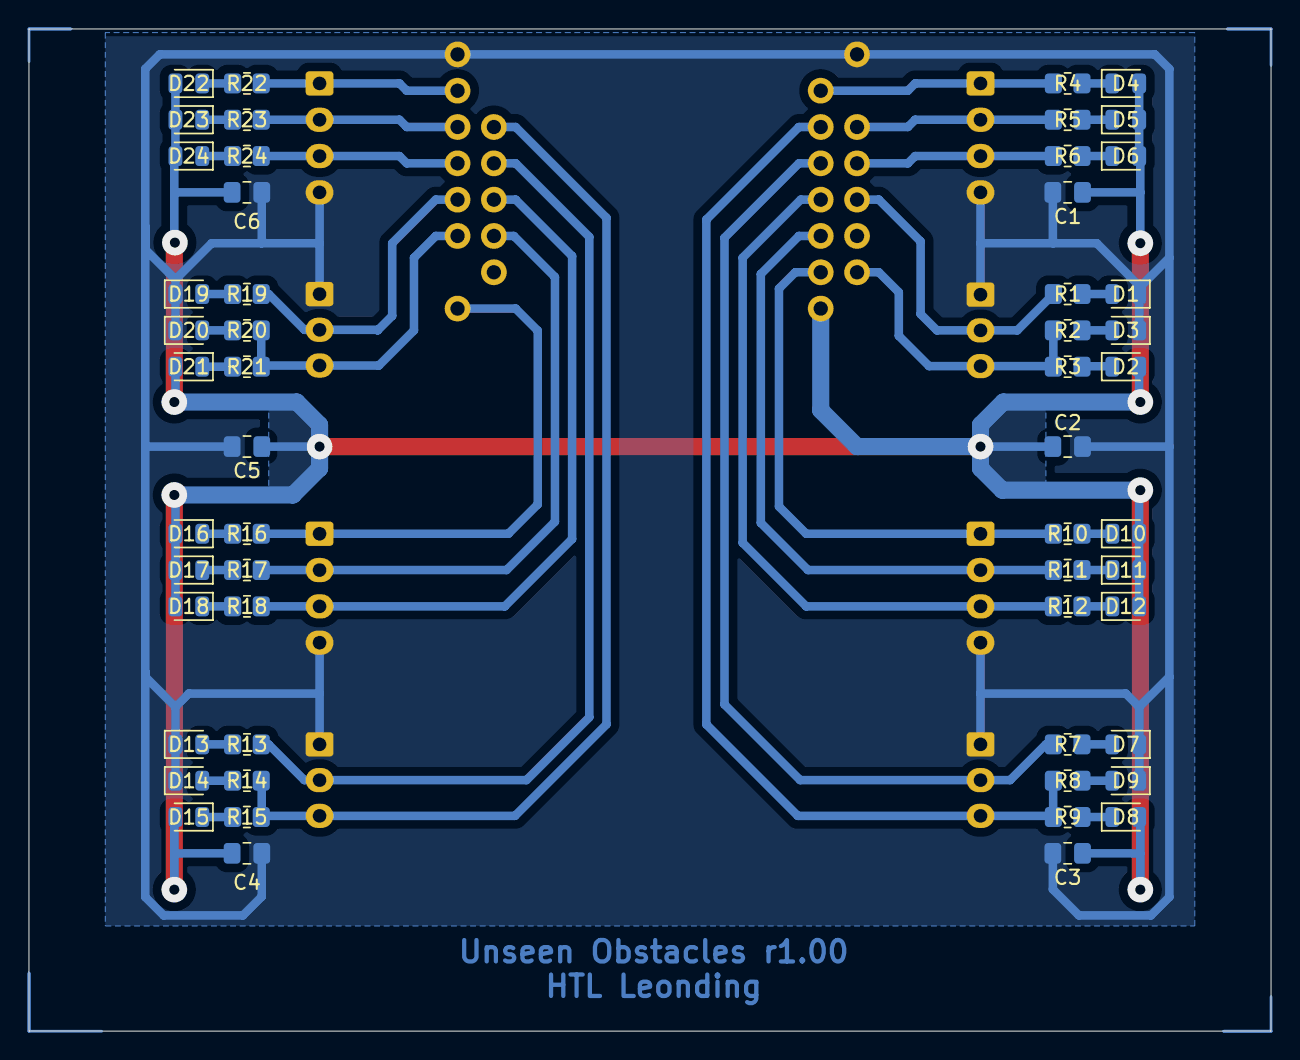
[picture p154: board simulator.kicad_pcb from below]

Board: 2 copper layers, 86.9 x 70.1 mm, 63 parts (54 on the bottom side), 46 nets.

Parts:
C1, C2, C3, C4, C5, C6: 100n; C_0805_2012Metric_Pad1.18x1.45mm_HandSolder
D1, D7, D13, D19: LED_PULSE; LED_0805_2012Metric
D2, D8, D14, D20: LED_UP; LED_0805_2012Metric
D3, D9, D15, D21: LED_DOWN; LED_0805_2012Metric
D4, D10, D16, D22: LED_TOP; LED_0805_2012Metric
D5, D11, D17, D23: LED_CENTER; LED_0805_2012Metric
D6, D12, D18, D24: LED_BTM; LED_0805_2012Metric
J1, J3, J5, J7: Conn_01x03_Socket; JST_XH_B3B-XH-A_1x03_P2.50mm_Vertical
J2, J4, J6, J8: Conn_01x04_Socket; JST_XH_B4B-XH-A_1x04_P2.54mm_Vertical
R1, R2, R3, R4, R5, R6, R7, R8, R9, R10, R11, R12, R13, R14, R15, R16, R17, R18, R19, R20, R21, R22, R23, R24: 150R; R_0805_2012Metric_Pad1.20x1.40mm_HandSolder
U1: ESP32 D1 Mini; ESP32_D1_mini

Connections:
3V3: C1.1, C2.1, C3.1, C4.1, C5.1, C6.1, D3.2 (A), D4.2 (A), D5.2 (A), D6.2 (A), D9.2 (A), D10.2 (A), D11.2 (A), D12.2 (A), D15.2 (A), D16.2 (A), D17.2 (A), D18.2 (A), D21.2 (A), D22.2 (A), D23.2 (A), D24.2 (A), U1.16 (3V3)
GND: C1.2, C2.2, C3.2, C4.2, C5.2, C6.2, D1.1 (K), D2.1 (K), D7.1 (K), D8.1 (K), D13.1 (K), D14.1 (K), D19.1 (K), D20.1 (K), J1.1, J2.4, J3.1, J4.4, J5.1, J6.4, J7.1, J8.4, U1.1 (GND), U1.22 (GND)
M1_DIR: J1.3, R2.2, R3.2, U1.13 (IO_14/TMS)
M1_PULSE: J1.2, R1.2, U1.9 (IO_33)
M1_SW_BTM: J2.3, R6.2, U1.7 (IO_35)
M1_SW_CTR: J2.2, R5.2, U1.5 (IO_39/SVN)
M1_SW_TOP: J2.1, R4.2, U1.4 (IO_36/SVP/A0)
M2_DIR: J3.3, R8.2, R9.2, U1.6 (IO_26/D0)
M2_PULSE: J3.2, R7.2, U1.8 (IO_18/D5)
M2_SW_BTM: J4.3, R12.2, U1.10 (IO_19/D6)
M2_SW_CTR: J4.2, R11.2, U1.12 (IO_23/D7)
M2_SW_TOP: J4.1, R10.2, U1.14 (IO_05/D8)
M3_DIR: J5.3, R14.2, R15.2, U1.25 (IO_22/D1/SCL)
M3_PULSE: J5.2, R13.2, U1.27 (IO_21/D2/SDA)
M3_SW_BTM: J6.3, R18.2, U1.29 (IO_17/D3)
M3_SW_CTR: J6.2, R17.2, U1.31 (IO_16/D4)
M3_SW_TOP: J6.1, R16.2, U1.36 (IO_02)
M4_DIR: J7.3, R20.2, R21.2, U1.32 (IO_04)
M4_PULSE: J7.2, R19.2, U1.30 (IO_12/TDI)
M4_SW_CTR: J8.2, R23.2, U1.26 (IO_25)
M4_SW_LEFT: J8.1, R22.2, U1.24 (IO_27)
M4_SW_RIGHT: J8.3, R24.2, U1.28 (IO_32)
unnamed: D1.2 (A), R1.1
unnamed: D2.2 (A), R2.1
unnamed: D3.1 (K), R3.1
unnamed: D4.1 (K), R4.1
unnamed: D5.1 (K), R5.1
unnamed: D6.1 (K), R6.1
unnamed: D7.2 (A), R7.1
unnamed: D8.2 (A), R8.1
unnamed: D9.1 (K), R9.1
unnamed: D10.1 (K), R10.1
unnamed: D11.1 (K), R11.1
unnamed: D12.1 (K), R12.1
unnamed: D13.2 (A), R13.1
unnamed: D14.2 (A), R14.1
unnamed: D15.1 (K), R15.1
unnamed: D16.1 (K), R16.1
unnamed: D17.1 (K), R17.1
unnamed: D18.1 (K), R18.1
unnamed: D19.2 (A), R19.1
unnamed: D20.2 (A), R20.1
unnamed: D21.1 (K), R21.1
unnamed: D22.1 (K), R22.1
unnamed: D23.1 (K), R23.1
unnamed: D24.1 (K), R24.1
