LSchoenbauer/unseen-obstacles/(commit log)

2025-07-04 added CAD models and documentation for simulator hardware
    [Armrest.FCStd, Assembly.FCStd, Backrest.FCStd, Caster fork.FCStd, Caster wheel.FCStd, Footplate.FCStd, Frame.FCStd, Pin.FCStd]
2025-07-12 added new connecting piece between scissor lift and stepper motor with 8mm shaft
2025-07-21 added ESP32 datasheets added kicad models, footprints, and symbols added ESP32-Arduino project for trying steppers added oscilloscope measurements of stepper pins
    [ESP32-WROOM-DEVKIT-NODEMCU-V3_narrow.step, ESP32-WROOM-DEVKIT-NODEMCU-V3_wide.step, ESP32-WROOM-DEVKIT-NODEMCU-V4_wide_low_detail.step, JST - XH - Thru - 02Pin - 2.5mm (Genuine).stp, JST - XH - Thru - 03Pin - 2.5mm (Genuine).stp, JST - XH - Thru - 04Pin - 2.5mm (Genuine).stp, JST - XH - Thru - 05Pin - 2.5mm (Genuine).stp, JST - XH - Thru - 06Pin - 2.5mm (Genuine).stp]
2025-08-06 Added description and evaluation report for mechanical lifting devices
2025-09-24 add simulator
    [Mover.kicad_sch, simulator.kicad_pcb, simulator.kicad_sch]
2025-09-29 design schematics
    [Mover.kicad_sch, connection.kicad_sch, simulator.kicad_pcb, simulator.kicad_sch]
2025-10-01 added datasheets for LEDs and Steppers
2025-10-01 added 3D models of RGB LED
    [LED_SMD_RGB_1616_RGB_EAST1616RGBA0.igs, LED_SMD_RGB_1616_RGB_EAST1616RGBA0.step]
2025-10-06 update simulator
    [Heberteile.FCStd, connection.kicad_sch, simulator.kicad_pcb]
2025-10-15 shaped schematic and PCB added printed documentation of PCB
    [Mover.kicad_sch, connection.kicad_sch, simulator.kicad_pcb, simulator.kicad_sch]
2025-10-15 finalized schematics and PCB
    [Mover.kicad_sch, connection.kicad_sch, simulator.kicad_sch]
2025-10-17 update Platine (Vais)
    [simulator.kicad_pcb]
2025-10-17 completed draft of stepper mounting sheets
    [Heberteile.FCStd, Microswitch_20mm.stp, Stepper_NEMA23_300Ncm_23HS45-4204S.STEP]
2025-10-18 added stabilization Cos and alternative text
    [Mover.kicad_sch, simulator.kicad_pcb, simulator.kicad_sch]
2025-10-19 made PDB singlesided, added stabilization capacitors and label
    [simulator.kicad_pcb]
2025-10-19 completed stepper mount
    [47 MICRO SS-5GL2.SLDPRT, Heberteile.FCStd]
2025-10-20 added bearing and washer
    [Heberteile.FCStd]
2025-10-20 prolonged seam and simplified mounting bracket for switches
    [Heberteile.FCStd]
2025-10-27 added mover parts: slide bearings and distance washers, switch bracket added printable models for all parts o print added cutting template for metal sheet parts added lifting jack model
    [Heberteile.FCStd, Mover-Stepper-Mount_Washer.stl, Mover-Stepper-Mounts_r1.1.dxf, Mover-Stepper-Slide_Bearing.stl, Mover-Stepper-Slide_Bearing_Washer.stl, Mover-Stepper-Slide_Bearing_w_Indicator.stl, Mover-Stepper-Switch_Bracket.stl, Mover.FCStd]
2025-10-28 ChairController and PCBTester started
2025-10-28 add: buttons for motors
2025-10-28 added rear bearing for chair
    [Heberteile.FCStd, Mover-Stepper-ChairBearing_rear.stl]
2025-11-10 cleaned up wires
    [connection.kicad_sch]
2025-11-10 added coupling adapter for jack to stepper
    [Scherenhebergelenksbolzen-Anreislehre_24.0.stl, Scherenhebergelenksbolzen-Anreislehre_24.3.stl, Scherenhebergelenksbolzen-Anreislehre_24.6.stl, Scherenheberwellenkupplungsadapter.FCStd, Scherenheberwellenkupplungskeil-5x4x20mm.stl]
2025-11-11 update: MoverDriver, begin Position Calibration code
2025-11-11 optimized scissor jack coupling
2025-11-12 removed obsolete models
    [Scherenhebergelenksbolzen-Anreislehre.stl, Scherenheberkupplungsadpter-08x14mm.stl, Scherenheberkupplungsadpter-10x16mm.stl, Scherenheberwellenmuffe-8x7.0mm.stl, Steppermontagewinkel NEMA17-Getriebe.stl, Steppermontagewinkel_NEMA17.stl, Steppermontagewinkel_NEMA23.stl]
2025-11-12 made washer for slide bearing broader
    [Mover-Stepper-Slide_Bearing_Washer.stl]
2025-11-12 optimized scissor jack to stepper coupling
    [Scherenheberwellenkupplungsadapter.FCStd]
2025-11-12 improved and extended PCB test application
2025-11-17 added mounting parts for flat mounting of power supply
    [Mounts.FCStd, PowerSupply_Bracket.stl, PowerSupply_Mounting_Angle.stl, PowerSupply_Mounting_Angle_for_Bracket.stl]
2025-11-18 added pin config header file for mover driver
2025-11-19 Added CAD models for upright mounting of power supply
    [Mounts.FCStd, PowerSupply_Bracket-High_LED-Bottom.stl, PowerSupply_Bracket-High_LED-Top.stl, PowerSupply_MountingBrace-High.stl]
2025-11-19 added mounting brackets with extended screw holes and screw(hole)extender for M4
    [Mounts.FCStd, Screwextender_M4_2mm.stl]
2025-11-19 update MoverDriver timer
2025-11-20 remote controlling stepper driver
2025-12-17 feat: web-app lifts and lowers wheelchair
2025-12-17 update: MoverDriver timer
2026-01-09 feat: ChairController - move stepper
2026-01-29 fixed control of pulse pin for stepper improved ISR debugging
    [ChairControllerApp.cpp, MoverDriver.cpp, MoverDriver.h]
2026-02-02 added multi-threading for logging
2026-02-02 modified Antriebswalze to support coating with flex material and mounting using a wedge
    [Stirnrad_Antriebswalze-NEMA17_18.0.stl, Stirnrad_Antriebswalze-NEMA17_18.0_Nut.stl, Stirnrad_Antriebswalzenfeder-NEMA17_18.0.stl, Stirnrad_Antriebswalzenhülle_18.0-20.0.stl, Stirnradantrieb.FCStd, UM3E_Antriebswalze_PLAe1_TPU95Ae2.3mf]
2026-02-04 implemented multi-tasking mover driver fixed multi-tasking logging
    [ChairController.cpp, ChairController.h, ChairControllerApp.cpp, CommandData.h, MoverDriver.cpp, MoverDriver.h, MoverDriverCfg.cpp, MoverDriverCfg.h]
2026-02-06 made chair controller asynchronous and attached it to the main task moved UDP server to specific task improved limit stop in mover drivers
2026-02-11 update: stepper movement on command helper functions
2026-02-12 added task info print-outs
2026-02-22 refactored UDP server and TaskMgmt to libs and added dependencies. added build target for custom FreeRTOS to enable task table information. minor fixes and clean-ups
    [partition_no_ota.csv]
2026-02-22 fixed IP address setting for WiFi AP
    [WifiService.cpp]
2026-03-09 added handshake and heartbeat to UDP transfer protocol added tagging support for logging extracted UDP server implementation from Arduino to lib, because Arduino library is not working with patched F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
    [ChairControllerApp.cpp, MoverDriver.cpp, MoverDriver.h, WifiService.cpp]
2026-04-20 feat: more button functionality
